makerbase-mks/MKS-Robin-E3-E3D/README.md

# MKS-Robin-E3-E3D
Include MKS Robin E3 and MKS Robin E3D two motherboards. Both motherboards are compatible with Ender3 machines and CR-10/CR10S machines
- MKS Robin E3 integrated 4 TMC2209 dirvers on board.
- MKS Robin E3D has pluggable drive interface, support A4988/TMC2208/TMC2209 and so on.
- Support [MKS MINI12864 V3](https://makerbase.aliexpress.com/store/group/LCD/1047297_516922172.html), MKS TFTxx, MKS LCD12864B, LCD12864, LCD2004
- Support [MKS PWC V3](https://www.aliexpress.com/item/32853300039.html), you can refer to Wiki

## Compare between E3/E3D V1.0 and V1.1
| ITEMS |  E3/E3D V1.0  | E3/E3D V1.1 |
|---|---|---|
| Z STEP signal | PB7 | PC14 |
| Z DIR signal | PB6 | PC15 |
| EEPROM | No support(save eeprom data by flash) | On board 4K |
| Board set | BOARD_MKS_ROBIN_E3, BOARD_MKS_ROBIN_E3D | BOARD_MKS_ROBIN_E3_V1_1, BOARD_MKS_ROBIN_E3D_V1_1 |

## Related tutorials and Notice
- Robin E3 E3D User Manual. You can refer to Wiki.[click here](https://github.com/makerbase-mks/MKS-Robin-E3-E3D/wiki)
- Robin E3D description. [click here](https://www.youtube.com/watch?v=_x1TzdqGZdo&feature=youtu.be&tdsourcetag=s_pctim_aiomsg)
- Thank you very much for ruiraptor's introduction about Robin E3/E3D board. [click here](https://www.youtube.com/watch?v=k9A8JYxBvqE)
- Welcome to follow us on Facebook to learn about the company's latest developments. [click here](https://www.facebook.com/Makerbase.mks/)

## Firmware 
- Support Marlin 2.0 
- Robin E3/E3D has supported klipper firmware. For details, please refer to:https://github.com/makerbase-mks/Klipper-for-MKS-Boards

## How to buy
- MKS Robin E3 on Aliexpress  [MKS Robin E3](https://www.aliexpress.com/item/1005002618890320.html)
- MKS Robin E3D on Aliexpress  [MKS Robin E3D](https://www.aliexpress.com/item/4000781744682.html)

## Note
- Thank you for using MKS products. If you have any questions during use, please contact us in time and we will work with you to solve it.
- For more product dynamic information and tutorial materials, you can always follow MKS's Facebook/Twitter/Discord/Reddit/Youtube and Github. Thank you!
- MKS Github: https://github.com/makerbase-mks  
- MKS Facebook: https://www.facebook.com/Makerbase.mks/  
- MKS Twitter: https://twitter.com/home?lang=en  
- MKS Discord: https://discord.gg/4uar57NEyU
- MKS Reddit: https://www.reddit.com/user/MAKERBASE-TEAM/ 

mks_link
