makerbase-mks/MKS-Robin-E3-E3D/hardware/README.md

# MKS Robin E3 and E3D hardware
- MKS Robin E3 V1.0_002 initial hardware
- MKS Robin E3D V1.0_002 initial hardware

20200414
- MKS Robin E3 V1.0_003 add 5.0-2P terminal for fan connection
- MKS Robin E3D V1.0_003 add 5.0-2P terminal for fan connection

20201120
- MKS Robin E3 V1.1_003 and MKS Robin E3D V1.1_003
  - Z-STEP signal change to PC14
  - Z-DIR signal change to PC15
  - Add support AT24C32D eeprom on the board
  - Optimize USB package design
  - Optimize PCB layout design
  
20210325
- MKS Robin E3 V1.1_004
  - Optimize TMC2209(QFN-28) packages
