makerbase-mks/MKS-Robin-E3-E3D/firmware/V1.1/Firmware bin for ender5/README.md

## Update firmware
- The "***.bin" need rename as Robin_e3.bin
- Copy Robin_e3.bin file to TF card folder
- Insert TF to MKS Robin E3 or MKS Robin E3D board
- Reset board or repower on
- The marlin version is 2.0.x
- Change parameters by LCD and store data
