makerbase-mks/MKS-Robin-E3-E3D/firmware/V1.0/firmware bin/firmware bin for Ender3(TMC2209+Neopixel+MKS PWC)/README.md

# Robin_e3.bin description
This bin file works with MKS motherboard and can be used directly on ender3 machine

## Update firmware
- Copy Robin_e3.bin file to TF card
- Insert TF to MKS Robin E3 or MKS Robin E3D board
- Reset board or repower on
- The marlin version is 2.0.1

## Parameter
- Robin_e3.bin firmware, the parameters are the same as the original ender3 machine

## Open Nexopixel lights
- Send M150 R* U* B* to board, for example: M150 R125 U125 B125

## Use MKS PWC
- PW_OFF connect to MKS Robin E3/E3D LCD_D7(PC5, EXP1 8pin)
- PW_DET connect to MKS Robin E3/E3D ME_DET(PB10)
