makerbase-mks/MKS-Robin-E3-E3D/hardware/Image/Robin E3/MKS_Robin_E3_V11_PWC.png

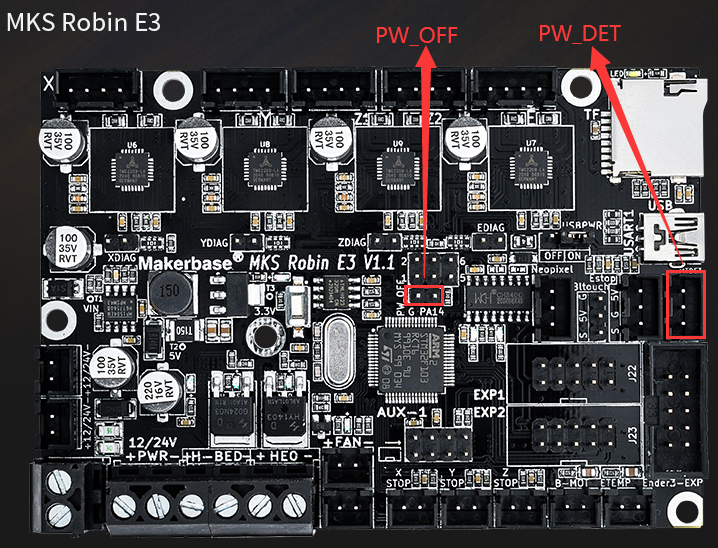
hardware/Image/Robin E3/MKS_Robin_E3_V11_PWC.png
