makerbase-mks/MKS-Robin-E3-E3D/hardware/Image/Robin E3D/MKS_Robin_E3D_FES.png

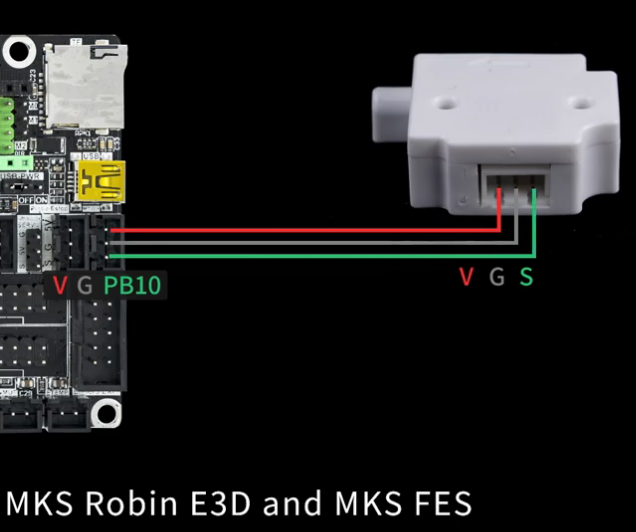
hardware/Image/Robin E3D/MKS_Robin_E3D_FES.png
