makerbase-mks/MKS-Robin-E3-E3D/hardware/Image/Robin E3D/MKS_Robin_E3D_V1_TOP.png

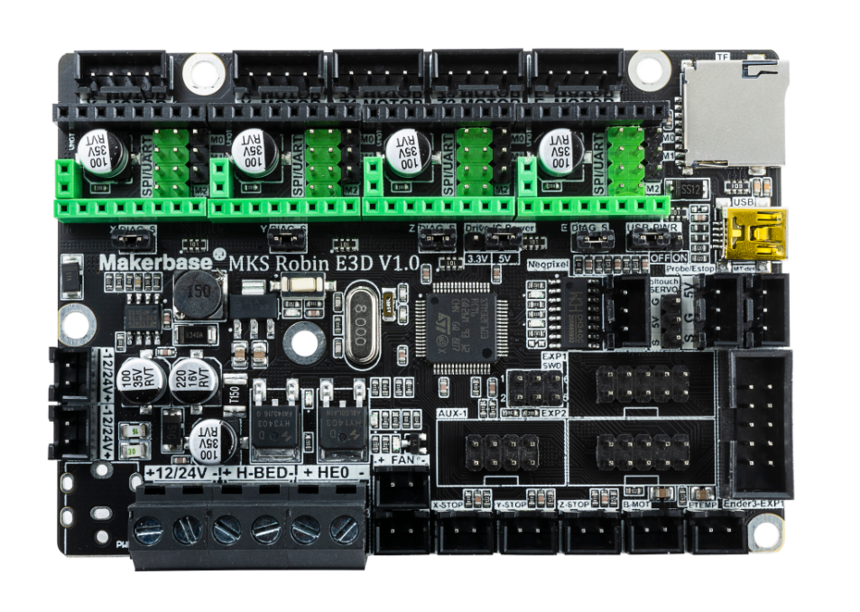
hardware/Image/Robin E3D/MKS_Robin_E3D_V1_TOP.png
