makerbase-mks/MKS-Robin-E3-E3D/hardware/MKS Robin E3 V1.1_004/MKS Robin E3 V1.1_004 BOM.pdf

Designator | Comment | Footprint | Quantity C1 | 100nF/50V±10% | C_0603_1608 | 1 C10 | 100uF/35V±20% | SMD-RVT-6.3X7mm | 1 C11 | 100nF/50V±10% | C_0603_1608 | 1 C12 | 100nF/50V±10% | C_0603_1608 | 1 C13 | 150pF/50V±10% | C_0603_1608 | 1 C14 | 100uF/35V±20% | SMD-RVT-6.3X7mm | 1 C15 | 100nF/50V±10% | C_0603_1608 | 1 C16 | 220uF/16V±20% | SMD-RVT-6.3X7mm | 1 C17 | 10uF/35V±20% | C_0805_2012 | 1 C18 | 10uF/35V±20% | C_0805_2012 | 1 C19 | 10uF/35V±20% | C_0805_2012 | 1 C2 | 100nF/50V±10% | C_0603_1608 | 1 C20 | 10uF/35V±20% | C_0805_2012 | 1 C21 | 100nF/50V±10% | C_0603_1608 | 1 C22 | 100nF/50V±10% | C_0603_1608 | 1 C23 | 100nF/50V±10% | C_0603_1608 | 1 C24 | 100nF/50V±10% | C_0603_1608 | 1 C25 | 100nF/50V±10% | C_0603_1608 | 1 C26 | 100nF/50V±10% | C_0603_1608 | 1 C27 | 100nF/50V±10%/NC | C_0603_1608 | 1 C28 | 100nF/50V±10% | C_0603_1608 | 1 C29 | 1nF/50V±10% | C_0603_1608 | 1 C3 | 22pF/50V±10% | C_0603_1608 | 1 C30 | 1nF/50V±10% | C_0603_1608 | 1 C31 | 100nF/50V±10% | C_0603_1608 | 1 C32 | 22nF/50V±10% | C_0603_1608 | 1 C33 | 100uF/35V±20% | SMD-RVT-6.3X7mm | 1 C34 | 100nF/50V±10% | C_0603_1608 | 1 C35 | 22nF/50V±10% | C_0603_1608 | 1 C36 | 100nF/50V±10% | C_0603_1608 | 1 C37 | 100nF/50V±10% | C_0603_1608 | 1 C38 | 100nF/50V±10% | C_0603_1608 | 1 C39 | 100nF/50V±10% | C_0603_1608 | 1 C4 | 22pF/50V±10% | C_0603_1608 | 1 C40 | 100nF/50V±10% | C_0603_1608 | 1 C41 | 100nF/50V±10% | C_0603_1608 | 1 C42 | 100nF/50V±10% | C_0603_1608 | 1 C43 | 100uF/35V±20% | SMD-RVT-6.3X7mm | 1 C44 | 22nF/50V±10% | C_0603_1608 | 1 C45 | 100nF/50V±10% | C_0603_1608 | 1 C46 | 100nF/50V±10% | C_0603_1608 | 1 C47 | 100nF/50V±10% | C_0603_1608 | 1 C48 | 100nF/50V±10% | C_0603_1608 | 1 C49 | 100uF/35V±20% | SMD-RVT-6.3X7mm | 1 C5 | 100nF/50V±10% | C_0603_1608 | 1 C50 | 22nF/50V±10% | C_0603_1608 | 1 C51 | 100nF/50V±10% | C_0603_1608 | 1 C52 | 100nF/50V±10% | C_0603_1608 | 1 C53 | 100nF/50V±10% | C_0603_1608 | 1 C54 | 100nF/50V±10% | C_0603_1608 | 1

C55 | 100uF/35V±20% | SMD-RVT-6.3X7mm | 1 C6 | 100nF/50V±10% | C_0603_1608 | 1 C7 | 100nF/50V±10% | C_0603_1608 | 1 C8 | 100nF/50V±10% | C_0603_1608 | 1 C9 | 100nF/50V±10% | C_0603_1608 | 1 D1 | LED_Red | LED_0603_1608 | 1 D10 | LED_Red | LED_0603_1608 | 1 D11 | LED_BLUE | LED_0603_1608 | 1 D12 | LED_BLUE | LED_0603_1608 | 1 D2 | B340A-13-F | D-SMA | 1 D3 | S1A | D-SMA | 1 D4 | S1G | D-SMA | 1 D5 | SS14 | SOD-123 | 1 D6 | LED_BLUE | LED_0603_1608 | 1 D7 | LED_W | LED_0603_1608 | 1 D8 | LED_Red | LED_0603_1608 | 1 D9 | LED_Red | LED_0603_1608 | 1 F1 | 30A | F_1206_3216 | 1 F2 | 15A | F_1206_3216 | 1 F3 | F1812/1.5A | F_1812 | 1 F4 | 0.5A | F_0805_2012 | 1 FID1 | Fiducial | FIDUCIAL-1X1mm | 1 FID2 | Fiducial | FIDUCIAL-1X1mm | 1 FID3 | Fiducial | FIDUCIAL-1X1mm | 1 L1 | 15uH/3A | L-7x7x4mm | 1 M2 | LOGO-MAKERBASE-R | Makerbase-R | 1 Q1 | SS8050 | SOT-23 | 1 R1 | 10K/±1% | R_0603_1608 | 1 R10 | 100K/±1% | R_0603_1608 | 1 R11 | 100K/±1% | R_0603_1608 | 1 R12 | 24.9K/±1% | R_0603_1608 | 1 R13 | 100K/±1% | R_0603_1608 | 1 R14 | 100K/±1% | R_0603_1608 | 1 R15 | 40.2K/±1% | R_0603_1608 | 1 R16 | 210K/±1% | R_0603_1608 | 1 R17 | 1K/±1% | R_0603_1608 | 1 R18 | 4.7K/±1% | R_0603_1608 | 1 R19 | 100Ω/±1% | R_0603_1608 | 1 R2 | 10K/±1% | R_0603_1608 | 1 R20 | 4.7K/±1% | R_0603_1608 | 1 R21 | 100Ω/±1% | R_0603_1608 | 1 R22 | 1K/±1% | R_0603_1608 | 1 R23 | 4.7K/±1% | R_0603_1608 | 1 R24 | 1K/±1% | R_0603_1608 | 1 R25 | 4.7K/±1% | R_0603_1608 | 1 R26 | 1K/±1% | R_0603_1608 | 1 R27 | 4.7K/±1% | R_0603_1608 | 1 R28 | 1K/±1% | R_0603_1608 | 1 R29 | 4.7K/±1% | R_0603_1608 | 1 R3 | 4.7K/±1% | R_0603_1608 | 1 R30 | 1K/±1% | R_0603_1608 | 1

R31 | 10K/±1% | R_0603_1608 | 1 R32 | 10K/±1% | R_0603_1608 | 1 R33 | 10K/±1% | R_0603_1608 | 1 R34 | 10K/±1% | R_0603_1608 | 1 R35 | 100Ω/±1% | R_0603_1608 | 1 R36 | 100K/±1% | R_0603_1608 | 1 R37 | 100Ω/±1% | R_0603_1608 | 1 R38 | 100K/±1% | R_0603_1608 | 1 R39 | 100Ω/±1% | R_0603_1608 | 1 R4 | 4.7K/±1% | R_0603_1608 | 1 R40 | 100K/±1% | R_0603_1608 | 1 R41 | 4.7K/±1% | R_0603_1608 | 1 R42 | 4.7K/±1% | R_0603_1608 | 1 R43 | 4.7K/±1% | R_0603_1608 | 1 R44 | 1.8K/±1% | R_0603_1608 | 1 R45 | 1.8K/±1% | R_0603_1608 | 1 R46 | 1K/±1% | R_0603_1608 | 1 R47 | 1K/±1% | R_0603_1608 | 1 R48 | 22Ω/±1% | R_0603_1608 | 1 R49 | 22Ω/±1% | R_0603_1608 | 1 R5 | 10K/±1% | R_0603_1608 | 1 R50 | 100Ω/±1% | R_0603_1608 | 1 R51 | 100Ω/±1% | R_0603_1608 | 1 R52 | 1K/±1% | R_0603_1608 | 1 R53 | 4.7K/±1% | R_0603_1608 | 1 R54 | 100Ω/1% | R_0603_X4 | 1 R55 | 20K/±1% | R_0603_1608 | 1 R56 | 20K/±1% | R_0603_1608 | 1 R57 | 0.11/±1% | R_0805_2012 | 1 R58 | 100Ω/1% | R_0603_X4 | 1 R59 | 0.11/±1% | R_0805_2012 | 1 R60 | 20K/±1% | R_0603_1608 | 1 R61 | 20K/±1% | R_0603_1608 | 1 R62 | 0.11/±1% | R_0805_2012 | 1 R63 | 0.11/±1% | R_0805_2012 | 1 R64 | 20K/±1% | R_0603_1608 | 1 R65 | 20K/±1% | R_0603_1608 | 1 R66 | 4.7K/±1% | R_0603_1608 | 1 R67 | 100Ω/1% | R_0603_X4 | 1 R68 | 20K/±1% | R_0603_1608 | 1 R69 | 0.11/±1% | R_0805_2012 | 1 R70 | 20K/±1% | R_0603_1608 | 1 R71 | 0.11/±1% | R_0805_2012 | 1 R72 | 20K/±1% | R_0603_1608 | 1 R73 | 100Ω/1% | R_0603_X4 | 1 R74 | 20K/±1% | R_0603_1608 | 1 R75 | 0.11/±1% | R_0805_2012 | 1 R76 | 20K/±1% | R_0603_1608 | 1 R77 | 0.11/±1% | R_0805_2012 | 1 R78 | 20K/±1% | R_0603_1608 | 1 R9 | 1M/±1% | R_0603_1608 | 1

S1 | SW-260G-2P | SW-260G-SMD-3X6X5mm1
U1 | AT24C32D-SSHM | SOIC8 | 1
U2 | STM32F103RCTx | LQFP-64_10x10mm_P0.1
U4 | NCP1117ST33T3G | SOT-223 | 1
U5 | CH340C | SOP-16-150mil | 1
Z1 | CG0603MLC-05E | R_0603_1608 | 1
Z2 | CG0603MLC-05E | R_0603_1608 | 1
Z3 | CG0603MLC-05E | R_0603_1608 | 1
M1 | LOGO-MAKERBASE | Makerbase-TOP | 1
Through Hole Items
J1 | Header-2.54-2X3P | HDR-2.54-2X3P | 1
J10 | XH2.54-2P | XH2.54-2P | 1
J11 | XH2.54-2P | XH2.54-2P | 1
J12 | XH2.54-3P | XH2.54-3P | 1
J13 | XH2.54-3P | XH2.54-3P | 1
J14 | Header-2.54-1X2P | HDR-2.54-1X2P | 1
J15 | Header-2.54-1X2P | HDR-2.54-1X2P | 1
J16 | Header-2.54-1X2P | HDR-2.54-1X2P | 1
J17 | Header-2.54-1X2P | HDR-2.54-1X2P | 1
J18 | XH2.54-2P | XH2.54-2P | 1
J19 | XH2.54-2P | XH2.54-2P | 1
J2 | HG129-5.0-2P | HG129-5.0-2P | 1
J20 | Header-2.54-1X3P | HDR-2.54-1X3P | 1
J21 | USB_MINI | USB_MINI_DIP5P | 1
J22 | IDC-2.54-2X5P | IDC-2.54-2X5P | 1
J23 | IDC-2.54-2X5P | IDC-2.54-2X5P | 1
J24 | Header-2.54-1X3P | HDR-2.54-1X3P | 1
J25 | IDC-2.54-2X4PA | HDR-2.54-2X4P | 1
J26 | IDC-2.54-2X5P | IDC-2.54-2X5P | 1
J27 | XH2.54-3P | XH2.54-3P | 1
J28 | XH2.54-4P | XH2.54-4P | 1
J29 | XH2.54-4P | XH2.54-4P | 1
J3 | HG129-5.0-6P | HG129-5.0-6P | 1
J30 | XH2.54-4P | XH2.54-4P | 1
J38 | XH2.54-4P | XH2.54-4P | 1
J4 | XH2.54-4P | XH2.54-4P | 1
J40 | Header-2.54-1X2P | HDR-2.54-1X2P | 1
J5 | XH2.54-2P | XH2.54-2P | 1
J6 | XH2.54-2P | XH2.54-2P | 1
J7 | XH2.54-2P | XH2.54-2P | 1
J8 | XH2.54-2P | XH2.54-2P | 1
J9 | XH2.54-2P | XH2.54-2P | 1
M3 | M-HOLES | M-HOLES | 1
M4 | M-HOLES | M-HOLES | 1
M5 | M-HOLES | M-HOLES | 1
M6 | M-HOLES | M-HOLES | 1
M7 | M-HOLES | M-HOLES | 1
Q2 | HY1403 | TO-252 | 1
Q3 | HY3403D | TO-252 | 1
SD1 | MicroSD | MICROSD | 1
T1 | Test-point | TEST-POINT | 1

T2 | Test-point | TEST-POINT | 1 T3 | Test-point | TEST-POINT | 1 U3 | MP1584EN | SOIC8E | 1 U6 | TMC2209-LA | QFN28 | 1 U7 | TMC2209-LA | QFN28 | 1 U8 | TMC2209-LA | QFN28 | 1 U9 | TMC2209-LA | QFN28 | 1 Y1 | XTAL-2P-8M | XTAL-49S-DIP-2 | 1
