makerbase-mks/MKS-Robin-E3-E3D/hardware/Image/FAQ/CONNECT.png

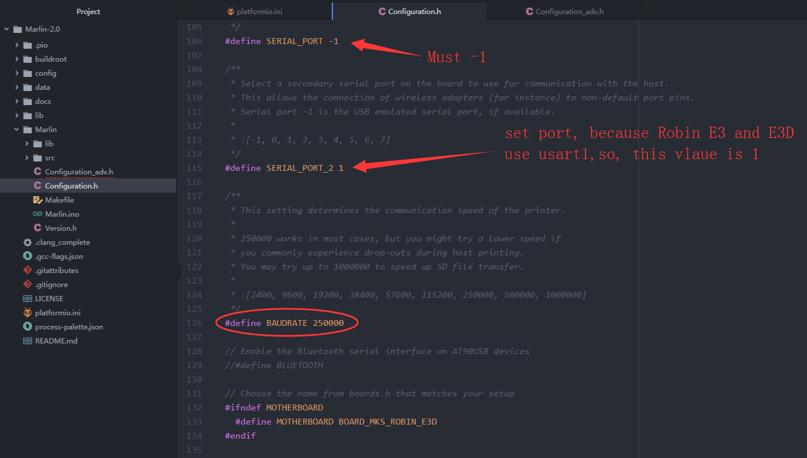
hardware/Image/FAQ/CONNECT.png
