makerbase-mks/MKS-Robin-E3-E3D/hardware/Image/FAQ/CONNECT_OK.png

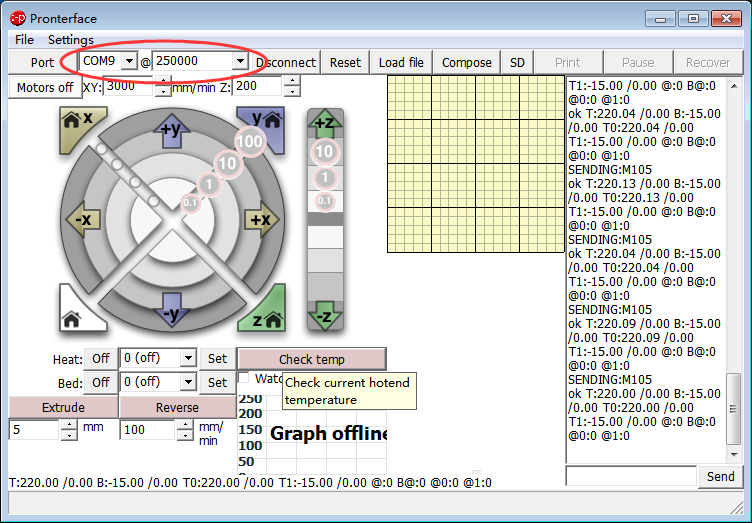
hardware/Image/FAQ/CONNECT_OK.png
