makerbase-mks/MKS-Robin-E3-E3D/hardware/Image/FAQ/MKS_Robin_E3_E3D_NEOPIXEL_ADD.png

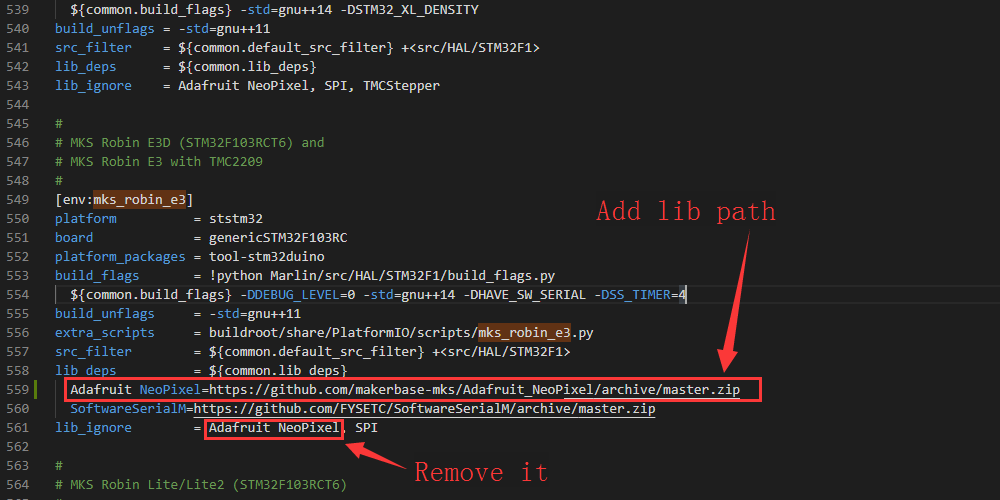
hardware/Image/FAQ/MKS_Robin_E3_E3D_NEOPIXEL_ADD.png
