makerbase-mks/MKS-Robin-E3-E3D/hardware/Image/FAQ/MKS_Robin_E3_E3D_NEOPIXEL_COM_DISABLE.png

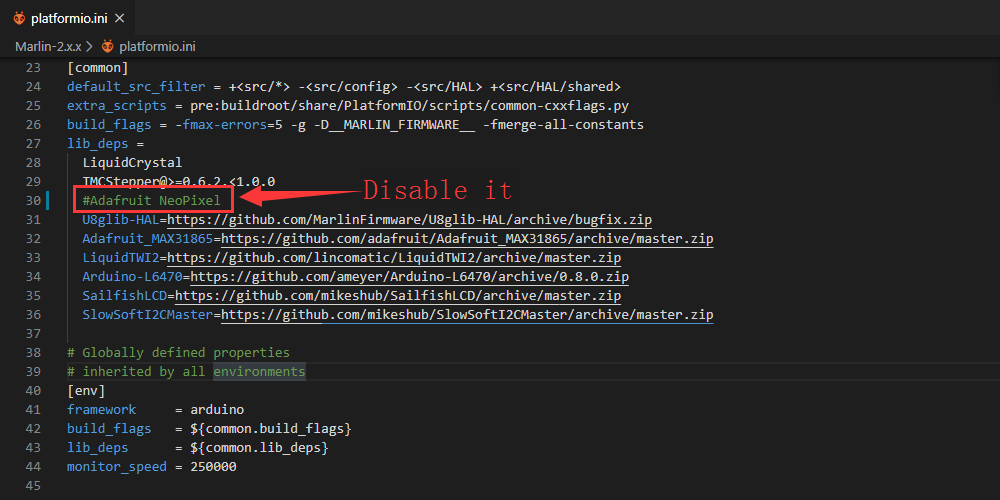
hardware/Image/FAQ/MKS_Robin_E3_E3D_NEOPIXEL_COM_DISABLE.png
