makerbase-mks/MKS-Robin-E3-E3D/hardware/Image/FAQ/SENSORLESS_HOMING.png

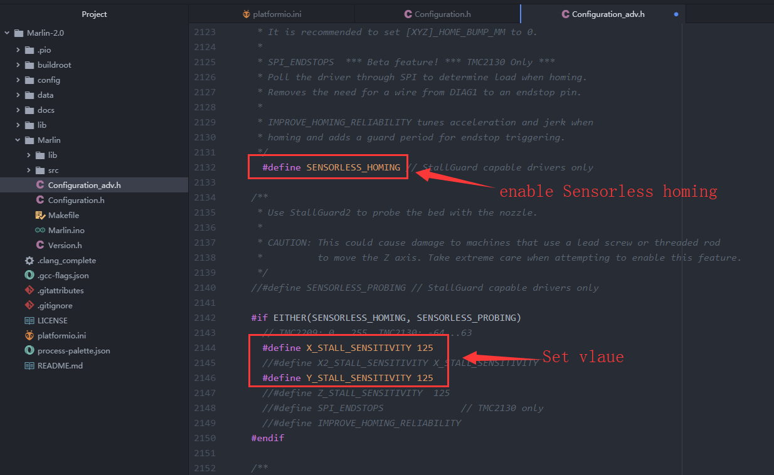
hardware/Image/FAQ/SENSORLESS_HOMING.png
