makerbase-mks/MKS-Robin-E3-E3D/hardware/Image/FAQ/TMC2209_TYPE.png

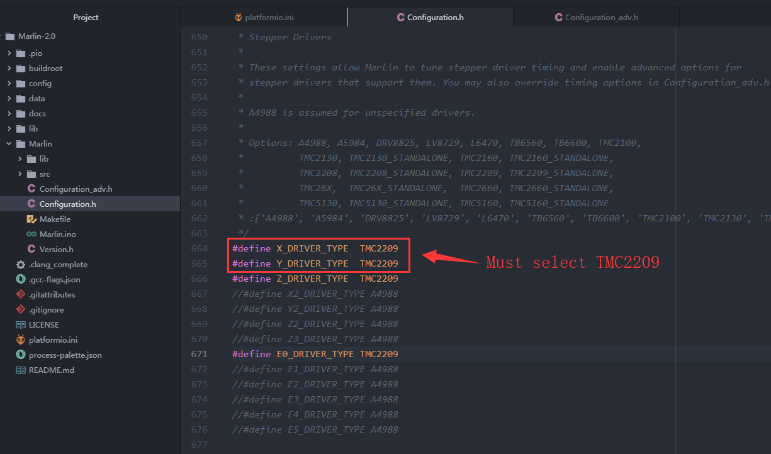
hardware/Image/FAQ/TMC2209_TYPE.png
