makerbase-mks/MKS-Robin-E3-E3D/(threads)

Thread 1 (2020-04-09):

part cooling fan is always open

SFRSKZ, 2020-04-09:
im using pa8 pin for part cooling fan but fan is always working. not responding to adjustments or gcodes.

makerbase-mks, 2020-04-10:
Hi!
I want to confirm the following points:
First, your firmware is what version?
Secondly, when the motherboard is powered on, will the FAN controlled by PA8 flash or keep on?

SFRSKZ, 2020-04-10:
marlin 2.0.1. i used your files, and changed some settings but there was nothing about fan.

SFRSKZ, 2020-04-10:
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

red light is always on, not blinking.

makerbase-mks, 2020-04-10:
Have you received the motherboard, is this the case with power on? If it is always on, it means that the transistor controlling the FAN has been broken down, which will cause the power to be on all the time without blinking.

jvictor23br, 2020-08-19:
Mine has the same issue, the red light is allways on, but the cooler is always off. Just received like that. What can be done?

danbrianwhite, 2020-11-11:
I have one of these too where part cooling fan is always on. The hotend fan is connected to the "fan" input.

Is this a software bug?

Closed 2020-05-13.

Thread 2 (2020-04-20):

I can't update .bin file

JordiKoki, 2020-04-20:
I am trying to update my new MKS Robin E3D board, but when I add the file Robin_e3.bin in my SD, the screen does not execute the update.

makerbase-mks, 2020-04-20:
Hi!
1. What screen are you using?
2. Robin E3 / E3D already have firmware. If you have not modified the firmware, you can use it directly on the Ender3 machine without upgrading
3. Robin E3 / E3D supports LCD12864 to display the firmware update progress

JordiKoki, 2020-04-20:
I use a TFT35 V1.0 (with Firmware 1.0.5) in my CR10s, but doesn't works anything (hotend, bed, moves, fans...)

makerbase-mks, 2020-04-24:
Hi! You can refer to it and link is : https://github.com/makerbase-mks/MKS-Robin-E3-E3D/wiki/Upgrade-with-MKS-TFT-Series

spooky79, 2021-04-21:
I have the same problem, it comes to 100% and nothing is happening, I'm using visual studio code, any solution?

aspaixao, 2021-07-16:
I have the same with my e3d and I using a CoreXY and configuration to ender 6

sergiofagundes, 2021-09-16:
FIXED 100% working:

 the board if using a 4GB sdcard,
I tried with 8GB/16GB/32GB and none of them worked.
So I tried a 4GB sdcard and it worked.

I used the Sdcard on the LCD sdcard slot, but I think it should work also in the mks robin board sdcard slot also with only 4GB sdcard.

Closed 2020-05-13.

Thread 3 (2020-04-23):

question: in where save eeprom settings

sl1pkn07, 2020-04-23:
Hi

in this board, in where is stored the eeprom settings?

greetings

makerbase-mks, 2020-04-24:
Hi! The processing of this part of EEPROM, marlin may write to STM32 flash using an analog method.

sl1pkn07, 2020-04-24:
i see in other SMT32F103(RCT6/RET6) based boards this

~~~~
#define FLASH_EEPROM_EMULATION
#define EEPROM_PAGE_SIZE     (0x800U) // 2KB
#define EEPROM_START_ADDRESS (0x8000000UL + (STM32_FLASH_SIZE) * 1024UL - (EEPROM_PAGE_SIZE) * 2UL)
#undef E2END
#define E2END                (EEPROM_PAGE_SIZE - 1) // 2KB
~~~

but not in the Robin E3/E3D

this is missing for the Robin E3/E3D boards?

(i have the E3D in route)

greetings

sl1pkn07, 2020-05-15:
Hi again. one question, with "analog method" you mean the board have a dedicated eeprom chip?

greetings

DocYester, 2020-05-17:
saving settings to flash with the e3d would be nice - actually i store them on sdcard by emulation
but that will definitly fail at some time - so allways backup the settings

what is needed to set it up to use the flash ?

sl1pkn07, 2020-05-17:
in other STM32F1 boards, the snipplet i posted above

DocYester, 2020-05-17:
after rebooting 2 times and saving defaults - works 👍

sl1pkn07, 2020-05-17:
oh! I forgot to add to add this in the LD script

~~~
rom (rx)  : ORIGIN = 0x08007000, LENGTH = 256K - 28K - 4K
~~~

https://github.com/MarlinFirmware/Marlin/blob/bugfix-2.0.x/buildroot/share/PlatformIO/ldscripts/mks_robin_e3.ld

because the eeprom is stored in the last 4K in the flash

DocYester, 2020-05-19:
LD Script fot the E3D should be :
`rom (rx)  : ORIGIN = 0x08005000, LENGTH = 256K - 20K - 4K`

Works like a charm now

sl1pkn07, 2020-06-08:
implementes in upstream

https://github.com/MarlinFirmware/Marlin/commit/19024306fc834fbead89e749d64d352194befa84

closing

Closed 2020-06-08.

Thread 4 (2020-05-01):

Can not Open build_flags.py

Frederic-SABU, 2020-05-01:
I can not compile a Marlin-2 for a ROBIN E3D.
I am using VS studio and Platformio.
My config is working fine for my other MKS boards : SGEN_L and MKS_BASE.
Error message is :
D:\Python38\python.exe: can't open file 'Marlin/src/HAL/HAL_STM32F1/build_flags.py': [Errno 2] No such file or directory
Thks for any help.

makerbase-mks, 2020-05-04:
What you set in the platformio.ini file is: mks_robin_e3d?

Frederic-SABU, 2020-05-04:
Yes, it is but the problem was coming from one of he marlin file. I
reused a Marlin 2 from my SGEN_L cards and it is not compatible.

Thk a lot for following up.

Rgds,
Frd

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

Frederic-SABU, 2020-05-04:
No sorry it is :

mks_robin_e3

as there is no e3d environment.

Rgds,
Frd

Le 04/05/2020 08:19, MSABU a écrit :
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

Closed 2020-05-27.

Thread 5 (2020-05-02):

Unknown environment names 'mks_robin_e3d'

ljunqian, 2020-05-02:
Which other environment names can i use?

ljunqian, 2020-05-02:
I figured it out. I just had to use your version of marlin instead of the original, How can i update my board firmware? Putting the bin file in my sd card and rebooting does not work. Uploading from vscode using platformio does not work. I am using robin e3d. Am i still supposed to use mks_robin_3d as the default_envs for this board? Please advise.

ljunqian, 2020-05-03:
I figured it out. I loaded firmware.bin and Robin_e3.bin on sd from PIO and rebooted. There is different pins for Z_MIN_PROBE in marlin for 3d touch. Mine was  Pin PB1 while the pin listed in readme was PA2.

Closed 2020-05-03.

Thread 6 (2020-05-04):

Question : Can the board be configured for 12V fans ?

imakiro, 2020-05-04:
Hello,
I would like to reduce the noise of the hotend fan, can the Robin-E3D V1.0 board be configured to use a 12V fan without a buck converter / step down voltage regulator ?
If so, how and which parameters to change in Marlin source code?

makerbase-mks, 2020-05-13:
Hi! The safest way is that you can directly use a 12VDC module.

Closed 2020-05-25.

Thread 7 (2020-05-05):

Question: Is the board supposed to turn off when no filament is detected?

ljunqian, 2020-05-05:
I have the E3D. It turns off when no filament is detected, I would like it to to pause the print.

ljunqian, 2020-05-07:
I shorted the pin.

Closed 2020-05-07.

Thread 8 (2020-05-19):

Question : UART Connection

DocYester, 2020-05-19:
I have serious connection issues when i connect the e3d board via usb to a raspberry 3b+ with octoprint
tried diffrent cables - no change
i havent had theese issues before with the same pi/cable and the ender3 1.1.5 board
so i want to connect the e3d by uart to the pi
which pins do i need to connect ?
can i use the aux1 rx/tx/gnd ?
do i need a converter from 5v to 3.3v ?

makerbase-mks, 2020-05-20:
Hi! You don't need to connect power, but they need to be powered separately.

DocYester, 2020-05-20:
did it ... but cant connect at all
how to setup the firmware to enable the uart port for host communication ?
tried it with
```
#define SERIAL_PORT -1
#define SERIAL_PORT_2 1
```
and
```
#define SERIAL_PORT -1
#define SERIAL_PORT_2 0
```
both failed - tried to set the baudrate from  115200 to 250000 and 500000 - failed as well

makerbase-mks, 2020-05-21:
AUX-1 rx tx use STM32 USART1, so #define SERIAL_PORT_2 0;
USB is same as AUX-1, you can test connect to Host computer.

DocYester, 2020-05-22:
Not really ...

```
In file included from Marlin\src\HAL\STM32F1\../../inc/../HAL/HAL.h:26:0,
                 from Marlin\src\HAL\STM32F1\../../inc/MarlinConfig.h:30,
                 from Marlin\src\HAL\STM32F1\HAL.cpp:30:
Marlin\src\HAL\STM32F1\../../inc/../HAL/./STM32F1/HAL.h:101:6: error: #error "SERIAL_PORT_2 cannot be 0. (Port 0 does not exist.) Please update your configuration."

     #error "SERIAL_PORT_2 cannot be 0. (Port 0 does not exist.) Please update your configuration."
      ^~~~~
In file included from Marlin\src\HAL\STM32F1\../../inc/../HAL/HAL.h:26:0,
                 from Marlin\src\HAL\STM32F1\../../inc/MarlinConfig.h:30,
                 from Marlin\src\HAL\STM32F1\HAL_SPI.cpp:35:
Marlin\src\HAL\STM32F1\../../inc/../HAL/./STM32F1/HAL.h:101:6: error: #error "SERIAL_PORT_2 cannot be 0. (Port 0 does not exist.) Please update your configuration."
     #error "SERIAL_PORT_2 cannot be 0. (Port 0 does not exist.) Please update your configuration."
      ^~~~~
In file included from Marlin\src\HAL\STM32F1\../../inc/../HAL/HAL.h:26:0,
                 from Marlin\src\HAL\STM32F1\../../inc/MarlinConfig.h:30,
                 from Marlin\src\HAL\STM32F1\Servo.cpp:25:
Marlin\src\HAL\STM32F1\../../inc/../HAL/./STM32F1/HAL.h:101:6: error: #error "SERIAL_PORT_2 cannot be 0. (Port 0 does not exist.) Please update your configuration."
     #error "SERIAL_PORT_2 cannot be 0. (Port 0 does not exist.) Please update your configuration."
      ^~~~~
In file included from Marlin\src\HAL\STM32F1\dogm\../../../inc/../HAL/HAL.h:26:0,
                 from Marlin\src\HAL\STM32F1\dogm\../../../inc/MarlinConfig.h:30,
                 from Marlin\src\HAL\STM32F1\dogm\u8g_com_stm32duino_fsmc.cpp:29:
Marlin\src\HAL\STM32F1\dogm\../../../inc/../HAL/./STM32F1/HAL.h:101:6: error: #error "SERIAL_PORT_2 cannot be 0. (Port 0 does not exist.) Please update your configuration."
     #error "SERIAL_PORT_2 cannot be 0. (Port 0 does not exist.) Please update your configuration."
      ^~~~~
*** [.pio\build\mks_robin_e3\src\src\HAL\STM32F1\HAL.cpp.o] Error 1
*** [.pio\build\mks_robin_e3\src\src\HAL\STM32F1\Servo.cpp.o] Error 1
*** [.pio\build\mks_robin_e3\src\src\HAL\STM32F1\HAL_SPI.cpp.o] Error 1
*** [.pio\build\mks_robin_e3\src\src\HAL\STM32F1\dogm\u8g_com_stm32duino_fsmc.cpp.o] Error 1
========================= [FAILED] Took 5.80 seconds =========================
```

Trying to compile with Marlin bugfix branch 2.0.5.3

makerbase-mks, 2020-05-25:
Hi! Sorry, I corrected my mistake. Should #define SERIAL_PORT_2 1

DocYester, 2020-05-26:
After some testing and printing the only solution was to lower the baud rate to 115200 for a stable communication - uart or usb

Closed 2020-05-26.

Thread 9 (2020-05-20):

what problem ?

dct1122, 2020-05-20:
my use ronbin e3 broad
why my extruder motor is noise ( mosquito sound ) ?
i was change other motor , it not fix

makerbase-mks, 2020-05-20:
What driver do you use?

dct1122, 2020-05-20:
tmc 2209

makerbase-mks, 2020-05-21:
You can try to adjust the current to achieve the best condition of the motor.

DocYester, 2020-05-24:
my fans are louder than the stepper motors @40mm/s real print speed (slic3r , not cura !)
stepper motors are the original from the ender3 that it was before

```
Stepper driver current:
M906 X600 Y600 Z700 E800

```
```
Driver stepping mode:
M569 S1 X Y Z E

```
```
Maximum feedrates (units/s):
M203 X300.00 Y300.00 Z5.00 E25.00
Maximum Acceleration (units/s2):
M201 X1800.00 Y1800.00 Z100.00 E5000.00
Acceleration (units/s2): P<print_accel> R<retract_accel> T<travel_accel>
M204 P1800.00 R3000.00 T2400.00

```

mks-viva, 2020-10-14:
Has this problem been solved?

mks-viva, 2020-11-17:
I will close this issues temporarily.

Closed 2020-11-17.

Thread 11 (2020-05-26):

Compile error

vgege86, 2020-05-26:
I am trying to compile the newly downloaded version and it gives me the following error:

Compiling .pio\build\mks_robin_e3\libc6f\USBComposite\Keyboard.cpp.o
.pio\libdeps\mks_robin_e3\Adafruit BusIO_ID6214\Adafruit_I2CDevice.cpp: In member function 'bool Adafruit_I2CDevice::read(uint8_t*, size_t, bool)':
.pio\libdeps\mks_robin_e3\Adafruit BusIO_ID6214\Adafruit_I2CDevice.cpp:160:79: error: no matching function for call to 'TwoWire::requestFrom(uint8_t, uint8_t, uint8_t)'
   size_t recv = _wire->requestFrom((uint8_t)_addr, (uint8_t)len, (uint8_t)stop);
                                                                               ^
In file included from C:\Users\vgege\.platformio\packages\framework-arduinoststm32-maple\STM32F1\libraries\Wire/Wire.h:42:0,
                 from .pio\libdeps\mks_robin_e3\Adafruit BusIO_ID6214/Adafruit_I2CDevice.h:1,
                 from .pio\libdeps\mks_robin_e3\Adafruit BusIO_ID6214\Adafruit_I2CDevice.cpp:1:
C:\Users\vgege\.platformio\packages\framework-arduinoststm32-maple\STM32F1\libraries\Wire/utility/WireBase.h:101:11: note: candidate: uint8 WireBase::requestFrom(uint8, int)
     uint8 requestFrom(uint8, int);
           ^~~~~~~~~~~
C:\Users\vgege\.platformio\packages\framework-arduinoststm32-maple\STM32F1\libraries\Wire/utility/WireBase.h:101:11: note:   candidate expects 2 arguments, 3 provided
C:\Users\vgege\.platformio\packages\framework-arduinoststm32-maple\STM32F1\libraries\Wire/utility/WireBase.h:106:11: note: candidate: uint8 WireBase::requestFrom(int, int)
     uint8 requestFrom(int, int);
           ^~~~~~~~~~~
C:\Users\vgege\.platformio\packages\framework-arduinoststm32-maple\STM32F1\libraries\Wire/utility/WireBase.h:106:11: note:   candidate expects 2 arguments, 3 provided
In file included from .pio\libdeps\mks_robin_e3\Adafruit BusIO_ID6214/Adafruit_BusIO_Register.h:2:0,
                 from .pio\libdeps\mks_robin_e3\Adafruit BusIO_ID6214\Adafruit_BusIO_Register.cpp:1:
.pio\libdeps\mks_robin_e3\Adafruit BusIO_ID6214/Adafruit_SPIDevice.h:37:43: error: 'SPI_BITORDER_MSBFIRST' was not declared in this scope
                      BitOrder dataOrder = SPI_BITORDER_MSBFIRST,
                                           ^~~~~~~~~~~~~~~~~~~~~
.pio\libdeps\mks_robin_e3\Adafruit BusIO_ID6214/Adafruit_SPIDevice.h:37:43: note: suggested alternative: 'SPI_CR1_LSBFIRST'
                      BitOrder dataOrder = SPI_BITORDER_MSBFIRST,
                                           ^~~~~~~~~~~~~~~~~~~~~
                                           SPI_CR1_LSBFIRST
.pio\libdeps\mks_robin_e3\Adafruit BusIO_ID6214/Adafruit_SPIDevice.h:42:43: error: 'SPI_BITORDER_MSBFIRST' was not declared in this scope
                      BitOrder dataOrder = SPI_BITORDER_MSBFIRST,
                                           ^~~~~~~~~~~~~~~~~~~~~
In file included from .pio\libdeps\mks_robin_e3\Adafruit BusIO_ID6214\Adafruit_SPIDevice.cpp:1:0:
.pio\libdeps\mks_robin_e3\Adafruit BusIO_ID6214/Adafruit_SPIDevice.h:37:43: error: 'SPI_BITORDER_MSBFIRST' was not declared in this scope
                      BitOrder dataOrder = SPI_BITORDER_MSBFIRST,
                                           ^~~~~~~~~~~~~~~~~~~~~
.pio\libdeps\mks_robin_e3\Adafruit BusIO_ID6214/Adafruit_SPIDevice.h:42:43: note: suggested alternative: 'SPI_CR1_LSBFIRST'
                      BitOrder dataOrder = SPI_BITORDER_MSBFIRST,
                                           ^~~~~~~~~~~~~~~~~~~~~
                                           SPI_CR1_LSBFIRST
.pio\libdeps\mks_robin_e3\Adafruit BusIO_ID6214/Adafruit_SPIDevice.h:37:43: note: suggested alternative: 'SPI_CR1_LSBFIRST'
                      BitOrder dataOrder = SPI_BITORDER_MSBFIRST,
                                           ^~~~~~~~~~~~~~~~~~~~~
                                           SPI_CR1_LSBFIRST
.pio\libdeps\mks_robin_e3\Adafruit BusIO_ID6214/Adafruit_SPIDevice.h:42:43: error: 'SPI_BITORDER_MSBFIRST' was not declared in this scope
                      BitOrder dataOrder = SPI_BITORDER_MSBFIRST,
                                           ^~~~~~~~~~~~~~~~~~~~~
*** [.pio\build\mks_robin_e3\libb69\Adafruit BusIO_ID6214\Adafruit_I2CDevice.cpp.o] Error 1
.pio\libdeps\mks_robin_e3\Adafruit BusIO_ID6214/Adafruit_SPIDevice.h:42:43: note: suggested alternative: 'SPI_CR1_LSBFIRST'
                      BitOrder dataOrder = SPI_BITORDER_MSBFIRST,
                                           ^~~~~~~~~~~~~~~~~~~~~
                                           SPI_CR1_LSBFIRST
.pio\libdeps\mks_robin_e3\Adafruit BusIO_ID6214\Adafruit_SPIDevice.cpp: In member function 'void Adafruit_SPIDevice::transfer(uint8_t*, size_t)':
.pio\libdeps\mks_robin_e3\Adafruit BusIO_ID6214\Adafruit_SPIDevice.cpp:99:31: error: no matching function for call to 'SPIClass::transfer(uint8_t*&, size_t&)'
     _spi->transfer(buffer, len);
                               ^
In file included from .pio\libdeps\mks_robin_e3\Adafruit BusIO_ID6214/Adafruit_SPIDevice.h:1:0,
                 from .pio\libdeps\mks_robin_e3\Adafruit BusIO_ID6214\Adafruit_SPIDevice.cpp:1:
Marlin\src\HAL\HAL_STM32F1/SPI.h:268:11: note: candidate: uint8_t SPIClass::transfer(uint8_t) const
   uint8_t transfer(uint8_t data) const;
           ^~~~~~~~
Marlin\src\HAL\HAL_STM32F1/SPI.h:268:11: note:   candidate expects 1 argument, 2 provided
.pio\libdeps\mks_robin_e3\Adafruit BusIO_ID6214\Adafruit_SPIDevice.cpp:115:23: error: 'SPI_BITORDER_LSBFIRST' was not declared in this scope
     if (_dataOrder == SPI_BITORDER_LSBFIRST) {
                       ^~~~~~~~~~~~~~~~~~~~~
In file included from .pio\libdeps\mks_robin_e3\Adafruit_MAX31865\Adafruit_MAX31865.h:55:0,
                 from .pio\libdeps\mks_robin_e3\Adafruit_MAX31865\Adafruit_MAX31865.cpp:17:
.pio\libdeps\mks_robin_e3\Adafruit BusIO_ID6214/Adafruit_SPIDevice.h:37:43: error: 'SPI_BITORDER_MSBFIRST' was not declared in this scope
                      BitOrder dataOrder = SPI_BITORDER_MSBFIRST,
                                           ^~~~~~~~~~~~~~~~~~~~~
.pio\libdeps\mks_robin_e3\Adafruit BusIO_ID6214\Adafruit_SPIDevice.cpp:115:23: note: suggested alternative: 'SPI_CR1_LSBFIRST'
     if (_dataOrder == SPI_BITORDER_LSBFIRST) {
                       ^~~~~~~~~~~~~~~~~~~~~
                       SPI_CR1_LSBFIRST
.pio\libdeps\mks_robin_e3\Adafruit BusIO_ID6214\Adafruit_SPIDevice.cpp:149:23: error: 'SPI_BITORDER_LSBFIRST' was not declared in this scope
     if (_dataOrder == SPI_BITORDER_LSBFIRST) {
                       ^~~~~~~~~~~~~~~~~~~~~
*** [.pio\build\mks_robin_e3\libb69\Adafruit BusIO_ID6214\Adafruit_BusIO_Register.cpp.o] Error 1
.pio\libdeps\mks_robin_e3\Adafruit BusIO_ID6214/Adafruit_SPIDevice.h:37:43: note: suggested alternative: 'SPI_CR1_LSBFIRST'
                      BitOrder dataOrder = SPI_BITORDER_MSBFIRST,
                                           ^~~~~~~~~~~~~~~~~~~~~
                                           SPI_CR1_LSBFIRST
.pio\libdeps\mks_robin_e3\Adafruit BusIO_ID6214/Adafruit_SPIDevice.h:42:43: error: 'SPI_BITORDER_MSBFIRST' was not declared in this scope
                      BitOrder dataOrder = SPI_BITORDER_MSBFIRST,
                                           ^~~~~~~~~~~~~~~~~~~~~
.pio\libdeps\mks_robin_e3\Adafruit BusIO_ID6214\Adafruit_SPIDevice.cpp:149:23: note: suggested alternative: 'SPI_CR1_LSBFIRST'
     if (_dataOrder == SPI_BITORDER_LSBFIRST) {
                       ^~~~~~~~~~~~~~~~~~~~~
                       SPI_CR1_LSBFIRST
.pio\libdeps\mks_robin_e3\Adafruit BusIO_ID6214/Adafruit_SPIDevice.h:42:43: note: suggested alternative: 'SPI_CR1_LSBFIRST'
                      BitOrder dataOrder = SPI_BITORDER_MSBFIRST,
                                           ^~~~~~~~~~~~~~~~~~~~~
                                           SPI_CR1_LSBFIRST
In file included from .pio\libdeps\mks_robin_e3\Adafruit_MAX31865\Adafruit_MAX31865.cpp:17:0:
.pio\libdeps\mks_robin_e3\Adafruit_MAX31865\Adafruit_MAX31865.h:84:32: warning: passing NULL to non-pointer argument 1 of 'Adafruit_SPIDevice::Adafruit_SPIDevice(int8_t, uint32_t, BitOrder, uint8_t, SPIClass*)' [-Wconversion-null]
   Adafruit_SPIDevice spi_dev = NULL;
                                ^~~~
*** [.pio\build\mks_robin_e3\libb69\Adafruit BusIO_ID6214\Adafruit_SPIDevice.cpp.o] Error 1
In file included from c:\users\vgege\.platformio\packages\toolchain-gccarmnoneeabi\arm-none-eabi\include\inttypes.h:22:0,
                 from C:\Users\vgege\.platformio\packages\framework-arduinoststm32-maple\STM32F1\cores\maple/avr/pgmspace.h:4,
                 from C:\Users\vgege\.platformio\packages\framework-arduinoststm32-maple\STM32F1\cores\maple/WString.h:29,
                 from C:\Users\vgege\.platformio\packages\framework-arduinoststm32-maple\STM32F1\cores\maple/wirish.h:47,
                 from C:\Users\vgege\.platformio\packages\framework-arduinoststm32-maple\STM32F1\cores\maple/Arduino.h:30,
                 from .pio\libdeps\mks_robin_e3\Adafruit_MAX31865\Adafruit_MAX31865.h:50,
                 from .pio\libdeps\mks_robin_e3\Adafruit_MAX31865\Adafruit_MAX31865.cpp:17:
.pio\libdeps\mks_robin_e3\Adafruit_MAX31865\Adafruit_MAX31865.h:84:32: error: call to 'Adafruit_SPIDevice::Adafruit_SPIDevice(int8_t, uint32_t, BitOrder, uint8_t, SPIClass*)' uses the default argument for parameter 3, which is not yet defined
   Adafruit_SPIDevice spi_dev = NULL;
                                ^
.pio\libdeps\mks_robin_e3\Adafruit_MAX31865\Adafruit_MAX31865.cpp: In constructor 'Adafruit_MAX31865::Adafruit_MAX31865(int8_t, int8_t, int8_t, int8_t)':
.pio\libdeps\mks_robin_e3\Adafruit_MAX31865\Adafruit_MAX31865.cpp:38:76: error: call to 'Adafruit_SPIDevice::Adafruit_SPIDevice(int8_t, int8_t, int8_t, int8_t, uint32_t, BitOrder, uint8_t)' uses the default argument for parameter 6, which is not yet defined
   spi_dev = Adafruit_SPIDevice(spi_cs, spi_clk, spi_miso, spi_mosi, 1000000);
                                                                            ^
.pio\libdeps\mks_robin_e3\Adafruit_MAX31865\Adafruit_MAX31865.cpp: In constructor 'Adafruit_MAX31865::Adafruit_MAX31865(int8_t)':
.pio\libdeps\mks_robin_e3\Adafruit_MAX31865\Adafruit_MAX31865.cpp:49:43: error: 'SPI_BITORDER_MSBFIRST' was not declared in this scope
       Adafruit_SPIDevice(spi_cs, 1000000, SPI_BITORDER_MSBFIRST, SPI_MODE1);
                                           ^~~~~~~~~~~~~~~~~~~~~
.pio\libdeps\mks_robin_e3\Adafruit_MAX31865\Adafruit_MAX31865.cpp:49:43: note: suggested alternative: 'SPI_CR1_LSBFIRST'
       Adafruit_SPIDevice(spi_cs, 1000000, SPI_BITORDER_MSBFIRST, SPI_MODE1);
                                           ^~~~~~~~~~~~~~~~~~~~~
                                           SPI_CR1_LSBFIRST
*** [.pio\build\mks_robin_e3\libc7b\Adafruit_MAX31865\Adafruit_MAX31865.cpp.o] Error 1

erdorath, 2020-05-26:
I can confirm this issue, It seems to be related to this Marlin issue:

https://github.com/MarlinFirmware/Marlin/issues/18081

Changing the library version to
Adafruit_MAX31865=https://github.com/adafruit/Adafruit_MAX31865/archive/1.1.0.zip

Seems to solve the problem! Maybe update this in the configuration files?

makerbase-mks, 2020-05-27:
@vgege86 You can try his @erdorath  method.

m-sja, 2020-05-29:
I can confirm changing Line 34 in platformio.ini solves the compile error.

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

Thanks @erdorath

makerbase-mks, 2020-05-30:
Can you provide your configuration file and .ini file .

DocYester, 2020-05-30:
hmm... looks like not being an issue ...
https://github.com/MarlinFirmware/Marlin/issues/18081#issuecomment-635688767

gromgit, 2020-06-01:
Just tried the fix mentioned in https://github.com/MarlinFirmware/Marlin/pull/18089/files (linked to in the comment mentioned by @DocYester), and it builds OK. Basically, in `platform.ini`, change:
```
Adafruit_MAX31865=https://github.com/adafruit/Adafruit_MAX31865/archive/master.zip
```
to:
```
Adafruit MAX31865 library@>=1.1,<1.2
```
(note the spaces).

erdorath, 2020-06-01:
@makerbase-mks Could you reflect this fix @gromgit posted to the firmware version on your github? A lot of people are having trouble compiling the firmware because of this! It's an easy fix but it would be better if the firmware compiled out of the box!
Thank you :)

gromgit, 2020-06-02:
@makerbase-mks To make things easier, I've backported the fix I mentioned as PR #14. Please merge both that and @DocYester's earlier PR, otherwise everyone else trying to rebuild their firmware will run into the same issues. Thanks much!

makerbase-mks, 2020-06-03:
OK！

Closed 2020-06-03.

Thread 12 (2020-05-28):

Error compiling with ftdi_eve_touch_ui part.

n0th1n6, 2020-05-28:
Hi, I have been pulling my hair due to this issue. I have compiled some 32bit firmware, even for the ESP32 board. This one I cant figure out what is the problem. Please see log below

```
Compiling .pio\build\mks_robin_e3d\src\src\lcd\extensible_ui\lib\ftdi_eve_touch_ui\ftdi_eve_lib\extended\unicode\standard_char_set.cpp.o
In file included from Marlin\src\lcd\extensible_ui\lib\ftdi_eve_touch_ui\ftdi_eve_lib\extended\../../config.h:24:0,
                 from Marlin\src\lcd\extensible_ui\lib\ftdi_eve_touch_ui\ftdi_eve_lib\extended\../compat.h:20,
                 from Marlin\src\lcd\extensible_ui\lib\ftdi_eve_touch_ui\ftdi_eve_lib\extended\ftdi_extended.h:25,
                 from Marlin\src\lcd\extensible_ui\lib\ftdi_eve_touch_ui\ftdi_eve_lib\extended\event_loop.cpp:23:
Marlin\src\lcd\extensible_ui\lib\ftdi_eve_touch_ui\ftdi_eve_lib\extended\../../compat.h:48:47: fatal error: opening dependency file .pio\build\mks_robin_e3d\src\src\lcd\extensible_ui\lib\ftdi_eve_touch_ui\ftdi_eve_lib\extended\event_loop.cpp.d: No such file
or directory
 typedef const __FlashStringHelper *progmem_str;
                                               ^
compilation terminated.
*** [.pio\build\mks_robin_e3d\src\src\lcd\extensible_ui\lib\ftdi_eve_touch_ui\ftdi_eve_lib\extended\event_loop.cpp.o] Error 1
In file included from Marlin\src\lcd\extensible_ui\lib\ftdi_eve_touch_ui\ftdi_eve_lib\extended\../../config.h:24:0,
                 from Marlin\src\lcd\extensible_ui\lib\ftdi_eve_touch_ui\ftdi_eve_lib\extended\../compat.h:20,
                 from Marlin\src\lcd\extensible_ui\lib\ftdi_eve_touch_ui\ftdi_eve_lib\extended\ftdi_extended.h:25,
                 from Marlin\src\lcd\extensible_ui\lib\ftdi_eve_touch_ui\ftdi_eve_lib\extended\screen_types.cpp:22:
Marlin\src\lcd\extensible_ui\lib\ftdi_eve_touch_ui\ftdi_eve_lib\extended\../../compat.h:48:47: fatal error: opening dependency file .pio\build\mks_robin_e3d\src\src\lcd\extensible_ui\lib\ftdi_eve_touch_ui\ftdi_eve_lib\extended\screen_types.cpp.d: No such file or directory
 typedef const __FlashStringHelper *progmem_str;
                                               ^
compilation terminated.
*** [.pio\build\mks_robin_e3d\src\src\lcd\extensible_ui\lib\ftdi_eve_touch_ui\ftdi_eve_lib\extended\screen_types.cpp.o] Error 1
In file included from Marlin\src\lcd\extensible_ui\lib\ftdi_eve_touch_ui\ftdi_eve_lib\extended\../../config.h:24:0,
                 from Marlin\src\lcd\extensible_ui\lib\ftdi_eve_touch_ui\ftdi_eve_lib\extended\../compat.h:20,
                 from Marlin\src\lcd\extensible_ui\lib\ftdi_eve_touch_ui\ftdi_eve_lib\extended\ftdi_extended.h:25,
                 from Marlin\src\lcd\extensible_ui\lib\ftdi_eve_touch_ui\ftdi_eve_lib\extended\sound_player.cpp:22:
Marlin\src\lcd\extensible_ui\lib\ftdi_eve_touch_ui\ftdi_eve_lib\extended\../../compat.h:48:47: fatal error: opening dependency file .pio\build\mks_robin_e3d\src\src\lcd\extensible_ui\lib\ftdi_eve_touch_ui\ftdi_eve_lib\extended\sound_player.cpp.d: No such file or directory
 typedef const __FlashStringHelper *progmem_str;
                                               ^
compilation terminated.
*** [.pio\build\mks_robin_e3d\src\src\lcd\extensible_ui\lib\ftdi_eve_touch_ui\ftdi_eve_lib\extended\sound_player.cpp.o] Error 1
In file included from Marlin\src\lcd\extensible_ui\lib\ftdi_eve_touch_ui\ftdi_eve_lib\extended\../../config.h:24:0,
                 from Marlin\src\lcd\extensible_ui\lib\ftdi_eve_touch_ui\ftdi_eve_lib\extended\../compat.h:20,
                 from Marlin\src\lcd\extensible_ui\lib\ftdi_eve_touch_ui\ftdi_eve_lib\extended\ftdi_extended.h:25,
                 from Marlin\src\lcd\extensible_ui\lib\ftdi_eve_touch_ui\ftdi_eve_lib\extended\tiny_timer.cpp:22:
Marlin\src\lcd\extensible_ui\lib\ftdi_eve_touch_ui\ftdi_eve_lib\extended\../../compat.h:48:47: fatal error: opening dependency file .pio\build\mks_robin_e3d\src\src\lcd\extensible_ui\lib\ftdi_eve_touch_ui\ftdi_eve_lib\extended\tiny_timer.cpp.d: No such file
or directory
 typedef const __FlashStringHelper *progmem_str;
                                               ^
compilation terminated.
*** [.pio\build\mks_robin_e3d\src\src\lcd\extensible_ui\lib\ftdi_eve_touch_ui\ftdi_eve_lib\extended\tiny_timer.cpp.o] Error 1
In file included from Marlin\src\lcd\extensible_ui\lib\ftdi_eve_touch_ui\ftdi_eve_lib\extended\../../config.h:24:0,
                 from Marlin\src\lcd\extensible_ui\lib\ftdi_eve_touch_ui\ftdi_eve_lib\extended\../compat.h:20,
                 from Marlin\src\lcd\extensible_ui\lib\ftdi_eve_touch_ui\ftdi_eve_lib\extended\ftdi_extended.h:25,
                 from Marlin\src\lcd\extensible_ui\lib\ftdi_eve_touch_ui\ftdi_eve_lib\extended\text_box.cpp:22:
Marlin\src\lcd\extensible_ui\lib\ftdi_eve_touch_ui\ftdi_eve_lib\extended\../../compat.h:48:47: fatal error: opening dependency file .pio\build\mks_robin_e3d\src\src\lcd\extensible_ui\lib\ftdi_eve_touch_ui\ftdi_eve_lib\extended\text_box.cpp.d: No such file or directory
 typedef const __FlashStringHelper *progmem_str;
                                               ^
compilation terminated.
*** [.pio\build\mks_robin_e3d\src\src\lcd\extensible_ui\lib\ftdi_eve_touch_ui\ftdi_eve_lib\extended\text_box.cpp.o] Error 1
In file included from c:\mks\marlin2.0 for ender3\marlin\src\lcd\extensible_ui\lib\ftdi_eve_touch_ui\config.h:24:0,
                 from Marlin\src\lcd\extensible_ui\lib\ftdi_eve_touch_ui\ftdi_eve_lib\extended\unicode\../../compat.h:20,
                 from Marlin\src\lcd\extensible_ui\lib\ftdi_eve_touch_ui\ftdi_eve_lib\extended\unicode\../ftdi_extended.h:25,
                 from Marlin\src\lcd\extensible_ui\lib\ftdi_eve_touch_ui\ftdi_eve_lib\extended\unicode\font_bitmaps.cpp:22:
c:\mks\marlin2.0 for ender3\marlin\src\lcd\extensible_ui\lib\ftdi_eve_touch_ui\compat.h:48:47: fatal error: opening dependency file .pio\build\mks_robin_e3d\src\src\lcd\extensible_ui\lib\ftdi_eve_touch_ui\ftdi_eve_lib\extended\unicode\font_bitmaps.cpp.d: No
such file or directory
 typedef const __FlashStringHelper *progmem_str;
                                               ^
compilation terminated.
*** [.pio\build\mks_robin_e3d\src\src\lcd\extensible_ui\lib\ftdi_eve_touch_ui\ftdi_eve_lib\extended\unicode\font_bitmaps.cpp.o] Error 1
In file included from c:\mks\marlin2.0 for ender3\marlin\src\lcd\extensible_ui\lib\ftdi_eve_touch_ui\config.h:24:0,
                 from Marlin\src\lcd\extensible_ui\lib\ftdi_eve_touch_ui\ftdi_eve_lib\extended\unicode\../../compat.h:20,
                 from Marlin\src\lcd\extensible_ui\lib\ftdi_eve_touch_ui\ftdi_eve_lib\extended\unicode\../ftdi_extended.h:25,
                 from Marlin\src\lcd\extensible_ui\lib\ftdi_eve_touch_ui\ftdi_eve_lib\extended\unicode\font_size_t.cpp:22:
c:\mks\marlin2.0 for ender3\marlin\src\lcd\extensible_ui\lib\ftdi_eve_touch_ui\compat.h:48:47: fatal error: opening dependency file .pio\build\mks_robin_e3d\src\src\lcd\extensible_ui\lib\ftdi_eve_touch_ui\ftdi_eve_lib\extended\unicode\font_size_t.cpp.d: No such file or directory
 typedef const __FlashStringHelper *progmem_str;
                                               ^
compilation terminated.
*** [.pio\build\mks_robin_e3d\src\src\lcd\extensible_ui\lib\ftdi_eve_touch_ui\ftdi_eve_lib\extended\unicode\font_size_t.cpp.o] Error 1
In file included from c:\mks\marlin2.0 for ender3\marlin\src\lcd\extensible_ui\lib\ftdi_eve_touch_ui\config.h:24:0,
                 from Marlin\src\lcd\extensible_ui\lib\ftdi_eve_touch_ui\ftdi_eve_lib\extended\unicode\../../compat.h:20,
                 from Marlin\src\lcd\extensible_ui\lib\ftdi_eve_touch_ui\ftdi_eve_lib\extended\unicode\../ftdi_extended.h:25,
                 from Marlin\src\lcd\extensible_ui\lib\ftdi_eve_touch_ui\ftdi_eve_lib\extended\unicode\standard_char_set.cpp:22:
c:\mks\marlin2.0 for ender3\marlin\src\lcd\extensible_ui\lib\ftdi_eve_touch_ui\compat.h:48:47: fatal error: opening dependency file .pio\build\mks_robin_e3d\src\src\lcd\extensible_ui\lib\ftdi_eve_touch_ui\ftdi_eve_lib\extended\unicode\standard_char_set.cpp.d: No such file or directory
 typedef const __FlashStringHelper *progmem_str;
                                               ^
compilation terminated.
*** [.pio\build\mks_robin_e3d\src\src\lcd\extensible_ui\lib\ftdi_eve_touch_ui\ftdi_eve_lib\extended\unicode\standard_char_set.cpp.o] Error 1
FileNotFoundError: [Errno 2] No such file or directory: 'C:\\mks\\marlin2.0 for Ender3\\.pio\\build\\mks_robin_e3d\\.sconsign37.db.tmp':
  File "C:\Users\enolraf\.platformio\packages\tool-scons\script\..\engine\SCons\Script\Main.py", line 1381:
    _exec_main(parser, values)
  File "C:\Users\enolraf\.platformio\packages\tool-scons\script\..\engine\SCons\Script\Main.py", line 1344:
    _main(parser)
  File "C:\Users\enolraf\.platformio\packages\tool-scons\script\..\engine\SCons\Script\Main.py", line 1119:
    nodes = _build_targets(fs, options, targets, target_top)
  File "C:\Users\enolraf\.platformio\packages\tool-scons\script\..\engine\SCons\Script\Main.py", line 1318:
    jobs.run(postfunc = jobs_postfunc)
  File "C:\Users\enolraf\.platformio\packages\tool-scons\script\..\engine\SCons\Job.py", line 113:
    postfunc()
  File "C:\Users\enolraf\.platformio\packages\tool-scons\script\..\engine\SCons\Script\Main.py", line 1315:
    SCons.SConsign.write()
  File "C:\Users\enolraf\.platformio\packages\tool-scons\script\..\engine\SCons\SConsign.py", line 117:
    syncmethod()
  File "C:\Users\enolraf\.platformio\packages\tool-scons\script\..\engine\SCons\dblite.py", line 147:
    f = self._open(self._tmp_name, "wb", self._mode)
Exception ignored in: <function dblite.__del__ at 0x000001FD6D3322F0>
Traceback (most recent call last):
  File "C:\Users\enolraf\.platformio\packages\tool-scons\script\..\engine\SCons\dblite.py", line 143, in __del__
  File "C:\Users\enolraf\.platformio\packages\tool-scons\script\..\engine\SCons\dblite.py", line 140, in close
  File "C:\Users\enolraf\.platformio\packages\tool-scons\script\..\engine\SCons\dblite.py", line 147, in sync
FileNotFoundError: [Errno 2] No such file or directory: 'C:\\mks\\marlin2.0 for Ender3\\.pio\\build\\mks_robin_e3d\\.sconsign37.db.tmp'
================================================= [FAILED] Took 293.88 seconds =================================================

```

makerbase-mks, 2020-05-30:
Hi! Can you provide your configuration file and .ini file .

n0th1n6, 2020-05-30:
I have made some changes already. I have deleted the whole extensible_ui directory and I was able to successfully build. Ill attach my config and ini files.
[Configuration.txt](https://github.com/makerbase-mks/MKS-Robin-E3-E3D/files/4704901/Configuration.txt)

[platformio.txt](https://github.com/makerbase-mks/MKS-Robin-E3-E3D/files/4704902/platformio.txt)

makerbase-mks, 2020-06-03:
You needn't use #define CR10_STOCKDISPLAY
 you can use #define REPRAP_DISCOUNT_FULL_GRAPHIC_SMART_CONTROLLER
Because have not define pin in pins_MKS_ROBIN_E3D.h about CR10_STOCKDISPLAY display pin, so, you need enable #define REPRAP_DISCOUNT_FULL_GRAPHIC_SMART_CONTROLLER

n0th1n6, 2020-06-03:
If I use the REPRAP_DISCOUNT_FULL_GRAPHIC_SMART_CONTROLLER, will it work with ender 3 LCD?

I have successfully built the firmware now after deleting the whole extensible_ui directory

mks-viva, 2020-10-14:
@n0th1n6 The firmware compile is OK.

mks-viva, 2020-11-17:
I will close this issues temporarily.

Closed 2020-11-17.

Thread 13 (2020-05-30):

Error saving config in TFCard

KiZDGGit, 2020-05-30:
Hello, I'm just trying to save config with "stock firmware", but settings are not storing in SDCard not EEPROM.

How can I save config?

Thanks in advance.

DocYester, 2020-05-30:
Build Marlin from latest bugfix branch by yourself and see how to get the saving done to flash by emulation there ->
https://github.com/makerbase-mks/MKS-Robin-E3-E3D/issues/3

KiZDGGit, 2020-05-30:
Thank you for your answer. Desisted to update using
https://github.com/makerbase-mks/MKS-Robin-E3-E3D/tree/master/firmware/marlin2.0%20for%20Ender3

With Arduino IDE, many errors:
ATENCIÓN: la librería U8glib pretende ejecutarse sobre arquitectura(s) avr, sam y puede ser incompatible con tu actual tarjeta la cual corre sobre arquitectura(s) STM32F1.
ATENCIÓN: la librería TMCStepper pretende ejecutarse sobre arquitectura(s) avr y puede ser incompatible con tu actual tarjeta la cual corre sobre arquitectura(s) STM32F1.
In file included from sketch/src/inc/MarlinConfig.h:38:0,
                 from sketch/src/Marlin.h:24,
                 from sketch/src/Marlin.cpp:31:
sketch/src/inc/SanityCheck.h:2084:4: error: #error "TMC2208 Software Serial is supported only on AVR, LPC1768, STM32F1 and STM32F4 platforms."
   #error "TMC2208 Software Serial is supported only on AVR, LPC1768, STM32F1 and STM32F4 platforms."

and with Platformio... some others (...and I don't like/understand how it works).

Is there any way to save settings somewhere with stock fw? I can't setup PID, extrusion...

Thanks!!

DocYester, 2020-05-31:
If you use the real bugfix branch -> https://github.com/MarlinFirmware/Marlin it works

I havent tested the stock firmware at all - so i cant tell you how if or where it could be saved at all

The only way else would be to put all together in a gcode startscript.
Most slicers support that.

KiZDGGit, 2020-05-31:
Updated with real bugfix branch!! motors rotated in the opposite direction, but now it's solved.

Thanks!

DocYester, 2020-05-31:
Look for
```
// Invert the stepper direction. Change (or reverse the motor connector) if an axis goes the wrong way.
#define INVERT_X_DIR true
#define INVERT_Y_DIR false
#define INVERT_Z_DIR true
```
in the Configuration.h

KiZDGGit, 2020-05-31:
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

Yes, that is the way I've solved. Now printing, but too high motor temperature, will check drivers settings again.

Thank you for your support.

DocYester, 2020-05-31:
TMC2209 and Ender3 Stock motors ?
Define the steppers in Configuration.h
```
#define X_DRIVER_TYPE  TMC2209
#define Y_DRIVER_TYPE  TMC2209
#define Z_DRIVER_TYPE  TMC2209
#define E0_DRIVER_TYPE  TMC2209
```
Make them silent in Configuration_adv.h
```
#define STEALTHCHOP_XY
#define STEALTHCHOP_Z
#define STEALTHCHOP_E
```

Standard 2209-current settings in Marlin (800mA) is enough for them and they dont get too hot
Lowering them to 500-600-700 is possible but needs attention and testing if they still work fine

Thread 15 (2020-06-02):

Information about compiling Marlin

monkiki, 2020-06-02:
Hello, I need to compile Marlin to configure a BMG extrusor and already done with default Ender 3 Pro board, but not sure how to proceed with the Robin E3D board. For example, which boarch should I choose in Arduino IDE? Where can I get a default configuration for Marlin? Is the same as Ender 3 profile?

Thanks.

DocYester, 2020-06-02:
https://github.com/makerbase-mks/MKS-Robin-E3-E3D/wiki/Build-and-Update-firmware

... try the default from mks here - but dont just copy all over - its an older version than actual marlin bugfix branch

makerbase-mks, 2020-06-03:
Hi! You can download new version marlin firmware and change it as use to Robin E3D board. Of course! You can download Robin E3-E3D path marlin and chang it.

monkiki, 2020-06-03:
OK, thanks!

Closed 2020-06-03.

Thread 16 (2020-06-03):

KILLED. PRINTER HALTED

monkiki, 2020-06-03:
I was able to compile the provided Marlin from this repository but I got "KILLED. PRINTER HALTED" once the printer has the new firmware.

Printer: Ender 3 Pro
Board: MKS Robin E3D

n0th1n6, 2020-06-04:
What display are you using?

in my case, I use CR10_STOCKDISPLAY so I added this just after the #define CR10_STOCKDISPLAY. You can put it in Configuration_adv.h or even in board file. I guess it is best to put it in the board file as it could be board specific

Also disable psu control if you are not using one because it will assign a PIN and since there is no signal, it will still end up in this error

#if ENABLED(CR10_STOCKDISPLAY)
#define KILL_PIN -1
#endif

monkiki, 2020-06-04:
I use the Ender 3 stock display, should I use the same CR10_STOCKDISPLAY define? I will try to comment the KILL_PIN. I've also seen this workaround to avoid this problem but not sure if is a good practice. I've compiled Marlin for other printers (also the Ender 3 with stock board) and never got this error.

n0th1n6, 2020-06-04:
Ender 3 stock display, if you will notice is the same CR10_STOCKDISPLAY. It is safe because there is no kill button/pin in Ender 3. Unless you want to wire a kill button yourself but I believe you have to install the pullup/pulldown resistor.

monkiki, 2020-06-04:
Thanks for the info. I will try it.

makerbase-mks, 2020-06-04:
Hi! You download marlin firmware is Robin E3-E3D path? If you download it and use it, you need disable PSU_CONTROL

monkiki, 2020-06-04:
I disabled PSU_CONTROL but also needed to add `#define KILL_PIN -1` to **pins_MKS_ROBN_E3D.h** and got a lot of warning because KILL_PIN was redefined but now the error message dissapeared.

It would be really nice to download the source code hosted in this repository and compile it without any tweaks (at least with a stock Ender 3), because is a bit weird to get all these problems. I had to compile Marlin because I have a BMG.

n0th1n6, 2020-06-05:
I think you need it inside #ifdef to avoid those warnig

monkiki, 2020-06-05:
Same result.

Anyway my requirement is to be able to download the proper Marlin source code ready to be compiled for the MKS Robin E3D, or with well documented and working changes.

But the best option should be submit these changes to the original Marlin project, so we can use a more recent version. I don't know why this board is not already included in Marlin like others.

DocYester, 2020-06-05:
It is - look in bugfix 2.0.5.3+ ... you just need the settings documented here in the "build & upload" section

monkiki, 2020-06-05:
In Marlin master I can see several ROBIN: LITE, NANO, MINI, PRO but no E3D :/

n0th1n6, 2020-06-06:
I am able to build the bugfix 2.0.5.3, still need some fixes here and there. The sample configuration that comes with bugfix has bedpidtemp enabled. That could be another surprise if you are not aware of it and has not tuned PID before.

I would like to commit some of my changes but since I am not a good C programmer, I avoided doing it. It can just mess up the source.

DocYester, 2020-06-06:
bugfix brnach ... the latest
https://github.com/MarlinFirmware/Marlin/blob/bugfix-2.0.x/Marlin/src/core/boards.h
Line 306

> In Marlin master I can see several ROBIN: LITE, NANO, MINI, PRO but no E3D :/

bugfix branch ... not master
https://github.com/MarlinFirmware/Marlin/blob/bugfix-2.0.x/Marlin/src/core/boards.h
Line 306

monkiki, 2020-06-06:
Thanks, I will try with this branch.

alcar21, 2020-06-09:
I have the same problem. Branch works?

Printer: Ender 5 Pro
Board: MKS Robin E3D

makerbase-mks, 2020-06-12:
You can download this bin file update and it have not PSU_CONTROL function
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

ToniJCustom, 2020-06-30:
Donwload Malin bugfix 2.0.x

Use configuration ender 3 from https://github.com/MarlinFirmware/Configurations/archive/bugfix-2.0.x.zip

change archives from https://github.com/ToniJCustom/Config.-Marlin-2.0.x-Ender3-MKS-Robin-e3.git

if you have e3d board the onli change it in configuration.h

it is for stock machine configuration

DPSou, 2020-07-14:
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

I didn't get the second step. The only Ender 3 configuration files on the link are for the stock Ender 3 V1. (Configurations-bugfix-2.0.x\config\examples\Creality\Ender-3\CrealityV1).

ToniJCustom, 2020-07-26:
Yes, i change the language, i don't remenber sorry, the importante is the correct configuration of board and platformio

Thread 17 (2020-06-05):

Robin E3 does not work with 3D Touch via PB1 pin

chshkhr, 2020-06-05:
I spent the whole day trying to run 3D Touch with MKS Robin E3 using the tutorial https://www.youtube.com/watch?v=r2A0b7XQEaI without any success. Finally connected it on Z End Stop and it's OK now. Then I tried again to switch back to PB1 pin assured that 3D Touch is fine but nothing helps... 3D Touch work only via Z End Stop in my case

makerbase-mks, 2020-06-06:
You can refer to 3D Touch bltouch tutorial with LCD12864 and MKS Robin E3D SGen_L Gen_L :https://www.youtube.com/watch?v=r2A0b7XQEaI

chshkhr, 2020-06-06:
You recommend the same tutorial as I mention in my comment...

chshkhr, 2020-06-06:
By the way in both User Manuals for [E3D](https://github.com/makerbase-mks/MKS-Robin-E3-E3D/wiki/MKS-Robin-E3D-V1.0-User-Manual) and [E3](https://github.com/makerbase-mks/MKS-Robin-E3-E3D/wiki/MKS-Robin-E3D-V1.0-User-Manual) PIN diagrams reference on PB1 for ESTOP and PA2 for PROBE. But the motherboard contains just one connector for both Probe and Estop named "Probe/ESTOP". I tried `#define Z_MIN_PROBE_PIN PB1` and `#define Z_MIN_PROBE_PIN PA2`, `#define Z_MIN_PROBE_ENDSTOP_INVERTING true` and `#define Z_MIN_PROBE_ENDSTOP_INVERTING false`. But the result is the same: 3D Touch tested OK from the LCD but does not work as ENDSTOP

erezagami, 2020-06-06:
Hi,
Did you enable `#define USE_PROBE_FOR_Z_HOMING`
in the Configuration.h?

erezagami, 2020-06-06:
also did you set
`#define NUM_SERVOS 1 `
?

chshkhr, 2020-06-06:
I did everything from [the Tutorial](https://www.youtube.com/watch?v=r2A0b7XQEaI).
Including `#define NUM_SERVOS 1`  and `#define Z_MIN_PROBE_PIN PB1`
But `#define USE_PROBE_FOR_Z_HOMING` not mentioned in the Tutorial.
I searched throughout all source codes but `USE_PROBE_FOR_Z_HOMING` not used anywhere too...
So I think  `#define USE_PROBE_FOR_Z_HOMING` can't help

erezagami, 2020-06-06:
Are using the bugfix branch cause they add it recently it not at 2.0.5
3 release

chshkhr, 2020-06-06:
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

I'm using [MKS-Robin-E3-E3D](https://github.com/makerbase-mks/MKS-Robin-E3-E3D)...
What should I do to use sources from [Marlin main repository](https://github.com/MarlinFirmware/Marlin) (including bugfix branch) for MKS Robin E3?

erezagami, 2020-06-06:
I am using bugfix from marlin main repo. I have bltouch connected to the prob and it does work. I do not know when they sync last. We can check later

erezagami, 2020-06-06:
I do have an issue with the printer freezing but i do not think it firmware related

chshkhr, 2020-06-06:
Thank you! I will wait responce from makerbase-mks

chshkhr, 2020-06-07:
With sources from Marlin main repo [bugfix-2.0.x branch](https://github.com/MarlinFirmware/Marlin/tree/bugfix-2.0.x) 3D Touch connected to the prob does work... Thanks to [erezagami ](https://github.com/erezagami)!

anilcancakir, 2020-07-24:
> With sources from Marlin main repo [bugfix-2.0.x branch](https://github.com/MarlinFirmware/Marlin/tree/bugfix-2.0.x) 3D Touch connected to the prob does work... Thanks to [erezagami ](https://github.com/erezagami)!

I couldn't run the X & Y endstops with bugfix-2.0.x marlin version. Can you share with me?

erezagami, 2020-07-25:
you can look at my branch https://github.com/erezagami/Marlin/tree/2.0.x-bf-makerbase-256k
Note that there are some customization for my printer (bed size, kpi tuning, bltouch) etc...
so you probably do not want to use it as is.

tassiolucas, 2020-09-12:
I own an MKS Robin E3 and have tested all possible firmware. Both the MKS-Robin-E3-E3D-master (which in turn does not have the buldroot working) and the one marked with release tag and both the PB1 port does not work. - I also tested the newer versions of [MarlinFirmware / Marlin](https://github.com/MarlinFirmware/Marlin) and when flashing it doesn't even start Marlin. It is very sad to see this disorganization of code and documentation in which nothing makes sense. Frustrating!

makerbase-mks, 2020-09-14:
@tassiolucas Use to Ender3?

tassiolucas, 2020-09-16:
Yes, I use Creality Ender 3 PRO. I found Configuration.h and Configuration_adv.h for the printer. But even so, the BLTouch sensor recognizes, the extraction and retraction commands work, but the PB1 port in Bilinear calibration, at the beginning of printing it does not level with the table and I end up needing to use an Offset Z for each type of height on the table, as if I had manually calibrated it. I followed the tutorial posted by you and I did not get the sensor to fully function. Follow the wiki: https://github.com/makerbase-mks/MKS-Robin-E3-E3D/wiki/3D_TOUCH

Another strange thing that my sensor only passed the expansion and retraction test when I inverted the pins S G 5V by 5V G S; and the same thing for PB G from S G I had to change to G S.

Is this wiki really up to date?

makerbase-mks, 2020-09-17:
@tassiolucas
Can you provide config to me?

tassiolucas, 2020-09-17:
Here the config file:

[Configuration.zip](https://github.com/makerbase-mks/MKS-Robin-E3-E3D/files/5240487/Configuration.zip)

makerbase-mks, 2020-09-18:
@tassiolucas
You probe use Z-STOP? If is, you need sett it:
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

tassiolucas, 2020-09-18:
This makes no sense. At the beginning of the tutorial, you are asked to define Z_MIN_PROBE_PIN as PB1, which is where the sensor is connected. And at this point where you are indicating is to whom you are replacing the ENDSTOP of the Z axis. I do not replace and I am using the PB1 port to connect my 3D Touch. what is the point in commenting right after that line?

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

tassiolucas, 2020-09-18:
Other point. The sensor only works the mechanical part, when these pins have been inverted. From S G 5V to 5V G S (or Yellow -> Red -> Green, top to bottom in the photo on the plate)

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

Or else this is not the right scheme for Robin E3.

tassiolucas, 2020-09-18:
I tried to use this setup and it doesn't work. I need a setup that uses port PB1. With this, when trimming the ENDSTOP of the Z axis it stops, without getting the right level of 3D Touch.

makerbase-mks, 2020-09-19:
@tassiolucas
We will configure the firmware that can use 3D TOUCH and upload it to Github.

tassiolucas, 2020-09-19:
This is not necessary. As the @chshkhr rightly said, Marlin does not recognize the PB1 as a 3D Touch sensor. I performed the second configuration indicated with 3D Touch on ENDSTOP of the Z axis and now the probe is working. I think you should update the configuration and because it is the only one that is present on the internet and its MKS Robin E3 cards do not have recognition on the port indicated as the default configuration which is PB1. Here are the configuration files that are the only ones that work, with the sensor connected to the ENDSTOP of the Z axis.

[Configuration.zip](https://github.com/makerbase-mks/MKS-Robin-E3-E3D/files/5249071/Configuration.zip)

mustafadh12, 2020-09-28:
hello, i have exactly same issue and ive started to have some dreams about configs, mks e3d and bl touch or maybe nightmares because of mks team!

mustafadh12, 2020-10-01:
can anyone share their files for ender 3 pro ?

mustafadh12, 2020-10-05:
> This is not necessary. As the chshkhr rightly said, Marlin does not recognize the PB1 as a 3D Touch sensor. I performed the second configuration indicated with 3D Touch on ENDSTOP of the Z axis and now the probe is working. I think you should update the configuration tutorial and because it is the only one that is present on the internet and its MKS Robin E3 cards do not have recognition on the port indicated as the default configuration which is PB1. Here are the configuration files that are the only ones that work, with the sensor connected to the ENDSTOP of the Z axis.
>
> [Configuration.zip](https://github.com/makerbase-mks/MKS-Robin-E3-E3D/files/5249071/Configuration.zip)

which version of marlin? im trying to compile but it says thats an old version and must be updated...

makerbase-mks, 2020-10-09:
We has upload it: https://github.com/makerbase-mks/MKS-Robin-E3-E3D/tree/ender3-3d-touch

hieppo, 2020-11-13:
I'm having an extremely frustrating time trying to use 3d touch with the Robin e3 board and ender 3 pro. I have compiled the source mentioned just above and also tried the latest marlin release using the pb1 pins. Everything seems to be working fine until I try to print. The 25 points mesh is created and loaded and activated according to what the eeprom display. But everything print badly the nozzle does not seems to adjust and get close enough to the bed. Nothing stick well to the bed. I have tried various materials with different temp that worked perfectly when I manually level the bed. Do I really need to use the z limit pins. What's the difference between using pb1 and z pins. Mesh wad created through pb1 so how would switching to z helps with the print.

mks-viva, 2020-12-11:
I has upload 3d touch firmware to here, you can refer to it and you need set borad is BOARD_MKS_ROBIN_E3
https://github.com/makerbase-mks/MKS-Robin-E3-E3D/tree/master/firmware/V1.1

JonathanMortes, 2021-04-01:
I've got the same issue. I'm using a custom sensor that worked great for the original board and works with the new one (MKS E3P) but when trying to do auto leveling it attempts one point, detects it and then goes back home. I'm using the same Bilinear config with 9 points and 3x the probing as I did on the original board. Anyone can help?

MarioGK, 2021-04-19:
@JonathanMortes Having the same problem, tell me if you fixed it

JonathanMortes, 2021-04-19:
@MarioGK I did, I had to do some fancy stuff with the limits but I managed to make it work for my sensor and Ender 3. Let me know if you want the marlin ;)

jesterhead82, 2021-04-28:
I have an e3 running with Bltouch (w/o z Endststop), Sensor connected like in the picture

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

Followed basically the Wiki entry
[
[Configuration.h.txt](https://github.com/makerbase-mks/MKS-Robin-E3-E3D/files/6394090/Configuration.h.txt)
](url)

OpenZSD, 2021-05-02:
I'm having a similar issue. In my case I kept the z end stop. When touching the bed, the end retracts and the led lights but continues until the z end stop is reached. It goes to the first point in the bed leveling grid and then gives up. Any advice?

marcomro, 2021-05-04:
Não consigo fazer funcionar bltoutch de acordo com nenhum tutorial da própria fabricante. mks robin e3p v 2.0  alguem que possa me ajudar?

vinceshere, 2021-06-10:
>
>
> @MarioGK I did, I had to do some fancy stuff with the limits but I managed to make it work for my sensor and Ender 3. Let me know if you want the marlin ;)

Hello man! I know a lot of time passed by, but can you provide this Marlin please? I've already tried everything, but nothing works. I have a Ender 3 with a Robin E3 V1.0

DogsoldierNZ, 2021-08-24:
Did anyone find a fix for this ?

hieppo, 2021-08-24:
Those having a hard time with configuring BL/3D Touch on the Robin E3/E3D. This is what I notice different from what MKS documented.
/**
 * Enable this option for a probe connected to the Z-MIN pin.
 * The probe replaces the Z-MIN endstop and is used for Z homing.
 * (Automatically enables USE_PROBE_FOR_Z_HOMING.)
 */
//#define Z_MIN_PROBE_USES_Z_MIN_ENDSTOP_PIN ******NOTE DISABLE this if you want to use PB1 pin, with this disable, you can even unplug the Z limit switch without any issue******

// Force the use of the probe for Z-axis homing
#define USE_PROBE_FOR_Z_HOMING  ******ENABLE this if you want to use PB1*******

/**
 * Z_MIN_PROBE_PIN
 *
 * Define this pin if the probe is not connected to Z_MIN_PIN.
 * If not defined the default pin for the selected MOTHERBOARD
 * will be used. Most of the time the default is what you want.
 *
 *  - The simplest option is to use a free endstop connector.
 *  - Use 5V for powered (usually inductive) sensors.
 *
 *  - RAMPS 1.3/1.4 boards may use the 5V, GND, and Aux4->D32 pin:
 *    - For simple switches connect...
 *      - normally-closed switches to GND and D32.
 *      - normally-open switches to 5V and D32.
 *
 */
#define Z_MIN_PROBE_PIN PB1 // Pin 32 is the RAMPS default  *************Make sure this is enabled and PB1

/**
 * The BLTouch probe uses a Hall effect sensor and emulates a servo.
 */
 #define BLTOUCH ********Just in case you missed this, ENABLE it***************

DogsoldierNZ, 2021-08-24:
#define Z_MIN_PROBE_PIN PB1 // Pin 32 is the RAMPS default *************Make sure this is enabled and PB1
I did this in the Pins file and removed the Z_MAX_PIN and everything started to work.

Your fix works perfectly thanks

santiagoluz, 2023-07-23:
Thanks @hieppo and @erezagami
I was struggling with this issue. I'm using the probe connected to the slots in the board shown in the photo/diagram in the wiki article (https://github.com/makerbase-mks/MKS-Robin-E3-E3D/wiki/3D_TOUCH). It only worked correctly when I enabled `USE_PROBE_FOR_Z_HOMING`. I'm using Marlin 2.1.2 and BOARD_MKS_ROBIN_E3D.

**Configuration.h** section ended up like this:

```
/**
 * Enable this option for a probe connected to the Z-MIN pin.
 * The probe replaces the Z-MIN endstop and is used for Z homing.
 * (Automatically enables USE_PROBE_FOR_Z_HOMING.)
 */
// #define Z_MIN_PROBE_USES_Z_MIN_ENDSTOP_PIN

// Force the use of the probe for Z-axis homing
#define USE_PROBE_FOR_Z_HOMING

/**
 * Z_MIN_PROBE_PIN
 *
 * Define this pin if the probe is not connected to Z_MIN_PIN.
 * If not defined the default pin for the selected MOTHERBOARD
 * will be used. Most of the time the default is what you want.
 *
 *  - The simplest option is to use a free endstop connector.
 *  - Use 5V for powered (usually inductive) sensors.
 *
 *  - RAMPS 1.3/1.4 boards may use the 5V, GND, and Aux4->D32 pin:
 *    - For simple switches connect...
 *      - normally-closed switches to GND and D32.
 *      - normally-open switches to 5V and D32.
 */
#define Z_MIN_PROBE_PIN PB1
```

@makerbase-mks please update wiki *Firmware setting* section to include this instruction.

Thread 18 (2020-06-06):

Printer halt randomly when printing from usb

erezagami, 2020-06-06:
HI,
I have mks_robin_e3 with ender 3.
I am using the master branch of marlin 2.0.0-bugfix.
When using octprint over usb the printer halt, the screen become unresponsive and the serial connection is dropped and it not possible to reconnect unless restarting the printer.

The printer seems to maintain the temperature of the hotend and the bed.

The printer hang at different point every time, but when printing from sd card seems to complete successfully.

any suggestions ?

DocYester, 2020-06-06:
115200 Baud is actually the only suitable solution for me - got the same issue
Tried with UART-connect - no change

erezagami, 2020-06-06:
Thanks, I will try with 115200 Baud .

erezagami, 2020-06-07:
Setting the Baud rate to 115200 seems to solve  the freezing!!
3 prints so far all successful.
Thanks DocYester!

Do we have any idea why the baud rate matter? I thought it emulates the serial?
Also i seems to have more stringing could that be related?

DocYester, 2020-06-07:
I would guess a bad SoftwareSerial libary
Just to get some numbers right : 115200 Baud = 14.kb/s
That should be more than enough to print even at real 60mm/s
When i slice a 3DBenchy @ 100% size with 0.12 layer and 0.5 line width in prusa slicer it's only 3.85MB gcode file - could be transferred in ~280 seconds (4:40) - but printing time (at 30mm/s) is roughly 3hrs - so i really dont care of 250k or 115k baud speed at all.

I havent seen any stringing getting worse by changing the baud rate yet.

makerbase-mks, 2020-06-08:
If you reduce the baud rate transmission speed can solve the problem, then congratulations. You can also try to set the baud rate to 250000, the cache instruction BUFSIZE is set to a larger in configuation_adv.h file, like 8 and so on

DocYester, 2020-06-08:
#define MAX_CMD_SIZE 384    // was 96
#define BUFSIZE 16           // was 4
#define RX_BUFFER_SIZE 256 // was disabled
Freezes still occour at 250k baud ...

makerbase-mks, 2020-06-11:
Regarding this problem, reducing the baud rate can be solved. So, I will temporarily close this question

Closed 2020-06-12.

Thread 19 (2020-06-11):

Connect via usb with Octoprint and printer hanged.

avfoto, 2020-06-11:
Hi.
I have managed to connect my Robin E3D board mounted on my Ender 3 to my Octoprint system. For this I have to select "auto" in the baudrate.
After 10-15 minutes the printer hangs and stops printing (although it continues to heat)
What could be the problem?
Thank you.

erezagami, 2020-06-11:
try with 115200 baud rate.

avfoto, 2020-06-11:
I've already tried, it doesn't work.

makerbase-mks, 2020-06-12:
Hi!
1. Is the baud rate too fast, try using 115200
2. You can increase BUFFSIZE, such as 8

avfoto, 2020-06-12:
I've tryed that, but Octoprint only connect to the board when I specify "AUTO" on the baudrate

erezagami, 2020-06-12:
Do you compile marlin yourself? Did you set #define BAUDRATE 115200
In marlin config?

avfoto, 2020-06-12:
Yes, I've compiled by myself, but my octoprint only connects with the printer when I select "AUTO" baudrate.

DocYester, 2020-06-20:
Dont even think about any help for this problem ...
https://github.com/makerbase-mks/MKS-Robin-E3-E3D/issues/18

DocYester, 2020-07-02:
Tried diffrent baud rates (56k/115k/250k) - even only usb1 mode (and all other stuff that is mentioned about "usb_serial_generic_read_bulk_callback - urb stopped: -32" errors) and 3 diffrent pi-hw-versions ... anyhere between 3 minutes and 7hrs the board just stucks - no more display updates, not responding to anything - only a hard reboot makes it responsible again
looks like to me that the mks board has the trouble-some chipset

mks-viva, 2020-10-15:
@avfoto Has this problem been solved?

mks-viva, 2020-12-11:
I will close this issues temporarily

Closed 2020-12-11.

Thread 20 (2020-06-13):

Using 512K of flash & EEPROM Emulation

EvgeniyRU, 2020-06-13:
The board contains STM32F103RCT6 some of them has 512K flash (mine has), but current firmware settings using only 256K and not using EEPROM

To fix that it is needed to make some changes
[platformio.ini]
.....
platform      = ststm32
board         = genericSTM32F103RC
**board_upload.maximum_size=524288**
....

[mks_robin_e3.ld]
  **rom (rx)  : ORIGIN = 0x08005000, LENGTH = 512K - 24K**

[pins_MKS_ROBIN_E3.h, pins_MKS_ROBIN_E3D.h] at the end of file
**#undef STM32_FLASH_SIZE
#define STM32_FLASH_SIZE 512
#define FLASH_EEPROM_EMULATION
#define EEPROM_PAGE_SIZE     uint16(0x800) // 2KB
#define EEPROM_START_ADDRESS uint32(0x08000000 + STM32_FLASH_SIZE * 1024 - 2 * EEPROM_PAGE_SIZE)
#undef E2END
#define E2END                (EEPROM_PAGE_SIZE - 1) // 2KB**

[Configuration.h]
uncomment #define EEPROM_SETTINGS

PS: sorry, it partly duplicates #3

EvgeniyRU, 2020-06-13:
For only EEPROM emulation changes like that

[mks_robin_e3.ld]
**rom (rx) : ORIGIN = 0x08005000, LENGTH = 256K - 24K**

[pins_MKS_ROBIN_E3.h, pins_MKS_ROBIN_E3D.h] at the end of file
**#define FLASH_EEPROM_EMULATION
#define EEPROM_PAGE_SIZE uint16(0x800) // 2KB
#define EEPROM_START_ADDRESS uint32(0x08000000 + 256 * 1024 - 2 * EEPROM_PAGE_SIZE)
#undef E2END
#define E2END (EEPROM_PAGE_SIZE - 1) // 2KB**

[Configuration.h]
uncomment #define EEPROM_SETTINGS

makerbase-mks, 2020-08-05:
Hi! I has fix it and eeprom data storage

Closed 2020-08-05.

Thread 21 (2020-07-03):

Cannot update firmware

haley0918, 2020-07-03:
I copied "Robin_e3.bin" from "MKS-Robin-E3-E3D-master\firmware\firmware bin for Ender3(TMC2209)" into sd card. Inserted the card to the board and powered up. But the lcd only shows "boot". After a while, removed sd card and reset. the lcd still shows "boot".

How to solve this?

fadlio, 2020-07-03:
Maybe you forgot to include a LCD driver in configuration.h.
For my Ender 3, I uncommented the line with "#define REPRAP_DISCOUNT_FULL_GRAPHIC_SMART_CONTROLLER"

makerbase-mks, 2020-07-04:
@haley0918 You can try to download Robin E3-E3D path firmware bin file, and update it is normal？

haley0918, 2020-07-04:
@makerbase-mks I am trying with the given [Robin_e3.bin](https://github.com/makerbase-mks/MKS-Robin-E3-E3D/blob/master/firmware/firmware%20bin%20for%20Ender3(TMC2209)/Robin_e3.bin) file, not making from the Marlin source. Copied into sd card and insert into board then reset. LCD shows "boot". Reset it again and still same. Maybe file was not right in sd card, so I formatted my card and try again, no change, still only "boot".

@fadlio no I'm not making new firmware from source yet, just using the given pre-compiled ones. Will take note of that for when I compile from source.

makerbase-mks, 2020-07-04:
@haley0918 If you do not connect peripheral equipment, such as your motor, heating head... Can the motherboard start normally? You can just connect the LCD display and try to update the firmware?

haley0918, 2020-07-04:
@makerbase-mks Yes, I have nothing else connected. Only the motherboard and LCD, connected to usb power supply

haley0918, 2020-07-06:
No reply... does this mean my board is bricked? Nothing can be done to save it? I just got it not long ago, haven't begin using it yet.

@makerbase-mks

makerbase-mks, 2020-07-06:
Can you provide picture about board‘'s problem

haley0918, 2020-07-06:
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

makerbase-mks, 2020-07-06:
OK! I has view it. I need you to do the following:
1. Connect your board to pronterface by USB and check it printing information;
2. Send M122 check information
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

haley0918, 2020-07-06:
@makerbase-mks here is a screenshot of M122.
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

haley0918, 2020-07-06:
@makerbase-mks  I tried a few more commands below.
>>> M503
SENDING:M503
echo:  G21    ; Units in mm (mm)
echo:; Filament settings: Disabled
echo:  M200 S0 D1.75
echo:; Steps per unit:
echo: M92 X80.00 Y80.00 Z4000.00 E500.00
echo:; Maximum feedrates (units/s):
echo:  M203 X300.00 Y300.00 Z5.00 E25.00
echo:; Maximum Acceleration (units/s2):
echo:  M201 X3000.00 Y3000.00 Z100.00 E10000.00
echo:; Acceleration (units/s2): P<print_accel> R<retract_accel> T<travel_accel>
echo:  M204 P3000.00 R3000.00 T3000.00
echo:; Advanced: B<min_segment_time_us> S<min_feedrate> T<min_travel_feedrate> J<junc_dev>
echo:  M205 B20000.00 S0.00 T0.00 J0.01
echo:; Home offset:
echo:  M206 X0.00 Y0.00 Z0.00
echo:; PID settings:
echo:  M301 P22.20 I1.08 D114.00

>>> M115
SENDING:M115
FIRMWARE_NAME:Marlin SOURCE_CODE_URL:https://github.com/MarlinFirmware/Marlin PROTOCOL_VERSION:1.0 MACHINE_TYPE:3D Printer EXTRUDER_COUNT:1 UUID:00000000-0000-0000-0000-000000000000
Cap:SERIAL_XON_XOFF:0
Cap:BINARY_FILE_TRANSFER:0
Cap:EEPROM:0
Cap:VOLUMETRIC:1
Cap:AUTOREPORT_TEMP:1
Cap:PROGRESS:0
Cap:PRINT_JOB:1
Cap:AUTOLEVEL:0
Cap:Z_PROBE:0
Cap:LEVELING_DATA:0
Cap:BUILD_PERCENT:0
Cap:SOFTWARE_POWER:0
Cap:TOGGLE_LIGHTS:0
Cap:CASE_LIGHT_BRIGHTNESS:0
Cap:EMERGENCY_PARSER:0
Cap:PROMPT_SUPPORT:0
Cap:SDCARD:0
Cap:AUTOREPORT_SD_STATUS:0
Cap:LONG_FILENAME:0
Cap:THERMAL_PROTECTION:1
Cap:MOTION_MODES:0
Cap:ARCS:1
Cap:BABYSTEPPING:0
Cap:CHAMBER_TEMPERATURE:0

haley0918, 2020-07-06:
@makerbase-mks I tried a few more commands below.
>>> M503
SENDING:M503
echo:  G21    ; Units in mm (mm)
echo:; Filament settings: Disabled
echo:  M200 S0 D1.75
echo:; Steps per unit:
echo: M92 X80.00 Y80.00 Z4000.00 E500.00
echo:; Maximum feedrates (units/s):
echo:  M203 X300.00 Y300.00 Z5.00 E25.00
echo:; Maximum Acceleration (units/s2):
echo:  M201 X3000.00 Y3000.00 Z100.00 E10000.00
echo:; Acceleration (units/s2): P<print_accel> R<retract_accel> T<travel_accel>
echo:  M204 P3000.00 R3000.00 T3000.00
echo:; Advanced: B<min_segment_time_us> S<min_feedrate> T<min_travel_feedrate> J<junc_dev>
echo:  M205 B20000.00 S0.00 T0.00 J0.01
echo:; Home offset:
echo:  M206 X0.00 Y0.00 Z0.00
echo:; PID settings:
echo:  M301 P22.20 I1.08 D114.00

>>> M115
SENDING:M115
FIRMWARE_NAME:Marlin 2.0.1 (GitHub) SOURCE_CODE_URL:https://github.com/MarlinFirmware/Marlin PROTOCOL_VERSION:1.0 MACHINE_TYPE:3D Printer EXTRUDER_COUNT:1 UUID:cede2a2f-41a2-4748-9b12-c55c62f367ff
Cap:SERIAL_XON_XOFF:0
Cap:BINARY_FILE_TRANSFER:0
Cap:EEPROM:0
Cap:VOLUMETRIC:1
Cap:AUTOREPORT_TEMP:1
Cap:PROGRESS:0
Cap:PRINT_JOB:1
Cap:AUTOLEVEL:0
Cap:Z_PROBE:0
Cap:LEVELING_DATA:0
Cap:BUILD_PERCENT:0
Cap:SOFTWARE_POWER:0
Cap:TOGGLE_LIGHTS:0
Cap:CASE_LIGHT_BRIGHTNESS:0
Cap:EMERGENCY_PARSER:0
Cap:PROMPT_SUPPORT:0
Cap:SDCARD:0
Cap:AUTOREPORT_SD_STATUS:0
Cap:LONG_FILENAME:0
Cap:THERMAL_PROTECTION:1
Cap:MOTION_MODES:0
Cap:ARCS:1
Cap:BABYSTEPPING:0
Cap:CHAMBER_TEMPERATURE:0

haley0918, 2020-07-06:
@makerbase-mks  there is something can reply on pronterface, but lcd still stuck at "boot".

haley0918, 2020-07-06:
I can see Marlin on lcd now. Maybe something went wrong when I first update and bootloader somehow "memorized" the card. Subsequent attempts with the same card would not update, no matter which firmware.

But changing to another sd card maybe cleared something in the bootloader and update could run again. Previous card could now also be used again for update.

I can now start compiling Marlin from official source to try. Making sure to include the right lcd driver in Configuration.h as @fadlio said.

Thanks.

jalius, 2020-09-03:
Hi. I have the same problem. Stuck at boot screen after installing Marlin without LCD driver. I can send commands to the printer with pronterface and get a reply. Can I reset the board to accept new bin file? I tried 2 different TF/SD cards, no luck.

>>> M122
SENDING:M122
echo:Unknown command: "M122"
>>> M503
SENDING:M503
echo:  G21    ; Units in mm (mm)
echo:; Filament settings: Disabled
echo:  M200 S0 D1.75
echo:; Steps per unit:
echo: M92 X80.00 Y80.00 Z4000.00 E500.00
echo:; Maximum feedrates (units/s):
echo:  M203 X300.00 Y300.00 Z5.00 E25.00
echo:; Maximum Acceleration (units/s2):
echo:  M201 X3000.00 Y3000.00 Z100.00 E10000.00
echo:; Acceleration (units/s2): P<print_accel> R<retract_accel> T<travel_accel>
echo:  M204 P3000.00 R3000.00 T3000.00
echo:; Advanced: B<min_segment_time_us> S<min_feedrate> T<min_travel_feedrate> J<junc_dev>
echo:  M205 B20000.00 S0.00 T0.00 J0.01
echo:; Home offset:
echo:  M206 X0.00 Y0.00 Z0.00
echo:; PID settings:
echo:  M301 P22.20 I1.08 D114.00
>>> M115
SENDING:M115
FIRMWARE_NAME:Marlin bugfix-2.0.x (Sep  2 2020 20:39:14) SOURCE_CODE_URL:https://github.com/MarlinFirmware/Marlin PROTOCOL_VERSION:1.0 MACHINE_TYPE:3D Printer EXTRUDER_COUNT:1 UUID:cede2a2f-41a2-4748-9b12-c55c62f367ff
Cap:SERIAL_XON_XOFF:0
Cap:BINARY_FILE_TRANSFER:0
Cap:EEPROM:0
Cap:VOLUMETRIC:1
Cap:AUTOREPORT_TEMP:1
Cap:PROGRESS:0
Cap:PRINT_JOB:1
Cap:AUTOLEVEL:0
Cap:RUNOUT:0
Cap:Z_PROBE:0
Cap:LEVELING_DATA:0
Cap:BUILD_PERCENT:0
Cap:SOFTWARE_POWER:0
Cap:TOGGLE_LIGHTS:0
Cap:CASE_LIGHT_BRIGHTNESS:0
Cap:EMERGENCY_PARSER:0
Cap:PROMPT_SUPPORT:0
Cap:SDCARD:0
Cap:AUTOREPORT_SD_STATUS:0
Cap:LONG_FILENAME:0
Cap:THERMAL_PROTECTION:1
Cap:MOTION_MODES:0
Cap:ARCS:1
Cap:BABYSTEPPING:0
Cap:CHAMBER_TEMPERATURE:0

jalius, 2020-09-08:
Ok I just had to wait for something on the board to change/clear and the issue resolved itself. Now when I go to update the firmware with SD card it works fine. This time I made sure to enable the LCD on my ender 3 by un-commenting `#define REPRAP_DISCOUNT_FULL_GRAPHIC_SMART_CONTROLLER` in `configuration.h` as provided above. Works great, thank you.

Closed 2020-07-06.

Thread 22 (2020-07-03):

trying to add neopixel

jechs83, 2020-07-03:
i use the last  bin updated with neopixel fuctions added buy doesnt work.
i connnecta the stripe correctly but it doesnt work, i try to copile by my self using PA2 Pin but nothing
Does anyone try it succescfully?

makerbase-mks, 2020-07-04:
You can refer to wiki about Neopixel light: https://github.com/makerbase-mks/MKS-Robin-E3-E3D/wiki/Upgrade-with-Neopixel-lights

hieppo, 2021-06-07:
Hi,
Please update your wiki page to reflect the updated source code. I have read the wiki as indicated above but I could not find any reference mentioned in the page in the platformio.ini file. I am using the file in the MKS-Robin-E3-E3D path as suggested. Since the file looks different. I am not sure what is need to compile the neopixel.
Could you please use the updated files as reference to indicate the actual changes?

On another note, would anyone know if it is possible just to use the Neopixel pin as a switch to turn on/off a simple LED strip without any fancy brightness and such features?

Closed 2020-08-05.

Thread 23 (2020-07-05):

Can't change colors with gcode with neopixel firmware

jechs83, 2020-07-05:
I can't control colors with gcode , and it start led strip white color and stay that color

The last upload firmware neopixel
 HD-V1_003 Marlin2.0.1_20200515

makerbase-mks, 2020-07-06:
Can you refer to Robin E3-E3D Wiki? I has a tutorial about how to use neopixel light strip.

makerbase-mks, 2020-07-06:
Can you provide and you buy light strip link? I need check it use drive and power and so on? Because board's interface use 5V power and light strip has WS2812B or other adafruit Neopixel LED driver.

Closed 2020-08-11.

Thread 26 (2020-07-27):

Conexion mks robin e3d y sensor inductivo

tolapoto, 2020-07-27:
Donde se debe de conectar correctamente el sensor inductivo en la plana robin e3d para no perder el final de carrera del eje z?

makerbase-mks, 2020-08-05:
Sorry, can you describe it more clearly?

hanger13, 2020-09-11:
Como conectar Sensor SN04 e como configurar no Marlin.

makerbase-mks, 2020-09-14:
1、SN04, you need use NPN type
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

tolapoto, 2020-09-14:
Gracias, lo he conseguido. Gracias a todos

Emeale2021, 2023-03-31:
Ola, estou tentando instalar o senr indutivo na MKS Robin e3d, gostaria de saber qual pino conectar conectar

Emeale2021, 2023-03-31:
Hello, I am trying to install the inductive senr on the MKS Robin e3d, I would like to know which pin to connect to

Closed 2020-09-14.

Thread 27 (2020-08-04):

Robin_E3D-doesn't_update

TxasMan3D, 2020-08-04:
Robin_E3D+tft35 v1.0
Using VSCode to generate an updated Robin_e3.bin file.
I save it in the MicroSD card and put it in the TF slot of the motherboard.
When I repower the printer, board doesn't update with new file
Looks like the eeprom is disabled but, how can i enable it without comunication with the board?

makerbase-mks, 2020-08-05:
You can try to change TF card or format it. Can you provide your motherboard updating picture?

TxasMan3D, 2020-08-06:
I have used two different TF cards and my pc has no problems to read them. Yes, of course. I will send you by email the whole folder with the updated firmware.

TxasMan3D, 2020-08-06:
Due to the size of the folder i can’t send it so i send you the updated “firmware.bin” file that is located in .pio/build/mks_robin_e3. The name of the file was changed to “Robin_e3.bin”.

Enviado desde Correo<https://go.microsoft.com/fwlink/?LinkId=550986> para Windows 10

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

makerbase-mks, 2020-08-06:
No! You need copy Robin_e3.bin file to tf card, doesn't firmware.bin rename Robin_e3.bin
You can download MKS Robin E3-E3D path Robin_e3.bin file update

TxasMan3D, 2020-08-06:
I had downloaded that one also but i have a bmg extruder fitted and i changed the steps in the firmware to get them saved in the motherboard, otherwise my problem has been fixed. I thought that the file that need to be copied was firmware.bin. I have try with the Robin_e3 one and looks like it has been read. Thank you!

Closed 2020-08-06.

Thread 28 (2020-08-06):

When power on they said on the screen boot and cant flash the firmware

OverRevenge, 2020-08-06:
hello im trying flash the firmware as following the instruction on this link https://github.com/makerbase-mks/MKS-Robin-E3-E3D/tree/master/firmware/firmware%20bin%20for%20Ender3(TMC2209) but when i try to power on this not do nothing only one bip .

OverRevenge, 2020-08-06:
fixed was the bltouch

Closed 2020-08-06.

Thread 30 (2020-08-24):

bigthreetech tft24 não funciona na MKs Robin e3d. help

hanger13, 2020-08-24:
Tenho uma mks Robin e3d comprei um bigthreetech tft24 v1.2 . Porém não consigo por pra funcionar pela porta auxiliar 1 (aux1) apresentando o erro printer nota atached. Já mudei o baud rat para todos os valores e nada. Alguém na mesma situação?

makerbase-mks, 2020-08-25:
Hi! You need to do the following：
1、Connect TFT to Robin E3D, Must be correct
2、#define SERIAL_PORT -1 and #define SERIAL_PORT_2 1 ， #define BAUDRATE 250000
3、TFT baud rate must same as motherboard

hanger13, 2020-08-27:
tentei de tudo, nem via usb conecta.

makerbase-mks, 2020-08-28:
Usually only these three settings are needed to work normally. I think you need to confirm the TFT to AUX-1 wiring.

hanger13, 2020-08-28:
Confirmado. Os pinos do RX tx sao normalmente invertidos na mks Robin. Será que a placa está com problemas? Em curto Os pinos RX tx ?

makerbase-mks, 2020-08-28:
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

hanger13, 2020-08-28:
Essa é boa exata conexão que estou usando.mesmo assim não conecta de jeito nenhum. "Nenhuma impressora encontrar." Não movimenta nenhum eixo não habilita nenhuma saída de fan, hot end , mesa... Enfim não funciona.

makerbase-mks, 2020-08-28:
Can you provide your configuration.h file to me?

hanger13, 2020-09-05:
pinos rx tx em curto.vou adquirir outra placa

makerbase-mks, 2020-09-05:
You TFT？

hanger13, 2020-09-05:
Sim Meu TFT.Em 5 de set de 2020 08:31, makerbase <notifications@github.com> escreveu:

You TFT？

—You are receiving this because you authored the thread.Reply to this email directly, view it on GitHub, or unsubscribe.

makerbase-mks, 2020-09-07:
I will colse this problem.

Closed 2020-09-07.

Thread 31 (2020-08-27):

Requesting for Robin E3 firmware with bootloader.

livemeatz, 2020-08-27:
I have bricked my board due to using a corrupted TFcard.
Please provide a stock firmware for Robin E3 board which includes a **_bootloader_**,
so that i can reprogram the STM32 chipset via ST-Link V2 programmer card thru ST-Link Utility program.
Your help is greatly appreciated.

makerbase-mks, 2020-08-28:
Hi! You can refer to :https://github.com/makerbase-mks/MKS-Robin-E3-E3D/tree/master/firmware/Bootloader
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

livemeatz, 2020-08-29:
I tried to run the given .hex firmware to no avail. Can you advice me on the programmer (may not be ST-Link V2) and re-flashing procedures..

makerbase-mks, 2020-08-31:
Use J-link tools and Jflash software tools

makerbase-mks, 2020-09-09:
Can you download it to your motherboard and go to run?

livemeatz, 2020-09-11:
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

Unable to load file.
Could not execute task.
Could not program and verify target

makerbase-mks, 2020-09-14:
You need Unsecure chip and download it
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

livemeatz, 2020-09-15:
Successfully managed to program the stm32 chipset using STLink method (STlinkV2 doggle + software) and flash+verify the firmware using the provided mks_e3_hex file.

However, the TF card issue still persist as the board does not recognise all the Robin_e3.bin files from the provided github "firmware" folder (the Robin_e3.bin does not change its filename and running M115 & M503 shows the unchanged default settings). I tried other micro SD cards, 2GB, 16GB, 64GB partitioned/formatted with FAT32, to no avail.

Is there any possibility of me to update the board's firmware thru STLink (wired) method ?

makerbase-mks, 2020-09-16:
Of course, you can.

livemeatz, 2020-09-20:
Problem solved with the new bootloader hex that was recently uploaded. Able to read microSD card, SanDisk 16GB (partitioned @ 4096MB ;default ). Have yet to try wired firmware upload thru ST-LinkV2 or JLink. Thank you very much.

Seelenkind, 2021-02-10:
> Successfully managed to program the stm32 chipset using STLink method (STlinkV2 doggle + software) and flash+verify the firmware using the provided mks_e3_hex file.
Hello, I would like to upload the bootloader for the MKS Robin E3 without a beep. But I can't get into programming mode with J-Flash.
Can you upload the bootloader with the ST-Link dongle without having to change anything on the circuit board?
Did you use the dongle to flash the bootloader or to flash the firmware?
How To Connect to Board ?

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

livemeatz, 2021-02-10:
Hello...

Please excuse me.
I used the method from this youtube video

[https://www.youtube.com/watch?v=7O_ZOdnM0SU](url)

and connecting the stlink doggle to the 5 pins of E3 board.

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

livemeatz, 2021-02-10:
Closed.

jesterhead82, 2021-04-20:
For Reference to others:

Purchased 3 (!) e3d boards V1.1, all of them did not boot.
None of them accepted firmware update through SD Card.

Purchased cheap ST-LINK V2 Adapter (be careful, some have wrong pinout printed on them), connected it to the board (like livemeatz) using the 5 Pins.

Flashed bootlader from Normal version, flashed own compiled Marlin via ST-Link (Board did not accept any of the provided firmwares on the github via SD card, and board stopped during booting with precomiled Ender3 Version on the Github).
Like mks-wrote you need to set starting adress  0x08005000, i flashed then the firmware.bin from my marlin comiplation (not the robin_e3.bin)

thaers3d, 2021-12-02:
this board have problem , is not accepting firmware .
and the company stop selling it on aliexpress.
they know it have a problem and just they sold there stock to us.
very bad company.

Closed 2021-02-10.

Thread 32 (2020-08-31):

TMC Connection error

moritzraphael, 2020-08-31:
I have the TMC 2225 Drivers and I get every time a TMC connection error.

makerbase-mks, 2020-09-01:
1. Configuration.h file: Setting driver type is TMC2208, becase TMC2225 is same as TMC2208;
2. You need setting motherboard as use uart mode
3. You need use DC12/24V power input

moritzraphael, 2020-09-01:
How can I get the Configuration.h file on to the board?

makerbase-mks, 2020-09-04:
You can download MKS Robin E3-E3D path Robin_e3.bin file and copy it to tf card update it, and use DC12/24V power input. This firmware can be used normally.

makerbase-mks, 2020-09-05:
@moritzraphael
It‘s solved?

moritzraphael, 2020-09-05:
Yes, thank you for helping.

Closed 2020-09-04.

Thread 33 (2020-09-05):

3D touch failure

bymanue, 2020-09-05:
Good afternoon
I have a problem with 3d touch, it is connected without problems to the printer.
At the time of doing the test it goes down a first time and it does not fail, but it repeats a second time slower and it fails me randomly at that point. It is connected to the Z limit switch. I have tried the default firm that comes in Github MKS for cr 10 and it also gives me errors. Thank you

makerbase-mks, 2020-09-07:
MKS Robin E3-E3D path Robin_e3.bin file have not config 3D TOUCH function, you need download source code and setting and build, about config 3D TOUCH, you can refer to Wiki :https://github.com/makerbase-mks/MKS-Robin-E3-E3D/wiki/3D_TOUCH

KiZDGGit, 2020-09-07:
Same here. G29 sometimes finishes fine, but other fails and doesn't stop at the second down, so it's very erratic and completely unusable.

> MKS Robin E3-E3D path Robin_e3.bin file have not config 3D TOUCH function, you need download source code and setting and build, about config 3D TOUCH, you can refer to Wiki :https://github.com/makerbase-mks/MKS-Robin-E3-E3D/wiki/3D_TOUCH

If fails at second time, I suppose it's not "stock" firmware; mine is not.

Any idea?

makerbase-mks, 2020-09-17:
Can you upload config file?

bymanue, 2020-09-17:
KiZD is my neighbour, he is at work now; we've been using the same settings (and same troubles)

[2. With BLTouch on PB1 and FilamentRunoutSensor.zip](https://github.com/makerbase-mks/MKS-Robin-E3-E3D/files/5241060/2.With.BLTouch.on.PB1.and.FilamentRunoutSensor.zip)

thank you

bymanue, 2020-10-01:
[Configuration.txt](https://github.com/makerbase-mks/MKS-Robin-E3-E3D/files/5314393/Configuration.txt)
[Configuration_adv.txt](https://github.com/makerbase-mks/MKS-Robin-E3-E3D/files/5314395/Configuration_adv.txt)

makerbase-mks, 2020-10-09:
You can refer to branch: https://github.com/makerbase-mks/MKS-Robin-E3-E3D/tree/ender3-3d-touch

Closed 2021-02-22.

Thread 34 (2020-09-11):

End stops mks  com 3 fios como conectar e configurar.

hanger13, 2020-09-11:
Preciso de ajuda como configurar e como conectar os end stops mks de 3 fios.

makerbase-mks, 2020-09-14:
Can you provide picture about your end stops?
1. end stops V connect motherboard’s 5V
2. end stops G connect motherboard's GND
3. end stops S connect motherboard's S

Closed 2020-10-14.

Thread 36 (2020-09-30):

3d touch and neopixels

almir984, 2020-09-30:
I have successfully installed 3d touch but now I am struggling to make neopixels to work.. I'm using marlin 2.0.6.. on mks robin e3

mustafadh12, 2020-10-01:
can you please share your files, im having trouble on bl touch

makerbase-mks, 2020-10-06:
We will upload it

makerbase-mks, 2020-10-09:
3D TOUCH: https://github.com/makerbase-mks/MKS-Robin-E3-E3D/tree/ender3-3d-touch

LearnIIBurn, 2020-10-15:
Trying to compile with Neopixel active on PA2 pin results in:

`#error "NEOPIXEL_LED (Adafruit NeoPixel) is not supported for HAL/STM32F1. Comment out this line to proceed at your own risk!"`

That is with MKS Adafruit Neopixel library added in platformio.ini as a `lib_deps` for MKS Robin E3

I could very well have done that wrong but I'm thinking it should have worked ok.

gurues, 2020-11-07:
I have modified marlin as you indicate in the help: https://github.com/makerbase-mks/MKS-Robin-E3-E3D/wiki/Upgrade-with-Neopixel-lights.
Built only with platformio.ini is OK but built with platformio.ini and configuration.h (neopixel) error.
 Compiling .pio\build\mks_robin_e3\src\src\HAL\STM32F1\SPI.cpp.o
In file included from Marlin\src\HAL\STM32F1\../../inc/MarlinConfig.h:50:0,
                 from Marlin\src\HAL\STM32F1\HAL.cpp:30:
Marlin\src\HAL\STM32F1\../../inc/../HAL/STM32F1/inc/SanityCheck.h:52:4: error: #error "NEOPIXEL_LED (Adafruit NeoPixel) is not supported for HAL/STM32F1. Comment out this line to proceed at your own risk!"
   #error "NEOPIXEL_LED (Adafruit NeoPixel) is not supported for HAL/STM32F1. Comment out this line to proceed at your own risk!"

modified in configuration.h:

// Support for Adafruit NeoPixel LED driver
#define NEOPIXEL_LED  // gurues control led
#if ENABLED(NEOPIXEL_LED)
  #define NEOPIXEL_TYPE   NEO_GRB // NEO_GRBW / NEO_GRB - four/three channel driver type (defined in Adafruit_NeoPixel.h)
  #define NEOPIXEL_PIN     PA2       // LED driving pin
  //#define NEOPIXEL2_TYPE NEOPIXEL_TYPE
  //#define NEOPIXEL2_PIN    5
  #define NEOPIXEL_PIXELS 30       // Number of LEDs in the strip. (Longest strip when NEOPIXEL2_SEPARATE is disabled.)
  #define NEOPIXEL_IS_SEQUENTIAL   // Sequential display for temperature change - LED by LED. Disable to change all LEDs at once.
  #define NEOPIXEL_BRIGHTNESS 127  // Initial brightness (0-255)
  //#define NEOPIXEL_STARTUP_TEST  // Cycle through colors at startup

  // Support for second Adafruit NeoPixel LED driver controlled with M150 S1 ...
  //#define NEOPIXEL2_SEPARATE
  #if ENABLED(NEOPIXEL2_SEPARATE)
    #define NEOPIXEL2_PIXELS      15  // Number of LEDs in the second strip
    #define NEOPIXEL2_BRIGHTNESS 127  // Initial brightness (0-255)
    #define NEOPIXEL2_STARTUP_TEST    // Cycle through colors at startup
  #else
    //#define NEOPIXEL2_INSERIES      // Default behavior is NeoPixel 2 in parallel
  #endif

Help me please

DocYester, 2021-05-03:
Comment out the mentioned line in SanityCheck.h

Check your platformio.ini for :

```
#
# MKS Robin E3D (STM32F103RCT6) and
# MKS Robin E3 with TMC2209
#
[env:mks_robin_e3]
platform      = ${common_stm32f1.platform}
extends       = common_stm32f1
board         = genericSTM32F103RC
platform_packages = tool-stm32duino
extra_scripts = ${common.extra_scripts}
  buildroot/share/PlatformIO/scripts/mks_robin_e3.py
build_flags   = ${common_stm32f1.build_flags}
  -DDEBUG_LEVEL=0 -DSS_TIMER=4

```
and add

```custom_marlin.NEOPIXEL_LED = Adafruit NeoPixel=https://github.com/ellensp/Adafruit_NeoPixel```

Configure the Neopixel as desired in Configuration.h

Closed 2021-08-02.

Thread 37 (2020-10-01):

Activating Bltouch Support rom problem

azzell, 2020-10-01:
Hi
When I try activating bltouch support and babystepping on your version of marlin i get an error of not enough rom memory:
c:/users/user/.platformio/packages/toolchain-gccarmnoneeabi/bin/../lib/gcc/arm-none-eabi/7.2.1/../../../../arm-none-eabi/bin/ld.exe: .pio\build\mks_robin_e3\firmware.elf section `.rodata' will not fit in region `rom'
c:/users/user/.platformio/packages/toolchain-gccarmnoneeabi/bin/../lib/gcc/arm-none-eabi/7.2.1/../../../../arm-none-eabi/bin/ld.exe: region `rom'
overflowed by 1140 bytes256kb
collect2.exe: error: ld returned 1 exit status
*** [.pio\build\mks_robin_e3\firmware.elf] Error 1

Way around it was to disable  M503 but u would like to save this function is this board really has only 256 kb of rom storage?

makerbase-mks, 2020-10-06:
MKS Robin E3, E3D CUP is STM32F103RCT6, so ROM/RAM is 256KB/48KB

Closed 2020-10-16.

Thread 38 (2020-10-05):

BL Touch Connection and Update Error

mustafadh12, 2020-10-05:
First,
https://www.youtube.com/watch?v=_x1TzdqGZdo at 02:20 is the connection scheme for BL TOUCH on MKS E3D.
https://www.youtube.com/watch?v=r2A0b7XQEaI&t=1s 04:09 is the OTHER connection scheme for BL Touch on MKS E3D.

These  videos are not useful and make everything complicating.

Second,
I've tried both, updated marlin tried everything but nothing worked fine. Now update stucks at 100% . I'm uploading my files for anyone open for helping.

Third, dear MKS Team, please upload a file for BL TOUCH for your [boards.](url
[Marlin-2.0.x.zip](https://github.com/makerbase-mks/MKS-Robin-E3-E3D/files/5326741/Marlin-2.0.x.zip)

)

Indigo-Tech, 2020-10-07:
same here, just got the board with 3d touch sensor yesterday

I tried compiling the clean version without changes to config files and it still get stuck on 100%, only the bin file that is provided with the repo is working

Indigo-Tech, 2020-10-08:
@mustafadh12 I got by mkr board with 3d touch 2 days ago, installed and encountered the same problem when flushing the firmware the loader stuck at 100%.
so I been looking at the code and found out that I taken the wrong file the output of the compilation is 3 files firmware.bin, firmware.something and the last and the one we need is "Robin_e3.bin", once you take this one this should work as expected,
I recommend not using this repository as it full of mistakes and what not

Here is a fast guide using the official Marlin repo:

- Clone [Marlin repo](https://github.com/MarlinFirmware/Marlin) and [Marlin Configurations repo](https://github.com/MarlinFirmware/Configurations)

- Under Configurations you will find mks e3 for ender 3 example config files take them and replace the ones under Marlin repo

- Use [this video] (https://www.youtube.com/watch?v=7le9L2LMY-U&ab_channel=Crosslink) to configure bltouch

Thats it you ready to go

makerbase-mks, 2020-10-09:
Hi! you can refer to : https://github.com/makerbase-mks/MKS-Robin-E3-E3D/tree/ender3-3d-touch

mustafadh12, 2020-10-12:
Thank you guys I've finally made it. But here is another problem. When i hit the level bed command, it only probes 1 point and sometimes it goes up instead of going down and probing the point. So that i cant level the bed. Auto home command works but bed leveling still having some bugs. What can i do?

Indigo-Tech, 2020-10-12:
What firmware are you using? Please attach version of the firnware and
configure files

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

mustafadh12, 2020-10-12:
I've attached the config and the other files. Now when I send level bed, it goes for probing the first point, it goes up instead of downwards to the bed! Than it store the settings in this way.
[marlin2.0 for Ender3.zip](https://github.com/makerbase-mks/MKS-Robin-E3-E3D/files/5363678/marlin2.0.for.Ender3.zip)

makerbase-mks, 2020-10-12:
I want to know, the motherboard wiring is correct?

mustafadh12, 2020-10-12:
It is correct otherwise autohome command shouldn't act downwards. It works properly but level bed command doesnt works fine.

Indigo-Tech, 2020-10-12:
@mustafadh12 I will check later today the diffs between my config and yours .

But as I wrote earlier you better be using official marlin config files, the ones under this repo isn't correct, or confusing.

mustafadh12, 2020-10-12:
I've tried that but it stops and holds at %100 update rate.

Indigo-Tech, 2020-10-13:
@mustafadh12 after you compile what exactly you do? I guess you just take the wrong file

mks-viva, 2020-10-14:
@mustafadh12 If yourself build it and update it, it's work?
About your feedback, we will test it.

mustafadh12, 2020-10-14:
> after you compile what exactly you do? I guess you just take the wrong file, in order to help you I need as much information as possible like what version of platformio you use, what files you copy to where, how you compile the project?

I just put robin_e3.bin file to the sd card, turn on the power supply for the printer and update it as everyone do.

mustafadh12, 2020-10-14:
> @mustafadh12 If yourself build it and update it, it's work?
> About your feedback, we will test it.

As i said it works for the auto home command. Unfortunately, level bed command goes for the first probing point and goes upwards instead of probing.

mks-viva, 2020-10-14:
@

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

But i test is OK. Can you format the TF card and then update the firmware?

mustafadh12, 2020-10-14:
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

Done it still the same problem unfortunately.

mks-viva, 2020-10-14:
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

3D TOUCH's Z probe connect to motherboard's E-STOP/PROBE interface, machine's Z-limit connect to Z-STOP like this:
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

mustafadh12, 2020-10-14:
First of all it can be wired like this
 https://www.youtube.com/watch?v=_x1TzdqGZdo at 02:20

Now I've wired like the way you said, defined Z_MIN_PROBE_PIN PB1 also, but still the same problem.

It auto homes, but while leveling bed at the first point it goes upwards and stops.

mustafadh12, 2020-10-20:
any comments? @makerbase-mks @mks-viva

mks-viva, 2020-10-22:
I can't see any difference from the picture. Can you Inital EEPROM: LCD->Configuration->Restore Defaults and after Load Settings

mustafadh12, 2020-10-22:
> I can't see any difference from the picture. Can you Inital EEPROM: LCD->Configuration->Restore Defaults and after Load Settings

I've done it. It probed the first point of other 9 than stopped probbing and said printer is ready.

mks-viva, 2020-10-22:
Does it work properly?

mustafadh12, 2020-10-22:
When I restore settings, it only probes the first point. Than it stores that settings. After that when i command level bed, it starts to go upwards for probing the first point like on the video.

mustafadh12, 2020-11-05:
I'm still waiting for a response please. @makerbase-mks @mks-viva

mks-viva, 2020-11-05:
> I'm still waiting for a response please. @makerbase-mks @mks-viva

We will install 3d touch and test this firmware again, and shoot the leveling video

mks-viva, 2020-12-11:
I has upload 3d touch firmware to here, you can refer to it and you need set borad is BOARD_MKS_ROBIN_E3
https://github.com/makerbase-mks/MKS-Robin-E3-E3D/tree/master/firmware/V1.1

Closed 2021-04-27.

Thread 40 (2020-10-09):

Fan is always on...

piberry, 2020-10-09:
Hi!
I installed the board a few days ago. Unfortunately the fan is not controllable (always on) which is not a firmware problem. What part do i need to replace? If the fan was dead, i would replace Q3...
I can solder pretty well but i´m not an electronic engineer. I would be glad if someone could help me out.

Thanks!

makerbase-mks, 2020-10-10:
About Q3, i suggest you use AO3400

Closed 2020-10-15.

Thread 41 (2020-10-15):

impossible to update firmware

Valoliin, 2020-10-15:
hello I'm trying to update my firmware but this is impossible the file on the sd card is not renamed.

I use the marlin firmware which is in the github

on the sd card at the root I put the file robin_e3.bin

I tested with a 1GB sd card and an 8GB one and another 16GB

I tried to format the sd card to FAT32, FAT16, EXFAT, NTFS

mks-viva, 2020-10-16:
The name should be Robin_e3.bin, you need to pay attention to case.

Valoliin, 2020-10-16:
use 1GB sd card  format fat16

Closed 2020-10-16.

Thread 43 (2020-10-29):

mks robin e3d can not flash and no boot

RutaHunter, 2020-10-29:
Hi. I bought the mks robin e3d board. Downloaded the firmware https://github.com/makerbase-mks/MKS-Robin-E3-E3D/blob/ender3-3d-touch/firmware/marlin2.0.x%20bin/Robin_e3_TMC2209.bin, renamed Robin_e3.bin, copy to micro sd and inserted it into the board, turned on the power and no reaction. The blue diode is on and that's it, and there are 2 stripes on the screen. Without a flash drive, the board behaves the same way and does not boot. The bootloader may have broken? How to fix?

mks-viva, 2020-10-30:
Can you provide picture about no boot ?

RutaHunter, 2020-10-30:
[Looks]
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
like this all the time. No movement

mks-viva, 2020-10-31:
Hi! The 'boot' will be display only when you use LCD12864 or MKS LCD12864B, so, if you use LCD2004 and it's no display, because bootloader have not LCD2004 display.

RutaHunter, 2020-10-31:
I know lcd2004 doesn't fit. My 12864b broke and until a new one came, I connected lcd2004. I think that in lcd2004 there should also be some movements when executing code in the processor. I know that when the code runs, the red led near the fan connector blink. And in case of successful firmware, the file on the flash card changes the extension to *.cur, but this also does not happen. I have flashed the processor via usart1.

mks-viva, 2020-11-02:
@RutaHunter
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

RutaHunter, 2020-11-03:
Flashing the bootloader didn't help either. Maybe I'm stitching it wrong somehow? Can there be any instructions for the firmware if the firmware does not work with the micro sd?

mks-viva, 2020-11-03:
Can you provide your download bootloader procedure？I will check it.

RutaHunter, 2020-11-03:
Pin boot0 (60) to 3.3v, connect UART to USART1, run STM Flash Loader Demonstrator
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
Connect pin boot0 (60) to GND and restart device, but nothing

mks-viva, 2020-11-05:
It seems everything is normal during the burning process

RutaHunter, 2020-11-05:
Any ideas?

mks-viva, 2020-11-05:
I need test it and i will use this flash process and check it work.

mks-viva, 2020-11-05:
I test it and it's work and i use this flash process. So, i think your board 3.3V short to GND, because Boot0 has connect to gnd diretly, you need disconnect it

RutaHunter, 2020-11-05:
Again flash bootloader, disconnect boot 0 from board, insert micro sd with firmware and turned on power, but same

sl1pkn07, 2020-11-05:
> connect UART to USART1

how?

greetings

mks-viva, 2020-11-06:
You need use STM32 PA9-TX1,PA10-RX1(AUX-1 interface)

RutaHunter, 2020-11-06:
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

I did exactly that, but the program in the processor does not start.

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

mks-viva, 2020-11-06:
Needn't use STLink, just use a simple USB to serial port module, like this:
[Robin e3 use STMFlashLoader Demo.zip](https://github.com/makerbase-mks/MKS-Robin-E3-E3D/files/5499499/Robin.e3.use.STMFlashLoader.Demo.zip)
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

RutaHunter, 2020-11-06:
I wrote that the processor reads and writes well. It doesn't run the program.

mks-viva, 2020-11-07:
> I wrote that the processor reads and writes well. It doesn't run the program.

When you use boot0 to connect to 3.3V, be sure to disconnect boot0 and GND. If you don’t do this, I have to suspect that the chip is damaged, because your subsequent steps don’t seem to have any problems.

RutaHunter, 2020-11-14:
Hi. I take my 12864lcd/ If i flash to processor this bootloader https://github.com/makerbase-mks/MKS-Robin-E3-E3D/blob/ender3-3d-touch/firmware/Bootloader/MKS%20Robin%20E3_E3D%20TEST.hex then the screen says "boot" and the speaker beeps.
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

if I flash something else, then only the backlight is on on the screen and nothing happens
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

mks-viva, 2020-11-17:
You can flash MKS Robin E3_E3D TEST.hex and this hex file include bootloader, and after, you can update Robin_e3.bin file.

RutaHunter, 2020-11-19:
>
>
> You can flash MKS Robin E3_E3D TEST.hex and this hex file include bootloader, and after, you can update Robin_e3.bin file.

It did not help

mks-viva, 2020-11-23:
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
If this can be started normally, I think it's working ok.

mks-viva, 2020-12-11:
I will close this question temporarily.

ostapoff, 2021-03-23:
I have the same issue with my MKS Robin e3d and MKS LCD12864B.

This is how it boots up: https://youtu.be/nOsbkkQBBko

This is how it handles the firmware update: https://youtu.be/mu0gxG2ySPE

Sometimes it is possible to make it start working by inserting an xd card but it works very rarely. And if it works the contrast is too low though it is set to 205. When I get into the corresponding menu the contrast of the screen gets magically repaired: https://youtu.be/z7TEHHgfpps

Also when I attach a screen from the Ender-3 it works like a charm via ext1+ext2 as well as via ext3: https://youtu.be/eUXtF-SC6lw

Of course for the Ender's screen I use **#define REPRAP_DISCOUNT_FULL_GRAPHIC_SMART_CONTROLLER**  and for the MKS LCD12864B the **#define MKS_LCD12864**

Closed 2020-12-11.

Thread 44 (2020-10-30):

board doesnt response after flashing

2tata, 2020-10-30:
I have a Robin E3 board and wenn I compile https://github.com/makerbase-mks/MKS-Robin-E3-E3D/tree/ender3-3d-touch/firmware/marlin2.0%20for%20Ender3 and continiure flashig the board does not response on serial.

Using Pronterface for testing purpose.

mks-viva, 2020-10-31:
1. You need check COM on PC
2. You need connect motherboard use pronterface by COM and burdrate default is 250000

2tata, 2020-10-31:
> 1. You need check COM on PC
> 2. You need connect motherboard use pronterface by COM and burdrate default is 250000

sorry I was not clearly enough. I already use the stock firmware which works good. But a new compiled firmware did not response. On the tty interface. I also try flashing via wire with JFlash but this software seems not working prober. I tried flashing over wire because the board can only handle SD card in a limited way. Means max size of 4GB or less and fat16 FS. It was not that easy to get an micro SDcard <=4GB.

mks-viva, 2020-10-31:
If you has connect motherboard to PC, it is will display
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

2tata, 2020-10-31:
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

I just didn't get any response from the board. I think the flashed binary is not working

mks-viva, 2020-10-31:
Can you setting port?
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

2tata, 2020-10-31:
It is already the correct device:
```
tata@floki ~ % lsusb  
Bus 001 Device 002: ID 8087:8001 Intel Corp. Integrated Hub
Bus 001 Device 001: ID 1d6b:0002 Linux Foundation 2.0 root hub
Bus 003 Device 001: ID 1d6b:0003 Linux Foundation 3.0 root hub
Bus 002 Device 003: ID 04ca:703c Lite-On Technology Corp. Integrated Camera
Bus 002 Device 049: ID 17ef:100f Lenovo ThinkPad Ultra Dock Hub
Bus 002 Device 048: ID 1532:0109 Razer USA, Ltd Lycosa Keyboard
Bus 002 Device 050: ID 15d9:0a4d Trust International B.V. Optical Mouse
Bus 002 Device 046: ID 17ef:1010 Lenovo ThinkPad Ultra Dock Hub
Bus 002 Device 062: ID 1a86:7523 QinHeng Electronics CH340 serial converter   <---
Bus 002 Device 001: ID 1d6b:0002 Linux Foundation 2.0 root hub
```

```
[497828.690033] usb 2-1: USB disconnect, device number 62
[497828.690358] ch341-uart ttyUSB0: ch341-uart converter now disconnected from ttyUSB0
[497828.690397] ch341 2-1:1.0: device disconnected
[497831.310571] usb 2-1: new full-speed USB device number 63 using xhci_hcd
[497831.452091] usb 2-1: New USB device found, idVendor=1a86, idProduct=7523, bcdDevice= 2.64
[497831.452100] usb 2-1: New USB device strings: Mfr=0, Product=2, SerialNumber=0
[497831.452103] usb 2-1: Product: USB Serial
[497831.453969] ch341 2-1:1.0: ch341-uart converter detected
[497831.454638] usb 2-1: ch341-uart converter now attached to ttyUSB0
[497831.930000] TCP: request_sock_TCP: Possible SYN flooding on port 34349. Sending cookies.  Check SNMP counters.
```

mks-viva, 2020-10-31:
Bus 002 Device 062: ID 1a86:7523 QinHeng Electronics CH340 serial converter   <---

mks-viva, 2020-10-31:
Have you used a Raspberry Pi?

2tata, 2020-10-31:
> Have you used a Raspberry Pi?

no I haven't. In which way should I use a rpi?

I am working on my desktop system.

mks-viva, 2020-11-02:
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

MKS Robin E3 motherboard's USB driver is CH340, so, you can check it your COM on PC

2tata, 2020-11-02:
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

The serial is not the problem. I already proof this by using the stock firmware. the problem seems to be in the compiled binary.
[firmware.bin.zip](https://github.com/makerbase-mks/MKS-Robin-E3-E3D/files/5474339/firmware.bin.zip)

This binary was compiled out of tho about mentenorid repo.

mks-viva, 2020-11-03:
Oh! You need copy Robin_e3.bin file to TF card and insert motherboard and update it. Is not copy firmware.bin file
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

2tata, 2020-11-03:
> Oh! You need copy Robin_e3.bin file to TF card and insert motherboard and update it. Is not copy firmware.bin file
> 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

Yes, I exactly did how it was described, and I got an CRC file back but still the compiled binary, means the outcoming "firmware.bin" which was renamed to "Robin_e3.bin" seems not working.

mks-viva, 2020-11-03:
You cannot directly use firmware.bin to rename Robin_e3.bin, because these two files are not exactly the same. Robin_e3.bin is transcoded on the basis of firmware.bin

2tata, 2020-11-03:
> You cannot directly use firmware.bin to rename Robin_e3.bin, because these two files are not exactly the same. Robin_e3.bin is transcoded on the basis of firmware.bin

ah, I didnt saw any hint to the transcoding :). How I can do that?

mks-viva, 2020-11-03:
When you compile the firmware, marlin has already done this work, so you only need the cpoy Robin_e3.bin file to update the firmware

2tata, 2020-11-03:
> When you compile the firmware, marlin has already done this work, so you only need the cpoy Robin_e3.bin file to update the firmware

yes, I saw it right before your message. Classical Layer 8 problem ;-P sorry for the noise.

Closed 2020-11-03.

Thread 45 (2020-11-07):

ERROR CONFIGURATION NEOPIXEL

gurues, 2020-11-07:
I have modified marlin as you indicate in the help: https://github.com/makerbase-mks/MKS-Robin-E3-E3D/wiki/Upgrade-with-Neopixel-lights.
Built only with platformio.ini is OK but built with platformio.ini and configuration.h (neopixel) error.
Compiling .pio\build\mks_robin_e3\src\src\HAL\STM32F1\SPI.cpp.o
In file included from Marlin\src\HAL\STM32F1../../inc/MarlinConfig.h:50:0,
from Marlin\src\HAL\STM32F1\HAL.cpp:30:
Marlin\src\HAL\STM32F1../../inc/../HAL/STM32F1/inc/SanityCheck.h:52:4: error: #error "NEOPIXEL_LED (Adafruit NeoPixel) is not supported for HAL/STM32F1. Comment out this line to proceed at your own risk!"
#error "NEOPIXEL_LED (Adafruit NeoPixel) is not supported for HAL/STM32F1. Comment out this line to proceed at your own risk!"

modified in configuration.h:
`// Support for Adafruit NeoPixel LED driver
#define NEOPIXEL_LED  // gurues control led
#if ENABLED(NEOPIXEL_LED)
  #define NEOPIXEL_TYPE   NEO_GRB // NEO_GRBW / NEO_GRB - four/three channel driver type (defined in Adafruit_NeoPixel.h)
  #define NEOPIXEL_PIN     PA2       // LED driving pin
  //#define NEOPIXEL_PIN     4       // LED driving pin
  //#define NEOPIXEL2_TYPE NEOPIXEL_TYPE
  //#define NEOPIXEL2_PIN    5
  #define NEOPIXEL_PIXELS 30       // Number of LEDs in the strip. (Longest strip when NEOPIXEL2_SEPARATE is disabled.)
  #define NEOPIXEL_IS_SEQUENTIAL   // Sequential display for temperature change - LED by LED. Disable to change all LEDs at once.
  #define NEOPIXEL_BRIGHTNESS 127  // Initial brightness (0-255)
  //#define NEOPIXEL_STARTUP_TEST  // Cycle through colors at startup

  // Support for second Adafruit NeoPixel LED driver controlled with M150 S1 ...
  //#define NEOPIXEL2_SEPARATE
  #if ENABLED(NEOPIXEL2_SEPARATE)
    #define NEOPIXEL2_PIXELS      15  // Number of LEDs in the second strip
    #define NEOPIXEL2_BRIGHTNESS 127  // Initial brightness (0-255)
    #define NEOPIXEL2_STARTUP_TEST    // Cycle through colors at startup
  #else
    //#define NEOPIXEL2_INSERIES      // Default behavior is NeoPixel 2 in parallel
  #endif`

Help me please

gurues, 2020-11-08:
I have commented on this line en src/HAL/STM32F1/inc/SanityCheck.h

`#if ENABLED(NEOPIXEL_LED)
  //#error "NEOPIXEL_LED (Adafruit NeoPixel) is not supported for HAL/STM32F1. Comment out this line to proceed at your own risk!"
#endif
`
The build is correct but i am afraid of damaging the board.  Could you tell me if it is correct and I can load the firmware

Library Adafruits Neopixel download of github mks but  i have this advertences:
`
Linking .pio\build\mks_robin_e3\firmware.elf
.pio/build/mks_robin_e3/src/src/feature/leds/leds.cpp.o: In function `LEDLights::setup()':
D:\Oscar\Impresion 3D\Marlin\Marlin 2.0.7.1\Marlin 2.0.7.1 MKS Robin-V6-BMG-BLTouch-Neopixel/Marlin\src\feature\leds/leds.cpp:68: warning: undefined reference to `Marlin_NeoPixel::init()'
.pio/build/mks_robin_e3/src/src/feature/leds/leds.cpp.o: In function `LEDLights::set_color(LEDColor const&, bool)':
D:\Oscar\Impresion 3D\Marlin\Marlin 2.0.7.1\Marlin 2.0.7.1 MKS Robin-V6-BMG-BLTouch-Neopixel/Marlin\src\feature\leds/leds.cpp:102: warning: undefined reference to `Marlin_NeoPixel::set_color(unsigned long)'
Building .pio\build\mks_robin_e3\firmware.bin
.pio/build/mks_robin_e3/src/src/feature/leds/leds.cpp.o: In function `LEDLights::set_color(LEDColor const&, bool)':
Checking size .pio\build\mks_robin_e3\firmware.elf
D:\Oscar\Impresion 3D\Marlin\Marlin 2.0.7.1\Marlin 2.0.7.1 MKS Robin-V6-BMG-BLTouch-Neopixel/Marlin\src\feature\leds/leds.h:95: warning: undefined reference to `Marlin_NeoPixel::adaneo1'
Advanced Memory Usage is available via "PlatformIO Home > Project Inspect"
.pio/build/mks_robin_e3/src/src/feature/leds/printer_event_leds.cpp.o: In function `pel_set_rgb(unsigned char, unsigned char, unsigned char)':
RAM:   [===       ]  27.6% (used 13560 bytes from 49152 bytes)
D:\Oscar\Impresion 3D\Marlin\Marlin 2.0.7.1\Marlin 2.0.7.1 MKS Robin-V6-BMG-BLTouch-Neopixel/Marlin\src\feature\leds/printer_event_leds.cpp:54: warning: undefined reference to `Marlin_NeoPixel::adaneo1'
Flash: [========= ]  88.0% (used 23081.pio/build/mks_robin_e3/src/src/gcode/feature/leds/M150.cpp.o: In function `GcodeSuite::M150()':
2 bytD:\Oscar\Impresion 3D\Marlin\Marlin 2.0.7.1\Marlin 2.0.7.1 MKS Robin-V6-BMG-BLTouch-Neopixel/Marlin\src\gcode\feature\leds/M150.cpp:69: warning: undefined reference to `Marlin_NeoPixel::adaneo1'
es from 262144 bytes)
D:\Oscar\Impresion 3D\Marlin\Marlin 2.0.7.1\Marlin 2.0.7.1 MKS Robin-V6-BMG-BLTouch-Neopixel/Marlin\src\gcode\feature\leds/M150.cpp:69: warning: undefined reference to `Marlin_NeoPixel::neoindex'
encrypt([".pio\build\mks_robin_e3\firmware.bin"], [".pio\build\mks_robin_e3\firmware.elf"])
================================================= [SUCCESS] Took 260.61 seconds =================================================
Environment    Status    Duration
-------------  --------  ------------
mks_robin_e3   SUCCESS   00:04:20.614
`
Conexión - > [https://drive.google.com/file/d/15vXW9niBGBLkNVABRt4TjmetIYwE4iNc/view?usp=sharing](url)

Thanks

DocYester, 2021-05-03:
https://github.com/makerbase-mks/MKS-Robin-E3-E3D/issues/36#issuecomment-831067007

mks-viva, 2021-06-16:
You need add lib link in Robin e3 ini file
custom_marlin.NEOPIXEL_LED = Adafruit NeoPixel=https://github.com/ellensp/Adafruit_NeoPixel
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

mks-viva, 2021-08-03:
The latest version marlin, you can directly define NEOPIXEL_LED and pin

Closed 2021-08-03.

Thread 46 (2020-11-08):

Hello please help me restore factory settings

lcz0210, 2020-11-08:
Firmware flashing, I made a mistake, I want to go back to the motherboard when I bought it

mks_robin_e3. My machine is ender-3 pro

Can you tell me where to download the firmware

mks-viva, 2020-11-09:
You can download it form: https://github.com/makerbase-mks/MKS-Robin-E3-E3D/tree/master/firmware/marlin2.0.6%20bin

lcz0210, 2020-11-09:
老板 你给我发的这个BIN文件 没办法修改里面的参数啊  我需要安装你们家购买的 3Dtouch 和自动关机模块  修改参数才可以使用的
可以给我发一下  可以修改固件的参数的 那个固件吗
-----Original Message-----
From: "mks-viva"<notifications@github.com>
To: "makerbase-mks/MKS-Robin-E3-E3D"<MKS-Robin-E3-E3D@noreply.github.com>;
Cc: "lcz0210"<lcz0210@naver.com>; "Author"<author@noreply.github.com>;
Sent: 2020-11-09 (월) 10:54:04 (GMT+09:00)
Subject: Re: [makerbase-mks/MKS-Robin-E3-E3D] Hello please help me restore factory settings (#46)

You can download it form: https://github.com/makerbase-mks/MKS-Robin-E3-E3D/tree/master/firmware/marlin2.0.6%20bin
—
You are receiving this because you authored the thread.
Reply to this email directly, view it on GitHub, or unsubscribe.

mks-viva, 2020-11-09:
我压缩一个放这里，直接从github下载还是有点慢

lcz0210, 2020-11-09:
非常感谢  困扰我6天的烦恼终于解决了 都想放弃这个板子了

mks-viva, 2020-11-09:
你可以问我们销售人员，也可以直接在这边提问题，下次早点

Ferropluss, 2025-01-17:
Здравствуйте. А есть заводские настройки для QIDI X-MAX3?

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 - моя материнская плата.

Closed 2020-11-09.

Thread 47 (2020-11-10):

Hotend AutoFan

diogoribeiro09, 2020-11-10:
Hi,
Unlike some of the other MKS boards we have no E1 to use as autofan for the hotend fan. Is there any alternative i'm overlooking or is it impossible?

mks-viva, 2020-11-11:
Hi! The motherboard has not reserved, so you can directly use the 12/24V interface to drive the FAN.

Closed 2020-11-17.

Thread 48 (2020-11-11):

Part cooling fan 100% instead of hotend fan

danbrianwhite, 2020-11-11:
On the board compared to ender 3, the part cooling fan is incorrectly always on. The hotend cooling fan is incorrectly tied to the part cooling "fan" plug.

1.) Can this be fixed in firmware?
2.) Will switching the physical plugs and wires result in any issues fr the haedware?

danbrianwhite, 2020-11-12:
🤦‍♂️soldered wrong colors

Closed 2020-11-12.

Thread 49 (2020-11-15):

Firmware for ender 5?

arsene-r2, 2020-11-15:
On the youtube channel, the board is advertised for the Ender 5 as well but theres no firmware for the Ender 5 on here. Can you make a firmware for the Ender 5 please?

mks-viva, 2020-11-17:
Thank you for your feedback, we will deal with it, you can also refer to the link: https://github.com/MarlinFirmware/Configurations/tree/import-2.0.x/config/examples/Creality

Closed 2020-11-20.

Thread 50 (2020-12-05):

Is there support to mount the SDcard on the Robin E3 through USB?

hieppo, 2020-12-05:
I connect the Robin E3 to a Pi and been trying to mount the SDcard on the E3. However, I do not see any device listed. Is the Marlin firmware has support for this feature? Is there a Smoothieware for this board?

mks-viva, 2020-12-05:
Hi! I am very sorry, the current MKS Robin E3 motherboard does not support this function, mainly because the Robin E3 motherboard uses the serial port chip instead of directly using the STM32 virtual serial port function.
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

hieppo, 2020-12-05:
Hmm, disappointed but thanks for the information. I guess I have to pop the sdcard out  each to flash. Is there a flash method using usb?

mks-viva, 2020-12-07:
USB is currently only used to connect to the host computer and cannot perform other functions.

mks-viva, 2020-12-11:
We will improve it in the next version, so stay tuned. I will close this issues

Closed 2020-12-11.

Thread 51 (2020-12-07):

Fillament cooling fan

edvard5, 2020-12-07:
When connected fillament cooling fan BL touch stopped working, when initializing probe, fan LED turns on for half a second and turns of, the probe not extending, auto level not working. Flashed latest software to TFT35 and motherboard itself. Second time this happens, might be due to fan pinout not having and diode to protect from voltage coming back to motherboard as my setup has stepdown voltage module which is working fine. Second board fried I guess... Might be firmware related issue. Maybe someone have the same issue as me. Thanks in advance.

mks-viva, 2020-12-08:
Hi! FAN runs for half a second, this is normal, this is marlin settings
About BLTOUCH or 3D TOUCH, you can refer to firmware: https://github.com/makerbase-mks/MKS-Robin-E3-E3D/tree/master/firmware/V1.1
If you use MKS Robin E3 V1.0 vserion, you need define motherboard is BOARD_MKS_ROBIN_E3 in configuration.h file

mks-viva, 2020-12-11:
If there is no response, then I will temporarily close this issues

Closed 2020-12-11.

Thread 52 (2020-12-10):

Frimeware creality ender 5

Fogs135, 2020-12-10:
Bought e3d board for Ender 5. But no firmware for this printer model.  can you give the firmware for ender 5.

Fogs135, 2020-12-13:
The problem is closed.  Adapted firmware from skr 1.3 for tmc2209 and bltouch.

mks-viva, 2020-12-14:
Can you share the Robin E3D ender5 machine firmware, I will put it on Github, and let more people use it. I will be very grateful.

Fogs135, 2020-12-14:
well within 2-3 working days will send you.

mks-viva, 2020-12-14:
Ok, looking forward to your good news, thank you!

Fogs135, 2020-12-15:
[Marlin-2.0.x.zip](https://github.com/makerbase-mks/MKS-Robin-E3-E3D/files/5697066/Marlin-2.0.x.zip)
I changed my motherboard type. Adapted all axes movements for Ender 5.
The firmware is configured for the TMC 2209 v2.0 driver in the UART.
Bltouch activated with Bilinear.
Russian language.
After installing the firmware, you need to calibrate the position of the Bltouch sensor yourself, as well as the number of steps per mm for the Z axis and Extruder through the printer menu.

mks-viva, 2020-12-16:
Thank you!

azatalp, 2021-02-05:
How can I upgrade my mother board with your files? (ender 5 mks e3)

mks-viva, 2021-02-06:
@azatalp You can download Fogs135's firmware

Closed 2020-12-13.

Thread 53 (2020-12-13):

display tft 2.4 commands does not work via display

diegomsdos, 2020-12-13:
I have an ender 5 printer and I changed the card for robin e3d mks. I have a problem with the fimeware that comes on the card because it is from ender 3. I updated the firmeware for marlin 2.0.7.2 which is the most recent version after that. commands via tft 2.4 no longer works.

note: I used the files config.h and config.adv.h that comes in the marlin examples folder this file was for address 3 I made the inversion of the X and Y axes to be able to make the address 5 is in the correct position

I would like to know which command I have to activate to operate the commands via touch

mks-viva, 2020-12-14:
Can you provide your configuration.h file to me?
1、I think you need set port
#define SERIAL_PORT 1   //Because MKS Robin E3/E3D use STM32 usart1
2、And keep the baud rate the same
#define BAUDRATE 250000

diegomsdos, 2020-12-14:
Thanks, I set BAUDRATE to 250000 and it worked

mks-viva, 2020-12-15:
This is good news. So I will close this issues.

Closed 2020-12-15.

Thread 54 (2020-12-13):

Robin E3 with BL touch stuck on Marlin boot logo

bulcke, 2020-12-13:
Trying to get BL touch working on Ender 3.

So I tried modifying https://github.com/makerbase-mks/MKS-Robin-E3-E3D/blob/master/firmware/V1.1/Marlin-2.0.6.1_for_ender3_TMC2209%2B3dtouch.rar.
Only changed the offsets to: #define NOZZLE_TO_PROBE_OFFSET { -48.3, -7, -2.9}

This compiles ok.

Upgrading with ".pio\build\mks_robin_e3\Robin_e3.bin" works fine. But then display hangs on the Marlin boot logo forever. Reboot does not help.
Tried different micro SD cards.

This firmware https://github.com/makerbase-mks/MKS-Robin-E3-E3D/blob/master/firmware/V1.1/Firmware%20bin%20for%20ender3/Marlin-2.0.6.1_for_ender3_TMC2209.bin boots fine. But has no touch.

edit: ok, now even that one doesn't boot any more. Going back to 1.0 for now...

mks-viva, 2020-12-14:
Hi! Can you provide Video or picture to me?

bulcke, 2020-12-14:
>
>
> Hi! Can you provide Video or picture to me?

I'll try next weekend.

mks-viva, 2020-12-15:
Okay, but I still need to confirm:
Will this problem occur if you use the MKS github Robin_e3.bin file?
If not, then it will be due to software settings

bulcke, 2020-12-21:
Sorry, found no time to look into this yet...

mks-viva, 2020-12-22:
When you have time, you can test it again

RJD2two, 2021-01-03:
I tried Marlin-2.0.6.1_for_ender3_TMC2209+3dtouch.bin and it hangs at the boot screen for me too. Just displays marlin 2.0.6.1

RJD2two, 2021-01-03:
hoiwever, this one does work with the probe!
https://github.com/makerbase-mks/MKS-Robin-E3-E3D/blob/ender3-3d-touch/firmware/marlin2.0.x%20bin/Robin_e3_TMC2209_3DTOUCH_PROBE.bin

bulcke, 2021-01-09:
Trying again, from scratch, with https://github.com/makerbase-mks/MKS-Robin-E3-E3D/blob/master/firmware/V1.1/Marlin-2.0.6.1_for_ender3_TMC2209%2B3dtouch.rar

I'm using visual studio code for editing and compiling.

Doublechecked the firmware settings according to this https://github.com/makerbase-mks/MKS-Robin-E3-E3D/wiki/3D_TOUCH

Just a heads up for any future readers: In that guide it says:
`
9.Set distance between probe and the edge of the hotbed to prevent the probe from exceeding the hotbed

    Configuration.h：#define **MIN_PROBE_EDGE** 10

10.Enable leveling range

    Configuration_adv.h

#if PROBE_SELECTED && !IS_KINEMATIC
  #define MIN_PROBE_EDGE_LEFT **MIN_PROBE_EDGE**
  #define MIN_PROBE_EDGE_RIGHT **MIN_PROBE_EDGE**
  #define MIN_PROBE_EDGE_FRONT **MIN_PROBE_EDGE**
  #define MIN_PROBE_EDGE_BACK **MIN_PROBE_EDGE**
#endif

`
But in the current code **MIN_PROBE_EDGE** is defined as **PROBING_MARGIN**. It is referenced correctly in Configuration_adv.h however, so no change needed.

This time I did not change the line "#define NOZZLE_TO_PROBE_OFFSET { -44, -14.4, -2.4}" in configuration.h .

The only thing I did change in Configuration.h is "#define GRID_MAX_POINTS_X 4"

Compiling was succesful.
Terminal only threw a few warnings, have seen these before, should not be the issue here.

`C:\users\didi\.platformio\packages\framework-arduinoststm32-maple\STM32F1\libraries\STM32ADC\src\utility\util_adc.c:10:30: warning: 'adc_result' initialized and declared 'extern'
 extern volatile unsigned int adc_result = 0;
                              ^~~~~~~~Compiling .pio\build\mks_robin_e3\lib3c4\USBComposite\Joystick.cpp.o
~~

...

C:\users\didi\.platformio\packages\framework-arduinoststm32-maple\STM32F1\libraries\FreeRTOS701\utility\port.c:
In function 'xPortStartScheduler':
C:\users\didi\.platformio\packages\framework-arduinoststm32-maple\STM32F1\libraries\FreeRTOS701\utility\port.c:178:2: warning: implicit declaration of function 'systick_attach_callback' [-Wimplicit-function-declaration]
  systick_attach_callback(&xPortSysTickHandler);
  ^~~~~~~~~~~~~~~~~~~~~~~
At top level:
C:\users\didi\.platformio\packages\framework-arduinoststm32-maple\STM32F1\libraries\FreeRTOS701\utility\port.c:285:6: warning: 'prvSetupTimerInterrupt' defined but not used [-Wunused-function]
 void prvSetupTimerInterrupt( void )
      ^~~~~~~~~~~~~~~~~~~~~~
`

Video of flashing with .pio\build\mks_robin_e3\Robin_e3.bin : https://youtu.be/DcMWxpWhK6U

Not much to see actually, you see the update % going up and the device rebooting.
You'll notice on the boot logo it does show the new version number 2.6.0.1.
I stopped the video but left the printer like that another 10 minutes. No change. Power cycling (without the SD card) does not help.

bulcke, 2021-01-09:
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

That one works for me too. But the issue still remains if I can't flash the one I alter and compile myself.

mks-viva, 2021-01-11:
@bulcke
Hi! According to your test feedback, it is largely caused by the compilation environment. Or you modify the parameters, resulting in too much program space. Especially for grid points, you can compile first according to the default of MKS firmware.

bulcke, 2021-01-11:
I'm not sure what you mean with program space, but I find it hard to believe that a single small change would cause this. Ok so a 4x4 grid needs to hold 7 more probing points than a 3x3... big deal.

But I'll try anyway, without changing anything in the configs. Will get back to you as soon as I find some time.

mks-viva, 2021-01-12:
Ok, waiting for your good news.

Closed 2021-08-03.

Thread 55 (2020-12-16):

TMC Connection Error

ricardonato, 2020-12-16:
I have connected the TMC2209 v1.0 drivers to my new MKS Robin E3D (003) board without modifying anything.

I have updated the "firmware bin for Ender3 (TMC2209)"
https://github.com/makerbase-mks/MKS-Robin-E3-E3D/tree/ender3-3d-touch/firmware/firmware%20bin%20for%20Ender3(TMC2209)

When Marlin finishes booting, the message appears:
"TMC Connection Error"

mks-viva, 2020-12-17:
Hi! You need to do the following so that TMC will not report errors
1. Usrt mode set in E3D motherboard（Use jumpers connect it）
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
2. You need use DC12-24V power

ricardonato, 2020-12-17:
Thank you. Problem solved

Closed 2020-12-17.

Thread 56 (2020-12-24):

error compilation

ptitpuma, 2020-12-24:
hi i have a trouble with compiling marlin with vs code for a cr10
i've follow every step but it won't compile due to this error :
Marlin\src\HAL\STM32F1\../../inc/SanityCheck.h:2378:6: error: #error "SERIAL_PORT is set to -1, but the MOTHERBOARD has no native USB support. Set SERIAL_PORT to a valid value for your board."
     #error "SERIAL_PORT is set to -1, but the MOTHERBOARD has no native USB support. Set SERIAL_PORT to a valid value for your board."
      ^~~~~
In file included from Marlin\src\HAL\STM32F1\../../inc/MarlinConfig.h:49:0,
                 from Marlin\src\HAL\STM32F1\MarlinSerial.cpp:25:

if i change value to1 it works...

mks-viva, 2020-12-25:
Hi! I know what setting causes, you need set
#define SERIAL_PORT 1  //For USB
Disable #define SERIAL_PORT_2 1

ptitpuma, 2020-12-27:
ok thanks

mks-viva, 2020-12-28:
Can it be compiled normally?

ptitpuma, 2020-12-28:
Yes with serial port 1...
don't know why they say to write -1

mks-viva, 2020-12-29:
The first version of marlin is defined as -1, only the latest version will define 1, otherwise it will not compile, Marlin firmware has been adjusted. So, i will close this issues temporarily

ptitpuma, 2021-01-31:
hi just another question about that
hw should i configurate this to add a tft 35 ?

Niptoc, 2021-03-30:
Hello

I also have compilation error for a CR10.
I want to use the TFT 35 and I got the error message :
`In file included from Marlin\src\HAL\STM32F1\../../inc/MarlinConfig.h:49:0,
                 from Marlin\src\HAL\STM32F1\HAL.cpp:30:
Marlin\src\HAL\STM32F1\../../inc/SanityCheck.h:839:6: error: #error "ADVANCED_PAUSE_FEATURE requires a supported LCD controller (or EMERGENCY_PARSER)."
     #error "ADVANCED_PAUSE_FEATURE requires a supported LCD controller (or EMERGENCY_PARSER)."`

I have activated the ADVANCED_PAUSE_FEATURE to be able to use the filament end detector.

Do anyone encounter the same issue?

Closed 2020-12-29.

Thread 58 (2020-12-28):

MKS ROBIN E3D z axis not respond after update the firmware

Xuculate, 2020-12-28:
Hi I'm a little desperate:

Hi. I have recently installed the MKS Robin E3D board +2209.

The board worked fine with the Marlin 2.0.6.1 stock firmware. But I wanted to reverse the rotation of the extruder motor because I have installed a BMG. I have tried to put the firmware from here: https://github.com/makerbase-mks/MKS-Robin-E3-E3D/tree/ender3-3d-touch/firmware and now the z axis does not work, also I still do not know how to compile the Marlin configuration for reverse the extruder motor, etc. I am totally new to this Marlin thing. If you have a configuration for the CR10S to work fine it would be greatly appreciated.

I have changed the controllers between them and they work fine, I have also changed the cables and the output of z does not give signal. So I don't know if it's because of firmware or hardware.

Another things that I´ve tried:
-I've changed the cable outputs from Z cables on other motors, x and y and don´t respond
-I have connected the Z motors on the X and Y outputs of the board and if they move, even using the Z cables, and the Z motors work, so it's not the fault of either the 2209 drivers, the cables, the motors, or it's a firmware issue or the board has been broken inexplicably.

I don't know what to do now I have the printer inoperative, and the Creality board I think has also been broken since before putting the MKS I tried to reverse the extruder cable and never worked the extruder output again. It happens as is happening with the MKS board that the extruder port does not give signal, but in this case the MKS cables I have always connected them in their right position.

I don't know what to do. For the moment I am waiting for a new board (E3) to try again.

Thank you!
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

mks-viva, 2020-12-29:
Are you using MKS Robin E3D V1.1 version motherboard? If yes, then the Z drive signal has been modified and you should download this firmware
Link：https://github.com/makerbase-mks/MKS-Robin-E3-E3D/tree/master/firmware/V1.1
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

MKS Robin E3D/E3 V1.1 and V1.0 compare
https://github.com/MarlinFirmware/Marlin/pull/20216
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

Xuculate, 2020-12-29:
WOW! Yes it is solved! thank you very much!

Now I need invert the direction of the extruder motor. What of this is it?

// For direct drive extruder v9 set to true, for geared extruder set to false.
#define INVERT_E0_DIR false
#define INVERT_E1_DIR false
#define INVERT_E2_DIR false
#define INVERT_E3_DIR false
#define INVERT_E4_DIR false
#define INVERT_E5_DIR false
#define INVERT_E6_DIR false
#define INVERT_E7_DIR false

mks-viva, 2020-12-30:
Haha! So, i will close this issues temporarily.

kjanek, 2021-11-06:
> Haha! So, i will close this issues temporarily.

Please change this too in klipper config file. It took me literally one whole day to find this issue and resolve not moving z axis after changing from marlin to klipper on the mks robin e3d v1.1

Closed 2020-12-30.

Thread 59 (2020-12-28):

Firmware Upgrade not possible E3d V1.0

Seelenkind, 2020-12-28:
Hi there ,
I have not connected an additional module. Just put the TMC2209 driver on it.
After the initial start-up, there was a TMC Connect Error. I wanted to do a firmware update, but it doesn't work.
I cannot upload firmware to the MKS board.
When I save the firmware on an SD card and switch on the printer, it counts up from 0% to 100% and then nothing happens.
When I pull out the SD card and restart the printer, the display only shows boot. But nothing happens.
Do you have a solution? Is the board defective?

mks-viva, 2020-12-29:
Hi!
1. If TMC Connect Error, you need use 12/24V power on
2. Update firmware, you need acooding to your screen and download firmware bin file, you can refer to here
https://github.com/makerbase-mks/MKS-Robin-E3-E3D/tree/master/firmware/V1.0/firmware%20bin

Seelenkind, 2020-12-29:
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

I got the firmware exactly from this site.  after the 100% I see on the SD card that the file name has been changed to.CUR the problem is not that I can not find the firmware but that it does not go on after the 100%.  after a restart the display only shows boot.  but does not go any further.

mks-viva, 2020-12-30:
Can you provide your test firmware bin to me? And i will test it.

Seelenkind, 2021-01-01:
> Can you provide your test firmware bin to me? And i will test it.

Hi there,
I think it's because the firmware file that I downloaded is only 103 KB in size. A normal fiemware has over 200 KB. Can it be that the finished firmware on the Github page is faulty?

Seelenkind, 2021-01-01:
> Can you provide your test firmware bin to me? And i will test it.

OK problem solved. If I use the right mouse button to download the firmware file, the file is only 104 KB in size. If I click on the firmware file and use the download button, it is 205 KB in size and it can be uploaded.
The problem is solved and the question can be marked as solved.

mks-viva, 2021-01-03:
Ok! I will close this issues temporarily.

Closed 2021-01-03.

Thread 60 (2020-12-29):

MKS ROBIN E3D FILAMENT SENSOR FIRMWARE configuration

Xuculate, 2020-12-29:
Hello I am tring to activate the filament sensor in the Marlin firm but I have problems to compile. I was trying to follow this tutorial:

https://www.youtube.com/watch?v=6Hk5Zk_G968&ab_channel=MakerbaseTeam

This was my error:

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

mks-viva, 2020-12-30:
Hi! Can you provide your firmware to me? And i need test it.

Xuculate, 2020-12-30:
> Hi! Can you provide your firmware to me? And i need test it.

Yes sure

Here is the file:
https://gitlab.com/Xuculate/cr10s-mks-robin-e3d-v1.1_bmg_sensor-filament/-/blob/master/Marlin-2.0.6.1_for_ender3_TMC2209.rar

henryho8, 2021-01-17:
I got this problem too. Since I updated my Platform IO with new version, I downloaded E3D marlin firm and failed to compiling,
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

henryho8, 2021-01-17:
> I got this problem too. Since I updated my Platform IO with new version, I downloaded E3D marlin firm and failed to compiling,
> 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

I tried to disable filament runout and failed again with this message.
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

henryho8, 2021-01-17:
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

I don't know what i did...
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
;

Thread 61 (2021-01-01):

Incorrect serial port -1

ellensp, 2021-01-01:
The Example configuration file MKS-Robin-E3-E3D/firmware/marlin2.0 for Ender3/Marlin/Configuration.h
 has #define SERIAL_PORT_2 -1

This is Incorrect

-1 can only be used when the USB D+ and D- lines are directly connected to the Controllers MPU pins.

This board uses a usb/seral converter chip.

mks-viva, 2021-01-03:
Hi! Thank you for your feedback, we will test it and fix it.

ellensp, 2021-02-01:
Ignoring the issue and sticking your head in the sand is not fixing it!

mks-viva, 2021-02-01:
> Ignoring the issue and sticking your head in the sand is not fixing it!

https://github.com/makerbase-mks/MKS-Robin-E3-E3D/issues/61#issuecomment-770527700
I has disable it

mks-viva, 2021-02-01:
At that time, Test firmware can be used normally, and the device corresponding to the value of -1 is not actually considered

ellensp, 2021-02-01:
With more modern marlin it knows the controller doesn't have USB CDC serial and errors to tell you not to set -1. Users where copying these older configs into modern marlin and it would fail (as it should) they then create issue that marlin was broken because you had -1 in your config so it must be correct  (sigh)

All good now, thanks

Closed 2021-02-01.

Thread 62 (2021-01-01):

How to upload bootloader ?

Seelenkind, 2021-01-01:
Hi,
how to upload bootloader ?
i want to slience the beep at start

https://github.com/makerbase-mks/MKS-Robin-E3-E3D/tree/ender3-3d-touch/firmware/Bootloader

i connected PC with MKS Board with FTD232 USB to Serial Modul.
but Flash Loader Demonstrator can not find Board , but connected as Com Port 8

thx

mks-viva, 2021-01-03:
Hi! https://github.com/makerbase-mks/MKS-Robin-E3-E3D/issues/43

Seelenkind, 2021-01-03:
> Hi! #43
Hi,
I already found this question in the archive and am not sure which of these pins should be pin 60?
Pin 60 should either be on 3.3. set or the connection to GND disconnected. But which one is it exactly?
Why isn't a jumper installed on the board to put the board in bootloader upload mode?
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

mks-viva, 2021-01-04:
Hi! About 60pin map
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
This may be something we did not consider, I am sorry. But MKS Robin E3/E3D has TF update firmware function

mks-viva, 2021-01-18:
Hi! If there is no response, then I will temporarily close this question.

Closed 2021-01-18.

Thread 63 (2021-01-03):

How to config Marlin for MKS E3D ?

Seelenkind, 2021-01-03:
Hi ,
I have the board MKS-Robin-E3-E3D.
When I set up Marlin for the board and want to create a firmware.bin file, I download Marlin 2.0 for Ender 3.
[https://github.com/makerbase-mks/MKS-Robin-E3-E3D/tree/ender3-3d-touch/firmware/marlin2.0%20for%20Ender3](url)
#define MOTHERBOARD BOARD_MKS_ROBIN_E3 I changed to E3D because i have the board with the DIP's.
#define X_DRIVER_TYPE TMC2209 also fit for me because I have installed these drivers.
If I now create the firmware.bin file in PlatformIo (no error message when creating it) and change it to Robin_e3.bin and then start the printer with the card, the display shows upadating 0% >>> 100% and then nothing happens.
If I use a finished firmware then the firmware update is carried out without any problems. So the board is not defective and a firmware update can be carried out without any problems.
What else do I miss while creating?
Is there a special guide on how to adapt Marlin for MKS E3D without overlooking anything?

Seelenkind, 2021-01-04:
In vain I downloaded the firmware.bin file and renamed it Robin_e3.bin. That was the wrong file. I simply skipped this requirement:

After compile firmware, copy "Robin_e3.bin" file to root directory of TF card [from: Marlin -> .pio - > build -> mks_robin_e3]

Closed 2021-01-04.

Thread 64 (2021-01-12):

Issue with Ender3 TMC2209+3DTouch

Benji198599, 2021-01-12:
After I have installed the firmware "For Ender3 TMC2209 + 3Dtouch" via an SD card and want to approach the reference via "AutoHome", the printer moves to the stop of the X axis. The stop for reference X no longer works.

3D Touch was connected as described here: https://www.youtube.com/watch?v=r2A0b7XQEaI&t=177s

The firmware was not changed and only from: https://github.com/makerbase-mks/MKS-Robin-E3-E3D
downloaded.
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

Hardware: Ender 3 pro, with MKS Robin E3 V1.0 Motherboard.
Standard LCD Display

https://user-images.githubusercontent.com/76880195/104358275-38878d00-5534-11eb-853c-4e7b15d65a2d.mov

mks-viva, 2021-01-14:
Can you view the error message on the display screen or other?

Benji198599, 2021-01-20:
There is no error on display... I upload again the firmware https://github.com/makerbase-mks/MKS-Robin-E3-E3D/tree/ender3-3d-touch/firmware/marlin2.0.x%20bin
Robin_e3_TMC2209_3DTOUCH_PROBE.bin

now Z-axis is working but 3DTouch is off and don´t work anymore
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

Benji198599, 2021-01-20:
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

Benji198599, 2021-01-20:
3DTouch have no light on - no action if I use 3DTouch option in Configuration

mks-viva, 2021-01-25:
Your 3D TOUCH's Z-out connect to Probe/E-STOP(PB1) interface
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

krzysziekz, 2021-02-26:
Double check your connections, not wires but sockets, I think they are wrong. You connected probe to neopixel socket
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

zeck7, 2021-09-17:
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

Hi have you solve this issue. I think i got the same problems that X Axis always moving in one direction which is to the endstop. Usually if i choose home...all 3 axis should be move to the endstop until triggered the microswitch and move a bit to OPPOSITE direction to avoid collision with endstop and move slowly back to the endstop until all axis triggered the switch.

But my X Axis acting weird because if im homing all Axis the X Axis only moving to the endstop, and after its triggered the limit switch....it move more to the endstop and grinding with the limit switch. Should it move to the opposite to avoid grinding the axis like in the video?

Thread 65 (2021-01-13):

Issue with Z-axis after Auto homing

Benji198599, 2021-01-13:
Hello,

There is one issue with Z-axis after upload the firmware:
- Firmware bin for Ender3 (TMC2209)
or
- marlin2.0 for Ender 3
or
any another firmware which includes BLtouch

The Z- axis doesn't move manually (LCD - Motion - Move) after auto homing!
But it moves in the printer programm.... and again after the print programm....

could you please help?

mks-viva, 2021-01-18:
Hi! Can you provide your motherboard's wiring ? You can try to bltouch‘s output signel connect to E3/E3D board's probe/e-stop interface.

Benji198599, 2021-01-20:
problem solved!

Closed 2021-02-08.

Thread 66 (2021-01-17):

Home and move issues

edvard5, 2021-01-17:
After Homing axis, move doesn't work, 3D touch is not leveling. End stops working fine, tested.
https://youtu.be/HgGHZkHkZOE

mks-viva, 2021-01-18:
Hi! This looks like the program has stopped running after returning to home. You can try to use USB to connect to the motherboard, and the host computer can check the printed information after returning to home, and you can locate what caused the axis to be unable to move.

edvard5, 2021-01-18:
I'll give it a try and report back

mks-viva, 2021-01-18:
Ok!

edvard5, 2021-01-18:
[ERROR] Error:!! STOP called because of BLTouch error - restart with M999
Error:Printer stopped due to errors. Fix the error and use M999 to restart. (Temperature is reset. Set it after restarting)
two errors

mks-viva, 2021-01-18:
Ok! Please tell me which firmware are you using?

edvard5, 2021-01-18:
https://github.com/makerbase-mks/MKS-Robin-E3-E3D/blob/master/firmware/V1.1/Firmware%20bin%20for%20ender3/Marlin-2.0.6.1_for_ender3_TMC2209%2B3dtouch%2BZ_SAFE_HOMING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
this one with TFT35 1.0.7v

mks-viva, 2021-01-18:
3D Touch's output signel need connect to probe/E-stop interface
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

edvard5, 2021-01-18:
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
Already connected, followed step by step tutorial

edvard5, 2021-01-18:
Probelm still persists. need help 🌵

mks-viva, 2021-01-18:
I am sorry! I seem to be doing the wrong guide.
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

mks-viva, 2021-01-18:
You need remove ender3 original Zstop

edvard5, 2021-01-18:
offset set corectlly but it keeps pushing nozzle to bed with force until starts to skip

edvard5, 2021-01-18:
after homing still same problem, can't manually move axis... like in the video

edvard5, 2021-01-20:
managed to fix this with these steps
M502
M500
M999
then setting xyz offsets all over again.

mks-viva, 2021-01-20:
I didn't think about it,

Closed 2021-01-20.

Thread 67 (2021-01-23):

Bed size values incorrect

ricardonato, 2021-01-23:
I've been going crazy for two weeks. I didn't know why my Ender3 with MKS Robin E3D was not printing the parts to the right and the back of the bed well.

I have seen in the source code of your firmware that in Marlin's "Configuration.h" the values are incorrect:
# define X_BED_SIZE 220
# define Y_BED_SIZE 220

The correct values are:
# define **X_BED_SIZE 235**
# define **Y_BED_SIZE 235**

I have not been able to change them because when I compile with VSCode it returns a lot of errors and I am still working on it.

Can you update those values so that I can download a firmware binary file?

Thank you

mks-viva, 2021-01-25:
Hi! You need to tell me which firmware are you using now?

ricardonato, 2021-01-25:
> ¡Hola! ¿Necesitas decirme qué firmware estás usando ahora?

https://github.com/makerbase-mks/MKS-Robin-E3-E3D/blob/ender3-3d-touch/firmware/firmware%20bin%20for%20Ender3(TMC2209)/Robin_e3.bin

mks-viva, 2021-01-26:
[Robin_e3.zip](https://github.com/makerbase-mks/MKS-Robin-E3-E3D/files/5872825/Robin_e3.zip)
I has change it and build it.
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

ricardonato, 2021-01-26:
Thank you very much for the support.

Closed 2021-01-26.

Thread 68 (2021-01-29):

Urgent help required! ender 3 V2 LCD screen not supported

Salkio, 2021-01-29:
I need help. I compiled firmware and when I tried to flash nothing happened. I realized the screen was also off and beeping.
I thought maybe I had to enable the DWIN_CREALITY_LCD (Ender 3 V2 stock screen) however that did not compile and gave me this error code below. Please tell me I can fix this!

ERROR CODE:

In file included from Marlin\src\lcd\dwin\dwin.h:29:0,
                 from Marlin\src\lcd\dwin\dwin.cpp:31:
Marlin\src\lcd\dwin\rotary_encoder.h:44:0: warning: "ENCODER_PULSES_PER_STEP" redefined
 #define ENCODER_PULSES_PER_STEP  4

In file included from Marlin\src\lcd\dwin\../../inc/MarlinConfigPre.h:47:0,
                 from Marlin\src\lcd\dwin\dwin.cpp:27:
Marlin\src\lcd\dwin\../../inc/Conditionals_LCD.h:377:0: note: this is the location of the previous definition
   #define ENCODER_PULSES_PER_STEP STD_ENCODER_PULSES_PER_STEP

Compiling .pio\build\mks_robin_e3\src\src\libs\W25Qxx.cpp.o
In file included from Marlin\src\lcd\dwin\rotary_encoder.cpp:37:0:
Marlin\src\lcd\dwin\rotary_encoder.h:44:0: warning: "ENCODER_PULSES_PER_STEP" redefined
 #define ENCODER_PULSES_PER_STEP  4

In file included from Marlin\src\lcd\dwin\../../inc/MarlinConfigPre.h:47:0,
                 from Marlin\src\lcd\dwin\rotary_encoder.cpp:33:
Marlin\src\lcd\dwin\../../inc/Conditionals_LCD.h:377:0: note: this is the location of the previous definition
   #define ENCODER_PULSES_PER_STEP STD_ENCODER_PULSES_PER_STEP

Compiling .pio\build\mks_robin_e3\src\src\libs\buzzer.cpp.o
Compiling .pio\build\mks_robin_e3\src\src\libs\crc16.cpp.o
In file included from Marlin\src\lcd\dwin\../../inc/../HAL/./STM32F1/HAL.h:36:0,
                 from Marlin\src\lcd\dwin\../../inc/../HAL/HAL.h:26,
                 from Marlin\src\lcd\dwin\../../inc/MarlinConfig.h:30,
                 from Marlin\src\lcd\dwin\rotary_encoder.h:34,
                 from Marlin\src\lcd\dwin\rotary_encoder.cpp:37:
Marlin\src\lcd\dwin\rotary_encoder.cpp: In function 'void Encoder_tick()':
Marlin\src\lcd\dwin\rotary_encoder.cpp:52:9: error: 'BEEPER_PIN' was not declared in this scope
   WRITE(BEEPER_PIN, 1);
         ^
Marlin\src\lcd\dwin\../../inc/../HAL/./STM32F1/fastio.h:33:42: note: in definition of macro 'WRITE'
 #define WRITE(IO,V)             (PIN_MAP[IO].gpio_device->regs->BSRR = (1U << PIN_MAP[IO].gpio_bit) << ((V) ? 0 : 16))
                                          ^~
Marlin\src\lcd\dwin\rotary_encoder.cpp:52:9: note: suggested alternative: 'TEMP_7_PIN'
   WRITE(BEEPER_PIN, 1);
         ^
Marlin\src\lcd\dwin\../../inc/../HAL/./STM32F1/fastio.h:33:42: note: in definition of macro 'WRITE'
 #define WRITE(IO,V)             (PIN_MAP[IO].gpio_device->regs->BSRR = (1U << PIN_MAP[IO].gpio_bit) << ((V) ? 0 : 16))
                                          ^~
Marlin\src\lcd\dwin\rotary_encoder.cpp: In function 'ENCODER_DiffState Encoder_ReceiveAnalyze()':
Marlin\src\lcd\dwin\rotary_encoder.h:46:34: error: 'BTN_EN1' was not declared in this scope
 #define BUTTON_PRESSED(BN) !READ(BTN_## BN)
                                  ^
Marlin\src\lcd\dwin\../../inc/../HAL/./STM32F1/fastio.h:32:42: note: in definition of macro 'READ'
 #define READ(IO)                (PIN_MAP[IO].gpio_device->regs->IDR & (1U << PIN_MAP[IO].gpio_bit) ? HIGH : LOW)
                                          ^~
Marlin\src\lcd\dwin\rotary_encoder.cpp:82:7: note: in expansion of macro 'BUTTON_PRESSED'
   if (BUTTON_PRESSED(EN1)) newbutton |= 0x01;
       ^~~~~~~~~~~~~~
Marlin\src\lcd\dwin\rotary_encoder.h:46:34: error: 'BTN_EN2' was not declared in this scope
 #define BUTTON_PRESSED(BN) !READ(BTN_## BN)
                                  ^
Marlin\src\lcd\dwin\../../inc/../HAL/./STM32F1/fastio.h:32:42: note: in definition of macro 'READ'
 #define READ(IO)                (PIN_MAP[IO].gpio_device->regs->IDR & (1U << PIN_MAP[IO].gpio_bit) ? HIGH : LOW)
                                          ^~
Marlin\src\lcd\dwin\rotary_encoder.cpp:83:7: note: in expansion of macro 'BUTTON_PRESSED'
   if (BUTTON_PRESSED(EN2)) newbutton |= 0x02;
       ^~~~~~~~~~~~~~
Marlin\src\lcd\dwin\rotary_encoder.h:46:34: error: 'BTN_ENC' was not declared in this scope
 #define BUTTON_PRESSED(BN) !READ(BTN_## BN)
                                  ^
Marlin\src\lcd\dwin\../../inc/../HAL/./STM32F1/fastio.h:32:42: note: in definition of macro 'READ'
 #define READ(IO)                (PIN_MAP[IO].gpio_device->regs->IDR & (1U << PIN_MAP[IO].gpio_bit) ? HIGH : LOW)
                                          ^~
Marlin\src\lcd\dwin\rotary_encoder.cpp:84:7: note: in expansion of macro 'BUTTON_PRESSED'
   if (BUTTON_PRESSED(ENC)) {
       ^~~~~~~~~~~~~~
Marlin\src\lcd\dwin\rotary_encoder.cpp:138:39: error: 'ENCODER_5X_STEPS_PER_SEC' was not declared in this scope
           else if (encoderStepRate >= ENCODER_5X_STEPS_PER_SEC) encoderMultiplier = 5;
                                       ^~~~~~~~~~~~~~~~~~~~~~~~
Marlin\src\lcd\dwin\rotary_encoder.cpp:138:39: note: suggested alternative: 'ENCODER_10X_STEPS_PER_SEC'
           else if (encoderStepRate >= ENCODER_5X_STEPS_PER_SEC) encoderMultiplier = 5;
                                       ^~~~~~~~~~~~~~~~~~~~~~~~
                                       ENCODER_10X_STEPS_PER_SEC
Marlin\src\lcd\dwin\dwin.cpp:174:51: error: 'DEFAULT_XJERK' was not declared in this scope
 constexpr float default_max_jerk[]            = { DEFAULT_XJERK, DEFAULT_YJERK, DEFAULT_ZJERK, DEFAULT_EJERK };
                                                   ^~~~~~~~~~~~~
Marlin\src\lcd\dwin\dwin.cpp:174:51: note: suggested alternative: 'DEFAULT_EJERK'
 constexpr float default_max_jerk[]            = { DEFAULT_XJERK, DEFAULT_YJERK, DEFAULT_ZJERK, DEFAULT_EJERK };
                                                   ^~~~~~~~~~~~~
                                                   DEFAULT_EJERK
Marlin\src\lcd\dwin\dwin.cpp:174:66: error: 'DEFAULT_YJERK' was not declared in this scope
 constexpr float default_max_jerk[]            = { DEFAULT_XJERK, DEFAULT_YJERK, DEFAULT_ZJERK, DEFAULT_EJERK };
                                                                  ^~~~~~~~~~~~~
Marlin\src\lcd\dwin\dwin.cpp:174:66: note: suggested alternative: 'DEFAULT_EJERK'
 constexpr float default_max_jerk[]            = { DEFAULT_XJERK, DEFAULT_YJERK, DEFAULT_ZJERK, DEFAULT_EJERK };
                                                                  ^~~~~~~~~~~~~
                                                                  DEFAULT_EJERK
Marlin\src\lcd\dwin\dwin.cpp:174:81: error: 'DEFAULT_ZJERK' was not declared in this scope
 constexpr float default_max_jerk[]            = { DEFAULT_XJERK, DEFAULT_YJERK, DEFAULT_ZJERK, DEFAULT_EJERK };
                                                                                 ^~~~~~~~~~~~~
Marlin\src\lcd\dwin\dwin.cpp:174:81: note: suggested alternative: 'DEFAULT_EJERK'
 constexpr float default_max_jerk[]            = { DEFAULT_XJERK, DEFAULT_YJERK, DEFAULT_ZJERK, DEFAULT_EJERK };
                                                                                 ^~~~~~~~~~~~~
                                                                                 DEFAULT_EJERK
*** [.pio\build\mks_robin_e3\src\src\lcd\dwin\rotary_encoder.cpp.o] Error 1
Marlin\src\lcd\dwin\dwin.cpp: In function 'void make_name_without_ext(char*, char*, int)':
Marlin\src\lcd\dwin\dwin.cpp:1541:11: warning: comparison between signed and unsigned integer expressions [-Wsign-compare]
   if (len > maxlen) { // Keep the name short
       ~~~~^~~~~~~~
Marlin\src\lcd\dwin\dwin.cpp: In function 'void HMI_AudioFeedback(bool)':
Marlin\src\lcd\dwin\dwin.cpp:2140:5: error: 'buzzer' was not declared in this scope
     buzzer.tone(100, 659);
     ^~~~~~
Marlin\src\lcd\dwin\dwin.cpp:2140:5: note: suggested alternative: 'bzero'
     buzzer.tone(100, 659);
     ^~~~~~
     bzero
Marlin\src\lcd\dwin\dwin.cpp:2145:5: error: 'buzzer' was not declared in this scope
     buzzer.tone(40, 440);
     ^~~~~~
     buzzer.tone(40, 440);
     ^~~~~~
     bzero
compilation terminated due to -fmax-errors=5.
*** [.pio\build\mks_robin_e3\src\src\lcd\dwin\dwin.cpp.o] Error 1

mks-viva, 2021-02-01:
Hi! MKS Robin E3/E3D can't support Dwen screen yet.

Closed 2021-02-08.

Thread 69 (2021-01-30):

E3D "power supply" and "12-24V output" connectors

fantomsbg, 2021-01-30:
My original Ender 3 board is v4.2.2

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

Its power connector is located to the E3D "12-24V output" place. So I have to connect the power leads to it and the fan leads to "power supply" connector.
Is it safe and will the fuses fork correctly if the board is power supplied from the "12-24V output" connector?

mks-viva, 2021-02-01:
Hi! 12/24 output interface depends on the power supply voltage you provide.

fantomsbg, 2021-02-01:
My question was if I can connect the power supply leads to 12-24V output connector?

mks-viva, 2021-02-02:
Yes, you can.

fantomsbg, 2021-02-02:
Is there a fuse to protect this "12-24V output" when it become an input power supply connector?
If there are no fuses this can cause a serious problems?
According to me the fuse is only for the "power supply" connector.

Closed 2021-02-01.

Thread 70 (2021-01-30):

Trouble configuring ONBOARD function to use the SD Card directly without a LCD

HarpoDog, 2021-01-30:
I am trying to configure Marlin 2.0 Bugfix downloaded 1.30.21 to use the autostart feature directly from the SD card reader.
I completed the configuration for a MKS Robin E3 with the Creality Ender 3 configuration files and it complied fine.

Next, I went to the configuration_adv.h file and uncommented  #define SDCARD_CONNECTION ONBOARD on line 1403 and tried to build Marlin and got the following error message three places:
Marlin\src\HAL\STM32F1\onboard_sd.cpp:42:25: error: 'ONBOARD_SD_CS_PIN' was not declared in this scope

Could you please tell provide me the proper files that I could copy into Marlin to remove this error or tell me which files I would need to modify, where within the files they would need to be modified, and the exact code I would need to use.

I am ok if the LCD gets disable as I will not have it attached.

Attached below are my configuration.h and configuratin_adv.h files.

Here is the complete error message:
In file included from Marlin\src\HAL\STM32F1\../../inc/../HAL/./STM32F1/HAL.h:36:0,
                 from Marlin\src\HAL\STM32F1\../../inc/../HAL/HAL.h:30,
                 from Marlin\src\HAL\STM32F1\../../inc/MarlinConfig.h:31,
                 from Marlin\src\HAL\STM32F1\onboard_sd.cpp:16:
Marlin\src\HAL\STM32F1\onboard_sd.cpp: In function 'void deselect()':
Marlin\src\HAL\STM32F1\onboard_sd.cpp:42:25: error: 'ONBOARD_SD_CS_PIN' was not declared in this scope
 #define CS_HIGH() WRITE(ONBOARD_SD_CS_PIN, HIGH) /* Set OnboardSPI cs high */
                         ^
Marlin\src\HAL\STM32F1\../../inc/../HAL/./STM32F1/fastio.h:33:42: note: in definition of macro 'WRITE'
 #define WRITE(IO,V)             (PIN_MAP[IO].gpio_device->regs->BSRR = _BV32(PIN_MAP[IO].gpio_bit) << ((V) ? 0 : 16))
                                          ^~
Marlin\src\HAL\STM32F1\onboard_sd.cpp:134:3: note: in expansion of macro 'CS_HIGH'
   CS_HIGH();    /* CS = H */
   ^~~~~~~
Marlin\src\HAL\STM32F1\onboard_sd.cpp:42:25: note: suggested alternative: 'ONBOARD_SD_SPI'
 #define CS_HIGH() WRITE(ONBOARD_SD_CS_PIN, HIGH) /* Set OnboardSPI cs high */
                         ^
Marlin\src\HAL\STM32F1\../../inc/../HAL/./STM32F1/fastio.h:33:42: note: in definition of macro 'WRITE'
 #define WRITE(IO,V)             (PIN_MAP[IO].gpio_device->regs->BSRR = _BV32(PIN_MAP[IO].gpio_bit) << ((V) ? 0 : 16))
                                          ^~
Marlin\src\HAL\STM32F1\onboard_sd.cpp:134:3: note: in expansion of macro 'CS_HIGH'
   CS_HIGH();    /* CS = H */
   ^~~~~~~
Marlin\src\HAL\STM32F1\onboard_sd.cpp: In function 'int select()':
Marlin\src\HAL\STM32F1\onboard_sd.cpp:41:25: error: 'ONBOARD_SD_CS_PIN' was not declared in this scope
 #define CS_LOW()  WRITE(ONBOARD_SD_CS_PIN, LOW)  /* Set OnboardSPI cs low */
                         ^
Marlin\src\HAL\STM32F1\../../inc/../HAL/./STM32F1/fastio.h:33:42: note: in definition of macro 'WRITE'
 #define WRITE(IO,V)             (PIN_MAP[IO].gpio_device->regs->BSRR = _BV32(PIN_MAP[IO].gpio_bit) << ((V) ? 0 : 16))
                                          ^~
Marlin\src\HAL\STM32F1\onboard_sd.cpp:143:3: note: in expansion of macro 'CS_LOW'
   CS_LOW();   /* CS = L */
   ^~~~~~
Marlin\src\HAL\STM32F1\onboard_sd.cpp:41:25: note: suggested alternative: 'ONBOARD_SD_SPI'
 #define CS_LOW()  WRITE(ONBOARD_SD_CS_PIN, LOW)  /* Set OnboardSPI cs low */
                         ^
Marlin\src\HAL\STM32F1\../../inc/../HAL/./STM32F1/fastio.h:33:42: note: in definition of macro 'WRITE'
 #define WRITE(IO,V)             (PIN_MAP[IO].gpio_device->regs->BSRR = _BV32(PIN_MAP[IO].gpio_bit) << ((V) ? 0 : 16))
                                          ^~
Marlin\src\HAL\STM32F1\onboard_sd.cpp:143:3: note: in expansion of macro 'CS_LOW'
   CS_LOW();   /* CS = L */
   ^~~~~~
Marlin\src\HAL\STM32F1\onboard_sd.cpp: In function 'void power_on()':
Marlin\src\HAL\STM32F1\onboard_sd.cpp:161:13: error: 'ONBOARD_SD_CS_PIN' was not declared in this scope
   OUT_WRITE(ONBOARD_SD_CS_PIN, HIGH); /* Set CS# high */
             ^
Marlin\src\HAL\STM32F1\../../inc/../HAL/./STM32F1/fastio.h:37:55: note: in definition of macro '_SET_MODE'
 #define _SET_MODE(IO,M)         gpio_set_mode(PIN_MAP[IO].gpio_device, PIN_MAP[IO].gpio_bit, M)
                                                       ^~
Marlin\src\HAL\STM32F1\../../inc/../HAL/./STM32F1/fastio.h:41:37: note: in expansion of macro '_SET_OUTPUT'
 #define OUT_WRITE(IO,V)         do{ _SET_OUTPUT(IO); WRITE(IO,V); }while(0)
                                     ^~~~~~~~~~~
Marlin\src\HAL\STM32F1\onboard_sd.cpp:161:3: note: in expansion of macro 'OUT_WRITE'
   OUT_WRITE(ONBOARD_SD_CS_PIN, HIGH); /* Set CS# high */
   ^~~~~~~~~
Marlin\src\HAL\STM32F1\onboard_sd.cpp:161:13: note: suggested alternative: 'ONBOARD_SD_SPI'
   OUT_WRITE(ONBOARD_SD_CS_PIN, HIGH); /* Set CS# high */
             ^
Marlin\src\HAL\STM32F1\../../inc/../HAL/./STM32F1/fastio.h:37:55: note: in definition of macro '_SET_MODE'
 #define _SET_MODE(IO,M)         gpio_set_mode(PIN_MAP[IO].gpio_device, PIN_MAP[IO].gpio_bit, M)
                                                       ^~
Marlin\src\HAL\STM32F1\../../inc/../HAL/./STM32F1/fastio.h:41:37: note: in expansion of macro '_SET_OUTPUT'
 #define OUT_WRITE(IO,V)         do{ _SET_OUTPUT(IO); WRITE(IO,V); }while(0)
                                     ^~~~~~~~~~~
Marlin\src\HAL\STM32F1\onboard_sd.cpp:161:3: note: in expansion of macro 'OUT_WRITE'
   OUT_WRITE(ONBOARD_SD_CS_PIN, HIGH); /* Set CS# high */
   ^~~~~~~~~
[Config.h.zip](https://github.com/makerbase-mks/MKS-Robin-E3-E3D/files/5898683/Config.h.zip)
[Config_Adv.h.zip](https://github.com/makerbase-mks/MKS-Robin-E3-E3D/files/5898684/Config_Adv.h.zip)

Thank you for your support!

mks-viva, 2021-02-01:
Hi! Do you want to print directly without selecting via LCD?

HarpoDog, 2021-02-01:
I want to print directly from the SD Card on the motherboard. I will not have an LCD installed.Sent from Samsung Galaxy smartphone.
-------- Original message --------From: mks-viva <notifications@github.com> Date: 1/31/21  5:59 PM  (GMT-08:00) To: makerbase-mks/MKS-Robin-E3-E3D <MKS-Robin-E3-E3D@noreply.github.com> Cc: HarpoDog <SWEIDNER@PROGRAMNAVIGATORS.COM>, Author <author@noreply.github.com> Subject: Re: [makerbase-mks/MKS-Robin-E3-E3D] Trouble configuring ONBOARD
  function to use the SD Card directly without a LCD (#70)
Hi! Do you want to print directly without selecting via LCD?

—You are receiving this because you authored the thread.Reply to this email directly, view it on GitHub, or unsubscribe.

mks-viva, 2021-02-01:
Have use MKS TFT and MKS TFT WIIF？

HarpoDog, 2021-02-01:
I do not have or plan to use  a MKS TFT or MKS TFT wifi. I need to and want to print directly from the Micro SD in the Micro SD Card slot onboard the MKS Robin  E3's motherboard by executing the g-code file to print using the Marlin Autostart feature.Are you familiar with the Marlin Autostart feature? It works very well.Sent from Samsung Galaxy smartphone.
-------- Original message --------From: mks-viva <notifications@github.com> Date: 1/31/21  7:54 PM  (GMT-08:00) To: makerbase-mks/MKS-Robin-E3-E3D <MKS-Robin-E3-E3D@noreply.github.com> Cc: HarpoDog <SWEIDNER@PROGRAMNAVIGATORS.COM>, Author <author@noreply.github.com> Subject: Re: [makerbase-mks/MKS-Robin-E3-E3D] Trouble configuring ONBOARD
  function to use the SD Card directly without a LCD (#70)

Have use MKS TFT and MKS TFT WIIF？

—You are receiving this because you authored the thread.Reply to this email directly, view it on GitHub, or unsubscribe.

mks-viva, 2021-02-01:
You can rename gcode file name to auto.g, and it is will auto printing when you power on.

HarpoDog, 2021-02-01:
Yes. I have always used auto0.g. IT is a really nice feature when you don't have or don't want to use a LCD.Thank you for your help so far. I look forward to your solution that will modify the Marlin firmware, allow it to complie, and enable the Autostart feature.Sent from Samsung Galaxy smartphone.
-------- Original message --------From: mks-viva <notifications@github.com> Date: 1/31/21  9:06 PM  (GMT-08:00) To: makerbase-mks/MKS-Robin-E3-E3D <MKS-Robin-E3-E3D@noreply.github.com> Cc: HarpoDog <SWEIDNER@PROGRAMNAVIGATORS.COM>, Author <author@noreply.github.com> Subject: Re: [makerbase-mks/MKS-Robin-E3-E3D] Trouble configuring ONBOARD
  function to use the SD Card directly without a LCD (#70)
You can rename gcode file name to auto.g, and it is will auto printing when you power on.

—You are receiving this because you authored the thread.Reply to this email directly, view it on GitHub, or unsubscribe.

mks-viva, 2021-02-04:
At present, auto0.g is the best choice

HarpoDog, 2021-02-04:
Ok, so how do I resolve my issue above  as noted in the error message above so The MKS robin E3 with Marlin 2.0 will recognize the the Micro SD card onboard the MSK motherboard and I can print directly from the Micro SD card without an LCD or TFT? .
How do I declare the ONBOARD_SD_CS_PIN within the scope noted and resolve the error above.
Thank you your support.

HarpoDog, 2021-02-04:
As a reminder, the errors occur when I am trying to compile the latest version of Marlin 2.0.

mks-viva, 2021-02-04:
MKS Robin E3/E3D's TF card is onboard default.

HarpoDog, 2021-02-04:
Is what you are saying is that he TF Card on the LCD or TFT is the default?
in the Marlin configuration_adv.h file - the following are the three options

 * Set this option to one of the following (or the board's defaults apply):
   *
   *           LCD - Use the SD drive in the external LCD controller.
   *       ONBOARD - Use the SD drive on the control board.
   *  CUSTOM_CABLE - Use a custom cable to access the SD (as defined in a pins file).
   *
   * :[ 'LCD', 'ONBOARD', 'CUSTOM_CABLE' ]
   */
  //#define SDCARD_CONNECTION ONBOARD

  // Enable if SD detect is rendered useless (e.g., by using an SD extender)
  //#define NO_SD_DETECT

#endif // SDSUPPORT

When you uncomment the  //#define SDCARD_CONNECTION ONBOARD so it reads  #define SDCARD_CONNECTION ONBOARD, then compile, you get the error message above.

This is the problem I am trying to resolve and would appreciate your help to resolve the issue.

mks-viva, 2021-02-04:
ONBOARD_SD_SS_PIN = SD_SS_PIN

HarpoDog, 2021-02-04:
Is ONBOARD_SD_SS_PIN = SD_SS_PIN what I add to Marline and if so, where do I
add this within Marlin - to which files, where within the files?

I am not sure what you are telling me below. I am not an experienced coder
so will need a little more explanation please.

Thanks

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

mks-viva, 2021-02-05:
You need add "#define ONBOARD_SD_SS_PIN  SD_SS_PIN" in pins_MKS_ROBIN_E3.h file

mks-viva, 2021-02-08:
If have not response, I will close this issues temporaril.

HarpoDog, 2021-02-08:
Sorry for the slow response. I work on a ship and can be days without being connected.

I believe what I need to know is how to is how to define “ONBOARD_SD_CS_PIN” in three different scopes within the exact locations of the “Marlin\src\HAL\STM32F1\onboard_sd.cpp" file.

Your suggestion of "You need add "#define ONBOARD_SD_SS_PIN SD_SS_PIN" in pins_MKS_ROBIN_E3.h file" did not change the three error messages when compiling.

Attached is the Marlin folder I am testing. It would be appreciated if you could test this folder,make the corrections as need to get it to compile, and send me the corrected files.

[Marlin-bugfix-2.0.x onboard test.zip](https://github.com/makerbase-mks/MKS-Robin-E3-E3D/files/5945094/Marlin-bugfix-2.0.x.onboard.test.zip)

Thank you for your support!

sn9s, 2021-02-15:
Hi, I just bought a mks robin e3d v1.1 , I have the same error when compiling.
I use the version of marlin provided by mks : https://github.com/makerbase-mks/MKS-Robin-E3-E3D/tree/master/firmware/V1.1/Marlin-2.0.6.1_for_ender3_TMC2209

I just changed in Configuration.h :
_//#define REPRAP_DISCOUNT_FULL_GRAPHIC_SMART_CONTROLLER
#define CR10_STOCKDISPLAY_

and in Configuration_adv.h :
_#define SDCARD_CONNECTION ONBOARD_

I get the "ONBOARD_SD_CS_PIN not declared" error when changing sd connection from lcd to onboard.

When I add _#define ONBOARD_SD_SS_PIN SD_SS_PIN_ in _pins_MKS_ROBIN_E3.h_ file I get the same error.
I tried _#define ONBOARD_SD_CS_PIN SD_SS_PIN_ , it compile but when updating it get stuck at 100%.

Closed 2021-02-08.

Thread 72 (2021-01-31):

MKS Robin E3 - Octoprint Serial

Salkio, 2021-01-31:
I have been trying to connect this board to octoprint and for the life of me I cannot get it working.
Can’t connect with /dev/ttyUSB0 or something. I have tried everything. Tried adding a * does not work.

mks-viva, 2021-02-01:
Hi! You want to Klipper firmware?

mks-viva, 2021-02-14:
You can send command ls /dev/serial/by-id/*  get serial

Closed 2021-02-21.

Thread 73 (2021-02-04):

Robin E3 boot Ender 3 Pro

TheKillerOfMarsh, 2021-02-04:
Good evening, let's see if you can help me, I have compiled 2.0.6.1 for my Mks Robin E3 v.  1.0 correctly without errors, I just needed to change the extruder steps for my Ender 3 Pro and it updates correctly but it hangs on the Marlin logo, I have seen a .hex here is for that type of hang and where is the hex put?  Greetings.

mks-viva, 2021-02-05:
Hi! I has check marlin config about ender 3 pro, Link:
https://github.com/MarlinFirmware/Configurations/blob/import-2.0.x/config/examples/Creality/Ender-3%20Pro/CrealityV1/Configuration.h
#define DEFAULT_AXIS_STEPS_PER_UNIT   { 80, 80, 400, 93 }
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

TheKillerOfMarsh, 2021-02-05:
Hi! My problem is not the configuration of the extruder steps, the problem is that after compiling the Marlin downloaded from here, it does the update well and it hangs on the Marlin logo, and I only modify the steps and do not touch anything else, in  change the .bin also downloaded from here is perfect.  I don't know what can change?

mks-viva, 2021-02-06:
You mean hex file?

TheKillerOfMarsh, 2021-02-06:
Yes, I mean that when updating well and restarting it remains frozen in the Marlin logo, if with that hex file it could be solved?  incidentally, how is the hex file used?  greetings and thanks!

mks-viva, 2021-02-08:
This is not helpful, because the same marlin firmware settings, bin and hex are the same

mks-viva, 2021-02-08:
So, I will close this issues

Closed 2021-02-08.

Thread 74 (2021-02-06):

I need firmware ".bin" file for ENDER 5

azatalp, 2021-02-06:
I'try to do any kind of think for setup on card. But whatever I try cant setup on mks e3 card. Every time gave me error. How 2.0.6.1 is freeze on screen after %100. Please just give working 2.0.6 fw .bin file.

azatalp, 2021-02-08:
Why anyone doesn't give me any kind of help??

mks-viva, 2021-02-08:
Hi！I am sorry！We have not add bin file for ender5，we  will add it after february 24

azatalp, 2021-02-08:
Ok I will wait for it

arsene-r2, 2021-02-28:
Hello, any updates on this?

azatalp, 2021-03-03:
I'm still waiting for this..

azatalp, 2021-03-03:
> Hi！I am sorry！We have not add bin file for ender5，we will add it after february 24

24 feb is passed? Please help us.

mks-viva, 2021-03-06:
I has upload it, you can test it, if have bug and i will fix it

mks-viva, 2021-03-06:
https://github.com/makerbase-mks/MKS-Robin-E3-E3D/tree/master/firmware/V1.1

mks-viva, 2021-04-01:
I will close this issues temporily

Closed 2021-04-01.

Thread 75 (2021-02-11):

Firmware for CR10S5+BL touch

countcobolt, 2021-02-11:
Hi all

I am wondering if there is a configuration file for the CR10S5? I will receive the board soonish, but want to make sure I don't brick it.
I did already compile a version already with platformio, but to enable TMC_Debug I had to disable SD Card support. Will this give issues if I make a mistake and want to install a new version (using an SD Card).
Is there a tutorial to install firmware using the STLink app?

mks-viva, 2021-02-12:
No, you only change some parameters and build it

mks-viva, 2021-04-24:
I will close this issues temporarily

Closed 2021-04-24.

Thread 77 (2021-02-15):

SD not working and firmware update

vinacc, 2021-02-15:
I just got the Robin E3 card with firmware 2.0.6. Mounted on my Ender 3 I cannot update the firmware. Inserting the bin file inside the SD gives me the SD ERR message. How can I solve?

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

mks-viva, 2021-02-21:
Hi! You can try to format the TF card, and the format is FAT32

vinacc, 2021-02-21:
Hi, yes I tried to reformat it in FAT32 format but it doesn't work. I have installed OctoPi and connected a Raspberry to my Ender 3. When I start OctoPi the SD inside the Robin E3 is seen and I can also read and write but when I disconnect the raspberry the SD is no longer seen.

mks-viva, 2021-02-22:
Can you try to re-insert the card or replace the TF card to test. If this error occurs, the card status is not detected

vinacc, 2021-02-22:
already tried, the board is enabled only after connecting the raspberry. And unfortunately I am unable to perform a software update

mks-viva, 2021-02-25:
I suggest you use a new TF card

vinacc, 2021-02-28:
Through a software such as Repetier Host, by connecting the card to my Mac and sending the M21 command to the printer, the SD is mounted and viewed correctly. The problem is that turning off the printer loses the setting. It is as if the SD on the firmware were disabled by default. Is it possible to update the firmware without using the SD?

mks-viva, 2021-03-06:
Can you provide your firmware to me and i will test it?

vinacc, 2021-03-13:
> Can you provide your firmware to me and i will test it?

[Robin_e3.bin.zip](https://github.com/makerbase-mks/MKS-Robin-E3-E3D/files/6134898/Robin_e3.bin.zip)

mks-viva, 2021-08-19:
I'm sorry, I forgot to reply you, your firmware I updated without any problems, maybe you need to format the TF card, or replace the TF card.

Closed 2021-08-23.

Thread 80 (2021-02-17):

V1.0 and V1.1

ll777, 2021-02-17:
What is the difference between the V1.0 and V1.1 Firmware? Their description is the same:
V1.0 - Upload E3/E3D V1.1 firmware
V1.1 - Upload E3/E3D V1.1 firmware

mks-viva, 2021-02-20:
Hi, yon? can refer to hardware path information

ll777, 2021-02-20:
The Full path for them is:
https://github.com/makerbase-mks/MKS-Robin-E3-E3D/tree/master/firmware
where I can find both folders
https://github.com/makerbase-mks/MKS-Robin-E3-E3D/tree/master/firmware/V1.0
and
https://github.com/makerbase-mks/MKS-Robin-E3-E3D/tree/master/firmware/V1.1

mks-viva, 2021-02-21:
Like this:
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

Amppa, 2021-03-27:
@mks-viva
So if the PCB print with "MKS Robin E3 V1.0", means it is V1.0 hardware right?
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

I noticed that V1.0 used Marlin ver2.0.6. The V1.1 is built from Marlin ver2.0.6.1
I wonder if I can build V1.0 on the newest Marlin

mks-viva, 2021-03-27:
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

Yes，you can. You only define motherboard is MKS_ROBIN_E3_V1_0

Closed 2021-02-21.

Thread 81 (2021-02-22):

Can't connect via usb, Pronterface/Cura

SenorGuacamole, 2021-02-22:
I've been trying to connect my printer via usb to send g-code commands and can't get either pronterface or Cura to recognize it. I get a notification that Windows is installing drivers when I connect, so I know the usb port and cable are working. Windows fails to find a driver though. Is there a driver file available for these boards? I have the E3D v1.1

SenorGuacamole, 2021-02-22:
I finally found a solution. installing the CH340 driver allowed pronterface to see the printer.
https://support.th3dstudio.com/hc/downloads/drivers/ch340-drivers-th3d-uno-creality-v1-1-x-v4-2-x-board/

Closed 2021-02-22.

Thread 82 (2021-02-23):

2 FAN in J5 up and down doesn't work on E3 v1.0. How to tune it?

zyystudio, 2021-02-23:

mks-viva, 2021-02-25:
You only open it by LCD or send "M106"，close send "M107"

zyystudio, 2021-02-25:
Thanks. Can you please me know the setting entry in LCD menu?

Closed 2021-02-25.

Thread 83 (2021-02-26):

Runout sensor

mtmello2003, 2021-02-26:
With this marlin version: 2.0.6 the runout sensor is broken.

Please update or even downgrade the marlin version to another one that this routine is working.

Thanks

mks-viva, 2021-03-05:
Can not work normally?

mtmello2003, 2021-03-05:
> Can not work normally?

Unfortunately not. Marlin at this version (2.0.6) has a bug in this routine (runout sensor) and it isn´t working at all. Latest version is okay and previous also okay.

mtmello2003, 2021-03-05:
All detail in marlin github issue:
https://github.com/MarlinFirmware/Marlin/issues/14337

Thread 86 (2021-03-08):

mks robin E3D does not update firmware.

NachoFrutos, 2021-03-08:
The board does not update the firmware through the microSD slot (TF CARD). Three different FAT32-formatted cards have been tested. Neither. The marlin version is 2.0.7. The printer is a custom one. I attach the compiled .bin file and the files configuration.h / configuration_adv.h

[marlin 2.0.7.zip](https://github.com/makerbase-mks/MKS-Robin-E3-E3D/files/6104809/marlin.2.0.7.zip)

mks-viva, 2021-03-13:
Hi! I has test your firmware on my board and it cann't update firmware. Can you provide your firmware source code to me?

NachoFrutos, 2021-03-13:
Hello, I am attaching the entire project so that you can compile it. The problem is that it updates the firmware whenever it wants. I also inform you that the BLTOUCH does not work for me as end stop z. This all well wired according to the information on the wiki. The M280 commands do not work. Tell you that if I put a mks gen L board, everything works perfectly. So I don't know if it's the marlin configuration with the BLTOUCH. But this is all according to the wiki.

SOUERCE CODE:

https://drive.google.com/file/d/1vmPtLTwbKKEtbaFXXKdVWzMjOhyO3itn/view?usp=sharing

mks-viva, 2021-03-16:
Maybe you need to format your TF card, or replace it with another TF card to test it

runobreis, 2021-04-06:
Similar issue here..The firmware updates but stops at the marlin intro logo, I've already tried all versions on this link: https://github.com/makerbase-mks/MKS-Robin-E3-E3D/tree/master/firmware/V1.1/Firmware%20bin%20for%20ender3

sergiofagundes, 2021-09-17:
FIXED 100% working:

the board if using a 4GB sdcard,
I tried with 8GB/16GB/32GB and none of them worked.
So I tried a 4GB sdcard and it worked.

I used the Sdcard on the LCD sdcard slot, but I think it should work also in the mks robin board sdcard slot also with only 4GB sdcard.

The sdcard I used that worked: 4GB SanDisk Class 4 HC
The sdcars I used that didn't work: 8GB/16GB/32GB generic Class 10 HC

dtee, 2021-11-09:
I am having the same issue w/ klipper. Tried manual copy of firmware file, tried using flash-sdcard.sh - nothing seem to work, it just won't update the firmware. I am not even sure how it got 'v0.9.1-580-g478f26ca' in the first place from the same sd card (I am not sure if that's the version downloaded from mks site or something i compiled.). Here are the logs

```
# pi @ craftbot in ~/klipper on git:2a964a46 x [5:39:13]
$ ./scripts/update_mks_robin.py out/klipper.bin out/Robin_e3.bin

# pi @ craftbot in ~/klipper on git:2a964a46 x [5:39:20]
$ ./scripts/flash-sdcard.sh /dev/serial/by-id/usb-1a86_USB_Serial-if00-port0 mks-robin-e3
Flashing /home/pi/klipper/out/klipper.bin to /dev/serial/by-id/usb-1a86_USB_Serial-if00-port0
Converting Klipper binary to MKS Robin format...Done
Checking FatFS CFFI Build...
Connecting to MCU....Connected
Checking Current MCU Configuration...Done
MCU needs restart: is_config=1, is_shutdown=0
Attempting MCU Reset...Done
Waiting for device to reconnect...Done
Connecting to MCU.........................Connected
Initializing SD Card and Mounting file system...

SD Card Information:
Version: 2.0
SDHC/SDXC: True
Write Protected: False
Sectors: 7829504
manufacturer_id: 40
oem_id: BE
product_name: ND4GB
product_revision: 2.34
serial_number: 56F23A7F
manufacturing_date: 8/2017
capacity: 3.7 GiB
fs_type: FAT32
volume_label: card
volume_serial: 2900737796
Uploading Klipper Firmware to SD Card...Done
Validating Upload...Done
Firmware Upload Complete: Robin_e3.bin, Size: 21376, Checksum (SHA1): E592217D24482127D48FFBD69EDDDC0EC4E66B33
Attempting MCU Reset...Done
Waiting for device to reconnect...Done
Connecting to MCU.........................Connected
Verifying Flash...
SD Card Flash Error: Version Mismatch: Got 'v0.9.1-580-g478f26ca...', expected 'v0.10.0-0-g2a964a46...'
Traceback (most recent call last):
  File "/home/pi/klipper/scripts/spi_flash/spi_flash.py", line 1159, in main
    spiflash.run()
  File "/home/pi/klipper/scripts/spi_flash/spi_flash.py", line 1113, in run
    self.run_reactor_task(self.run_verify)
  File "/home/pi/klipper/scripts/spi_flash/spi_flash.py", line 1095, in run_reactor_task
    k_reactor.run()
  File "/home/pi/klipper/klippy/reactor.py", line 269, in run
    g_next.switch()
  File "/home/pi/klipper/klippy/reactor.py", line 310, in _dispatch_loop
    timeout = self._check_timers(eventtime, busy)
  File "/home/pi/klipper/klippy/reactor.py", line 156, in _check_timers
    t.waketime = waketime = t.callback(eventtime)
  File "/home/pi/klipper/klippy/reactor.py", line 48, in invoke
    res = self.callback(eventtime)
  File "/home/pi/klipper/scripts/spi_flash/spi_flash.py", line 1084, in run_verify
    self.new_dictionary)
  File "/home/pi/klipper/scripts/spi_flash/spi_flash.py", line 966, in verify_flash
    json.loads(req_dictionary)['version']))
SPIFlashError: Version Mismatch: Got 'v0.9.1-580-g478f26ca...', expected 'v0.10.0-0-g2a964a46...'

```

Thread 87 (2021-03-10):

Firmware compiles but doesn't update the board

wiviolima, 2021-03-10:
On a E3 v1.0. able to flash the firmware, but the board always errors out when flashing - blue led blinks once or twice, then red led lights up and turns off. Firmware on sd card disappears, and I only find a .cur file. I`ve tried flashing other bins I've found and one of them flashes, but it isn't configured for my printer.

I've tried reinstalling everything on my PC, tried another computer, and still nothing.

I've tried the solutions on this  [link](https://github.com/MarlinFirmware/Marlin/issues/19363#issuecomment-691622797) and the one named Robin_e3.tassiolucas.zip' works, but the other one doesn't. While Robin_e3.tassiolucas.zip works, I need to tweak the code.

I have an ender 2 (150x150 build plate), with a RepRapDiscount FULL GRAPHIC Smart Controller (although I tried compiling without it and still no go).

mks-viva, 2021-03-16:
Hi! You need copy Robin_e3.bin file to TF card and update.

Closed 2021-04-24.

Thread 88 (2021-03-14):

PWC issue

ptitpuma, 2021-03-14:
hi , i,m trying to use a pwc board on my robin E3D with tft 35but i;ve got some troubles....
when i enter the code
  #if ENABLED(PSU_CONTROL)
    #ifndef PS_ON_PIN
       #define PS_ON_PIN         PC5    //PW_OFF, you can change it to other pin
    #endif
it show me that:
Verbose mode can be enabled via `-v, --verbose` option
In file included from buildroot/share/PlatformIO/scripts/../../../../Marlin/src/inc/../pins/stm32f1/pins_MKS_ROBIN_E3.h:36:0,
                 from buildroot/share/PlatformIO/scripts/../../../../Marlin/src/inc/../pins/pins.h:492,
                 from buildroot/share/PlatformIO/scripts/../../../../Marlin/src/inc/MarlinConfig.h:34,
                 from buildroot/share/PlatformIO/scripts/common-dependencies.h:31:
buildroot/share/PlatformIO/scripts/../../../../Marlin/src/inc/../pins/stm32f1/pins_MKS_ROBIN_E3_common.h:198:0: error: unterminated #if
 #if ENABLED(PSU_CONTROL)

CalledProcessError: Command '"C:\Users\lalon\.platformio\packages\toolchain-gccarmnoneeabi\bin\arm-none-eabi-g++.exe" -DTARGET_STM32F1 -D__MARLIN_FIRMWARE__ -DARDUINO_ARCH_STM32 -DDEBUG_LEVEL=0 -DSS_TIMER=4 -D__MARLIN_DEPS__ -w -dM -E -x c++ buildroot/share/PlatformIO/scripts/common-dependencies.h' returned non-zero exit status 1.:
  File "C:\Users\lalon\.platformio\penv\lib\site-packages\platformio\builder\main.py", line 175:
    env.SConscript(item, exports="env")
  File "C:\Users\lalon\.platformio\packages\tool-scons\scons-local-4.1.0\SCons\Script\SConscript.py", line 591:
    return _SConscript(self.fs, *files, **subst_kw)
  File "C:\Users\lalon\.platformio\packages\tool-scons\scons-local-4.1.0\SCons\Script\SConscript.py", line 280:
    exec(compile(scriptdata, scriptname, 'exec'), call_stack[-1].globals)
  File "C:\Users\lalon\Downloads\Marlin-bugfix-2.0.x (1)\Marlin-bugfix-2.0.x\buildroot\share\PlatformIO\scripts\common-dependencies.py", line 327:
    apply_features_config()
  File "C:\Users\lalon\Downloads\Marlin-bugfix-2.0.x (1)\Marlin-bugfix-2.0.x\buildroot\share\PlatformIO\scripts\common-dependencies.py", line 141:
    if not env.MarlinFeatureIsEnabled(feature):
  File "C:\Users\lalon\.platformio\packages\tool-scons\scons-local-4.1.0\SCons\Util.py", line 658:
    return self.method(*nargs, **kwargs)
  File "C:\Users\lalon\Downloads\Marlin-bugfix-2.0.x (1)\Marlin-bugfix-2.0.x\buildroot\share\PlatformIO\scripts\common-dependencies.py", line 292:
    load_marlin_features()
  File "C:\Users\lalon\Downloads\Marlin-bugfix-2.0.x (1)\Marlin-bugfix-2.0.x\buildroot\share\PlatformIO\scripts\common-dependencies.py", line 280:
    define_list = subprocess.check_output(cmd, shell=True).splitlines()
  File "C:\Users\lalon\.platformio\python3\lib\subprocess.py", line 411:
    **kwargs).stdout
  File "C:\Users\lalon\.platformio\python3\lib\subprocess.py", line 512:
    output=stdout, stderr=stderr)

i've try with the lcd code and it compile but when i flash i've got Printer Halted
i've try to uncomment the line which are not in the first code and the printer boot but when it's time to shutdown the printer say closing machine but never do it

what is the solution please

mks-viva, 2021-03-16:
Can you provide your firmware source code to me?

ptitpuma, 2021-03-16:
I'm using marlin bugfix 2.0.x
I can share my config.h and config adv.h tonight

ptitpuma, 2021-03-18:
[config.zip](https://github.com/makerbase-mks/MKS-Robin-E3-E3D/files/6161692/config.zip)

mks-viva, 2021-03-21:
Ok ! I will test it and use the latest marlin

ptitpuma, 2021-04-09:
Hi have test ?

mks-viva, 2021-04-22:
I has test the latest version marlin bigfix firmware and upload it for you. Marlin has change same partments and i has update our Wiki about hou to use MKS PWC module.
[Robin_e3-TEST PWC.zip](https://github.com/makerbase-mks/MKS-Robin-E3-E3D/files/6354900/Robin_e3-TEST.PWC.zip)

[Marlin-bugfix-2.0.x-TEST PWC.zip](https://github.com/makerbase-mks/MKS-Robin-E3-E3D/files/6354896/Marlin-bugfix-2.0.x-TEST.PWC.zip)

ptitpuma, 2021-04-24:
Hi is .bin configure with my marlin setting ? Because the bugfix need to be set

mks-viva, 2021-04-24:
No, you need reconfig it according to your config file. I just tested the PWC function and it works normally.

ptitpuma, 2021-04-24:
Ok I'll try 😉

ptitpuma, 2021-04-24:
I've build with your marlin bugfix but it still doesn't work when I push on button the tft still say closing machine with no effect and the LCD show me killed printer halted please reset

ptitpuma, 2021-04-26:
I've found something the code you tell was wrong I must write this
#if ENABLED(PSU_CONTROL)
  #ifndef PS_ON_PIN
    #define PS_ON_PIN         PC5    //PW_OFF, you can change it to other pin
  #endif
#endif

But when I push stop button the tft still say closing machine and the LCD show me power off but still stuck on this with no effect and I've found a bug the tft35 isn't working well when I send a print it start heating the bed but on the tft no temp is moving and when the bed is at the right temp the hotend never start heating it's like no order is send and no info are received from the board to the tft

mks-viva, 2021-04-27:
I don’t know you used MKS TFT screen, then you should refer to it WIKI (With the MKS TFT)：https://github.com/makerbase-mks/MKS-Robin-E3-E3D/wiki/MKS_PWC
You need remove it in pins_MKS_ROBIN_E3_common.h file
```
  #ifndef KILL_PIN
    #define KILL_PIN          PB10    //PW_DET, you can change it to other pin
  #endif
  #define KILL_PIN_INVERTING  true     //true : HIGH level trigger
  #define KILL_PIN_STATE      KILL_PIN_INVERTING
```
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

mks-viva, 2021-04-27:
PW_OFF signal connect to E3's PC5
PW_DET signal connect to TFT's PB4

ptitpuma, 2021-04-27:
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

I've done this

ptitpuma, 2021-04-27:
> PW_OFF signal connect to E3's PC5
> PW_DET signal connect to TFT's PB4

So I think here is the issue about TFT not working as I have the LCD connect on E3 exp 1 the PC5 is already use how can I do of I want my TFT and my LCD ?

mks-viva, 2021-04-30:
Can you provide your board wiring to me? May be i need check it.

ptitpuma, 2021-04-30:
Ok I have found a part off my trouble it was a faulty wire... I have on my board plug TFT on aux 1
Plug PW det on TFT pb4 and plug PW Off to PC5 on the board (this wire was faulty) now I still have trouble ( but the pcw work ) when I launch a print on TFT it never start, when it's by the E3 board SD card no trouble I have reflash the tft no change...  And I need to know if it's normal that now my printer stop alone

ptitpuma, 2021-05-18:
@mks-viva

mks-viva, 2021-05-19:
Was it possible to print normally before? Can the temperature still be detected?

ptitpuma, 2021-05-19:
Yes it was possible before... Now when I launch a print no temperature are detected

mks-viva, 2021-05-19:
You need check you temperature wiring

ptitpuma, 2021-05-19:
If I launch a print on my LCD every temperature are good and working if I do preheat on the TFT everything works well it's only when I launch a print that trouble arrive like in this post
https://github.com/makerbase-mks/MKS-TFT/issues/225

ptitpuma, 2021-05-30:
@mks-viva

bevanweiss, 2021-09-18:
So you have BOTH a TFT LCD, and another LCD connected?
What are your connections for this?

Your config file doesn't mention that you have the TFT35
//
// 480x320, 3.5", FSMC Display From MKS
// Normally used in MKS Robin Nano V1.2
//
//#define MKS_ROBIN_TFT35

And if you have an LCD which is using LCD_D7 (PC5), then using PC5 for your PWC would not work.  You would need to select a different IO pin which is NOT already in use by another of your interfaces (i.e. not LCD, not TFT, not LIMITS / PROBE / NEOPIXEL / STEPPERS etc)

ptitpuma, 2021-10-01:
Hi @bevanweiss
I have my original cr10 LCD and my TFT connected my LCD is connected on  ender3/exp1 and my TFT on aux-1...
Should I mention TFT on marlin as it was working well before I try to make pwc working ?
Which IO pin should I select ? I haven't got NEOPIXEL on my printer can I use one of this ? Thanks for your help btw

bevanweiss, 2021-10-02:
Yeah, the NeoPixel data pin (PA2) should work.

ptitpuma, 2022-06-13:
@bevanweiss
I need your help today I have tried to update my printer but when I try to comment my TFT on marlin I always get errors could you help me please

Thread 89 (2021-03-23):

Octoprint and MKS E3D V1.1 - Printer Hanged

pacocatech, 2021-03-23:
Hello folks,

I saw issues #18 and #19 that relate same problem but the problem continues.
I changed the baudrate to 115200 and increase buffersize after 10 mins printer hanged again.
MKS E3D v1.1 is compatible with Octoprint?
How to solve this HUGE problem?

Sebe47, 2021-03-25:
cant even connect via Octoprint to the Printer :-(

mks-viva, 2021-03-26:
Hi! I think, you can use pronterface via USB and printing gcode test, and i think it and it's work ok?
After, if you use Octoprint and it's not work, so, you need check Octoprint settings.

mks-viva, 2021-04-24:
I will close this issues temprarily

Closed 2021-04-24.

Thread 91 (2021-03-25):

how to use chinese simplified in ender3 default display and E3 motherboard

zyystudio, 2021-03-25:
I have gone through the site and successfully compiled the 2.0.6.1 marlin with E3 and 3d touch with my parameters to flash the ender3.
However I do see there is simplified chinese version for E3D.
Is there documentation how to do that?
Thanks
Stanley

zyystudio, 2021-03-26:
BTW the display model on ender3 by default is LCD12864

zyystudio, 2021-03-26:
#define LCD_LANGUAGE zh_CN

zyystudio, 2021-03-26:
?
It seems overflow the 256K of STM32F103RCT6 right?

mks-viva, 2021-03-26:
Yes, if you use Chinese, it is easy to cause the Flash to be larger than 256kb. Therefore, you need to block the boot logo, etc. Maybe, you refer to **Marlin-2.0.6.1_E3D_V1.0_Chinese_TMC2209** source code and it's will make sense.

zyystudio, 2021-03-26:
aha! it's you again! Thanks. That's a good idea! Lovely!

zyystudio, 2021-03-26:
Wonderful! Solved! shrink several ones! Love you!

mks-viva, 2021-03-27:
Haha! So, i will close this issues temporily.

Closed 2021-03-27.

Thread 92 (2021-03-25):

Cant connect to Printer via USB

Sebe47, 2021-03-25:
Hello im using the "Marlin-2.0.6.1_for_ender3_TMC2209+3dtouch+Z_SAFE_HOMING" Firmware

I cant get managed to connect to the Printer via USB

Tryed it with my Computer and with Octoprint.

mks-viva, 2021-03-26:
Hi! If you use pronterface connect to board and it's work ok?

aabeuge, 2021-04-29:
FWIW, I believe the CH340 usb to serial chips (which Robin E3 uses) can be damaged if the raspberry pi is connected to the board without its own external power.  This is because the pi 5v rail is connected to its usb connector so the pi will try to power itself through the usb connection to the Robin E3 board.  When this happens too much current moves through the ch340 chip and kills it.  I discovered this while using ramps boards with a mega2560 clone that had the ch340 chip on it and killed three boards within a couple days.  I bought some replacement ch340 chips off eBay for cheap and replaced mine and all three boards usb worked again after.

You can try to use the AUX1 serial connection (refer to the hardware section of the git for pin out) with separate usb FTDI or connect raspberry pi through it's serial pins.  If it works then your ch340 chip might need replaced or just continue  to use the AUX1 serial connection permanently.

countcobolt, 2021-07-01:
Make sure you have enabled the second serial port if you are using UART. The first one is already in use.

Closed 2021-08-03.

Thread 93 (2021-03-26):

MKS robin E3D use MKS OLED no working

a4870010, 2021-03-26:
Use MKS robin e3d motherboard, connect MKS OLED0.96 display, but no working and i has add pin define to pins_MKS_ROBIN_E3_common file
```
  #if ENABLED(MKS_12864OLED_SSD1306)
        #define LCD_PINS_DC          PA7  // Set as output on init
        #define LCD_PINS_RS          PC4  // Pull low for 1s to init
        #define DOGLCD_A0            LCD_PINS_DC
        #define DOGLCD_CS            PA5
        #define DOGLCD_MOSI          PA4
        #define DOGLCD_SCK           PA6
  #endif
```
[Config.and.pin.zip](https://github.com/makerbase-mks/MKS-Robin-E3-E3D/files/6211656/Config.and.pin.zip)

Use RAMPS1.4 motherboard and MKS OLED0.96 will working
I am run offical marlin bug-fix 2.0.x version

mks-viva, 2021-04-07:
May be i need test it

mks-viva, 2021-08-10:
Marlin have not support SPI oled on STM32, so, i suggest you to consider using MKS MINI12864 V3. I will close this issues.

Closed 2021-08-10.

Thread 94 (2021-03-28):

3dtouchv2.0

zyystudio, 2021-03-28:
I tried the code with e3+2209+3dtouch and compiled successfully. The issue is that it forget the x and y spaces when starting to print.
I also tried the compiled bin file from this repository with e3 2209 3dtouch. It happens the same one - once staring to print, it will stuck in the (0,0,0) and fastly move to the y value of the model.
Any idea? Can you try from your side?

zyystudio, 2021-03-28:
https://user-images.githubusercontent.com/7643104/112749792-4909b880-8ff7-11eb-8ea4-8f098584ef58.MP4

see the video with both kind of firmware

a4870010, 2021-03-29:
回零方向不对，因为2209驱动和原来是相反的，固件里修改一下方向就可以了

zyystudio, 2021-03-29:
> 回零方向不对，因为2209驱动和原来是相反的，固件里修改一下方向就可以了

感觉你说的不对。一是这个刚刚开始打印，已经归零后的视频。二是偶尔后面有两次撞大运一样是可以正常打印出来的，但基本都是这个状态直接跑到（0，y，0）的位置开始打印。感觉是忘记了或者说是计算错误打印空间。 等官网回复吧

a4870010, 2021-03-30:
如果切片没问题的话，电机正反也没问题的话，排除一下固件的问题，用marlin官方最新的bugfix固件刷写测试，一样一样排除。

zyystudio, 2021-03-31:
Any update or test result from official side?
Thanks

zyystudio, 2021-03-31:
sorry! I think I found the root cause. Thanks and please continue to make great product for Made In China!!!

Closed 2021-03-31.

Thread 95 (2021-03-30):

error: #error "No E stepper plug left for Z2!

Niptoc, 2021-03-30:
Hello,

I want to compile MKS Robin E3 V1.0 for a CR-10 with a dual Z motor with marlin  2.0.7.2 and I get an error when compiliing:

``buildroot/share/PlatformIO/scripts/../../../../Marlin/src/inc/../pins/pins.h:1410:8: error: #error "No E stepper plug left for Z2!``

I have set in `Configuration_adv.h`
`#define NUM_Z_STEPPER_DRIVERS 2   // (1-4) Z options change based on how many`

In the pins definition I don't see PINs for Z2. ( `pins_MKS_ROBIN_E3_common.h`)
```
//
// Steppers
//
#define X_STEP_PIN                          PC0
#define X_DIR_PIN                           PB2
#define X_ENABLE_PIN                        PC13

#define Y_STEP_PIN                          PC2
#define Y_DIR_PIN                           PB9
#define Y_ENABLE_PIN                        PB12

#define Z_STEP_PIN                          PB7
#define Z_DIR_PIN                           PB6
#define Z_ENABLE_PIN                        PB8

#define E0_STEP_PIN                         PB4
#define E0_DIR_PIN                          PB3
#define E0_ENABLE_PIN                       PB5
```

mks-viva, 2021-04-01:
Hi! MKS Robin E3 have not E1 axis, you can use Z2 interface

Niptoc, 2021-04-01:
Hi, Sorry but I'm not sure to understand.
What do you mean by using Z2 interface ?

mks-viva, 2021-04-01:
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
Z1 and Z2 interface

Niptoc, 2021-04-01:
This is what I plan to use. But are the Z1 and Z2 independant (Can we use them independantly) so that I can use the implemented feature to autocalibrate the Z axis.
When I check the drawing for PINs and the PIN configuration file there are no distinction for Z1 and Z2.

mks-viva, 2021-04-02:
They are connected in parallel. Since MKS Robin E3 has only 4 axes, you cannot define independent Z2

Niptoc, 2021-04-02:
Ok, thank you for the answer, it is clear now :)

Closed 2021-04-02.

Thread 96 (2021-03-30):

Compilation error

Niptoc, 2021-03-30:
Hello

I also have compilation error for a CR10.
I want to use the TFT 35 and I got the error message :
In file included from Marlin\src\HAL\STM32F1\../../inc/MarlinConfig.h:49:0, from Marlin\src\HAL\STM32F1\HAL.cpp:30: Marlin\src\HAL\STM32F1\../../inc/SanityCheck.h:839:6: error: #error "ADVANCED_PAUSE_FEATURE requires a supported LCD controller (or EMERGENCY_PARSER)." #error "ADVANCED_PAUSE_FEATURE requires a supported LCD controller (or EMERGENCY_PARSER)."

I have activated the ADVANCED_PAUSE_FEATURE to be able to use the filament detector.

Do anyone encounter the same issue?

mks-viva, 2021-04-01:
Hi! If you want to use filament detector function, you can MKS TFT35's filament detector function and does't setting marlin.

Niptoc, 2021-04-01:
Ok, I removed from Marlin the filament runout detector and deactivated the ADVANCED_PAUSE_FEATURE.

I am using latest Marlin version 2.0.7.2 and I got new error messages.
I am compiling using the `env: mks_robin_e3` . I hope this is the right one.

```
In file included from Marlin\src\HAL\STM32F1\tft\tft_fsmc.cpp:28:0:
C:\Users\user\.platformio\packages\framework-arduinoststm32-maple\STM32F1\system\libmaple\include/libmaple/fsmc.h:47:2: error: #error "FSMC is unavailable on your MCU"
 #error "FSMC is unavailable on your MCU"
  ^~~~~
Marlin\src\HAL\STM32F1\tft\tft_fsmc.cpp: In static member function 'static void TFT_FSMC::Init()':
Marlin\src\HAL\STM32F1\tft\tft_fsmc.cpp:89:16: error: 'FSMC_CS_PIN' was not declared in this scope
   uint8_t cs = FSMC_CS_PIN, rs = FSMC_RS_PIN;
                ^~~~~~~~~~~
Marlin\src\HAL\STM32F1\tft\tft_fsmc.cpp:89:16: note: suggested alternative: 'FSMC_CS_NE1'
   uint8_t cs = FSMC_CS_PIN, rs = FSMC_RS_PIN;
                ^~~~~~~~~~~
                FSMC_CS_NE1
Marlin\src\HAL\STM32F1\tft\tft_fsmc.cpp:115:11: error: 'rs' was not declared in this scope
   switch (rs) {
           ^~
Marlin\src\HAL\STM32F1\tft\tft_fsmc.cpp:115:11: note: suggested alternative: 'cs'
   switch (rs) {
           ^~
           cs
Marlin\src\HAL\STM32F1\tft\tft_fsmc.cpp:155:17: error: 'GPIOE' was not declared in this scope
   gpio_set_mode(GPIOE,  7, GPIO_AF_OUTPUT_PP);  // FSMC_D04
                 ^~~~~
Marlin\src\HAL\STM32F1\tft\tft_fsmc.cpp:155:17: note: suggested alternative: 'GPIOD'
   gpio_set_mode(GPIOE,  7, GPIO_AF_OUTPUT_PP);  // FSMC_D04
                 ^~~~~
                 GPIOD
Marlin\src\HAL\STM32F1\tft\tft_fsmc.cpp:172:25: error: 'rs' was not declared in this scope
   gpio_set_mode(PIN_MAP[rs].gpio_device, PIN_MAP[rs].gpio_bit, GPIO_AF_OUTPUT_PP);  //FSMC_RS_Ax
                         ^~
Marlin\src\HAL\STM32F1\tft\tft_fsmc.cpp:172:25: note: suggested alternative: 'cs'
   gpio_set_mode(PIN_MAP[rs].gpio_device, PIN_MAP[rs].gpio_bit, GPIO_AF_OUTPUT_PP);  //FSMC_RS_Ax
                         ^~
                         cs
*** [.pio\build\mks_robin_e3\src\src\HAL\STM32F1\tft\tft_fsmc.cpp.o] Error 1
```

Do you know how I can solve this?

mks-viva, 2021-04-01:
Can you provide your config to me?

Niptoc, 2021-04-01:
Here are the config (renamed in .txt)
[pins_MKS_ROBIN_E3.txt](https://github.com/makerbase-mks/MKS-Robin-E3-E3D/files/6243251/pins_MKS_ROBIN_E3.txt)
[pins_MKS_ROBIN_E3_common.txt](https://github.com/makerbase-mks/MKS-Robin-E3-E3D/files/6243252/pins_MKS_ROBIN_E3_common.txt)
[Configuration.txt](https://github.com/makerbase-mks/MKS-Robin-E3-E3D/files/6243242/Configuration.txt)
[Configuration_adv.txt](https://github.com/makerbase-mks/MKS-Robin-E3-E3D/files/6243243/Configuration_adv.txt)

In case this is not enough here is whole Marlin file.
Linked to this issue I have also the double Z axis. But to try to reach a first compilable file I have set to 1 Z axis, BLTouch enable, No runout filament detector (but I have one so I would like to make it work also)
[Marlin-2.0.7.2.zip](https://github.com/makerbase-mks/MKS-Robin-E3-E3D/files/6243261/Marlin-2.0.7.2.zip)

mks-viva, 2021-04-02:
You need set it in configuration.h file
1. Set : #define SERIAL_PORT 1 // For MKS TFT35
2. Disable "#define MKS_ROBIN_TFT35", this is not MKS TFT35
You can refer to Wiki about 'How to use MKS TFT': https://github.com/makerbase-mks/MKS-Robin-E3-E3D/wiki/Display_MKS_TFT24_35_70

Niptoc, 2021-04-02:
Thank you for your support !
I didn't see this link  for the screen

Closed 2021-04-02.

Thread 97 (2021-04-03):

Sensorless homing with z_axis never work

pinball83, 2021-04-03:
- Setup jumpers zdiag
- Turn of x/y/z endstop
- Enable Sensorless homing for all axis x/y/z
- Configuration_adv.h:

```
  #define SENSORLESS_HOMING // StallGuard capable drivers only

  #if EITHER(SENSORLESS_HOMING, SENSORLESS_PROBING)
    // TMC2209: 0...255. TMC2130: -64...63
    #define X_STALL_SENSITIVITY  200
    #define X2_STALL_SENSITIVITY X_STALL_SENSITIVITY
    #define Y_STALL_SENSITIVITY  200
    #define Y2_STALL_SENSITIVITY Y_STALL_SENSITIVITY
    #define Z_STALL_SENSITIVITY  200
    #define Z2_STALL_SENSITIVITY Z_STALL_SENSITIVITY
```

- Configuration.h

```
#define INVERT_X_DIR false
#define INVERT_Y_DIR false
#define INVERT_Z_DIR true
```

```
// Mechanical endstop with COM to ground and NC to Signal uses "false" here (most common setup).
#define X_MIN_ENDSTOP_INVERTING false // Set to true to invert the logic of the endstop.
#define Y_MIN_ENDSTOP_INVERTING false // Set to true to invert the logic of the endstop.
#define Z_MIN_ENDSTOP_INVERTING false // Set to true to invert the logic of the endstop.
#define X_MAX_ENDSTOP_INVERTING false // Set to true to invert the logic of the endstop.
#define Y_MAX_ENDSTOP_INVERTING false // Set to true to invert the logic of the endstop.
#define Z_MAX_ENDSTOP_INVERTING false // Set to true to invert the logic of the endstop.
#define Z_MIN_PROBE_ENDSTOP_INVERTING false // Set to true to invert the logic of the probe.
```

X and Y sensorsless homing working correct
Z did not

mks-viva, 2021-04-07:
I suggest you don’t use this function for Z axis

mks-viva, 2021-04-24:
I will close this issues temporarily

Closed 2021-04-24.

Thread 98 (2021-04-06):

Unable to flash self-compiled binary

Stalkk, 2021-04-06:
Hello,

i have a issue with E3 V1.1 and Ender 3. I am able to compile the binary with VisualStudio Code and platformio but flashing from SD  (yes i renamed the binary  to Robin_e3.bin) **is stopped on 100%**. After reboot it hangs in **"boot"** screen.

The precompiled Marlin-2.0.6.1_for_ender3_TMC2209.bin can be flashed and works but i need to change the config for my printer and compile the own version.

I have tried to build the firmware with older version of Platfprmio, with platformio core on linux, with platformio in Atom IDE and in VS Code - same behavior.

P.S. i just take the sources from your git and compile it without any changes.

Thank you for your help.

mks-viva, 2021-04-07:
Hi! You need copy Robin_e3.bin file to TF card.
Doesn't use firmware.bin rename as Robin_e3.bin

Stalkk, 2021-04-07:
Hi,

thank you for your answer.  As i already wrote (yes i renamed the binary to Robin_e3.bin)  i know how to flash the firmware and it works with your precompiled binary. But here are the steps i did:

1. Compile the Marlin  from https://github.com/makerbase-mks/MKS-Robin-E3-E3D
2. rename firmware.bin to Robin_e3.bin
3. copy Robin_e3.bin to sd card
4. install the sd card into the board an turn it on
5. flashing process started and stops by 100%
6. after reboot is stops on "boot" screen, Robin_e3.bin is renamed into Robin_e3.cur

Pleae read again my description

mks-viva, 2021-04-07:
You need copy Robin_e3.bin and cann't use firmware.bin rename as Robin_e3.bin

Stalkk, 2021-04-07:
Hello mks-viva,
You're right.
I just missed the file. Ashes all over my head.
It works fine now with the right file.
Thank you!

Closed 2021-04-07.

Thread 100 (2021-04-09):

Ender 3 V2 endstops do not work

grothkopp, 2021-04-09:
I can't get the endstops to work. The switches do nothing. Then I placed jumpers on the diag x/y/z pins. Sensorless homing also doesn't work. The boards version is 1.1

grothkopp, 2021-04-10:
I was confused about how endstops work (in marlin at least), tested with movement commands, but they seem to only work when homing

Closed 2021-04-10.

Thread 99 (2021-04-09):

Accidentally touched part cooling fan wires. Black smoke and now part cooling always on..

danbrianwhite, 2021-04-09:
Hello MKS team. I recently had an accident where I touched/shorted the part cooling fan wires together. There was black smoke from the board. Now the part cooling fan is always on (partially). Can I fix this and how? Or is there a workaround you can help me with?

MKS Robin E3 board

mks-viva, 2021-04-12:
Hi! May be you need chenge it(AOS3400/CJ3400)
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

danbrianwhite, 2021-05-01:
Thank you for the spec details. Will try this out.

danbrianwhite, 2021-07-26:
Yes this fixed the issue. I happened to burn this component out on a 2nd board and the fix worked there too.

Closed 2021-04-14.

Thread 101 (2021-04-17):

Firmware update stopped on "update 100%"

piontec, 2021-04-17:
I configured the latest marlin-bugfix2.0.x according to your instructions. My board is v1.1. The firmware compiled and started to flash successfully, but then it's stuck on "update 100%". After removing the card, the printer won't boot and is stuck with message "boot" on the screen. THe firmware file is deleted from the sdcard.

mks-viva, 2021-04-19:
Hi! You need copy Robin_e3.bin file to TF card and insert board update it

piontec, 2021-04-19:
Hey! Thank you, I missed that. What is the difference between `firmware.bin` and `Robin_e3.bin`? I'm trying to make your board work with https://github.com/KevinOConnor/klipper and I have the same problem there - I guess the solution is the same. Can you help me convert klipper's binary as well?

mks-viva, 2021-04-20:
Robin_e3.bin file is obtained by transcoding using firmware.bin file, so, we need use Robin_e3.bin file update firmware and cann't use firmware.bin rename as Robin_e3.bin, this is unusable.

piontec, 2021-04-20:
Yes, but how to transcode the file?

mks-viva, 2021-04-20:
You can refer to marlin about transcode and i has upload this file.
[mks_robin_e3.zip](https://github.com/makerbase-mks/MKS-Robin-E3-E3D/files/6341338/mks_robin_e3.zip)
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

mks-viva, 2021-04-20:
You can refer to Klipper here about how to transcode: https://github.com/KevinOConnor/klipper/blob/master/scripts/update_mks_robin.py

piontec, 2021-04-20:
Thanks for the info, but exactly this script doesn't work for me - when I flash `Robin_e3.bin` from it, the printer hangs like with non-encoded firmware :( Just to confirm: which bootloader size and serial ports should I use for klipper?

spooky79, 2021-04-21:
I have the same problem, it comes to 100% and nothing is happening, I'm using visual studio code, any solution?

mks-viva, 2021-04-22:
@piontec About MKS Robin E3 use kilpper firmware settigs: https://github.com/KevinOConnor/klipper/pull/3008
@spooky79 What firmware you using?

piontec, 2021-04-26:
It doesn't work for me, see my marlin report here: https://github.com/KevinOConnor/klipper/issues/4219

piontec, 2021-04-29:
It turned out to be klipper issue, it was silently crashing without any info in logs. Closing as invalid.

thiagoedson, 2021-09-22:
= aqui

fex42, 2021-11-03:
I also have the same problem with Klipper. My workaround was to get back to the tagged v0.10.0 version and flash this. After flashing the board, you can go back to git HEAD for the stuff running on the Raspberry Pi

bulcke, 2022-09-10:
> I also have the same problem with Klipper. My workaround was to get back to the tagged v0.10.0 version and flash this. After flashing the board, you can go back to git HEAD for the Klipper stuff running on the Raspberry Pi

@fex42 where can I find said tagged version?

Closed 2021-04-29.

Thread 102 (2021-04-17):

Error compiling Marlin bugfix-2.0.x when serial port is set to-1

daBigR--, 2021-04-17:
Hi, I downloaded Marlin bugfix-2.0.x from official site.  I used example Configuration.h and Configuration_adv.h and set up parameters for my Ender-3, BLTouch, etc.  I configured #define SERIAL_PORT -1 as indicated on this site's Wiki.  I also set #define MOTHERBOARD BOARD_MKS_ROBIN_E3D_V1_1.  When I compiled I got error  "SERIAL_PORT is set to -1, but the MOTHERBOARD has no native USB support" .  As it turned out this error is generated by this directive on the board definition in standard Marlin #define BOARD_NO_NATIVE_USB.  So in new Marlin you cannot set serial port to -1 for Robin E3 boards.  What should I do to compile Marlin and to have the USB communications working correctly?

mks-viva, 2021-04-19:
You need set SERIAL_PORT 1 when you use the latest version marlin firmware.

daBigR--, 2021-04-19:
OK.  And SERIAL_PORT_2 ?  Should it be commented?

mks-viva, 2021-04-19:
You need disable SERIAL_PORT_2. I will update our Wiki.

mks-viva, 2021-04-24:
I will close this issues temporarily

kacharros, 2021-06-10:
Mismo problema con marlín 2.0.8.2.
Err0r con serial port -1.
Cambio a serial port 1 y baudrate 250000 y compila pero la tft35 no se comunica con la impresora.

Closed 2021-04-24.

Thread 103 (2021-04-18):

Updated firmware, Extruder motor not working. Robin E3D

NiceManiac, 2021-04-18:
Hello, i recently updated my firmware for supporting 3d touch and linear advance.

The 3D touch sensor works flawlessly but my extruder wont turn at all(not vie octoprint, not via lcd display).

Attached my config files.
[Marlin.zip](https://github.com/makerbase-mks/MKS-Robin-E3-E3D/files/6330687/Marlin.zip)

mks-viva, 2021-04-19:
Hi! I want to know, what do you use to control the E axis.

NiceManiac, 2021-04-19:
i actually found the issue to this problem, PREVENT_COLD_EXTRUSION is broke in this release, and even when setting the min temperature to 100 degrees and heating the hotend to 200 it blocks the extruder from moving.

Closed 2021-04-19.

Thread 104 (2021-04-19):

Endstopes not work

rogeriollorente, 2021-04-19:
Good afternoon, I bought an MKS Robin e3d card, when installing the card I identified that the endstopes do not work.

Initially I thought it was a problem with the wiring or the micro switches, but I tested them all and they work well.

When I send the command Gcode M119 I get the answer that the micro switches are open, even when I activate them manually.

I don't know how to solve this, can someone help me?

mks-viva, 2021-04-20:
Hi! Can you provide a video when your printer go to home?

rogeriollorente, 2021-04-21:
Hello, unfortunately I was unable to produce a video, but I took some pictures that can help you understand.

I am using a simple micro switch that I tested before and after connected to MKS E3D.

The MKS E3D is no longer connected to my printer, so I can't show you the printer going Home .... because when I tried, she didn't turn off the engines when she reached the endstop ... it was tense !!!

I'm using a TFT to send the Gcode M119 to check the status of the endstop micro switches.
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

I always have the same answer that they are open.

mks-viva, 2021-04-23:
You need remove X Y Z E DIAG signal connect jumpers
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

rogeriollorente, 2021-04-24:
For now the problem of endstopes has been solved, later I implement the sensorless homing function.

But now I have another question, which of the pins can I use as PS_ON_PIN, because I have a printer shutdown system and I would like to use it.
Thanks.

rogeriollorente, 2021-04-24:
For now the problem of endstopes has been solved, later I implement the sensorless homing function.
But now I have another question, which of the pins can I use as PS_ON_PIN, because I have a printer shutdown system and I would like to use it.
Thanks.

mks-viva, 2021-04-26:
You can refer to Wiki: https://github.com/makerbase-mks/MKS-Robin-E3-E3D/wiki/MKS_PWC

rogeriollorente, 2021-05-06:
Hello, successfully implemented the power off, added to the file pins_MKS_ROBIN_E3_common.h the line

//
// PS-ON-PIN
//
#define PS_ON_PIN PB10

But there is a new problem, I'm having a lot of vibration in stepper motors.

I am using the TMC2209, with the default settings of the official Marlin for tmc, considering that they are more or less similar to the ones I obtained through calculations of Vref = 730ma and thus Vref = 800ma.

My stepper motors are Chinese, Hanpose, 1.7a, 1.6 Ohm, model 17hs4401.

Thread 105 (2021-04-20):

How many LEDs can I connect to the neopixel port?

piontec, 2021-04-20:
Hey!
I have Robin E3D 1.1 and some neopixel LEDs, but I can't find any spec that says how many LEDs can I connect to the board directly? What is the max power output of the neopixel connector?

mks-viva, 2021-04-30:
Hi! MKS has reserve a 5V interface, DC-DC use MP584(Support 3A output), but has fues(limit 1.5A), so, you need limit it in 1.5A

DocYester, 2021-05-03:
Calculate 50mA per LED as max current - so 30 LED's should be the maximum to be safe

piontec, 2021-05-03:
Thank you for your responses. Just to make sure: 1.5A is when I'm connecting directly to the mainboard, without any external modules, voltage regulators and so on, right?

DocYester, 2021-05-03:
> Thank you for your responses. Just to make sure: 1.5A is when I'm connecting directly to the mainboard, without any external modules, voltage regulators and so on, right?

Yes.
But you can connect the "driving Pin" to the LED-Stripe and the power source from an external as well - to get more than 30 LED's up - dont forget to connect gnd's as well.

piontec, 2021-05-03:
Thank you, all clear now! It would be super helpful to add this to docs :)

Closed 2021-08-09.

Thread 106 (2021-04-27):

BL TOUCH DOES NOT STOW WHILE TOUCHING THE BED

mustafadh12, 2021-04-27:
Hello,

I was using ender 3 pro with bl touch installed perfectly until i've shortcutted the thermistor circuit than renewed the motherboard as the same.

Triple checked the wiring, seems everyhing stays right position. Here is the problem, bl touch is working fine manually. I can control it on the menu, seems working good at the startup also. When i press level bed, it reaches the bed and wont stow/retract. Nozzle reaches the bed and i stop the printer by hand.

I've tried to change bed height manually, restored defaults on the menu and etc.

Funny thing is, when i put a plastic part on the bed (thickness 2 mm), than command level bed, probe detects it and retracts! So I'm started to think if it's because of the hardness of the glass maybe? But older motherboard with the same bl touch was working perfectly.

Please help me ASAP.

mustafadh12, 2021-04-27:
Here is the config files. BTW I am using both z switch and bl touch.

[Marlin.zip](https://github.com/makerbase-mks/MKS-Robin-E3-E3D/files/6382705/Marlin.zip)

mustafadh12, 2021-04-27:
Is there a possibility to damaged while thermistor circuit shortcut happened?

aabeuge, 2021-04-29:
I had a similar problem and I had to reverse the polarity of the bltouch end stop wires when connecting to z_endstop.  The white wire I believe needs to be on the right side (toward front).

This also gave another strange behavior when the wires were reversed.  When giving m119 command to see endstop trigger status the bltouch pin would drop the moment I enter the command.  And would always say triggered in the status.

countcobolt, 2021-07-01:
Does the power on self test work?

Thread 107 (2021-04-28):

Boot loader update

aabeuge, 2021-04-28:

mks-viva, 2021-04-30:
Hi! You can use ST-Link.

aabeuge, 2021-04-30:
> Hi! You can use ST-Link.

I tried connecting to the J1 header and the ST link utility could not find the target.  Does Boot0 have to be pulled high even for SWD programming?  If so I saw that I will need to cut the trace line from permanent ground.

mks-viva, 2021-04-30:
Like this: https://github.com/makerbase-mks/MKS-Robin-E3-E3D/issues/43
But i recommend you to use J-LINK and use it have not change hardware.

aabeuge, 2021-04-30:
Success!
I took another look at stm32cubeprogrammer and the default memory address needed to change from 0x80000000 to 0x00000000.  Once I made the change it connected using the ST-Link V2 dongle and I was able to save the original bootloader and upload the new bootloader without the beep and boot message.

Thread 108 (2021-04-29):

How to connect 12V filament cooling fan via DC-DC converter?

piontec, 2021-04-29:
I wanted to connect 12V fan for cooling the filament. I used a 12V Dc-DC converted in the same way as recommended for creality 4.2.2 board: I left the ground pin of filament cooling fan untouched, then inserted the DC-DC converted into +24V line and attached converter's ground directly to power supply gnd. Unfortunately, this resulted in my 12V fan still getting volatages much higher than 12V. How should I connect that?

mks-viva, 2021-04-30:
Hi! Can you provide your dc-dc module pictures or datasheet?

piontec, 2021-05-03:
Please check photos of the converter I'm using
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

aabeuge, 2021-05-04:
I would start by suggesting that it is best to always verify your output voltage is correct on a dc-dc converter before powering anything from it.

I think the enable pad can be left alone but I'm not 100%.  I searched the internet and found a QS-1205CME-3A module that looks like those photos and the description of the enable pin suggests it is logic controlled with 0V for off and 2-5V for on.  If not connected it likely has a pull-up resistor on the board to keep it enabled.  I'm not sure why more voltage would have gone to the fan unless your connections were wrong.

Based off of the photos I would suggest:

GND should connect to -V of your printer power supply and black/ground/negative lead of fan.

IN+ should connect to +V of printer power supply.

VO+ should be connected to red positive lead of fan but verify the voltage first and adjust for 12V.

Hope this helps

piontec, 2021-05-05:
I have the DCDC connected correctly, exactly as you described. And I measured the voltage to be 12V. Yet somehow when board switching kicks in, the output voltage is higher - I'm not really sure how's that possible...

mks-viva, 2021-05-19:
@piontec The manufacturer may have relevant tutorials, you can consult.

Closed 2021-08-03.

Thread 109 (2021-05-01):

MKS TS35 with mesh bed leveling

Hoffmorr, 2021-05-01:
I want to enable mesh bed leveling through the LCD.  Is that supported?  I get the error that the screen is not programmable when I try to compile the FW which makes me think I cannot do the mesh bed leveling through the MKSTS35?  Is there a version of FW i can install on the MKS TS35 that will allow changes to the menus or something?

mks-viva, 2021-05-28:
MKS Robin E3/E3D have not support MKS TS35 display screen.

Closed 2021-05-28.

Thread 110 (2021-05-02):

Can't boot after updating firmware for MKS-ROBIN-E3 & CR10

OpenZSD, 2021-05-02:
I updated the firmware to my cr 10 with bl touch and custom print bed with E3 board and if fails to update the screen past boot. After updating the screen remains at 100% and on reboot the lcd shows boot and stays there. Below is a link to the google drive of my modified src of Marlin. Let me know what configuration I missed.

https://drive.google.com/file/d/1TtGqxHsXgY2xe4W-lnqHafeOCtJzq-lb/view?usp=sharing

OpenZSD, 2021-05-02:
Found the missing config:
#define CR10_STOCKDISPLAY

Closed 2021-05-02.

Thread 111 (2021-05-12):

Using Both 3Dtouch and H43 screen on ROBIN E3 V1.1

Aranelevo, 2021-05-12:
Hello,
I have a problem for using pins on motherboard.
Servo pis defined as PA3, which is also needed to be used by H43.
Is there any one have that issue. I am a newbee about those problems so please anyone can help me?

Closed 2021-08-06.

Thread 112 (2021-05-17):

MKS-Robin-E3P Bltouch will not deploy

nfruge56, 2021-05-17:
I'm running an Ender 3 V2 and I'm replacing the motherboard. I've followed all of the videos and how-to's but I can not get the Bltouch to deploy when homing the Z-axis. Attached is the config file I'm using.

The Bltouch will start-up and deploy with it's self-test but not when homing the z-axis.

I've tried both using the Servo method and the z-axis end stop method. Neither are working.

Please advise.

[Configuration.txt](https://github.com/makerbase-mks/MKS-Robin-E3-E3D/files/6496889/Configuration.txt)

nfruge56, 2021-05-17:
Moved to MKS-Robin-E3P

bevanweiss, 2021-09-18:
This may have been because you didn't have the following setting configured in the file

// Force the use of the probe for Z-axis homing
#define USE_PROBE_FOR_Z_HOMING

If you don't have this in my experience it still uses the Z-LIMIT switch (if you have the Z PROBE on a separate pin to the Z LIMIT, as I do).

Closed 2021-05-17.

Thread 113 (2021-05-19):

CR-10 Marlin firmware - Robin E3 V1.1

jimbob111, 2021-05-19:
Is there a Marlin for the CR-10? I can only see Ender 3 & Ender 5 in the firmware folder?

countcobolt, 2021-07-01:
You need to compile it yourself. I did it using Platformio. Works fine but requires you to edit config files.

jimbob111, 2021-07-04:
Thanks, have done that and am now getting a "TMC connection error" on the x-axis

countcobolt, 2021-07-05:
Check how you address your stepper motors and make sure the jumper are in the correct spot. E.g. is you set them to use UART make sure that the jumpers are on UART. I assume you selected 1 mode and place them on another mode in the firmware. I uploaded my configuration. **Attention** This originally is when this board was installed in a CR10S5 so the bed size is bigger. Modify this size to 310*310*400. It also had a BL Touch on there. I do not recall if this firmware has PID for bed enabled or not as this comes from a back up. (I don't have access to my main machine now)

[configuration.zip](https://github.com/makerbase-mks/MKS-Robin-E3-E3D/files/6762393/configuration.zip)

jimbob111, 2021-07-05:
Thanks for the config files, I haven't tried them yet, will do later. I  have the E3 board, so don't have an option to set jumpers.

Closed 2021-07-29.

Thread 114 (2021-06-04):

BTT mini 12864 v1 in E3D V1.1

kacharros, 2021-06-04:
Does anyone know instructions to install a mini BTT 12864 v1 on Robin E3D v1.1?
I uncomment FYSECT_MINI_12864_2_1 y NEOPIXEL_LED , it as the BTT instructions put it and it gives an error.

mks-viva, 2021-06-16:
Hi! You need add it in ini file
custom_marlin.NEOPIXEL_LED = Adafruit NeoPixel=https://github.com/ellensp/Adafruit_NeoPixel
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

mks-viva, 2021-07-15:
You can refer to https://github.com/MarlinFirmware/Marlin/pull/22368

zhongxb, 2021-07-24:
> Hi! You need add it in ini file
> custom_marlin.NEOPIXEL_LED = Adafruit NeoPixel=https://github.com/ellensp/Adafruit_NeoPixel
> 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

this address is 404,  https://github.com/ellensp/Adafruit_NeoPixel.

Closed 2021-07-15.

Thread 115 (2021-06-04):

MKSTOOL onyl mksrobin e3d 1.0version,Update to 1.1?

Verkol, 2021-06-04:
I tried to install CR20 pro on the MKS E3D version 1.1 motherboard, but the Z axis and BL touch did not work properly.
https://baizhongyun.cn/home/mkstoolview

There is probably version 1.0 above on the MKSTOOL website.Is it possible to update with 1.1version files?

If I want to install published files, the screen will fall apart, freeze or disappear. Z axis, BL touch looks good.MINI12864 display.

pepegragera, 2021-06-16:
Some problem...

Verkol, 2021-06-18:
After several days of tinkering I managed to put together a working 3d printer. On the one hand, the problem was that I didn't really look into the fact that the 1.1V motherboard had several positive changes, which needed careful attention when setting up the software (e.g. onboard eeprom). BL touch also works fine at the moment,because I had some problems with it,because M999 error kept throwing up.
A few more days of testing would not hurt,because I have not dared to leave the machine unattended,but I do not dare to do so at the moment.

Translated with www.DeepL.com/Translator (free version)

mks-viva, 2021-07-15:
You need define mother board is MKS_ROBIN_E3D_V1_1

Closed 2021-07-15.

Thread 116 (2021-06-05):

Ender 2

dexter2111, 2021-06-05:
Hello,

This board support mini 12864 lcd , that is used in Ender 2?
Can some body help me to configure the firmware for Ender 2 ?
THX.

Verkol, 2021-06-15:
Yes, it works with it. It works with the type I have.
You have to download VS studio to edit the configuration.h file.It's basically like commenting out one display and the other one the other way round.Simple text editing.

VS install:
https://www.youtube.com/watch?v=eq_ygvHF29I&t=303s
This is the part you need to comment on:
// MKS MINI12864 with graphic controller and SD support
// https://reprap.org/wiki/MKS_MINI_12864
#define MKS_MINI_12864
#define LCD_CONTRAST_MIN  140
#define LCD_CONTRAST_INIT 155
#define LCD_CONTRAST_MAX  165

Also, you need to change the 3D printer's hardware configuration information.
https://baizhongyun.cn/home/mkstoolview

This interface would help, but unfortunately it doesn't work for me anymore.
Here you can select the type that you might have.

dexter2111, 2021-06-19:
Thank you, for your replay.
It seems that the MKS tool, is not working any  more.
I have made the configure file, put it in VS , bulid the firmware, but the display is not show any thing( only the backlight is on).
The firmware has flash in to the board because the extension of the file has changed form .bin to .cur.
My display has 1 ribbon cable with 10 pin, and i connected to exp1.
Thank you.

Verkol, 2021-07-02:
I do not have the same display,mine is connected to exp1,exp2 with two cables.
You would have to look in the Marlin firmware to see which display is commented out. You can find out exactly which display it is in the Marlin example configuration file.

dexter2111, 2021-07-15:
Thank you, for your support.
I have managed to make it working.
I have rewiring  the display signals with dupont wire.
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
All is working fine with:
#define MKS_MINI_12864
#define LCD_CONTRAST_MIN 140
#define LCD_CONTRAST_INIT 155
#define LCD_CONTRAST_MAX 165
Without  define the LCd Contrast , by default the contrast is 195.

mks-viva, 2021-08-09:
If you use MKS Robin E3 board, you can connect to MKS MINI12864 by EXP1 and EXP2

Thread 117 (2021-06-07):

MKS Robin E3D v1.1 Cant connect via USB or Aux1

NZOberoN, 2021-06-07:
Hi, very much a newbie here.

I recently bought a Robin E3D with TMC2209 drivers, connected to the board via USB and Pronterface, but needed to make a few changes, invert stops etc.

I compiled the latest Marlin and bugfix with changes and flashed firmware via SD card. Couldn't connect using Pronterface. No error, just persistant "connecting..." message.

Tried to download "factory" firmware via this page https://github.com/makerbase-mks/MKS-Robin-E3-E3D/wiki/Marlin_firmware but found the link doesn't work (404 error), so followed my nose to here https://github.com/makerbase-mks/MKS-Robin-E3-E3D/blob/master/firmware/V1.1/Firmware%20bin%20for%20ender3/Marlin-2.0.6.1_for_ender3_TMC2209.bin. Flashed that, still can't connect.

I also tried the full Marlin download (https://github.com/makerbase-mks/MKS-Robin-E3-E3D/tree/master/firmware/V1.1/Marlin-2.0.6.1_for_ender3_TMC2209), compiled and flashed that... same problem.

I read that the CH340 chip can sometimes be the problem so I tried to connect via Aux1 with a FTDI... same Problem.

I don't have a usable screen to attach to the board, so I have no feedback whatsoever.

Thank you in advance!

aabeuge, 2021-06-09:
Silly question but did you change the firmware file name to Robin_e3.bin before flashing?  If not that would definitely be the reason.

NZOberoN, 2021-06-10:
Yes I did, but, as it turns out I needed to reflash the bootloader, it had become corrupt somehow.

aabeuge, 2021-06-14:
Ahh, glad you were able to sort it out.

Closed 2021-06-10.

Thread 120 (2021-06-20):

Z Axis not moving Robin E3 V1.0

zoppp, 2021-06-20:
I have a robin e3 with replaceable stepper driver and am having issues getting the z axis to move.  To test the steppers and drivers, I switched one of the z motors from being connected to the Z1 port to the X axis port and commanded the x axis to move which worked as expected: One z motor moved. I moved the z stepper driver to the x axis connected to the z motor and it worked as well so that leads me to believe that the stepper drivers and the motors are fine. The endstop status when running M119 is all open so the endstops are not preventing motion.

I have placed the jumpers on the board to run the drivers in UART mode with the 2209 drivers. Please help, is there a marlin configuration I am missing?

I am running the board on 12v for a wanhao duplicator i3. Not connected to the screen. Everything on the printer is working with the robin e3 board except for the z1/z2 ports.

mks-viva, 2021-07-08:
Hi! If you use MKS Robin E3/E3D V1.1 board, you need set #define MOTHERBOARD BOARD_MKS_ROBIN_E3_V1_1

Closed 2021-08-03.

Thread 121 (2021-07-01):

Robin E3D with EXP-MOT3

countcobolt, 2021-07-01:
Hi all, is it possible to use the EXP-MOT3 on a Robin E3D? I use EXP3 for my standard Ender type screen, so exp 1 & 2 are open. What files need to be modified in marlin? Using 2.0.6.1 from this branch. I would like to use this to
1. Add an additional extruder
2. Separate my Z-steppers so I can use G34 for levelling.

kind regards

mks-viva, 2021-07-08:
1. If you use MKS EXP-MOT3 on E3D, you need's use EXP3 interface
2. You need set it. For example：
You need use X2 axis：
A. Configuration_adv.h file: enable  #define X_DUAL_STEPPER_DRIVERS
B. pins_MKS_ROBIN_E3_common.h add pin define（On M1）
```
#define X2_ENABLE_PIN  PC1//BEEPER
#define X2_STEP_PIN  PA4//LCD_EN
#define X2_DIR_PIN  PA5//LCD_RS
```
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

countcobolt, 2021-07-08:
Stupid Question, but where do I then set up the LCD display?

kind regards

mks-viva, 2021-07-08:
> Stupid Question, but where do I then set up the LCD display?
>
> kind regards

If you must connect your lcd on e3 board, you can use MKS EXP-MOT3's M3 interface

countcobolt, 2021-07-08:
sorry to keep on asking stupid questions, but I only see EXP1 & EXP2 on the MOT3

countcobolt, 2021-07-15:
Hi all, do you mean : if you need to use exp3 you CAN NOT use the lcd or can? Sorry not clear to me

mks-viva, 2021-07-15:
If you use exp3, so, you only M3 interface is can be use

tanjunior, 2024-09-07:
@mks-viva Please help me too.

E3D UART mode
MOT-EXP UART mode
E3D EXP1 <-> EXP-MOT EXP1
E3D EXP2 <-> EXP-MOT EXP2

Following the [BTT EXP-MOT user guide](https://github.com/bigtreetech/BTT-Expansion-module/blob/master/BTT%20EXP-MOT/BTT%20EXP-MOT%20V1.0User%20Guide.pdf)

BTT-MOT EXP2 M1STP = E3D EXP2 PB15
BTT-MOT EXP2 M1DIR = E3D EXP2 PB0
BTT-MOT EXP2 M1EN = E3D EXP2 PC10
BTT-MOT EXP1 M1RX = E3D EXP1 PA7

```
[stepper_z1]
step_pin: EXP2_6
dir_pin: !EXP2_5
enable_pin: !EXP2_7
microsteps: 16
rotation_distance: 8
endstop_pin: ^PC6
endstop_pin: probe:z_virtual_endstop

[tmc2209 stepper_z1]
uart_pin: EXP1_6
run_current: 0.8
stealthchop_threshold: 999999

[board_pins]
aliases:
    # EXP1 header
    EXP1_1=PC1, EXP1_3=PA4, EXP1_5=PA6, EXP1_7=PC4, EXP1_9=<GND>,
    EXP1_2=PC3, EXP1_4=PA5, EXP1_6=PA7, EXP1_8=PC5, EXP1_10=<5V>,
    # EXP2 header
    EXP2_1=PB14, EXP2_3=PB11, EXP2_5=PB0,  EXP2_7=PC10,  EXP2_9=<GND>,
    EXP2_2=PB13, EXP2_4=PA15, EXP2_6=PB15, EXP2_8=<RST>, EXP2_10=<NC>,
    # CR_EXP3 header - additional header dedicated to Creality Ender 3/5 stock screens
    CR_EXP3_10=<5V>, CR_EXP3_8=PA4, CR_EXP3_6=PA6, CR_EXP3_4=<RST>, CR_EXP3_2=PC3,
    CR_EXP3_9=<GND>, CR_EXP3_7=PA5, CR_EXP3_5=PB0, CR_EXP3_3=PB11,  CR_EXP3_1=PC1
```

`FORCE_MOVE STEPPER=stepper_z1 DISTANCE=10 VELOCITY=5`
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

Closed 2021-07-31.

Thread 122 (2021-07-11):

In Marlin 2.0.9.1, 250000 baud rate printer stops randomly. In Marlin 2.0.7 and before, the baud rate of 250000 was running smoothly

TimeJammer, 2021-07-11:
Hello to everyone. I have mks E3D card and mks tft 35. In Marlin 2.0.9.1, 250000 baud rate printer stops randomly. In Marlin 2.0.7 and before, the baud rate of 250000 was running smoothly for 1.5 years.
In version 2.0.9.1 it is stable only at 115200. What is the reason of this ?

I did not cancel the original screen of the printer (Ender 3) and I use it together with tft 35. //#define SERIAL_PORT_2 The -1 setting does not work in the new marlin and I disabled it because it was said to be disabled in the new suggestions. Could this be the reason? While other versions do not have this problem, what could be the reason why 250000 baud rate does not work stable only in 2.0.9.1. Could it be caused by something or a change that I did wrong in this version? Thanks for your responses.

Motherboard: Mks E3D(tmc2209)
Screen: Mks TFT35 with wireless.
Ank mks 3d touch sensor.

Thanks in advance for your returns.

mks-viva, 2021-07-15:
If the new version of marlin does not have any feature updates, it is recommended that you use the original version directly.

TimeJammer, 2021-07-15:
All right, thanks. It's okay to stay on Marlin 2.0.7, right?

TimeJammer, 2021-07-15:
> If the new version of marlin does not have any feature updates, it is recommended that you use the original version directly.

All right, thanks. It's okay to stay on Marlin 2.0.7, right?

mks-viva, 2021-07-15:
Yes

TimeJammer, 2021-07-15:
Thanks for the answer. Have a nice day.

Closed 2021-07-15.

Thread 125 (2021-07-23):

robin e3d  with EXP-MOT3,  how to support three Extruders？

woaikuancheng0, 2021-07-23:
I want to support 3 extruders.
does those code right

//add e1
#define E1_STEP_PIN                         PA4
#define E1_DIR_PIN                          PA5
#define E1_ENABLE_PIN                       PC1
//add e2
#define E2_STEP_PIN                         PA6
#define E2_DIR_PIN                          PA7
#define E2_ENABLE_PIN                       PC1
//add e3
#define E3_STEP_PIN                         PC4
#define E3_DIR_PIN                          PC5
#define E3_ENABLE_PIN                       PC1

mks-viva, 2021-07-26:
Yes

madurani, 2021-08-21:
What if I want to use uart mode(HW Robin Nano v2)? How will it be with CS and EN port, since they are on the same pin on scheme.
For example when I need to add second Z2-driver on M1, then I add in pin file:
```
#define Z2_ENABLE_PIN                        PE13
#define Z2_STEP_PIN                          PD13
#define Z2_DIR_PIN                           PC6
#ifndef Z2_CS_PIN
  #define Z2_CS_PIN                          PE13
#endif
```
How will it be with display? Options **#define TFT_LVGL_UI** and **#define TOUCH_SCREEN?** Should be commented in config file?
Or is there any other possibility to use display  MKS TS35?

tanjunior, 2024-08-20:
@woaikuancheng0 i am also planning to expand my board for a z2 axis to do tramming. how do you plug in the expansion board?

Closed 2021-07-31.

Thread 126 (2021-07-24):

FYSETC-Mini-12864 v2.1 or BTT Mini 12864 v1.0

kjanek, 2021-07-24:
Is it possible to make this screen work on the MKS Robin E3D? I already fixed some problems like:
* marlin not building correctly with the screen enabled in config
* neopixel not working for the screen
But except that the Backlight works and that I can change the background colour it doesn't show any letters. It even doesn't show the marlin logo on bootup.
Any way to fix this?

mks-viva, 2021-07-26:
Hi! You can refer to here #127

kjanek, 2021-07-26:
> Hi! You can refer to here #127
I really appreciate your help. This solution worked for me. I enabled 2 things in the marlin config and the screen (BTT Mini 12864 v1.0) is working perfectly fine now.
The enabled stuff:
#define MKS_MINI_12864_V3
and
#define NEOPIXEL_LED

mks-viva, 2021-07-27:
It's will work?

kjanek, 2021-07-27:
> It's will work?

Yes it works.

mks-viva, 2021-07-27:
> > It's will work?
>
> Yes it works.

Download the latest marlin？Can you provide your firmware to me?

kjanek, 2021-07-27:
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

Yes of course I can provide my firmware to you.
I dont use the latest marlin. I use the marlin bugfix 2.0.x from 20210723.
For making the screen work i just enabled
#define MKS_MINI_12864_V3
and
#define NEOPIXEL_LED
in the marlin and reverted the connector for exp1 and exp2 in the board.
Send you the firmware in atachment and a photo of working screen.
[Marlin.zip](https://github.com/makerbase-mks/MKS-Robin-E3-E3D/files/6883476/Marlin.zip)
[mks_robin_e3.zip](https://github.com/makerbase-mks/MKS-Robin-E3-E3D/files/6883454/mks_robin_e3.zip)
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

mks-viva, 2021-07-27:
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

Looks good😁

kjanek, 2021-07-27:
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

I know 😃 . So thanks again for your help.
I have one question to you.
Could you add a subsection in here https://github.com/makerbase-mks/MKS-Robin-E3-E3D/wiki
about the FYSETC Mini 12864 v2.1, BTT Mini 12864 v1.0 so that other don't have to search everywhere for the the solution how to get this panel to working.
You could write something like this:
"For enabling the FYSETC Mini 12864 v2.1 or the BTT Mini 12864 v1.0 you have to do following steps:
1. Enable the MKS MINI 12864 V3 screen in Marlin Configuration.h (delete // before this line):
_#define MKS_MINI_12864_V3_
2. Enable the Neopixel led in Marlin Configuration.h (delete // before this line):
_#define NEOPIXEL_LED_
3. Compile and flash the firmware
4. Connect the EXP1 and EXP2 cable to the screen and to the motherboard if it still doesn't work this means you have to rotate the plug 180 degrees."
This would be a nice instruction to follow. Can you add it there?

mks-viva, 2021-07-27:
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

I am happy to do this.

kjanek, 2021-07-27:
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

Thanks.
I have one more question to you. I am using my MKS Robin E3D with TMC2209. I set them to UART mode. But the Z stepper motor does strange noise when it's in UART mode. It's much quiter when its in dir mode. Now is there any way to make it quite in the UART mode. Or is the any way that it doesnt show TMC connection error when i change the mode for the Z to DIR mode?

mks-viva, 2021-07-27:
You only disable ** #define Z_DRIVER_TYPE  TMC2209** and use jumpers connect to M0,M1 (16 microstep)

Closed 2021-07-26.

Thread 127 (2021-07-24):

BTT mini12864 compile fail，

zhongxb, 2021-07-24:
Hi! You need add it in ini file
custom_marlin.NEOPIXEL_LED = Adafruit NeoPixel=https://github.com/ellensp/Adafruit_NeoPixel
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

_Originally posted by @mks-viva in https://github.com/makerbase-mks/MKS-Robin-E3-E3D/issues/114#issuecomment-862281285_

can't find response with https://github.com/ellensp/Adafruit_NeoPixel

404 not found

mks-viva, 2021-07-26:
You can refer to here https://github.com/MarlinFirmware/Marlin/pull/22368, the latest version marlinhas supported it

mks-viva, 2021-07-27:
https://github.com/makerbase-mks/MKS-Robin-E3-E3D/wiki/FYSETC_BTT_MINI12864

Closed 2021-07-31.

Thread 128 (2021-08-06):

Note for v1.1 users!!!If your Z motor CAN'T ROTATE, but only hold in place (enable).

ChangboBro, 2021-08-06:
If your board is version v1.1, You have to define your board as : #define MOTHERBOARD BOARD_MKS_ROBIN_E3D_V1_1 ,
NOT #define MOTHERBOARD BOARD_MKS_ROBIN_E3D . Or you will get problem at Z motor, cause v1.1's dir pin and step pin at z motor is different from v1.0.
It akes me one day to find problem... /(ㄒoㄒ)/~~

mks-viva, 2021-08-06:
OK! I will update it on wiki.

ChangboBro, 2021-08-06:
> OK! I will update it on wiki.

Thx!

mks-viva, 2021-08-07:
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

Closed 2021-08-06.

Thread 129 (2021-08-06):

3 fans on robin e3

NilsHarald, 2021-08-06:
Can someone point me to any document on how to setup 3 fans?
Hotendfan, partfan and boardfan. If there is a way to control them.

pauloeduardogodoy, 2021-08-06:
I am really interested in this type of setup too!

mks-viva, 2021-08-07:
@NilsHarald @pauloeduardogodoy
Only add fan1,fan2 pin define in pins_MKS_ROBIN_E3_common.h file and connect external MOS module
Add pin define
```
#define FAN1_PIN   PC4  //Open: M106 P1 S255, Close: M107
#define FAN2_PIN   PC5  //Open: M106 P2 S255, Close: M107
```

MOS module: https://www.aliexpress.com/item/32824688674.html

pauloeduardogodoy, 2021-08-07:
Why MOS modules are necessary to connect simple fans? This approach looks a little bit overkill...

mks-viva, 2021-08-07:
Because FAN signal is control N channel MOS, so, need MOS modules

bevanweiss, 2021-09-18:
@pauloeduardogodoy it's because the Robin E3/E3d only have a single output connector configured with MOSFET for PWM control of fan  So if you want more than 1 fan controlled by PWM, then you need to take one of the digital low current IO pins, configure it for output, and then feed that to a MOSFET so that you don't burn up the output pin.  The output pins are not capable of supplying more than a few mA, this is enough to drive a FET, but definitely not enough to drive a fan.  Hence you need something like the MOS module.  You could just use your own custom PCB with a small SOT-23 FET on it...

If you were using a 5V fan, then you could use the 5V rail from the three pin plugs, like the neopixel, then switch the FET with the digital output.  The adapter board could be quite 'neat' then.
If you're using a 12V / 24V supply for the fan, you'd need to reference the GND/0V of it back to the Robin E3/E3d GND also.

Closed 2021-08-09.

Thread 130 (2021-08-07):

Como carregar o Marlin para a placa Mks Robin e3d

Emeale2021, 2021-08-07:
Olá, sou novo aqui e se estiver fazendo algo errado me avisem.
Estou trocando a placa da minha impressora 3d caseira por uma MKS Robin e3d e gostaria de uma orientação se possível, atualmente uso a placa Arduino mega que configurava pela IDE do arduino, mas ainda não sei instalar o Marlin na MKS, alguém poderia me dar uma dica?

pauloeduardogodoy, 2021-08-07:
Boa tarde @Emeale2021 seja bem vindo. Não tenho muita experiência ainda com essa placa, tanto é que estourei duas ligando step down XL4015 nelas... Queimei o transistor Q3 que controla a saída dos FANs 1 e 2...
De qualquer maneira, compilar o Marlin 2.0.x pra ela é bem simples. Só precisa instalar o Visual Basic Code e duas extensões nele. Sica essas instruções:
 - [PlatformIO](https://marlinfw.org/docs/basics/install_platformio_vscode.html)
 - [Auto Build Marlin](https://marlinfw.org/docs/basics/auto_build_marlin.html)

Depois faça as configurações necessárias nos arquivos "Configuration.h" e "Configuration_adv.h"

mks-viva, 2021-08-09:
You need use Vscode comlipe marlin for e3d board.

mks-viva, 2021-08-09:
https://github.com/makerbase-mks/MKS-Robin-E3-E3D/wiki/Marlin_firmware

Closed 2021-08-09.

Thread 131 (2021-08-12):

Firmware differences - v1.0 vs v1.1

pauloeduardogodoy, 2021-08-12:
Hello.

I would like to better understand the differences, if any, between the 1.0 hardware firmware and the 1.1 hardware firmware.

Thanks.

mks-viva, 2021-08-13:
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

pauloeduardogodoy, 2021-08-13:
So those changes are related to v1.0_003 to 1.1_003? Is that correct?

Here should I change those parameters in vanilla Marlin 2.0.9.1?

mks-viva, 2021-08-16:
You only set board type: BOARD_MKS_ROBIN_E3_V1_1 or BOARD_MKS_ROBIN_E3D_V1_1

Closed 2021-08-16.

Thread 132 (2021-08-16):

Cannot compile Marlin 2.0.9.1

pauloeduardogodoy, 2021-08-16:
I am trying to compile the latest Marlin without success. Even using the Makerbase configuration website. Is there a step-by-step procedure to be followed? Thanks.

pauloeduardogodoy, 2021-08-17:
### It is freezes here:

PS C:\Marlin> platformio run -e mks_robin_e3
Processing mks_robin_e3 (platform: ststm32@~12.1; board: genericSTM32F103RC; framework: arduino)
--------------------------------------------------------------------------------------------------------------------------------------------------------------------------------------------------------------------------------------------------------------------------------------------Verbose mode can be enabled via `-v, --verbose` option
CONFIGURATION: https://docs.platformio.org/page/boards/ststm32/genericSTM32F103RC.html
PLATFORM: ST STM32 (12.1.1) > STM32F103RC (48k RAM. 256k Flash)
HARDWARE: STM32F103RCT6 72MHz, 48KB RAM, 256KB Flash
DEBUG: Current (stlink) External (blackmagic, cmsis-dap, jlink, stlink)
PACKAGES:
 - framework-arduinoststm32 4.10900.200819 (1.9.0)
 - framework-cmsis 2.50501.200527 (5.5.1)
 - toolchain-gccarmnoneeabi 1.90201.191206 (9.2.1)
Converting Marlin.ino
LDF: Library Dependency Finder -> http://bit.ly/configure-pio-ldf
LDF Modes: Finder ~ chain, Compatibility ~ soft
Found 12 compatible libraries
Scanning dependencies...
Dependency Graph
|-- <TMCStepper> 0.7.1
|   |-- <SoftwareSerial> 1.0
|   |-- <SPI> 1.0
|-- <U8glib-HAL> 0.5.0
|   |-- <Wire> 1.0
|   |-- <SPI> 1.0
|-- <SPI> 1.0
|-- <Servo> 1.1.2
|-- <EEPROM> 2.0.1
|-- <SoftwareSerial> 1.0
|-- <IWatchdog> 1.0.0
|-- <Wire> 1.0
Building in release mode
Compiling .pio\build\mks_robin_e3\FrameworkArduinoVariant\PeripheralPins.c.o
Compiling .pio\build\mks_robin_e3\FrameworkArduinoVariant\variant.cpp.o
Compiling .pio\build\mks_robin_e3\FrameworkArduino\HardwareSerial.cpp.o
Compiling .pio\build\mks_robin_e3\FrameworkArduino\HardwareTimer.cpp.o
Compiling .pio\build\mks_robin_e3\FrameworkArduino\IPAddress.cpp.o
Compiling .pio\build\mks_robin_e3\FrameworkArduino\Print.cpp.o
Compiling .pio\build\mks_robin_e3\FrameworkArduino\RingBuffer.cpp.o
Compiling .pio\build\mks_robin_e3\FrameworkArduino\Stream.cpp.o
Compiling .pio\build\mks_robin_e3\FrameworkArduino\Tone.cpp.o
Compiling .pio\build\mks_robin_e3\FrameworkArduino\USBSerial.cpp.o
Compiling .pio\build\mks_robin_e3\FrameworkArduino\VirtIOSerial.cpp.o
Compiling .pio\build\mks_robin_e3\FrameworkArduino\WInterrupts.cpp.o
Compiling .pio\build\mks_robin_e3\FrameworkArduino\WMath.cpp.o
Compiling .pio\build\mks_robin_e3\FrameworkArduino\WSerial.cpp.o
Compiling .pio\build\mks_robin_e3\FrameworkArduino\WString.cpp.o
Compiling .pio\build\mks_robin_e3\FrameworkArduino\abi.cpp.o
Compiling .pio\build\mks_robin_e3\FrameworkArduino\avr\dtostrf.c.o
Compiling .pio\build\mks_robin_e3\FrameworkArduino\board.c.o
Compiling .pio\build\mks_robin_e3\FrameworkArduino\hooks.c.o
Compiling .pio\build\mks_robin_e3\FrameworkArduino\itoa.c.o
Compiling .pio\build\mks_robin_e3\FrameworkArduino\main.cpp.o
Compiling .pio\build\mks_robin_e3\FrameworkArduino\new.cpp.o
Compiling .pio\build\mks_robin_e3\FrameworkArduino\pins_arduino.c.o
Compiling .pio\build\mks_robin_e3\FrameworkArduino\stm32\OpenAMP\libmetal\device.c.o
Compiling .pio\build\mks_robin_e3\FrameworkArduino\stm32\OpenAMP\libmetal\generic\condition.c.o
Compiling .pio\build\mks_robin_e3\FrameworkArduino\stm32\OpenAMP\libmetal\generic\cortexm\sys.c.o
Compiling .pio\build\mks_robin_e3\FrameworkArduino\stm32\OpenAMP\libmetal\generic\generic_device.c.o
Compiling .pio\build\mks_robin_e3\FrameworkArduino\stm32\OpenAMP\libmetal\generic\generic_init.c.o
Compiling .pio\build\mks_robin_e3\FrameworkArduino\stm32\OpenAMP\libmetal\generic\generic_io.c.o
Compiling .pio\build\mks_robin_e3\FrameworkArduino\stm32\OpenAMP\libmetal\generic\generic_shmem.c.o
Compiling .pio\build\mks_robin_e3\FrameworkArduino\stm32\OpenAMP\libmetal\generic\time.c.o
Compiling .pio\build\mks_robin_e3\FrameworkArduino\stm32\OpenAMP\libmetal\init.c.o
Compiling .pio\build\mks_robin_e3\FrameworkArduino\stm32\OpenAMP\libmetal\io.c.o
Compiling .pio\build\mks_robin_e3\FrameworkArduino\stm32\OpenAMP\libmetal\log.c.o
Compiling .pio\build\mks_robin_e3\FrameworkArduino\stm32\OpenAMP\libmetal\shmem.c.o
Compiling .pio\build\mks_robin_e3\FrameworkArduino\stm32\OpenAMP\mbox_ipcc.c.o
Compiling .pio\build\mks_robin_e3\FrameworkArduino\stm32\OpenAMP\open-amp\remoteproc\remoteproc_virtio.c.o
Compiling .pio\build\mks_robin_e3\FrameworkArduino\stm32\OpenAMP\open-amp\rpmsg\rpmsg.c.o
Compiling .pio\build\mks_robin_e3\FrameworkArduino\stm32\OpenAMP\open-amp\rpmsg\rpmsg_virtio.c.o
Compiling .pio\build\mks_robin_e3\FrameworkArduino\stm32\OpenAMP\openamp.c.o
Compiling .pio\build\mks_robin_e3\FrameworkArduino\stm32\OpenAMP\rsc_table.c.o
Compiling .pio\build\mks_robin_e3\FrameworkArduino\stm32\OpenAMP\virt_uart.c.o
Compiling .pio\build\mks_robin_e3\FrameworkArduino\stm32\OpenAMP\virtio\virtio.c.o
Compiling .pio\build\mks_robin_e3\FrameworkArduino\stm32\OpenAMP\virtio\virtqueue.c.o
Compiling .pio\build\mks_robin_e3\FrameworkArduino\stm32\OpenAMP\virtio_buffer.c.o
Compiling .pio\build\mks_robin_e3\FrameworkArduino\stm32\OpenAMP\virtio_log.c.o
Compiling .pio\build\mks_robin_e3\FrameworkArduino\stm32\startup_stm32yyxx.S.o
Compiling .pio\build\mks_robin_e3\FrameworkArduino\stm32\usb\cdc\cdc_queue.c.o
Compiling .pio\build\mks_robin_e3\FrameworkArduino\stm32\usb\cdc\usbd_cdc.c.o
Compiling .pio\build\mks_robin_e3\FrameworkArduino\stm32\usb\cdc\usbd_cdc_if.c.o
Compiling .pio\build\mks_robin_e3\FrameworkArduino\stm32\usb\hid\usbd_hid_composite.c.o
Compiling .pio\build\mks_robin_e3\FrameworkArduino\stm32\usb\hid\usbd_hid_composite_if.c.o
Compiling .pio\build\mks_robin_e3\FrameworkArduino\stm32\usb\usb_device_core.c.o
Compiling .pio\build\mks_robin_e3\FrameworkArduino\stm32\usb\usb_device_ctlreq.c.o
Compiling .pio\build\mks_robin_e3\FrameworkArduino\stm32\usb\usb_device_ioreq.c.o
Compiling .pio\build\mks_robin_e3\FrameworkArduino\stm32\usb\usbd_conf.c.o
Compiling .pio\build\mks_robin_e3\FrameworkArduino\stm32\usb\usbd_desc.c.o
Compiling .pio\build\mks_robin_e3\FrameworkArduino\stm32\usb\usbd_ep_conf.c.o
Compiling .pio\build\mks_robin_e3\FrameworkArduino\stm32\usb\usbd_if.c.o
Compiling .pio\build\mks_robin_e3\FrameworkArduino\wiring_analog.c.o
Compiling .pio\build\mks_robin_e3\FrameworkArduino\wiring_digital.c.o
Compiling .pio\build\mks_robin_e3\FrameworkArduino\wiring_pulse.cpp.o
Compiling .pio\build\mks_robin_e3\FrameworkArduino\wiring_shift.c.o
Compiling .pio\build\mks_robin_e3\FrameworkArduino\wiring_time.c.o
Compiling .pio\build\mks_robin_e3\SrcWrapper\src\HAL\stm32yyxx_hal.c.o
Compiling .pio\build\mks_robin_e3\SrcWrapper\src\HAL\stm32yyxx_hal_adc.c.o
Compiling .pio\build\mks_robin_e3\SrcWrapper\src\HAL\stm32yyxx_hal_adc_ex.c.o
Compiling .pio\build\mks_robin_e3\SrcWrapper\src\HAL\stm32yyxx_hal_can.c.o
Compiling .pio\build\mks_robin_e3\SrcWrapper\src\HAL\stm32yyxx_hal_cec.c.o
Compiling .pio\build\mks_robin_e3\SrcWrapper\src\HAL\stm32yyxx_hal_comp.c.o
Compiling .pio\build\mks_robin_e3\SrcWrapper\src\HAL\stm32yyxx_hal_comp_ex.c.o
Compiling .pio\build\mks_robin_e3\SrcWrapper\src\HAL\stm32yyxx_hal_cordic.c.o
Compiling .pio\build\mks_robin_e3\SrcWrapper\src\HAL\stm32yyxx_hal_cortex.c.o
Compiling .pio\build\mks_robin_e3\SrcWrapper\src\HAL\stm32yyxx_hal_crc.c.o
Compiling .pio\build\mks_robin_e3\SrcWrapper\src\HAL\stm32yyxx_hal_crc_ex.c.o
Compiling .pio\build\mks_robin_e3\SrcWrapper\src\HAL\stm32yyxx_hal_cryp.c.o
Compiling .pio\build\mks_robin_e3\SrcWrapper\src\HAL\stm32yyxx_hal_cryp_ex.c.o
Compiling .pio\build\mks_robin_e3\SrcWrapper\src\HAL\stm32yyxx_hal_dac.c.o
Compiling .pio\build\mks_robin_e3\SrcWrapper\src\HAL\stm32yyxx_hal_dac_ex.c.o
Compiling .pio\build\mks_robin_e3\SrcWrapper\src\HAL\stm32yyxx_hal_dcmi.c.o
Compiling .pio\build\mks_robin_e3\SrcWrapper\src\HAL\stm32yyxx_hal_dcmi_ex.c.o
Compiling .pio\build\mks_robin_e3\SrcWrapper\src\HAL\stm32yyxx_hal_dfsdm.c.o
Compiling .pio\build\mks_robin_e3\SrcWrapper\src\HAL\stm32yyxx_hal_dfsdm_ex.c.o
Compiling .pio\build\mks_robin_e3\SrcWrapper\src\HAL\stm32yyxx_hal_dma.c.o
Compiling .pio\build\mks_robin_e3\SrcWrapper\src\HAL\stm32yyxx_hal_dma2d.c.o
Compiling .pio\build\mks_robin_e3\SrcWrapper\src\HAL\stm32yyxx_hal_dma_ex.c.o
Compiling .pio\build\mks_robin_e3\SrcWrapper\src\HAL\stm32yyxx_hal_dsi.c.o
Compiling .pio\build\mks_robin_e3\SrcWrapper\src\HAL\stm32yyxx_hal_dts.c.o
Compiling .pio\build\mks_robin_e3\SrcWrapper\src\HAL\stm32yyxx_hal_eth.c.o
Compiling .pio\build\mks_robin_e3\SrcWrapper\src\HAL\stm32yyxx_hal_eth_ex.c.o
Compiling .pio\build\mks_robin_e3\SrcWrapper\src\HAL\stm32yyxx_hal_exti.c.o
Compiling .pio\build\mks_robin_e3\SrcWrapper\src\HAL\stm32yyxx_hal_fdcan.c.o
Compiling .pio\build\mks_robin_e3\SrcWrapper\src\HAL\stm32yyxx_hal_firewall.c.o
Compiling .pio\build\mks_robin_e3\SrcWrapper\src\HAL\stm32yyxx_hal_flash.c.o
Compiling .pio\build\mks_robin_e3\SrcWrapper\src\HAL\stm32yyxx_hal_flash_ex.c.o
Compiling .pio\build\mks_robin_e3\SrcWrapper\src\HAL\stm32yyxx_hal_flash_ramfunc.c.o
Compiling .pio\build\mks_robin_e3\SrcWrapper\src\HAL\stm32yyxx_hal_fmac.c.o
Compiling .pio\build\mks_robin_e3\SrcWrapper\src\HAL\stm32yyxx_hal_fmpi2c.c.o
Compiling .pio\build\mks_robin_e3\SrcWrapper\src\HAL\stm32yyxx_hal_fmpi2c_ex.c.o
Compiling .pio\build\mks_robin_e3\SrcWrapper\src\HAL\stm32yyxx_hal_gfxmmu.c.o
Compiling .pio\build\mks_robin_e3\SrcWrapper\src\HAL\stm32yyxx_hal_gpio.c.o
Compiling .pio\build\mks_robin_e3\SrcWrapper\src\HAL\stm32yyxx_hal_gpio_ex.c.o
Compiling .pio\build\mks_robin_e3\SrcWrapper\src\HAL\stm32yyxx_hal_hash.c.o
Compiling .pio\build\mks_robin_e3\SrcWrapper\src\HAL\stm32yyxx_hal_hash_ex.c.o
Compiling .pio\build\mks_robin_e3\SrcWrapper\src\HAL\stm32yyxx_hal_hcd.c.o
Compiling .pio\build\mks_robin_e3\SrcWrapper\src\HAL\stm32yyxx_hal_hrtim.c.o
Compiling .pio\build\mks_robin_e3\SrcWrapper\src\HAL\stm32yyxx_hal_hsem.c.o
Compiling .pio\build\mks_robin_e3\SrcWrapper\src\HAL\stm32yyxx_hal_i2c.c.o
Compiling .pio\build\mks_robin_e3\SrcWrapper\src\HAL\stm32yyxx_hal_i2c_ex.c.o
Compiling .pio\build\mks_robin_e3\SrcWrapper\src\HAL\stm32yyxx_hal_i2s.c.o
Compiling .pio\build\mks_robin_e3\SrcWrapper\src\HAL\stm32yyxx_hal_i2s_ex.c.o
Compiling .pio\build\mks_robin_e3\SrcWrapper\src\HAL\stm32yyxx_hal_ipcc.c.o
Compiling .pio\build\mks_robin_e3\SrcWrapper\src\HAL\stm32yyxx_hal_irda.c.o
Compiling .pio\build\mks_robin_e3\SrcWrapper\src\HAL\stm32yyxx_hal_iwdg.c.o
Compiling .pio\build\mks_robin_e3\SrcWrapper\src\HAL\stm32yyxx_hal_jpeg.c.o
Compiling .pio\build\mks_robin_e3\SrcWrapper\src\HAL\stm32yyxx_hal_lcd.c.o
Compiling .pio\build\mks_robin_e3\SrcWrapper\src\HAL\stm32yyxx_hal_lptim.c.o
Compiling .pio\build\mks_robin_e3\SrcWrapper\src\HAL\stm32yyxx_hal_ltdc.c.o
Compiling .pio\build\mks_robin_e3\SrcWrapper\src\HAL\stm32yyxx_hal_ltdc_ex.c.o
Compiling .pio\build\mks_robin_e3\SrcWrapper\src\HAL\stm32yyxx_hal_mdios.c.o
Compiling .pio\build\mks_robin_e3\SrcWrapper\src\HAL\stm32yyxx_hal_mdma.c.o
Compiling .pio\build\mks_robin_e3\SrcWrapper\src\HAL\stm32yyxx_hal_mmc.c.o
Compiling .pio\build\mks_robin_e3\SrcWrapper\src\HAL\stm32yyxx_hal_mmc_ex.c.o
Compiling .pio\build\mks_robin_e3\SrcWrapper\src\HAL\stm32yyxx_hal_nand.c.o
Compiling .pio\build\mks_robin_e3\SrcWrapper\src\HAL\stm32yyxx_hal_nor.c.o
Compiling .pio\build\mks_robin_e3\SrcWrapper\src\HAL\stm32yyxx_hal_opamp.c.o
Compiling .pio\build\mks_robin_e3\SrcWrapper\src\HAL\stm32yyxx_hal_opamp_ex.c.o
Compiling .pio\build\mks_robin_e3\SrcWrapper\src\HAL\stm32yyxx_hal_ospi.c.o
Compiling .pio\build\mks_robin_e3\SrcWrapper\src\HAL\stm32yyxx_hal_otfdec.c.o
Compiling .pio\build\mks_robin_e3\SrcWrapper\src\HAL\stm32yyxx_hal_pccard.c.o
Compiling .pio\build\mks_robin_e3\SrcWrapper\src\HAL\stm32yyxx_hal_pcd.c.o
Compiling .pio\build\mks_robin_e3\SrcWrapper\src\HAL\stm32yyxx_hal_pcd_ex.c.o
Compiling .pio\build\mks_robin_e3\SrcWrapper\src\HAL\stm32yyxx_hal_pka.c.o
Compiling .pio\build\mks_robin_e3\SrcWrapper\src\HAL\stm32yyxx_hal_pssi.c.o
Compiling .pio\build\mks_robin_e3\SrcWrapper\src\HAL\stm32yyxx_hal_pwr.c.o
Compiling .pio\build\mks_robin_e3\SrcWrapper\src\HAL\stm32yyxx_hal_pwr_ex.c.o
Compiling .pio\build\mks_robin_e3\SrcWrapper\src\HAL\stm32yyxx_hal_qspi.c.o
Compiling .pio\build\mks_robin_e3\SrcWrapper\src\HAL\stm32yyxx_hal_ramecc.c.o
Compiling .pio\build\mks_robin_e3\SrcWrapper\src\HAL\stm32yyxx_hal_rcc.c.o
Compiling .pio\build\mks_robin_e3\SrcWrapper\src\HAL\stm32yyxx_hal_rcc_ex.c.o
Compiling .pio\build\mks_robin_e3\SrcWrapper\src\HAL\stm32yyxx_hal_rng.c.o
Compiling .pio\build\mks_robin_e3\SrcWrapper\src\HAL\stm32yyxx_hal_rng_ex.c.o
Compiling .pio\build\mks_robin_e3\SrcWrapper\src\HAL\stm32yyxx_hal_rtc.c.o
Compiling .pio\build\mks_robin_e3\SrcWrapper\src\HAL\stm32yyxx_hal_rtc_ex.c.o
Compiling .pio\build\mks_robin_e3\SrcWrapper\src\HAL\stm32yyxx_hal_sai.c.o
Compiling .pio\build\mks_robin_e3\SrcWrapper\src\HAL\stm32yyxx_hal_sai_ex.c.o
Compiling .pio\build\mks_robin_e3\SrcWrapper\src\HAL\stm32yyxx_hal_sd.c.o
Compiling .pio\build\mks_robin_e3\SrcWrapper\src\HAL\stm32yyxx_hal_sd_ex.c.o
Compiling .pio\build\mks_robin_e3\SrcWrapper\src\HAL\stm32yyxx_hal_sdadc.c.o
Compiling .pio\build\mks_robin_e3\SrcWrapper\src\HAL\stm32yyxx_hal_sdram.c.o
Compiling .pio\build\mks_robin_e3\SrcWrapper\src\HAL\stm32yyxx_hal_smartcard.c.o
Compiling .pio\build\mks_robin_e3\SrcWrapper\src\HAL\stm32yyxx_hal_smartcard_ex.c.o
Compiling .pio\build\mks_robin_e3\SrcWrapper\src\HAL\stm32yyxx_hal_smbus.c.o
Compiling .pio\build\mks_robin_e3\SrcWrapper\src\HAL\stm32yyxx_hal_spdifrx.c.o
Compiling .pio\build\mks_robin_e3\SrcWrapper\src\HAL\stm32yyxx_hal_spi.c.o
Compiling .pio\build\mks_robin_e3\SrcWrapper\src\HAL\stm32yyxx_hal_spi_ex.c.o
Compiling .pio\build\mks_robin_e3\SrcWrapper\src\HAL\stm32yyxx_hal_sram.c.o
Compiling .pio\build\mks_robin_e3\SrcWrapper\src\HAL\stm32yyxx_hal_swpmi.c.o
Compiling .pio\build\mks_robin_e3\SrcWrapper\src\HAL\stm32yyxx_hal_tim.c.o
Compiling .pio\build\mks_robin_e3\SrcWrapper\src\HAL\stm32yyxx_hal_tim_ex.c.o
Compiling .pio\build\mks_robin_e3\SrcWrapper\src\HAL\stm32yyxx_hal_tsc.c.o
Compiling .pio\build\mks_robin_e3\SrcWrapper\src\HAL\stm32yyxx_hal_uart.c.o
Compiling .pio\build\mks_robin_e3\SrcWrapper\src\HAL\stm32yyxx_hal_uart_ex.c.o
Compiling .pio\build\mks_robin_e3\SrcWrapper\src\HAL\stm32yyxx_hal_usart.c.o
Compiling .pio\build\mks_robin_e3\SrcWrapper\src\HAL\stm32yyxx_hal_usart_ex.c.o
Compiling .pio\build\mks_robin_e3\SrcWrapper\src\HAL\stm32yyxx_hal_wwdg.c.o
Compiling .pio\build\mks_robin_e3\SrcWrapper\src\LL\stm32yyxx_ll_adc.c.o
Compiling .pio\build\mks_robin_e3\SrcWrapper\src\LL\stm32yyxx_ll_bdma.c.o
Compiling .pio\build\mks_robin_e3\SrcWrapper\src\LL\stm32yyxx_ll_comp.c.o
Compiling .pio\build\mks_robin_e3\SrcWrapper\src\LL\stm32yyxx_ll_cordic.c.o
Compiling .pio\build\mks_robin_e3\SrcWrapper\src\LL\stm32yyxx_ll_crc.c.o
Compiling .pio\build\mks_robin_e3\SrcWrapper\src\LL\stm32yyxx_ll_crs.c.o
Compiling .pio\build\mks_robin_e3\SrcWrapper\src\LL\stm32yyxx_ll_dac.c.o
Compiling .pio\build\mks_robin_e3\SrcWrapper\src\LL\stm32yyxx_ll_delayblock.c.o
Compiling .pio\build\mks_robin_e3\SrcWrapper\src\LL\stm32yyxx_ll_dma.c.o
Compiling .pio\build\mks_robin_e3\SrcWrapper\src\LL\stm32yyxx_ll_dma2d.c.o
Compiling .pio\build\mks_robin_e3\SrcWrapper\src\LL\stm32yyxx_ll_exti.c.o
Compiling .pio\build\mks_robin_e3\SrcWrapper\src\LL\stm32yyxx_ll_fmac.c.o
Compiling .pio\build\mks_robin_e3\SrcWrapper\src\LL\stm32yyxx_ll_fmc.c.o
Compiling .pio\build\mks_robin_e3\SrcWrapper\src\LL\stm32yyxx_ll_fsmc.c.o
Compiling .pio\build\mks_robin_e3\SrcWrapper\src\LL\stm32yyxx_ll_gpio.c.o
Compiling .pio\build\mks_robin_e3\SrcWrapper\src\LL\stm32yyxx_ll_hrtim.c.o
Compiling .pio\build\mks_robin_e3\SrcWrapper\src\LL\stm32yyxx_ll_i2c.c.o
Compiling .pio\build\mks_robin_e3\SrcWrapper\src\LL\stm32yyxx_ll_lptim.c.o
Compiling .pio\build\mks_robin_e3\SrcWrapper\src\LL\stm32yyxx_ll_lpuart.c.o
Compiling .pio\build\mks_robin_e3\SrcWrapper\src\LL\stm32yyxx_ll_mdma.c.o
Compiling .pio\build\mks_robin_e3\SrcWrapper\src\LL\stm32yyxx_ll_opamp.c.o
Compiling .pio\build\mks_robin_e3\SrcWrapper\src\LL\stm32yyxx_ll_pka.c.o
Compiling .pio\build\mks_robin_e3\SrcWrapper\src\LL\stm32yyxx_ll_pwr.c.o
Compiling .pio\build\mks_robin_e3\SrcWrapper\src\LL\stm32yyxx_ll_rcc.c.o
Compiling .pio\build\mks_robin_e3\SrcWrapper\src\LL\stm32yyxx_ll_rng.c.o
Compiling .pio\build\mks_robin_e3\SrcWrapper\src\LL\stm32yyxx_ll_rtc.c.o
Compiling .pio\build\mks_robin_e3\SrcWrapper\src\LL\stm32yyxx_ll_sdmmc.c.o
Compiling .pio\build\mks_robin_e3\SrcWrapper\src\LL\stm32yyxx_ll_spi.c.o
Compiling .pio\build\mks_robin_e3\SrcWrapper\src\LL\stm32yyxx_ll_swpmi.c.o
Compiling .pio\build\mks_robin_e3\SrcWrapper\src\LL\stm32yyxx_ll_tim.c.o
Compiling .pio\build\mks_robin_e3\SrcWrapper\src\LL\stm32yyxx_ll_ucpd.c.o
Compiling .pio\build\mks_robin_e3\SrcWrapper\src\LL\stm32yyxx_ll_usart.c.o
Compiling .pio\build\mks_robin_e3\SrcWrapper\src\LL\stm32yyxx_ll_usb.c.o
Compiling .pio\build\mks_robin_e3\SrcWrapper\src\LL\stm32yyxx_ll_utils.c.o
Compiling .pio\build\mks_robin_e3\SrcWrapper\src\stm32\PortNames.c.o
Compiling .pio\build\mks_robin_e3\SrcWrapper\src\stm32\analog.cpp.o
Compiling .pio\build\mks_robin_e3\SrcWrapper\src\stm32\bootloader.c.o
Compiling .pio\build\mks_robin_e3\SrcWrapper\src\stm32\clock.c.o
Compiling .pio\build\mks_robin_e3\SrcWrapper\src\stm32\core_callback.c.o
Compiling .pio\build\mks_robin_e3\SrcWrapper\src\stm32\dwt.c.o
Compiling .pio\build\mks_robin_e3\SrcWrapper\src\stm32\hw_config.c.o
Compiling .pio\build\mks_robin_e3\SrcWrapper\src\stm32\interrupt.cpp.o
Compiling .pio\build\mks_robin_e3\SrcWrapper\src\stm32\lock_resource.c.o
Compiling .pio\build\mks_robin_e3\SrcWrapper\src\stm32\low_power.c.o
Compiling .pio\build\mks_robin_e3\SrcWrapper\src\stm32\pinmap.c.o
Compiling .pio\build\mks_robin_e3\SrcWrapper\src\stm32\rtc.c.o
Compiling .pio\build\mks_robin_e3\SrcWrapper\src\stm32\stm32_def.c.o
Compiling .pio\build\mks_robin_e3\SrcWrapper\src\stm32\stm32_eeprom.c.o
Compiling .pio\build\mks_robin_e3\SrcWrapper\src\stm32\system_stm32yyxx.c.o
Compiling .pio\build\mks_robin_e3\SrcWrapper\src\stm32\timer.c.o
Compiling .pio\build\mks_robin_e3\SrcWrapper\src\stm32\uart.c.o
Compiling .pio\build\mks_robin_e3\SrcWrapper\src\syscalls.c.o
Compiling .pio\build\mks_robin_e3\src\src\HAL\STM32\HAL.cpp.o
Compiling .pio\build\mks_robin_e3\src\src\HAL\STM32\HAL_MinSerial.cpp.o
Compiling .pio\build\mks_robin_e3\src\src\HAL\STM32\HAL_SPI.cpp.o
Compiling .pio\build\mks_robin_e3\src\src\HAL\STM32\MarlinSPI.cpp.o
Compiling .pio\build\mks_robin_e3\src\src\HAL\STM32\MarlinSerial.cpp.o
Compiling .pio\build\mks_robin_e3\src\src\HAL\STM32\Sd2Card_sdio_stm32duino.cpp.o
Compiling .pio\build\mks_robin_e3\src\src\HAL\STM32\Servo.cpp.o
Compiling .pio\build\mks_robin_e3\src\src\HAL\STM32\eeprom_bl24cxx.cpp.o
Compiling .pio\build\mks_robin_e3\src\src\HAL\STM32\eeprom_flash.cpp.o
Compiling .pio\build\mks_robin_e3\src\src\HAL\STM32\eeprom_if_iic.cpp.o
Compiling .pio\build\mks_robin_e3\src\src\HAL\STM32\eeprom_sdcard.cpp.o
Compiling .pio\build\mks_robin_e3\src\src\HAL\STM32\eeprom_sram.cpp.o
Compiling .pio\build\mks_robin_e3\src\src\HAL\STM32\eeprom_wired.cpp.o
Compiling .pio\build\mks_robin_e3\src\src\HAL\STM32\fast_pwm.cpp.o
Compiling .pio\build\mks_robin_e3\src\src\HAL\STM32\fastio.cpp.o
Compiling .pio\build\mks_robin_e3\src\src\HAL\STM32\msc_sd.cpp.o
Compiling .pio\build\mks_robin_e3\src\src\HAL\STM32\tft\gt911.cpp.o
Compiling .pio\build\mks_robin_e3\src\src\HAL\STM32\tft\tft_fsmc.cpp.o
Compiling .pio\build\mks_robin_e3\src\src\HAL\STM32\tft\tft_ltdc.cpp.o
Compiling .pio\build\mks_robin_e3\src\src\HAL\STM32\tft\tft_spi.cpp.o
Compiling .pio\build\mks_robin_e3\src\src\HAL\STM32\tft\xpt2046.cpp.o
Compiling .pio\build\mks_robin_e3\src\src\HAL\STM32\timers.cpp.o
Compiling .pio\build\mks_robin_e3\src\src\HAL\STM32\usb_host.cpp.o
Compiling .pio\build\mks_robin_e3\src\src\HAL\STM32\usb_serial.cpp.o
Compiling .pio\build\mks_robin_e3\src\src\HAL\STM32\watchdog.cpp.o
Compiling .pio\build\mks_robin_e3\src\src\HAL\shared\Delay.cpp.o
Compiling .pio\build\mks_robin_e3\src\src\HAL\shared\HAL_MinSerial.cpp.o
Compiling .pio\build\mks_robin_e3\src\src\HAL\shared\backtrace\backtrace.cpp.o
Compiling .pio\build\mks_robin_e3\src\src\HAL\shared\backtrace\unwarm.cpp.o
Compiling .pio\build\mks_robin_e3\src\src\HAL\shared\backtrace\unwarm_arm.cpp.o
Compiling .pio\build\mks_robin_e3\src\src\HAL\shared\backtrace\unwarm_thumb.cpp.o
Compiling .pio\build\mks_robin_e3\src\src\HAL\shared\backtrace\unwarmbytab.cpp.o
Compiling .pio\build\mks_robin_e3\src\src\HAL\shared\backtrace\unwarmmem.cpp.o
Compiling .pio\build\mks_robin_e3\src\src\HAL\shared\backtrace\unwinder.cpp.o
Compiling .pio\build\mks_robin_e3\src\src\HAL\shared\backtrace\unwmemaccess.cpp.o
Compiling .pio\build\mks_robin_e3\src\src\HAL\shared\eeprom_api.cpp.o
Compiling .pio\build\mks_robin_e3\src\src\HAL\shared\esp_wifi.cpp.o
Compiling .pio\build\mks_robin_e3\src\src\HAL\shared\servo.cpp.o
Compiling .pio\build\mks_robin_e3\src\src\MarlinCore.cpp.o
Compiling .pio\build\mks_robin_e3\src\src\core\serial.cpp.o
Compiling .pio\build\mks_robin_e3\src\src\core\utility.cpp.o
Compiling .pio\build\mks_robin_e3\src\src\feature\ammeter.cpp.o
Compiling .pio\build\mks_robin_e3\src\src\feature\tmc_util.cpp.o
Compiling .pio\build\mks_robin_e3\src\src\gcode\calibrate\G28.cpp.o
Compiling .pio\build\mks_robin_e3\src\src\gcode\config\M200-M205.cpp.o
Compiling .pio\build\mks_robin_e3\src\src\gcode\config\M220.cpp.o
Compiling .pio\build\mks_robin_e3\src\src\gcode\config\M221.cpp.o
Compiling .pio\build\mks_robin_e3\src\src\gcode\config\M301.cpp.o
Compiling .pio\build\mks_robin_e3\src\src\gcode\config\M302.cpp.o
Compiling .pio\build\mks_robin_e3\src\src\gcode\config\M304.cpp.o
Compiling .pio\build\mks_robin_e3\src\src\gcode\config\M309.cpp.o
Compiling .pio\build\mks_robin_e3\src\src\gcode\config\M92.cpp.o
Compiling .pio\build\mks_robin_e3\src\src\gcode\control\M108_M112_M410.cpp.o
Compiling .pio\build\mks_robin_e3\src\src\gcode\control\M111.cpp.o
Compiling .pio\build\mks_robin_e3\src\src\gcode\control\M120_M121.cpp.o
Compiling .pio\build\mks_robin_e3\src\src\gcode\control\M17_M18_M84.cpp.o
Compiling .pio\build\mks_robin_e3\src\src\gcode\control\M211.cpp.o
Compiling .pio\build\mks_robin_e3\src\src\gcode\control\M400.cpp.o
Compiling .pio\build\mks_robin_e3\src\src\gcode\control\M80_M81.cpp.o
Compiling .pio\build\mks_robin_e3\src\src\gcode\control\M85.cpp.o
Compiling .pio\build\mks_robin_e3\src\src\gcode\control\M993_M994.cpp.o
Compiling .pio\build\mks_robin_e3\src\src\gcode\control\M997.cpp.o
Compiling .pio\build\mks_robin_e3\src\src\gcode\control\M999.cpp.o
Compiling .pio\build\mks_robin_e3\src\src\gcode\control\T.cpp.o
Compiling .pio\build\mks_robin_e3\src\src\gcode\eeprom\M500-M504.cpp.o
Compiling .pio\build\mks_robin_e3\src\src\gcode\feature\digipot\M907-M910.cpp.o
Compiling .pio\build\mks_robin_e3\src\src\gcode\feature\trinamic\M122.cpp.o
Compiling .pio\build\mks_robin_e3\src\src\gcode\feature\trinamic\M569.cpp.o
Compiling .pio\build\mks_robin_e3\src\src\gcode\feature\trinamic\M906.cpp.o
Compiling .pio\build\mks_robin_e3\src\src\gcode\feature\trinamic\M911-M914.cpp.o
Compiling .pio\build\mks_robin_e3\src\src\gcode\gcode.cpp.o
Compiling .pio\build\mks_robin_e3\src\src\gcode\gcode_d.cpp.o
Compiling .pio\build\mks_robin_e3\src\src\gcode\geometry\G92.cpp.o
Compiling .pio\build\mks_robin_e3\src\src\gcode\geometry\M206_M428.cpp.o
Compiling .pio\build\mks_robin_e3\src\src\gcode\host\M110.cpp.o
Compiling .pio\build\mks_robin_e3\src\src\gcode\host\M113.cpp.o
Compiling .pio\build\mks_robin_e3\src\src\gcode\host\M114.cpp.o
Compiling .pio\build\mks_robin_e3\src\src\gcode\host\M115.cpp.o
Compiling .pio\build\mks_robin_e3\src\src\gcode\host\M118.cpp.o
Compiling .pio\build\mks_robin_e3\src\src\gcode\host\M119.cpp.o
Compiling .pio\build\mks_robin_e3\src\src\gcode\lcd\M0_M1.cpp.o
Compiling .pio\build\mks_robin_e3\src\src\gcode\lcd\M117.cpp.o
Compiling .pio\build\mks_robin_e3\src\src\gcode\lcd\M145.cpp.o
Compiling .pio\build\mks_robin_e3\src\src\gcode\lcd\M300.cpp.o
Compiling .pio\build\mks_robin_e3\src\src\gcode\motion\G0_G1.cpp.o
Compiling .pio\build\mks_robin_e3\src\src\gcode\motion\G2_G3.cpp.o
Compiling .pio\build\mks_robin_e3\src\src\gcode\motion\G4.cpp.o
Compiling .pio\build\mks_robin_e3\src\src\gcode\parser.cpp.o
Compiling .pio\build\mks_robin_e3\src\src\gcode\queue.cpp.o
Compiling .pio\build\mks_robin_e3\src\src\gcode\sd\M1001.cpp.o
Compiling .pio\build\mks_robin_e3\src\src\gcode\sd\M20.cpp.o
Compiling .pio\build\mks_robin_e3\src\src\gcode\sd\M21_M22.cpp.o
Compiling .pio\build\mks_robin_e3\src\src\gcode\sd\M23.cpp.o
Compiling .pio\build\mks_robin_e3\src\src\gcode\sd\M24_M25.cpp.o
Compiling .pio\build\mks_robin_e3\src\src\gcode\sd\M26.cpp.o
Compiling .pio\build\mks_robin_e3\src\src\gcode\sd\M27.cpp.o
Compiling .pio\build\mks_robin_e3\src\src\gcode\sd\M28_M29.cpp.o
Compiling .pio\build\mks_robin_e3\src\src\gcode\sd\M30.cpp.o
Compiling .pio\build\mks_robin_e3\src\src\gcode\sd\M32.cpp.o
Compiling .pio\build\mks_robin_e3\src\src\gcode\sd\M33.cpp.o
Compiling .pio\build\mks_robin_e3\src\src\gcode\sd\M34.cpp.o
Compiling .pio\build\mks_robin_e3\src\src\gcode\sd\M524.cpp.o
Compiling .pio\build\mks_robin_e3\src\src\gcode\sd\M928.cpp.o
Compiling .pio\build\mks_robin_e3\src\src\gcode\stats\M31.cpp.o
Compiling .pio\build\mks_robin_e3\src\src\gcode\stats\M75-M78.cpp.o
Compiling .pio\build\mks_robin_e3\src\src\gcode\temp\M104_M109.cpp.o
Compiling .pio\build\mks_robin_e3\src\src\gcode\temp\M105.cpp.o
Compiling .pio\build\mks_robin_e3\src\src\gcode\temp\M106_M107.cpp.o
Compiling .pio\build\mks_robin_e3\src\src\gcode\temp\M140_M190.cpp.o
Compiling .pio\build\mks_robin_e3\src\src\gcode\temp\M141_M191.cpp.o
Compiling .pio\build\mks_robin_e3\src\src\gcode\temp\M155.cpp.o
Compiling .pio\build\mks_robin_e3\src\src\gcode\temp\M303.cpp.o
Compiling .pio\build\mks_robin_e3\src\src\gcode\units\M82_M83.cpp.o
Compiling .pio\build\mks_robin_e3\src\src\lcd\dogm\lcdprint_u8g.cpp.o
Compiling .pio\build\mks_robin_e3\src\src\lcd\dogm\marlinui_DOGM.cpp.o
Compiling .pio\build\mks_robin_e3\src\src\lcd\dogm\status_screen_DOGM.cpp.o
Compiling .pio\build\mks_robin_e3\src\src\lcd\dogm\status_screen_lite_ST7920.cpp.o
Compiling .pio\build\mks_robin_e3\src\src\lcd\dogm\u8g_dev_ssd1306_sh1106_128x64_I2C.cpp.o
Compiling .pio\build\mks_robin_e3\src\src\lcd\dogm\u8g_dev_ssd1309_12864.cpp.o
Compiling .pio\build\mks_robin_e3\src\src\lcd\dogm\u8g_dev_st7565_64128n_HAL.cpp.o
Compiling .pio\build\mks_robin_e3\src\src\lcd\dogm\u8g_dev_st7920_128x64_HAL.cpp.o
Compiling .pio\build\mks_robin_e3\src\src\lcd\dogm\u8g_dev_tft_upscale_from_128x64.cpp.o
Compiling .pio\build\mks_robin_e3\src\src\lcd\dogm\u8g_dev_uc1701_mini12864_HAL.cpp.o
Compiling .pio\build\mks_robin_e3\src\src\lcd\dogm\u8g_fontutf8.cpp.o
Compiling .pio\build\mks_robin_e3\src\src\lcd\dogm\ultralcd_st7920_u8glib_rrd_AVR.cpp.o
Compiling .pio\build\mks_robin_e3\src\src\lcd\extui\ui_api.cpp.o
Compiling .pio\build\mks_robin_e3\src\src\lcd\fontutils.cpp.o
Compiling .pio\build\mks_robin_e3\src\src\lcd\lcdprint.cpp.o
Compiling .pio\build\mks_robin_e3\src\src\lcd\marlinui.cpp.o
Compiling .pio\build\mks_robin_e3\src\src\lcd\menu\menu.cpp.o
Compiling .pio\build\mks_robin_e3\src\src\lcd\menu\menu_advanced.cpp.o
Compiling .pio\build\mks_robin_e3\src\src\lcd\menu\menu_configuration.cpp.o
Compiling .pio\build\mks_robin_e3\src\src\lcd\menu\menu_game.cpp.o
Compiling .pio\build\mks_robin_e3\src\src\lcd\menu\menu_main.cpp.o
Compiling .pio\build\mks_robin_e3\src\src\lcd\menu\menu_media.cpp.o
Compiling .pio\build\mks_robin_e3\src\src\lcd\menu\menu_mixer.cpp.o
Compiling .pio\build\mks_robin_e3\src\src\lcd\menu\menu_motion.cpp.o
Compiling .pio\build\mks_robin_e3\src\src\lcd\menu\menu_probe_offset.cpp.o
Compiling .pio\build\mks_robin_e3\src\src\lcd\menu\menu_temperature.cpp.o
Compiling .pio\build\mks_robin_e3\src\src\lcd\menu\menu_tmc.cpp.o
Compiling .pio\build\mks_robin_e3\src\src\lcd\menu\menu_tune.cpp.o
Compiling .pio\build\mks_robin_e3\src\src\libs\buzzer.cpp.o
Compiling .pio\build\mks_robin_e3\src\src\libs\crc16.cpp.o
Compiling .pio\build\mks_robin_e3\src\src\libs\numtostr.cpp.o
Compiling .pio\build\mks_robin_e3\src\src\libs\stopwatch.cpp.o
Compiling .pio\build\mks_robin_e3\src\src\libs\vector_3.cpp.o
Compiling .pio\build\mks_robin_e3\src\src\module\endstops.cpp.o
Compiling .pio\build\mks_robin_e3\src\src\module\motion.cpp.o
Compiling .pio\build\mks_robin_e3\src\src\module\planner.cpp.o
Compiling .pio\build\mks_robin_e3\src\src\module\settings.cpp.o
Compiling .pio\build\mks_robin_e3\src\src\module\stepper.cpp.o
Compiling .pio\build\mks_robin_e3\src\src\module\stepper\indirection.cpp.o
Compiling .pio\build\mks_robin_e3\src\src\module\stepper\trinamic.cpp.o
Compiling .pio\build\mks_robin_e3\src\src\module\temperature.cpp.o
Compiling .pio\build\mks_robin_e3\src\src\module\tool_change.cpp.o
Compiling .pio\build\mks_robin_e3\src\src\sd\Sd2Card.cpp.o
Compiling .pio\build\mks_robin_e3\src\src\sd\SdBaseFile.cpp.o
Compiling .pio\build\mks_robin_e3\src\src\sd\SdFatUtil.cpp.o
Compiling .pio\build\mks_robin_e3\src\src\sd\SdFile.cpp.o
Compiling .pio\build\mks_robin_e3\src\src\sd\SdVolume.cpp.o
Compiling .pio\build\mks_robin_e3\src\src\sd\cardreader.cpp.o
Compiling .pio\build\mks_robin_e3\lib7c0\SoftwareSerial\SoftwareSerial.cpp.o
Compiling .pio\build\mks_robin_e3\lib8f2\SPI\SPI.cpp.o
Compiling .pio\build\mks_robin_e3\lib8f2\SPI\utility\spi_com.c.o
Compiling .pio\build\mks_robin_e3\lib06f\TMCStepper\source\CHOPCONF.cpp.o
Compiling .pio\build\mks_robin_e3\lib06f\TMCStepper\source\COOLCONF.cpp.o
Archiving
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

Thread 133 (2021-08-18):

Z axis not homing on delta firmware

happy-zelebob, 2021-08-18:
There is a problem with the MKS Robin E3D v1.1 board, presumably. I put the usual Ender 3 firmware on it, everything worked fine. Next, I installed modified firmware of the delta printer (Anycubic Kossel), after which when I send the head to the home point (Autohome), the Z axis is not sent to the endstop switch. If in detail, then first the X-axis is sent, everything is fine with it, the Y-axis, everything is fine with it, and then the Z-axis is lowered by some distance. In this case, if I press "Move Z", then all motors are working and the head is evenly move down vertically. I checked the operation of the motor and limit switch, everything is fine with them, I checked whether I indicated the correct board in the firmware, this is also okay (v 1.1). What could be the problem?

My configuration file
[configuration.zip](https://github.com/makerbase-mks/MKS-Robin-E3-E3D/files/7009383/configuration.zip)

mks-viva, 2021-08-19:
The board use to Ender3 and it's will work, so, no problem with the hardware. I think you need check you endstop settings

happy-zelebob, 2021-08-20:
It was realy problem with endstops. I needed to use z min plug, not z max.

Closed 2021-08-20.

Thread 134 (2021-08-18):

Wanhao i3 plus

131710cc, 2021-08-18:
Can i use this board to upgrade my wanhao i3 plus?

if so, there is any tutorial that can help me do it. i can only find ender 3 tutorials

Is the drv8825 compatible to this board?

mks-viva, 2021-08-19:
This is a 4axis board, if you select E3D board, you can select MKS TMC2209 or other drivers, if you select E3 board and it's integrated 2209 driver uart mode.

131710cc, 2021-08-19:
> This is a 4axis board, if you select E3D board, you can select MKS TMC2209 or other drivers, if you select E3 board and it's integrated 2209 driver uart mode.

but there is a "how to" to upgrade my wanhao?

mks-viva, 2021-08-20:
Melzi picture provide to me.

mks-viva, 2021-08-21:
You only use 2 cable connect to E3D board

Thread 135 (2021-08-31):

REPRAP_DISCOUNT_SMART_CONTROLLER

131710cc, 2021-08-31:
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
This is how is my lcd after connect to my e3d, with a sd or not, it do not show any character

mks-viva, 2021-09-01:
Please provide your source code to me.

mks-viva, 2021-09-07:
I has test it and it's will work. May be you need check your wiring and your lcd.
[Robin_e3.zip](https://github.com/makerbase-mks/MKS-Robin-E3-E3D/files/7119646/Robin_e3.zip)
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

131710cc, 2021-09-07:
Could you send me the correct way to wiring this lcd? cause it looks right in the picture.

mks-viva, 2021-09-13:
Connect the EXP1 and EXP2 cable to the screen and to the motherboard if it still doesn't work this means you have to rotate the plug 180 degrees.
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

Closed 2021-09-23.

Thread 136 (2021-09-10):

MKS robin e3d v1.1+TMC2130 SPI Fail

Warober, 2021-09-10:
Hi I have a problem with MKS robin e3d v1.1.
The problem is that if I load Marlin (2.0.9.1) with the TMC2130, the MKS MINI12864 V3 LCD screen freezes at startup, the Marlin logo appears and crashes. I have tried compiling with TMC2130_STANDALONE and it boots perfectly. I have also tried another screen and the error is the same.
The bug is caused by activating the SPI function of the drivers.
Thanks greetings

mks-viva, 2021-09-13:
https://github.com/MarlinFirmware/Marlin/issues/22755

mks-viva, 2021-09-16:
You need use the latest version marlin test

mks-viva, 2021-09-16:
My test is ok, you can download test it
[Marlin-bugfix-2.0.x-E3D-TMCSPI.zip](https://github.com/makerbase-mks/MKS-Robin-E3-E3D/files/7174366/Marlin-bugfix-2.0.x-E3D-TMCSPI.zip)
[Robin_e3.zip](https://github.com/makerbase-mks/MKS-Robin-E3-E3D/files/7174367/Robin_e3.zip)

Closed 2021-09-23.

Thread 137 (2021-09-12):

stepper motor move only in one direction

zeck7, 2021-09-12:
Hi, this my first time upgrade to a new board. i had a problem with my X motor only move in left direction After some troubles shoot I've swap with other the stepper driver, swap connector with Y motor, change connector pin(move to opposite direction but only that one direction) and change inverted in fimware and It seems that pin on board of X motor always move to one direction. im using mks robin e3d and tmc2209.

mks-viva, 2021-09-13:
According to your description, it should be caused by the 2209 module

zeck7, 2021-09-13:
i've also have swap with different stepper driver

zeck7, 2021-09-13:
is there a way I could remap the dir pin (pb2) in the board?

mks-viva, 2021-09-14:
Maybe it is caused by the firmware, you try to return to zero first, and then move the X axis.

zeck7, 2021-09-14:
ive done that too. still moving one direction. Is there a way i could jumper X dir signal from boaaard to stepper driver?

mks-viva, 2021-09-14:
Can you provide pictures?

zeck7, 2021-09-16:
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
I found the silkscreen marking but I don't know how solder? No contact pad available.

zeck7, 2021-09-16:
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
And I just noticed on schematic "X_dir" not wiring directly like "Z_DIR", "E0_DIR", and "Y_DIR" pin? Is this the main cause that my stepper X motor move only one direction?

bevanweiss, 2021-09-18:
X_DIR has a pulldown resistor to ensure it has a valid state at boot up.  This is very unlikely to be your problem.
So you have tried with a different stepper driver in this position?
Which version of Marlin are you running?  How did you source this version, and if you compiled it yourself, what configs do you have setup? (attach your Configuration.h and Configuration_adv.h)

Are you using the UART mode for the TMC2209, or stand-alone?  What jumpers do you have configured under the TMC2209 for the X-axis stepper?

zeck7, 2021-09-18:
Im using
marlin2.0
tmc_2099, uart mode.
jumper at board as uart mode with one jumper.

At first I'm using "Marlin-2.0.6.1_for_ender3_TMC2209.bin" file from makerbase precompile .bin files at here https://github.com/makerbase-mks/MKS-Robin-E3-E3D/tree/master/firmware/V1.1/Firmware%20bin%20for%20ender3 . Yup I've change file name to "Robin_e3.bin" first and copy to root directory of sd card and  it boot like normal.  Every tool on my ender3 work like it should be they're are normal except my X axis motor which only move in one direction.
Then...
I thought maybe I need to change "INVERT_X_DIR" from "false'' to ''true"  in firmware so I tried compile marlin 2.0 and Mks e3d v1.1 config file from "Marlin example config files". And after I change what recommended, I copy the bin file to sd card and screen boot like normal then I check each axis, tools, endstop, they function as intended except at X axis always move only in one direction.

One more things:
On ender 3 screen  if I move X axis +10mm, my X axis move to the left.
and then if I move back X axis -10mm, my X axis still move to the left

bevanweiss, 2021-09-18:
You should double check the following file:
Marlin\src\pins\stm32f1\pins_MKS_ROBIN_E3_common.h
To confirm that X_DIR_PIN is defined as PB2

You could get a multimeter and check if the X_DIR pin (at R58, or on the step stick) is actually changing.
You might have an issue with the resistor array (R58)

zeck7, 2021-09-18:
I have multimeter but I don't know how use / measure. Can you guide me how? as how to setting the multimeter reading at V, or Ohm or continuity and where -ve probe to touch and +ve probe to touch. Thank you so much 🙏🏻🙏🏻

bevanweiss, 2021-09-18:
Have your stepper free from any mechanical constraints, definitely don't have it driving a physical axis.

Have the firmware without the direction inversion, and then make it do a really long move in the positive direction.  then measure the points shown (you can measure on the top of the step stick).
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
Then do a really long move in the reverse direction, and again measure the points shown.

Then change the firmware to have direction inversion, and do the same two tests.

If you don't get any voltage at all (you'd be expecting to see about 3.3V for a '1' and ~0V for a '0'), then that suggests that you've got a board problem.  Possibly firmware, possibly uC, possibly traces from uC pin to resistor array, possibly resistor array, possibly traces from resistor array to step stick socket pin.
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

If you do get changes in voltage, then it's your stepper driver that's not working.

To repair the uC or traces would be quite advanced.  So at that stage you'd be in a better situation to just replace the board.  Unless you have a friend that is good with fine pitch electronics.  You could get them to re-solder the PB2 pin... it's possibly a dry solder joint and is not making contact.  But that's incredibly unlikely..  and it would be easy to make things worse with solder bridges.

zeck7, 2021-09-18:
thanks for guiding me.
after measure the voltage across  "dir" and "gnd"
I got 2.9v  when I increased/move the value  of X axis "the plus  direction" (motor spinning CW)
and
I got 0.2v when I decreased/move the value of X axis "the minus direction" (yet motor still spin CW)

and one more thing I observe the voltage stay constant at 2.9v when I move motor to plus(+) direction even the motor finish it rotation.
And same goes to if I move the motor to minus(-) direction the voltage reading stay constant at 0.2v even after the motor has done it rotation.

zeck7, 2021-09-18:
additional info.
I tried your experiment to read the voltage across  Y and Z axis just for sake of comparing and I notice there is massive different in voltage reading.
at Y and Z axis if I move the axis to plus direction I got 3.6v
and I got much near to zero volt or at 0.02v if I reverse the direction
compare to my problem X axis high at 2.6V and low at 0.2V

zeck7, 2021-09-18:
God please give this man a shit load reward.
bevanweiss you are the best!! I found out that if I move the "driver IC power" jumer pin to 3.3v my  X axis problem gone!.
 I dont know why eventho im not plan on using sensorless homing.

zeck7, 2021-09-18:
I LOVE YOU SO MUCH!
bevanweiss you just restore the faith in humanity. Most people said "Buy new board" but you keep digging with me and teching me new thing on how to use multimeter and finding the possible problem. God bless you 👼🏻👼🏻

bevanweiss, 2021-09-18:
It might be worth you removing the step stick and either measuring from the bottom of the main board, or by putting some pin headers into the step stick sockets to measure again.
The Drive IC voltage select of 3.3V / 5V is separate from the uC, so should not have changed the DIR pin voltage.
That it did have an impact on the DIR pin voltage makes me think that it's your step-stick... and perhaps it's not 5V tolerant.

You do have it working now though, so not much to be gained from further investigation.
You should probably close this issue, I'd be pointing the finger at your step sticks (and the use of 5V supply voltage for them).

zeck7, 2021-09-21:
apologize Im so exited with this new board. So far my printer all working like charm I've install BL_touch and BMG extruder recently and print all calibration test i could possible find on internet and all setting dial in marvelously.
Do you means "step-stick" is "STEP pin"? so i should measure "STEP" pin and "GRD" pin like before you told me to measure "DIR" and "GRD". Means with multimeter "black probe" at "GND pin" and "red probe" at "STEP pin" right?

bevanweiss, 2021-09-21:
No, the stepstick is the driver board.  So my suggestion was to measure the DIR pin without having the driver board installed.  To see if the lower voltage was caused by the mainboard just presenting a low voltage, or by something on the driver pulling the voltage low.

But since it's all working, no need to dig deeper.

Closed 2021-09-21.

Thread 138 (2021-09-19):

mks robin e3d v1.1 How to upload bootloader?

ShWoong, 2021-09-19:
Almost Stm32F103 boards are having bootmode pin(or bootmode switch) but I can't found that pin in my board.
Plz help me... In my case I connected PC with MKS Board with enclosed blue usb cable to Serial Modul.
but STM Cube programmer could not find Board. but I confirmed connected COM5.

I want upload bootloader for Arduino in my board. Plz help me.
Thank you

bevanweiss, 2021-09-21:
BOOT0 and BOOT1 are on the chip
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

They are tied to 0V (for BOOT0) and pulled down to 0V (for BOOT1).  Hence boot occurs using pre-programmed FLASH.
This will likely be a custom MKS bootloader.
If you want to overwrite this bootloader, then you will need to use SWD via J1.

STM Cube wouldn't see the ST bootloader because it only uses that if the FLASH is empty, or BOOTx pins are configured to force ROM programmed bootloader use.
You could desolder the BOOT0 pin, lift the leg, tack on a wire and drive it, and apply a signal to BOOT1 too.. but if you just want Arduino, then you'd better find a different board.
You could probably shoe-horn Arduino into a binary image and then use the MKS bootloader to get it into the board.. but that seems like more trouble than it's worth.  I'd go the SWD way instead.

mks-viva, 2021-09-22:
You can use ST-link upload it and need not change hardware.

ShWoong, 2021-09-23:
Thank you your support. That means Do not change STM32 chip and pin setting right?

mks-viva, 2021-09-23:
Yes, you need not change hardware.

pauloeduardogodoy, 2021-09-24:
I have this board installed into my Ender-5 Pro + 4 TCM2209 drivers and configured with a custom Marlin bug-fix.

I would like just to flash the bootloader to remove the beep sound and the "boot" wording in the start.
Ia the an easy and straightforward guide/instructions explaining how to proceed?

Thanks!

bevanweiss, 2021-09-24:
Use ST-link or other similar SWD debugger tool
https://www.st.com/en/development-tools/st-link-v2.html

and then burn the firmware from here
https://github.com/makerbase-mks/MKS-Robin-E3-E3D/tree/master/firmware/Bootloader

J1 is the connector for the SWD interface.

mks-viva, 2021-09-24:
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

Closed 2021-09-24.

Thread 139 (2021-10-04):

STM32F103 / STM32F407 boards should use on-chip USB

ag88, 2021-10-04:
hi MKS,
Your boards are quite good, but STM32F103 / STM32F407 boards should use on-chip USB support instead of using a separate USB-UART

There is a problem, as seen in this PR for Marlin
https://github.com/MarlinFirmware/Marlin/pull/22529
Because STM32F103 and STM32F407 UART only has a single byte buffer. When the microcontroller is busy it can skip bytes from the host. So it becomes necessary to increase interrupt priority for the UART, this comes at a cost to interrupts to other peripherals such as HardwareTimer.

Both STM32F103 and STM32F407 has on-chip USB support, please revise your designs to use the on-chip USB rather than using a separate USB-UART bridge.

e.g. your MKS-Nano-V3 is correctly designed
https://github.com/makerbase-mks/MKS-Robin-Nano-V3.X
https://github.com/makerbase-mks/MKS-Robin-Nano-V3.X/blob/main/hardware/MKS%20Robin%20Nano%20V3.0_004/MKS%20Robin%20Nano%20V3.0_004%20SCH.pdf
pins PA11 USB D- and PA12 USB D+ goes direct to USB.
But please update your designs so that the Nano-V1 and Robin E3 etc
https://github.com/makerbase-mks/MKS-Robin-E3-E3D
https://github.com/makerbase-mks/MKS-Robin-E3-E3D/blob/master/hardware/MKS%20Robin%20E3%20V1.1_004/MKS%20Robin%20E3%20V1.1_004%20SCH.pdf
use pins PA11 USB D- and PA12 USB D+ goes direct to USB.

ag88, 2021-10-07:
Lets update the 'old' product to 'new' versions, because those boards are popular, maybe call it Nano V1.1U usb E3 vx.yU / E3D x.yU etc. using USB direct helps to solve some 3d printing problems on STM32 boards, especially with Marlin.

mks-viva, 2021-10-07:
Yes, good proposal

Thread 140 (2021-10-04):

STM32F103 / STM32F407 boards BOOT0 pin should have *jumper* (or button) to VDD 3v3

ag88, 2021-10-04:
STM32F103 / STM32F407 boards BOOT0 pin should have *jumper* (or button) to VDD 3v3, and the pin should be resistor to GND. 1k, 4.7k etc. or can jumper both sides 3V3, BOOT0, GND, so normal use jumper BOOT0, GND, program jumper 3V3, BOOT0

Your boards are quite good, but for many of your boards
e.g. Robin Nano V3
https://github.com/makerbase-mks/MKS-Robin-Nano-V3.X/blob/main/hardware/MKS%20Robin%20Nano%20V3.0_004/MKS%20Robin%20Nano%20V3.0_004%20SCH.pdf
Robin Nano V1.x
https://github.com/makerbase-mks/MKS-Robin-Nano-V1.X
Robin E3D
https://github.com/makerbase-mks/MKS-Robin-E3-E3D/blob/master/hardware/MKS%20Robin%20E3%20V1.1_004/MKS%20Robin%20E3%20V1.1_004%20SCH.pdf
https://github.com/makerbase-mks/MKS-Robin-Nano-V1.X/blob/master/hardware/MKS%20Robin%20Nano%20V1.3_002/MKS%20Robin%20Nano%20V1.3_002%20SCH.pdf

BOOT0 is tie to GND, this is not good. BOOT0 allows the use of UART to upload firmware on PA9 TX, PA10 RX for STM32F103. And for STM32F407 BOOT0 allows direct USB DFU firmware upload (no need extra boot loader or st-link). The procedure is set BOOT0, press reset, upload firmware.

So for STM32F103 (for STM32F407 as well) uart1 pins PA9, PA10 should be made available on headers. I think this is already ok.

mks-viva, 2021-10-07:
MKS Robin Nano V3.X has same the issues, so, i will close this issues.
https://github.com/makerbase-mks/MKS-Robin-Nano-V3.X/issues/63

Closed 2021-10-07.

Thread 141 (2021-10-04):

STM32F103 / STM32F407 boards, enhancement request 32khz RTC crystal and VBAT

ag88, 2021-10-04:
STM32F103 / STM32F407 boards, enhancement request 32khz RTC crystal and VBAT

STM32F103 and STM32F407 has built-in RTC (Real time clock), what is needed is a 32Khz watch crystal.
Some design needed there. Check ST documents.

In addition, VBAT pin need to power from 3v coin cell (e.g. cr2032) to keep the RTC running.
I think VBAT can leave open, not connected and goto a header pin if you don't want to put battery on board.
Those who want to use VBAT pin can connect their own cr2032 battery, or you can sell as separate add on module.

Why is this important? Because with VBAT, it is possible to use backup registers or backup SRAM. These are there inside the STM32F103 and STM32F407 chip. e.g. they can be used to store some important printer settings and still keep memory after switch off.

The RTC is also important, it keeps time. So for example, can do time based automation, e.g. set alarm clock and goto sleep. wake up in the morning and start heated bed and start printing. But those things need the RTC.
RTC also useful for monitoring print time and a lot of other things.

mks-viva, 2021-10-07:
MKS Robin Nano V3.X has same the issues, so, i will close this issues.
https://github.com/makerbase-mks/MKS-Robin-Nano-V3.X/issues/64

Closed 2021-10-07.

Thread 143 (2021-10-14):

Robin E3D v1.1 and RepRap Full Graphic Display

andresrobinson, 2021-10-14:
Hello I just bought an MKS Robin E3D V1.1 and I'm currently unable to use my RepRapDiscount FULL GRAPHIC Smart Controller.
I have it enabled on Marlin, and EXP1 and EXP2 connected to the board. Have tried rotating the connector and inverting positions without any luck.
Any suggestion?

mks-viva, 2021-10-15:
Provide your config to me.

Thread 145 (2021-11-08):

Powering up with a microSD extension cable

bulbersator, 2021-11-08:
Hi, when I power up the mainboard with the microSD extension cable connected it is stuck on blue screen. Even when the microSD card is not inserted, only the extension. Need to disconnect the extension cable to power on the 3d printer which is not comfortable. I think it is trying to load the firmware but there is no microSD card.
Is it possible to

mks-viva, 2021-11-13:
Is it possible to record a video about this issue?

Thread 146 (2021-11-16):

TFT 2.4 Babystepping issues with Marlin 2.x

selvakumaran2016, 2021-11-16:
Hello,

We are using MKS Robin E3d boards with TFT 2.4. Whenever printing, when we use babystepping, the print is freezing.

This issue was told long back, but there is no update for TFT 2.4 firmware.

We have now ordered 10sets of E3d boards + TFT 2.4.  Please support us

mks-viva, 2021-11-23:
You can update tft24 firmware.

selvakumaran2016, 2021-11-23:
I am already using the latest firmware only. It was updated 2 years back itself.
Can you please consider this as important and update the firmware accordingly?
Thanks & Regards Selvakumaran+91 82 97 11 88 77 

    On Tuesday, 23 November, 2021, 06:52:31 am IST, mks-viva ***@***.***> wrote:

You can update tft24 firmware.

—
You are receiving this because you authored the thread.
Reply to this email directly, view it on GitHub, or unsubscribe.
Triage notifications on the go with GitHub Mobile for iOS or Android.

Thread 147 (2021-11-18):

MKS E3D v1 with TMC2209 & pancake stepper

Ne0nx3r0, 2021-11-18:
I'm having an issue where there's not nearly enough torque using the ender 3 with the speedrive mod and a pancake stepper.

My setup is:

* MKS E3D v1
* TMC2209 (in UART)
* 42BYGH 23MM 1.5A Pancake stepper

I've tried adjusting the current in the firmware to 500, 700 and 850, also tried disabling stealthchop, but the motor simply doesn't seem to have enough torque.

The extruder skips, even when extruding into air. I've tried changing the motor with one that was functioning on a different printer, no difference.

I have the same setup on a MKS E3D v1.1 board that is working fine, so I'm confused why this one is not.

Someone mentioned that using a TMC2208 driver might resolve this issue as the v1 board can be buggy with 2209 drivers, is that a possibility?

Ne0nx3r0, 2021-11-20:
For what it's worth, here's the firmware I'm using:
https://github.com/Ne0nx3r0/robin_e3d_TMC2209_bltouch_safe_v1.1_speeddrive/blob/main/Marlin/Configuration_adv.h

https://github.com/Ne0nx3r0/robin_e3d_TMC2209_bltouch_safe_v1.1_speeddrive/blob/main/Marlin/Configuration.h

mks-viva, 2021-11-23:
MKS Robin E3D V1.0 and V1.1 compare：
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

Closed 2021-11-30.

Thread 148 (2021-11-23):

MKS-Robin-E3D_V1.1 FAN PA8 issues

TheHorris, 2021-11-23:
Hello,

Setup:
- MKS E3D v1
- TMC2209 V 2.0 (in UART)
- DC 12V Part cooling fan

i have some issues to run my Part cooling fan with the board on the "PA 8 Pin"
The fan works fine with the 12V output but when I try to control it with the PA 8 pin with 100% nothing happens. Im working with the Marlin 2.0 bugfix firmware.
I see no issues with the board.

thanks for help.

Horris

Firmware:
https://github.com/TheHorris/MKS-Robin-E3D-V1.1_Marlin-firmware/blob/main/Configuration.h

https://github.com/TheHorris/MKS-Robin-E3D-V1.1_Marlin-firmware/blob/main/Configuration_adv.h

pauloeduardogodoy, 2021-11-23:
Are you using a 12v PSU powering all system or just using a step-down module to reduce from 24v to 12v?

TheHorris, 2021-11-23:
I use a 12V PSU

- S-250-12 12V 20A DC power supply

mks-viva, 2021-11-30:
FAN can be control by M106 S255?

TheHorris, 2021-11-30:
sure, the display says 100% but the fan on the PIN PA8 dont run.

mks-viva, 2021-12-03:
In other words, there is no voltage output on the FAN interface?

TheHorris, 2021-12-05:
correct. There is no measurable voltage on this output.

mks-viva, 2021-12-13:
If you control FAN by command, the FAN Mos led will on?
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

TheHorris, 2021-12-13:
There is an LED?! :D No, by command the FAN Mos led is off.

mks-viva, 2021-12-23:
If you send M106 and D11 led will on, if you send M107 and it's will off. So, it means that this interface is fine

Thread 149 (2021-12-01):

marline firmware

thaers3d, 2021-12-01:
the links for firmware is not working

mks-viva, 2021-12-03:
The path firmware has been a period of time that the latest version of marlin has not been updated synchronously. It is recommended that you download and configure it directly from the marlin official website

thaers3d, 2021-12-05:
the bord is not accepting any firmware ,is like did,or maybe need bootloader.
how i can flash a bootloader on it?

mks-viva, 2021-12-13:
If you want to update bootloader, you need use JLINK tool connect to SWD (J1)

Thread 150 (2021-12-03):

PINOUT BOARD_MKS_ROBIN_E3D_V1_1

pacocatech, 2021-12-03:
Hey guys,

My FAN ports burned and I want to switch to free ports on my E3D V1.1, can you tell me which pins are associated with the connectors: J6 and J5 ?

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

mks-viva, 2021-12-13:
J5, J6 is power out and the power form you vin.

Closed 2021-12-13.

Thread 151 (2021-12-10):

Can't connect to computer by USB

skom27, 2021-12-10:
I have an Ender 3, MKS Robin E3, MKS TFT35, MKS 3D Touch, MKS FES. Marlin 2.0.9.2: I managed to configure and compile it all - it works :). Unfortunately, I can't connect the computer to the Robin E3 board via the USB cable, there is a new COM port in the computer, unfortunately the connection via the Pronterface is unsuccessful.
I get errors when trying to set ports in Configuration.h and directions from: https://github.com/makerbase-mks/MKS-Robin-E3-E3D/wiki/Can't-connect-to-computer-by-USB. The first is:
`In file included from Marlin\src\HAL\STM32\../../inc/MarlinConfig.h:49,
                 from Marlin\src\HAL\STM32\HAL_SPI.cpp:27:
Marlin\src\HAL\STM32\../../inc/SanityCheck.h:2744:6: error: #error "SERIAL_PORT is set to -1, but the MOTHERBOARD has no native USB support. Set SERIAL_PORT to a valid value for your board."
 2744 |     #error "SERIAL_PORT is set to -1, but the MOTHERBOARD has no native USB support. Set SERIAL_PORT to a valid value for your board."
      |      ^~~~~
In file included from Marlin\src\HAL\STM32\../../inc/MarlinConfig.h:49,
                 from Marlin\src\HAL\STM32\MarlinSerial.cpp:27:
Marlin\src\HAL\STM32\../../inc/SanityCheck.h:2744:6: error: #error "SERIAL_PORT is set to -1, but the MOTHERBOARD has no native USB support. Set SERIAL_PORT to a valid value for your board."
 2744 |     #error "SERIAL_PORT is set to -1, but the MOTHERBOARD has no native USB support. Set SERIAL_PORT to a valid value for your board."
      |      ^~~~~
In file included from Marlin\src\HAL\STM32\../../inc/MarlinConfig.h:49,
                 from Marlin\src\HAL\STM32\HAL.cpp:30:
Marlin\src\HAL\STM32\../../inc/SanityCheck.h:2744:6: error: #error "SERIAL_PORT is set to -1, but the MOTHERBOARD has no native USB support. Set SERIAL_PORT to a valid value for your board."
 2744 |     #error "SERIAL_PORT is set to -1, but the MOTHERBOARD has no native USB support. Set SERIAL_PORT to a valid value for your board."
      |      ^~~~~
In file included from Marlin\src\HAL\STM32\../../inc/MarlinConfig.h:49,
                 from Marlin\src\HAL\STM32\Servo.cpp:27:`
How can this be fixed?

mks-viva, 2021-12-13:
You need config serial
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

Thread 152 (2021-12-16):

USBPWR Pin

tanjunior, 2021-12-16:
I noticed there is this USBPWR pin
https://github.com/makerbase-mks/MKS-Robin-E3-E3D/blob/master/hardware/MKS%20Robin%20E3%20V1.1_004/MKS%20Robin%20E3%20V1.1_004%20PIN.pdf

What does it do? Can I use it to power a Pi Zero?

mks-viva, 2021-12-23:
This is USB's power on or off, you can not use it for your PI

tanjunior, 2024-08-30:
> This is USB's power on or off, you can not use it for your PI

What is it for then?

Thread 153 (2021-12-19):

Robin E·D V1.1 bloqueada y no actualiza.

kacharros, 2021-12-19:
Después de actualizar activando 3dtouch uso la impresora normalmente.
La apago y unas horas después al encenderla no responde, solo se ilumina led ROJO y ventilador de hotend.
Pruebo a actualizar con Robin_e3.bin, varias compilaciones distintas que ya funcionaban, y no los acepta (mantiene Robin_e3.bin y no crea el .cur). Ya probé con varias microsd, (2gb,4gb,16gb y 32gb).

Ayuda.

mks-viva, 2021-12-23:
Can you provide video when you power on.

Thread 154 (2022-01-05):

Second temp sensor

countcobolt, 2022-01-05:
Hi, is it possible to connect a second temp sensor to the board using maybe the Aux1? I would like to use the same thermistor type as used on the heaterblock (I am trying to measure my temp on the radiator)

Kind regards

Steve

MKS-hosiey, 2022-01-06:
Hello, this is not possible. To enable the second temperature measurement, you need to enable the second extrusion. This motherboard has only one extrusion interface

Thread 155 (2022-01-05):

corezx

Jarov8, 2022-01-05:
Hi.  What changes do I need to make in Marlin for Corezx to work.  (voron switchwire but on Marlin without Rpi and Klipper).  So far, I was able to run the manual control of the xyz axes.

MKS-hosiey, 2022-01-06:
Corezx on your machine? You need to enable it on the configuration file

Thread 156 (2022-01-07):

Using AUX1 RX/TX to communicate with RPI

countcobolt, 2022-01-07:
Hi, I would like to connect my RPI to the PSU of the printer, but was wondering, if it is possible to communicate with the mainboard over the RX/TX of Aux1. I currently have octopi installed on my RPI3 and connect via USB but would potentially move to a RPi Zero W and embed everything.
Could I use the 5V/GND also of the AUX to power my RPI3 or Zero W in the future?

Kind regards

Steve

reefwarrior, 2022-01-23:
hi Steve,

You can communicate with it using the RX/TX of aux1. What I have done was to connect the GND/RX/TX between the board and the rpi - and it works without a problem. You need to change the firmware tho - the first serial port declaration needs to change from '-1' to '0' in your configuration.h file.

Can't say about the power source tho.

Tinus

Thread 157 (2022-01-08):

Cooloing fans not working.

Kiwitahi, 2022-01-08:
I have just fitted MKS - Robin-E3D V1. 1
and everything seems ok except for the part cooling fan and the main board fan are not working. I followed Teaching Tech videos to compile marlin so i my coding skills very limited.
Can anyone help.

pauloeduardogodoy, 2022-01-08:
Are you using any bulk converter?

Em sáb., 8 de jan. de 2022 17:07, Kiwitahi ***@***.***>
escreveu:

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

Kiwitahi, 2022-01-08:
No Buck converter.

MKS-hosiey, 2022-01-10:
The firmware turns on the fan by default, but it cannot turn on the fan when it is operated on the lcd? Or does it not automatically turn on the fan after heating to a certain temperature?

Thread 158 (2022-01-11):

SWITCHING_EXTRUDER pin

countcobolt, 2022-01-11:
Hi all

which connection pins should I use for using a switching extruder?

Kind regards

Steve

MKS-hosiey, 2022-01-17:
Toggle extrusion? This motherboard only supports single extrusion

countcobolt, 2022-01-17:
A toggling extrusion does not need a second connector, but uses a small servo to toggle which filament is being fed.
You only need 1 extruder (which we have connections for) and through some printed parts, it selects which material is feeding as the servo will push either one or the other part.
This is part of the stock marlin firmware.
The question is, is there a connector I can use to connect a small servo to?

Kind regards

Thread 159 (2022-01-23):

Unable to compile newest marlin

reefwarrior, 2022-01-23:
Hi

I have now run out of ideas. I have changed the platformio.ini file; but no matter what I do; I can not get Marlin 2.0.9 to compile.... I keep on getting errors.... 2.0.6 builds, but I have not been able to get the FYSETC mini12864 V2.1 display to work on 2.0.6! :(

All help appreciated!
Tinus

Thread 161 (2022-02-15):

Firmware update stopped on "update 100%"

happy-zelebob, 2022-02-15:
I know about this problem https://github.com/makerbase-mks/MKS-Robin-E3-E3D/issues/101, I installed the right file, Robin_e3.bin from .pio/build/mks_robin_e3, but I still have this problem with both symptoms.

My source code:
[Marlin-2.0.6.1.zip](https://github.com/makerbase-mks/MKS-Robin-E3-E3D/files/8072734/Marlin-2.0.6.1.zip)

Seelenkind, 2022-02-19:
Is this your board ?
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
No ? so change it

happy-zelebob, 2022-02-21:
This is my board, mks robin e3d v1.1

happy-zelebob, 2022-03-04:
I tried to compile the firmware on another computer, I tried to change SD card, no result. Any help for me, Makerbase?!

Thread 164 (2022-03-05):

PID autotune doesn't stop heating the bed.

pFallenAngelq, 2022-03-05:
I've installed a mains heater for the bed, have changed the values for the new thermistor (11 as it's an Keenovo thermal pad) in  configuration.h as well as thermal_protection_bed_period and watch_bed_temp_period in configuration_adv.h but the bed just keeps on raising the temp.
Started PID autotune set to 70°, reaches 70°, keeps 70° at first cycle, starts second cycle and pushed reset at 92° (went to make a coffee).

MKS-hosiey, 2022-03-11:
Will the heating bed automatically heat up when it is turned on again?

pFallenAngelq, 2022-03-18:
> Will the heating bed automatically heat up when it is turned on again?

It heats up when I set it to heat and stays at the requested temp, but can't do PID autotune because it keeps on heating up at second cycle.

Thread 165 (2022-03-08):

Extruder not working when MKS 12864 Mini V3 enabled

bschenke2, 2022-03-08:
I recently upgraded my board to a MKS Robin E3D V1.1 and had everything working fine with the factory Anet LCD Screen running Marlin bugfix_2.0.x. I decided to upgrade the LCD to a Makerbase MKS Mini 12864 V3. When I enable the features in the code to work the new screen, everything works fine except the extruder will no longer work. When I flash it back to the previous working firmware it works perfectly again. Below are the things I enabled for the new screen:

Enable: #define MKS_MINI_12864_V3
Enable: #define NEOPIXEL_LED

I also disabled the old screen when I added the new one.

Any ideas on where the problem may lie?

MKS-hosiey, 2022-03-16:
Does your new firmware board define V1.1?

guitosi, 2022-06-01:
Boa tarde conseguiu resolver o problema, estou com o mesmo e nao consigo atualizar a firmware com esse MKS_MINI_12864_V3

bschenke2, 2022-06-09:
I have still not been able to resolve this. I'm currently still using my original LCD controller from my printer.

Vit220, 2022-06-21:
I have this problem too
if disable SDSUPORT extruder work
but i need work SDSUPORT too
marlin 2.1 bugfix

guitosi, 2022-06-21:
Atualmente estou usando octoprint para enviar arquivos já que o SDsuport precisa estar desabilitado, mas eu gostaria de poder usar o SD também.

bschenke2, 2022-06-21:
Does the SD card still work from the main board if this is disabled, or does it disable both the SD slot in the LCD board as well as the main board?

almuneeb, 2022-06-21:
I have same issue with my board

bschenke2, 2022-06-22:
I just tested mine with the SDSUPPORT disabled, and I'm still able to use the card slot on the main board. It kind of defeats the purpose of having the SD slot on the controller, but at least I'm able to print and use the new controller. I use OctoPrint for 95% of my prints anyways, so it's not a huge deal to me I guess.

guitosi, 2022-06-22:
Acabei de fazer o teste, e na minha com sdsuporte desabilitado não consigo usar, pois nem aparece a opção no display, ou eu não estou sabendo configurar.

Thread 166 (2022-03-16):

Heatbed FET overheats! - PCB design error - Output FETs GATE voltage only getting 3V3.

JazzinSA, 2022-03-16:
According to the SCH the CPU is powered with 3.3V This means that the FET that drives the heat bed can get a maximum of 3V3. Accorder to the datasheet of the FET - HY1403D - the GATE needs about 4.5V in order for the Drain-Source resistance to be less than 20milli Ohm. Thus if the GATE only gets 3.3V the D-S resistance is I estimate at about 30milli Ohm. Therefore the FET is dissipating almost 6W which is at its absolute limit. This is with a standard 250Watt heat bed.

Have anyone experienced that the FET cannot handle a heat bed at 24V? What is the heat bed current capability of the board since its not specified anyware?

JazzinSA, 2022-05-18:
OK, So a little feedback on this issue.
I have changed the Marlin code to PWM maximum to 230 and not 255. Therefore the average current on startup to get the bed on temperature is about 15% less. The average current to keep the bed hot while printing is in any case ~20%..50% of the heat-up current so it should not interfere while printing. I have used my Thermal camera to monitor the heat and it stays well within the limit. (below 60DegC which I feel is a good setpoint). While printing it runs at about 40..45DegC (on a 80DegC bed) I reacon that provides good safety margin. The only issue was to get a good PID setting but the auto PID tuning in Marlin did the trick.
Let me just add that I did add a motherboard cooling fan.

Thread 168 (2022-06-27):

J5 has a fuse?

pFallenAngelq, 2022-06-27:
Hi! As the dumb I am I've shorted J5 with a dead fan (was in my parts bin instead of the recycling bin) and my board is no longer working. Is there a SMD fuse I can change to bring it to lief again or I'm f'ed up?

Thread 169 (2022-07-05):

Cooling Fan 100% all the time

kjanek, 2022-07-05:
The cooling fan shorted out on my E3D v1.1 most probably the cooling fan MOSFET most probably dead caus it's working all the time at 100%. Can I change it or somehow fix the fan? Thanks

pauloeduardogodoy, 2022-07-06:
If you tried to install a crapy step down to use a 12V fan like I did, yes you killed the SMD transistor.

It is possible to replace, but you need to find the correct part to buy and need an SMD soldering station... Almost impossible to do it with a common soldering iron.

kjanek, 2022-07-06:
> If you tried to install a crapy step down to use a 12V fan like I did, yes you killed the SMD transistor.
>
> It is possible to replace, but you need to find the correct part to buy and need an SMD soldering station... Almost impossible to do it with a basic soldering iron.

I have not added a crappy step down. I had a 24V fan that had a little crappy connector and short cable. And throw one print the connector cables were pulled from connector and they shorted out. But still i think it made the same result as your issues. So basically the board needs a exchange :(

CrazyMark493, 2023-03-11:
i got the same problem
it was the sot-23 package mosfet died
buy some AO3400 mosfet with“A08K”on it and replace it

CrazyMark493, 2023-03-11:
>

i did it with only a crappy soldering iron

Sylwester79, 2024-02-20:
Isn't it connected to the wrong output?

Thread 170 (2022-07-24):

MKS E3-E3D Device Name

Medina-ui, 2022-07-24:
Hi all,

Can anyone change the device name that apears on Device Manager? I want to use these boards for selling printers and would like to apear the name of the printer and not the standard name.
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

Thread 172 (2022-09-30):

I broke my USB port can I connect via gpio

kjanek, 2022-09-30:
I use Klipper firmware with the Robin e3d board. Sadly i broke my USB port on the board. Can I connect it to my raspberry pi via some pins on the e3d? If yes how can I configure it?

Thread 173 (2022-12-19):

MKS-Robin-E3-E3D V1.1 after marlin update boot freeze without TFT eeprom

Tronvalaad66, 2022-12-19:
My E3D V1.1 motherboard freezes after installing the latest marlin firmware without TFT card at boot menu and keeps powering the extruder. This board has a separate EEPROM.
Why doesn't the eeprom work?

Thread 174 (2022-12-21):

This board support Core XY Printer

JungHoonLim, 2022-12-21:
Hello,

This board support Core XY Printer
Can some body help me to configure the firmware for My 3D printer ?

i will use ender 3 Display

This is my printer
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

pauloeduardogodoy, 2022-12-21:
This is a Marlin function... Uncomment #define COREXY line.
For more details read [this](https://all3dp.com/2/marlin-firmware-how-to-edit-marlin-firmware/) tutorial.

JungHoonLim, 2022-12-21:
> This is a Marlin function... Uncomment _#define COREXY_ line. For more details read [this](https://all3dp.com/2/marlin-firmware-how-to-edit-marlin-firmware/) tutorial.

thank U..^^

Thread 175 (2023-01-18):

3-wire optical endstops

nuqz, 2023-01-18:
Can't figure out how to connect [these optical endstops](https://www.trianglelab.net/products/tl-limit?VariantsId=10738). It outputs H / 1 / power voltage, when triggered.
First of all I'm interested where could I pick up 3v3 to power up an endstop?
Will it work if I just connect `S`(ignal) wire to `J11`'s pin 1 and disable pull-up for `PC6`?

Thread 177 (2023-03-13):

e3 and e3d boards part cooling fan running at full speed during startup

lotfinoluffy, 2023-03-13:
hi

since the support weren't answering nor on Facebook, their site or anywhere else I've tried (except occasionally Aliexpress for some reason) let's try once more again

Got an e3 and e3d motherboards but the pwm fans are running full speed at startup but if I change the settings to 100% in the menu ... The fans just goes off, and at 0% they’re running full speed ???
voltage is also weird
SENDING:M106 S255 V= 2.5
SENDING:M106 S0 V=3.5

not sure if the board or the mosfet are broken, thought it was some setting in marlin but even with a fresh config file its the same issue so. . . .
just wanna know if its fixable before throwing these misfits of boards and never order for mks again, what's the purpose of a product if you're not behind it and supporting clients who needs it ????

Thread 178 (2023-03-20):

mks robin e3 stuck on boot screen

AlissonResende, 2023-03-20:
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

My printer stuck on this screen and i dont know what to do.

Thread 180 (2023-06-05):

Orbiter Filament Sensor + Klipper

pauloeduardogodoy, 2023-06-05:
I just bought an Orbiter Filament Sensor (v2.2) and want to connect it to my MKS ROBIN E3D.
What pins can I use?

These are the instructions extracted from the Orbiter website. My board has the filament sensor pins, but I have no clue where could I connect the filament unload signal…

```
Connect the FS (Filament sensor signal) pin and the FU (Filament unload signal) to spare digital inputs of your main board. Best is to use pins from spare pin headers or unused expander board connections. Supply the sensor board with +3.3V and GND.

It is not recommended the use inputs with pull up resistor to 5V like end stop inputs. If these are the only spare inputs you have you may use them but in this case supply the sensor board also with 5V!
```

pauloeduardogodoy, 2023-06-22:
Looks like MKS hardware is abandoned... No response from the support in months... This is my second post without any comments from the manufacturer/support guys...

Thread 181 (2023-09-26):

Broken USB plug, can I use AUX1 ?

eaman, 2023-09-26:
I've broken the USB plug of my MKS-Robin-E3-E3D  v1.0 , in my current Marlin firmware I have:

#define SERIAL_PORT 1
#define BAUDRATE 115200

Can I use the AUX1 pins to connect via USB or at least serial (to an FTDI adapter, or I can find a RaspberryPi)?

I tried cutting  a USB cable and connecting ground - TX - RX  those into AUX1 (board powered by the printer PSU) to my computer but it does not work,
I tried the same to an FTDI adapter and it does not work.

Thread 182 (2023-09-30):

uploading custom code in Mks robin e3 v1.1

akshar2324, 2023-09-30:
hello i have this code but i want to use it for  other use i want to run single stepper motor continues i want to upload my custom code but i have never work on this type of board can anyone help me

TrulyMarcus, 2024-04-17:
Oh god this post is old, but for anyone else interested. You need an Stlink, cheap one from amazon will do. Connect the DIO, CLK, RST, GRND, and 3.3v. between the stink and the board. If you flip the board over you will see the labels on a set of six pins near the stm32 chip. Once those are connected open up the StmCubeprogrammer and plug in your Stlink to the computer. Generally it detects there is an Stlink and autofills with the connection info. You may have to try updating the Stlink firmware via a button underneath all the connection info. Also I've sometimes needed to press the reset button on the board to get the programmer to recognize the board. Once connected go to the "Erasing and Programming" tab, its the one under the pencil on the far left. You'll see file path and browse near the top of the window now. Click browse and select the .bin file you had Arduino create. I've found it works with a .bin compiled for Stm32f103RCT (Blue Button) board in the Arduino options. For the start address you put 0x08005000 . I select "verify" even though it's probably not necessary, and I leave "run after programming" unchecked. Click "start programming" and when it's done press the restart button and you should be good to go. I did this with a simple Serial output program just to keep the compilation short and the output easy, when I was done I disconnected the Stlink in the cube programmer software, opened Arduino and clicked Serial monitor.

Thread 183 (2023-12-19):

V1.0 board spread jumper

memyfofum, 2023-12-19:
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
I want to enable spread cycle on my v1.0 board, do I need to move the jumper on the spread pins marked as 7 on the diagram or do I just enable it in the firmware?

Thread 184 (2023-12-22):

3 Pin Optical Endstop

Vinsinity, 2023-12-22:
Hello, I have a 3pin optical endstop. VCC, GND, S. How can I connect it to my MKS robin E3D board? When I supply it with external 5V power and attach the GND-S pins to X-Min, the switch stays on all the time.

Thread 185 (2024-04-24):

Probe End Stop

fcriz, 2024-04-24:
Hello Guys! I am configuring a Delta Printer using 4 end stops. I have XYZ Max and at the extruder, have another endstop only to Bed Leveling and Z-Min. Well, at the board I have identified only conectors to XYZ. Were can I conect this two wires Probe End Stop?
