makerbase-mks/MKS-Robin-E3-E3D/hardware/MKS Robin E3 V1.1_004/MKS Robin E3 V1.1_004 BOTTOM.pdf

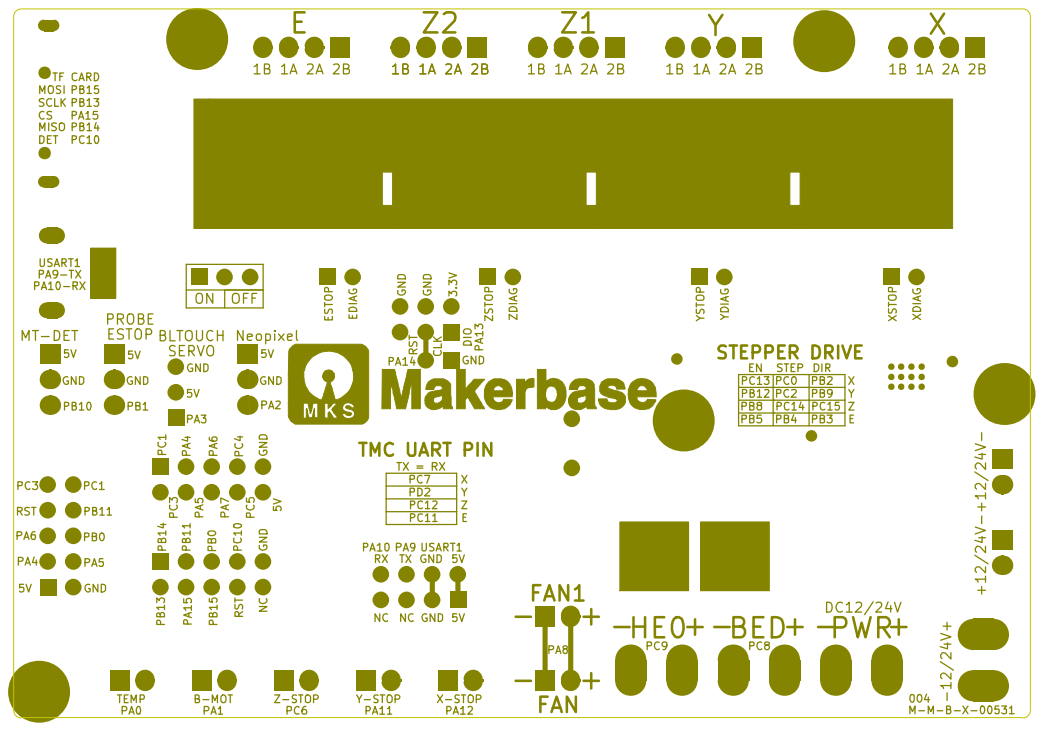
[picture p31: page 1]
