makerbase-mks/MKS-Robin-E3-E3D/hardware/MKS Robin E3 V1.1_004/MKS Robin E3 V1.1_004 TOP.pdf

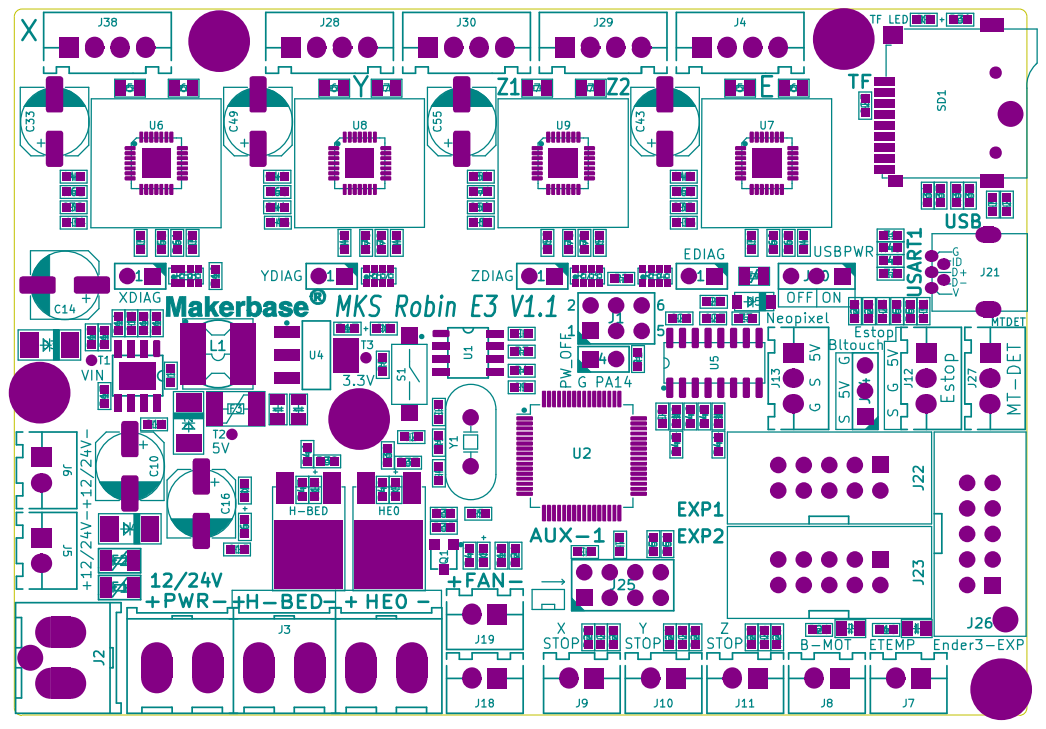
[picture p34: page 1]
