makerbase-mks/MKS-Robin-E3-E3D/hardware/MKS Robin E3D V1.1_003/MKS Robin E3D V1.1_003 BOTTOM.pdf

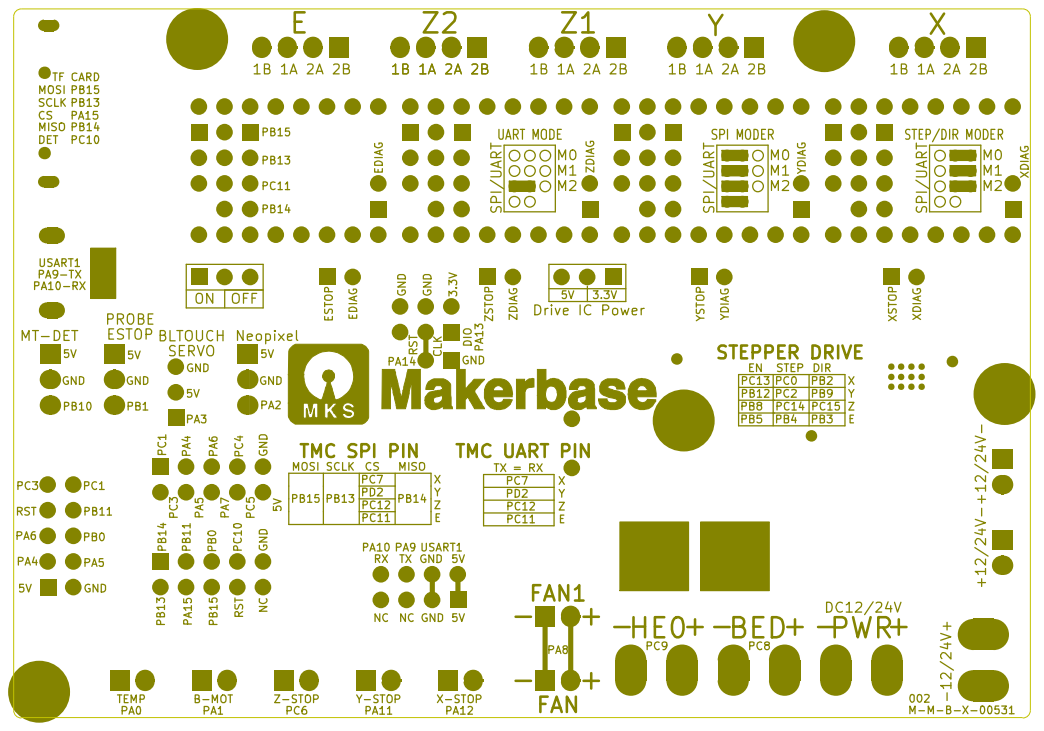
[picture p36: page 1]
