makerbase-mks/MKS-Robin-E3-E3D/hardware/MKS Robin E3D V1.1_003/MKS Robin E3D V1.1_003 SCH.pdf

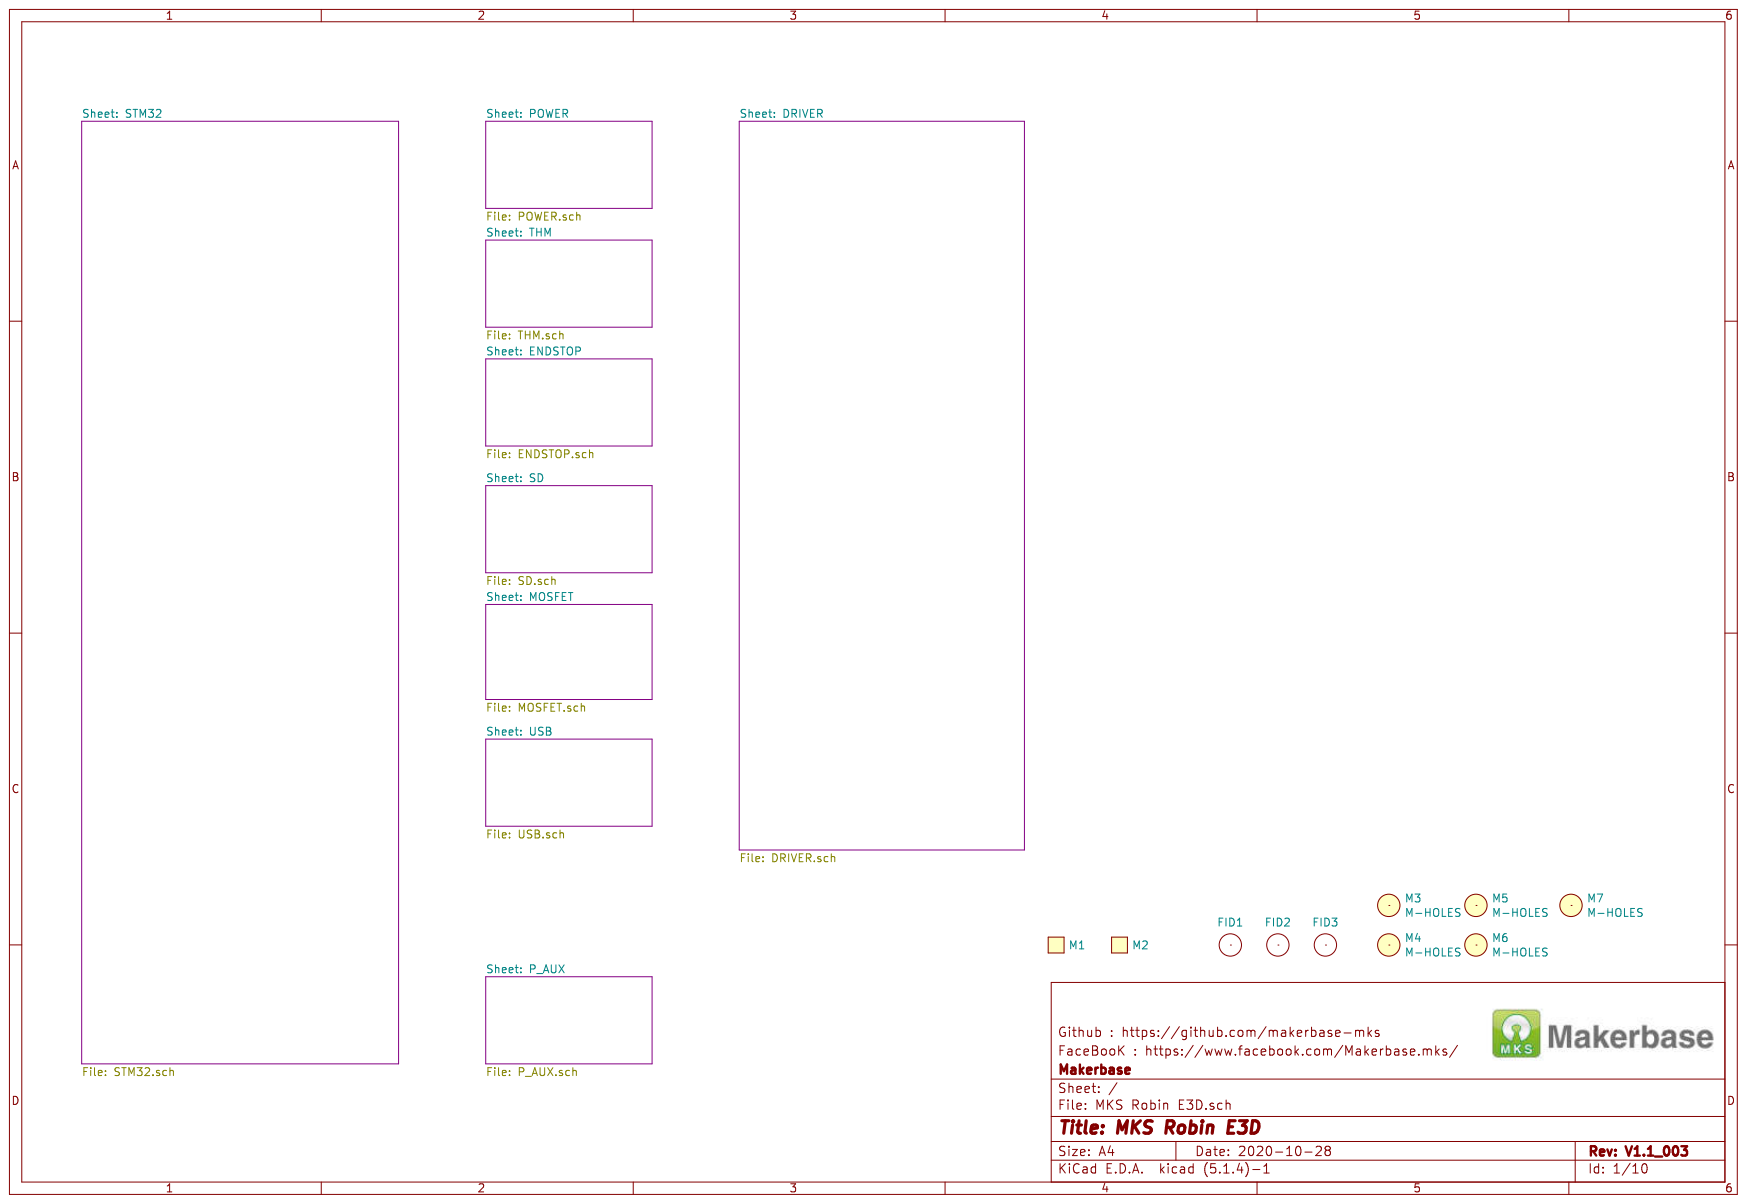
[picture p37: page 1]

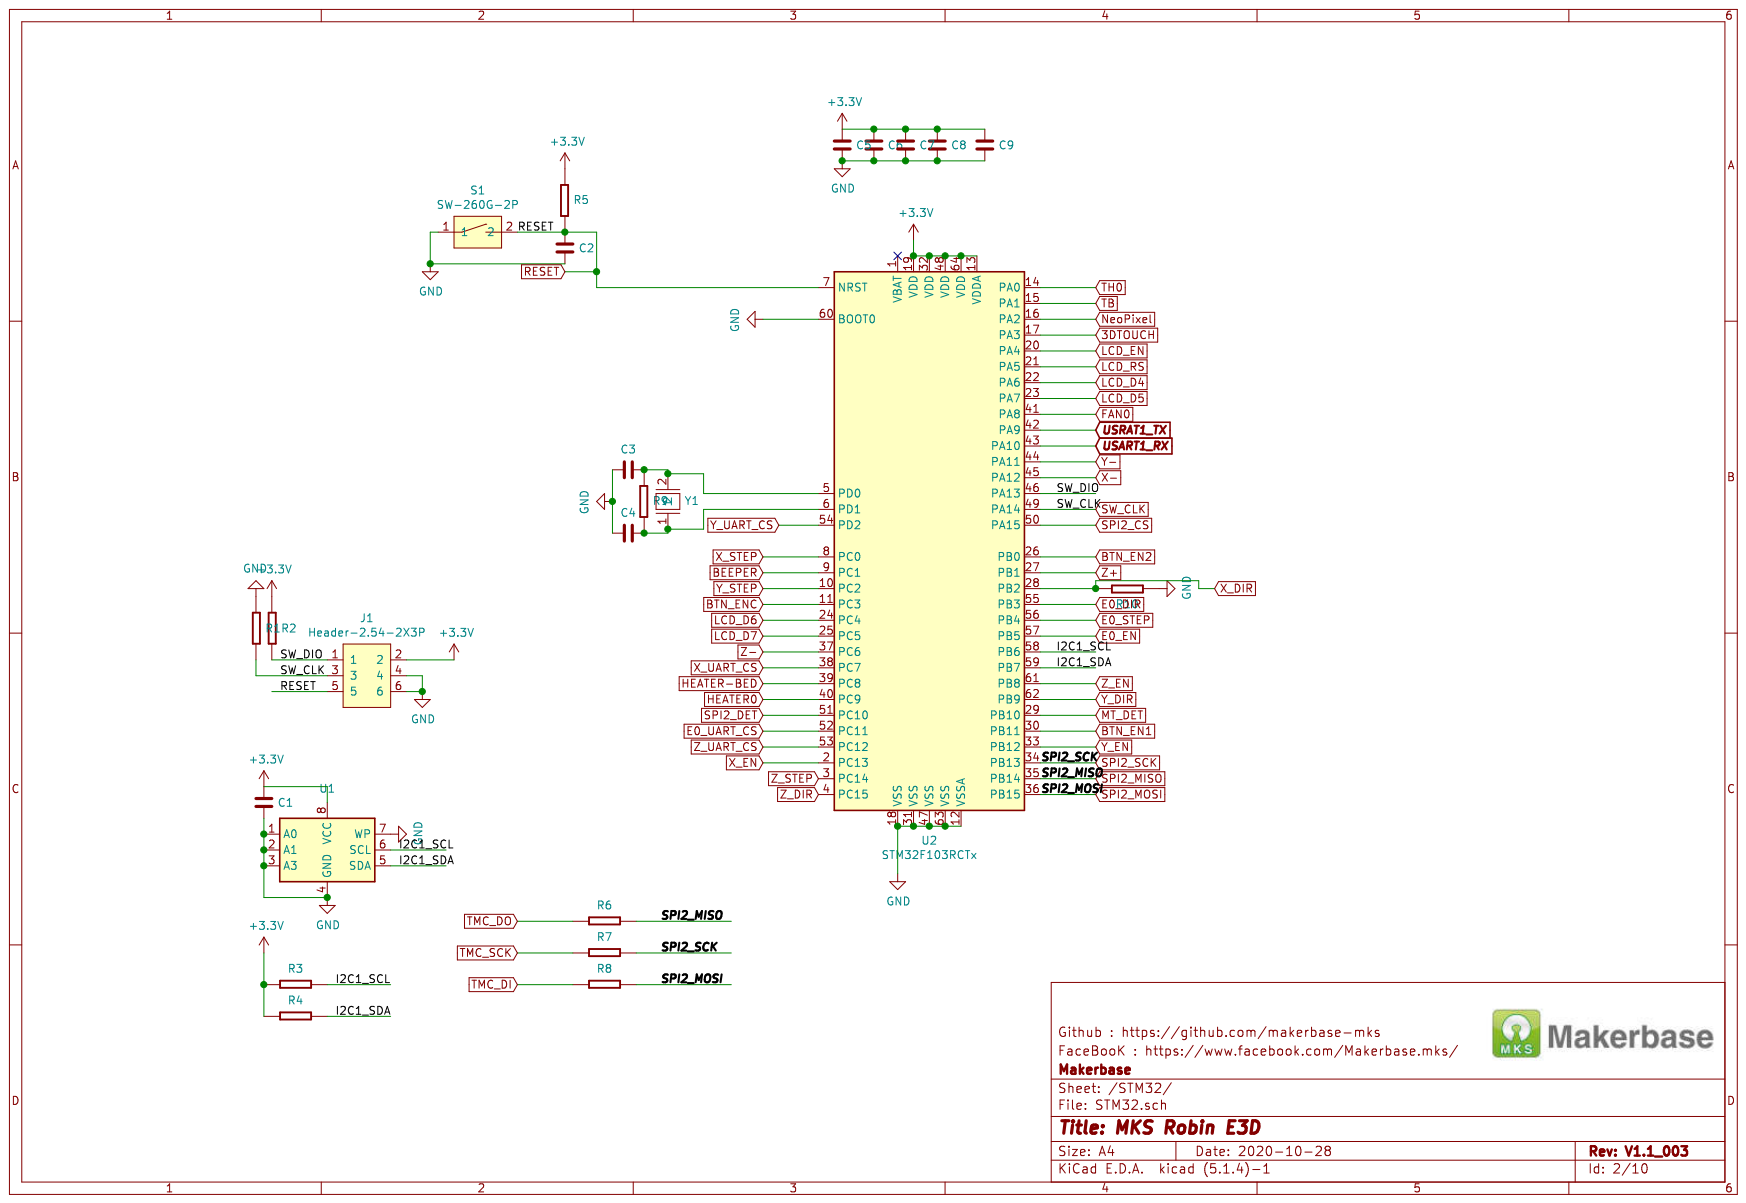
[picture p38: page 2]

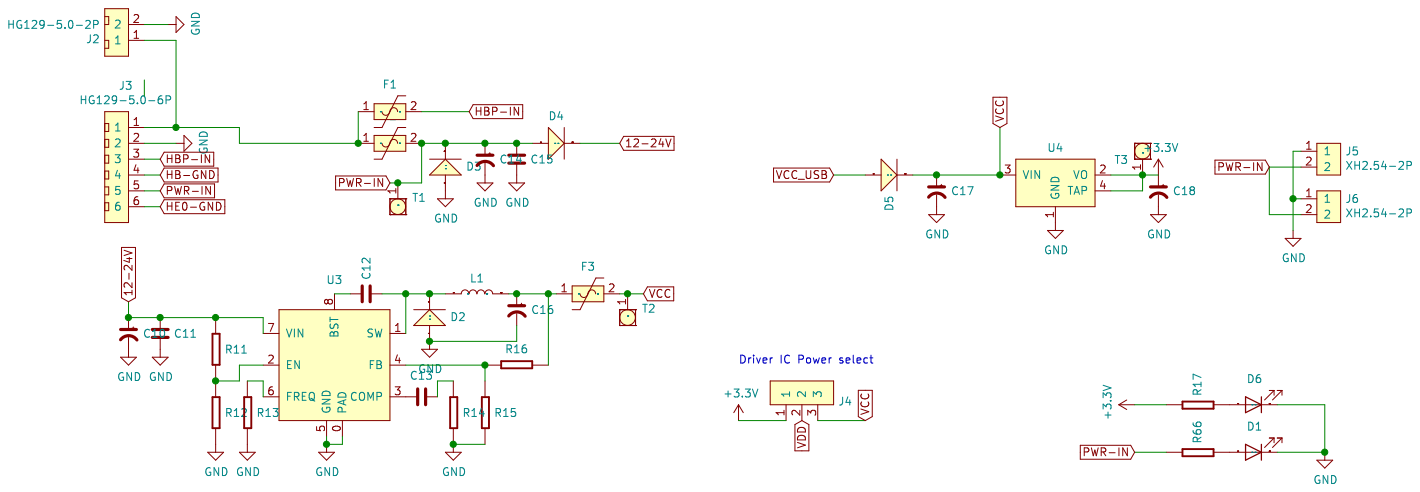
[picture p39: page 3]

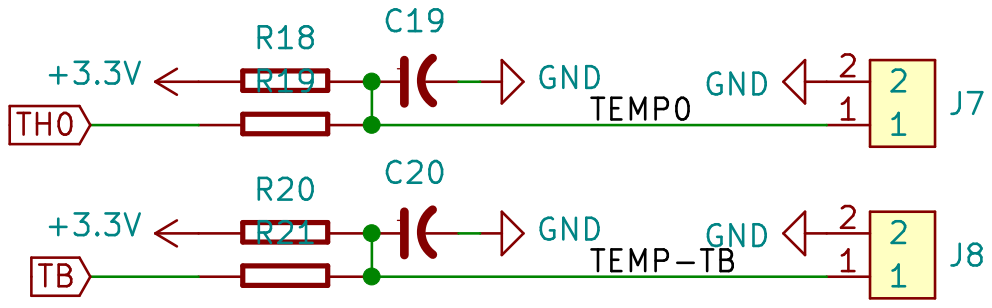
[picture p40: page 4]

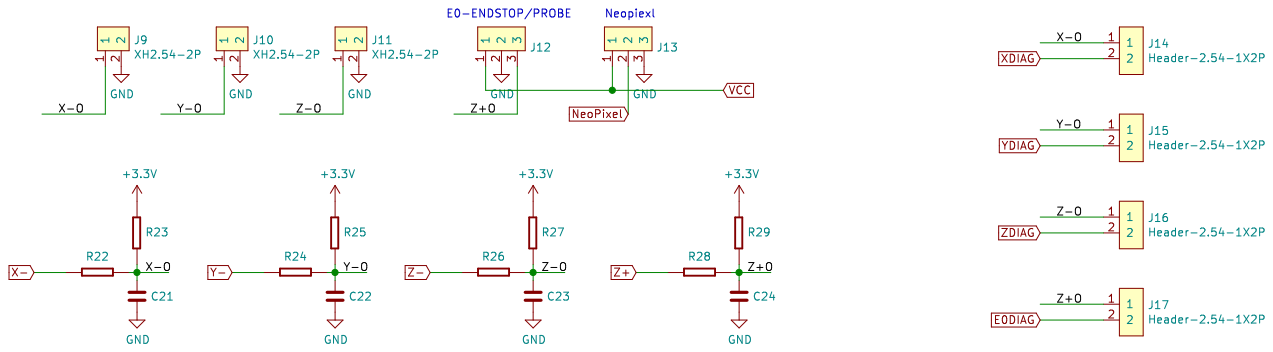
[picture p41: page 5]

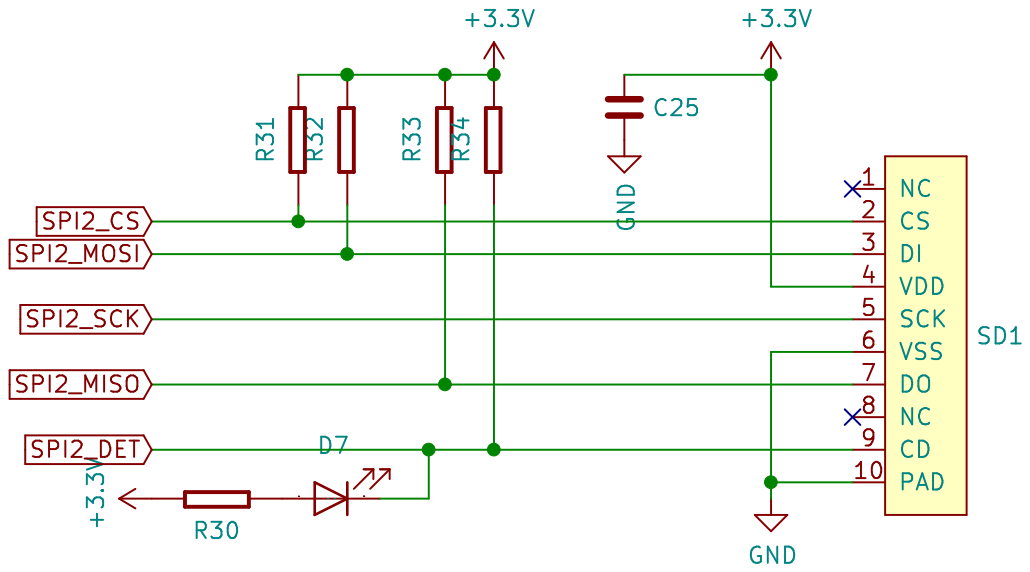
[picture p42: page 6]

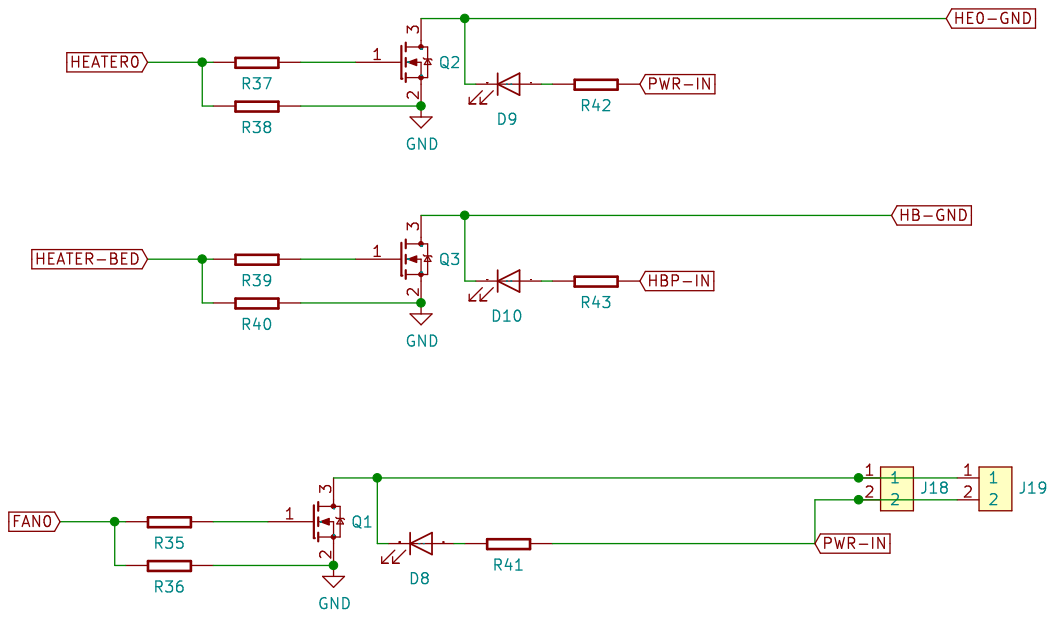
[picture p43: page 7]

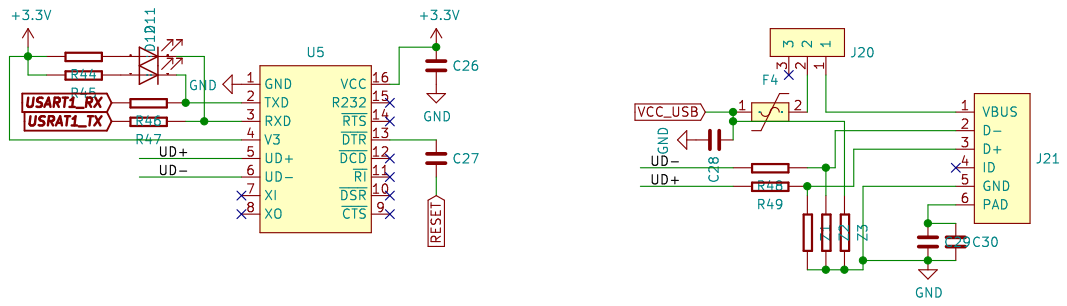
[picture p44: page 8]

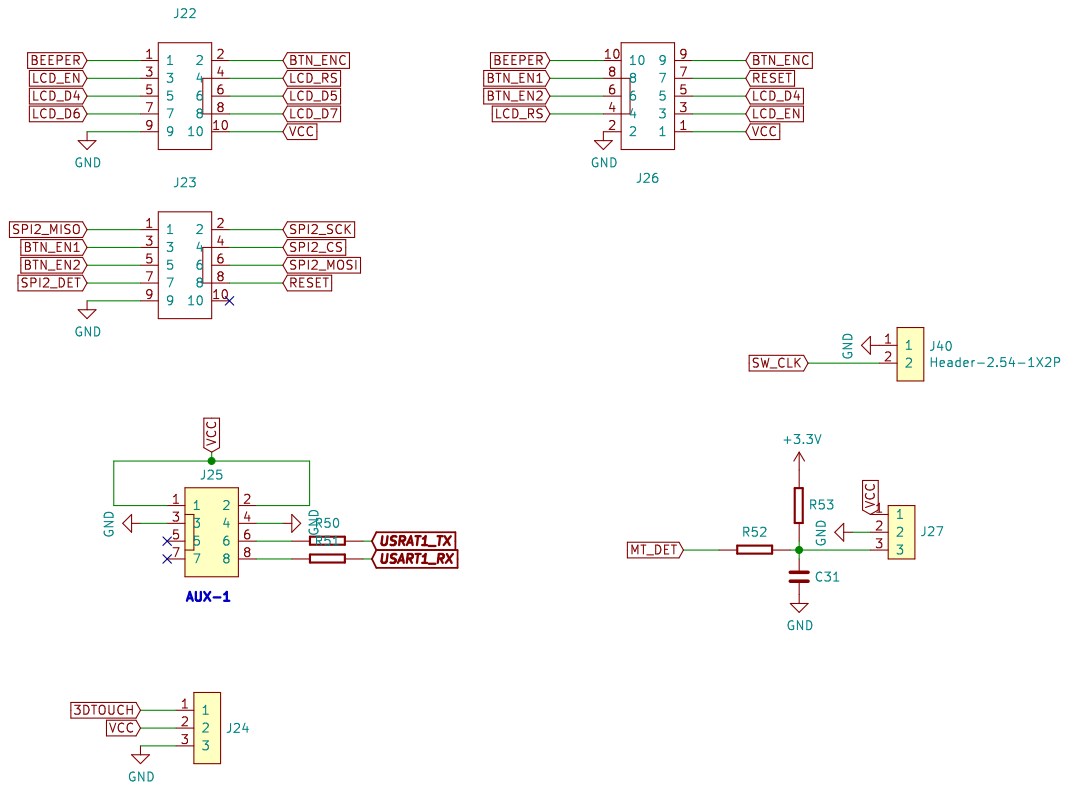
[picture p45: page 9]

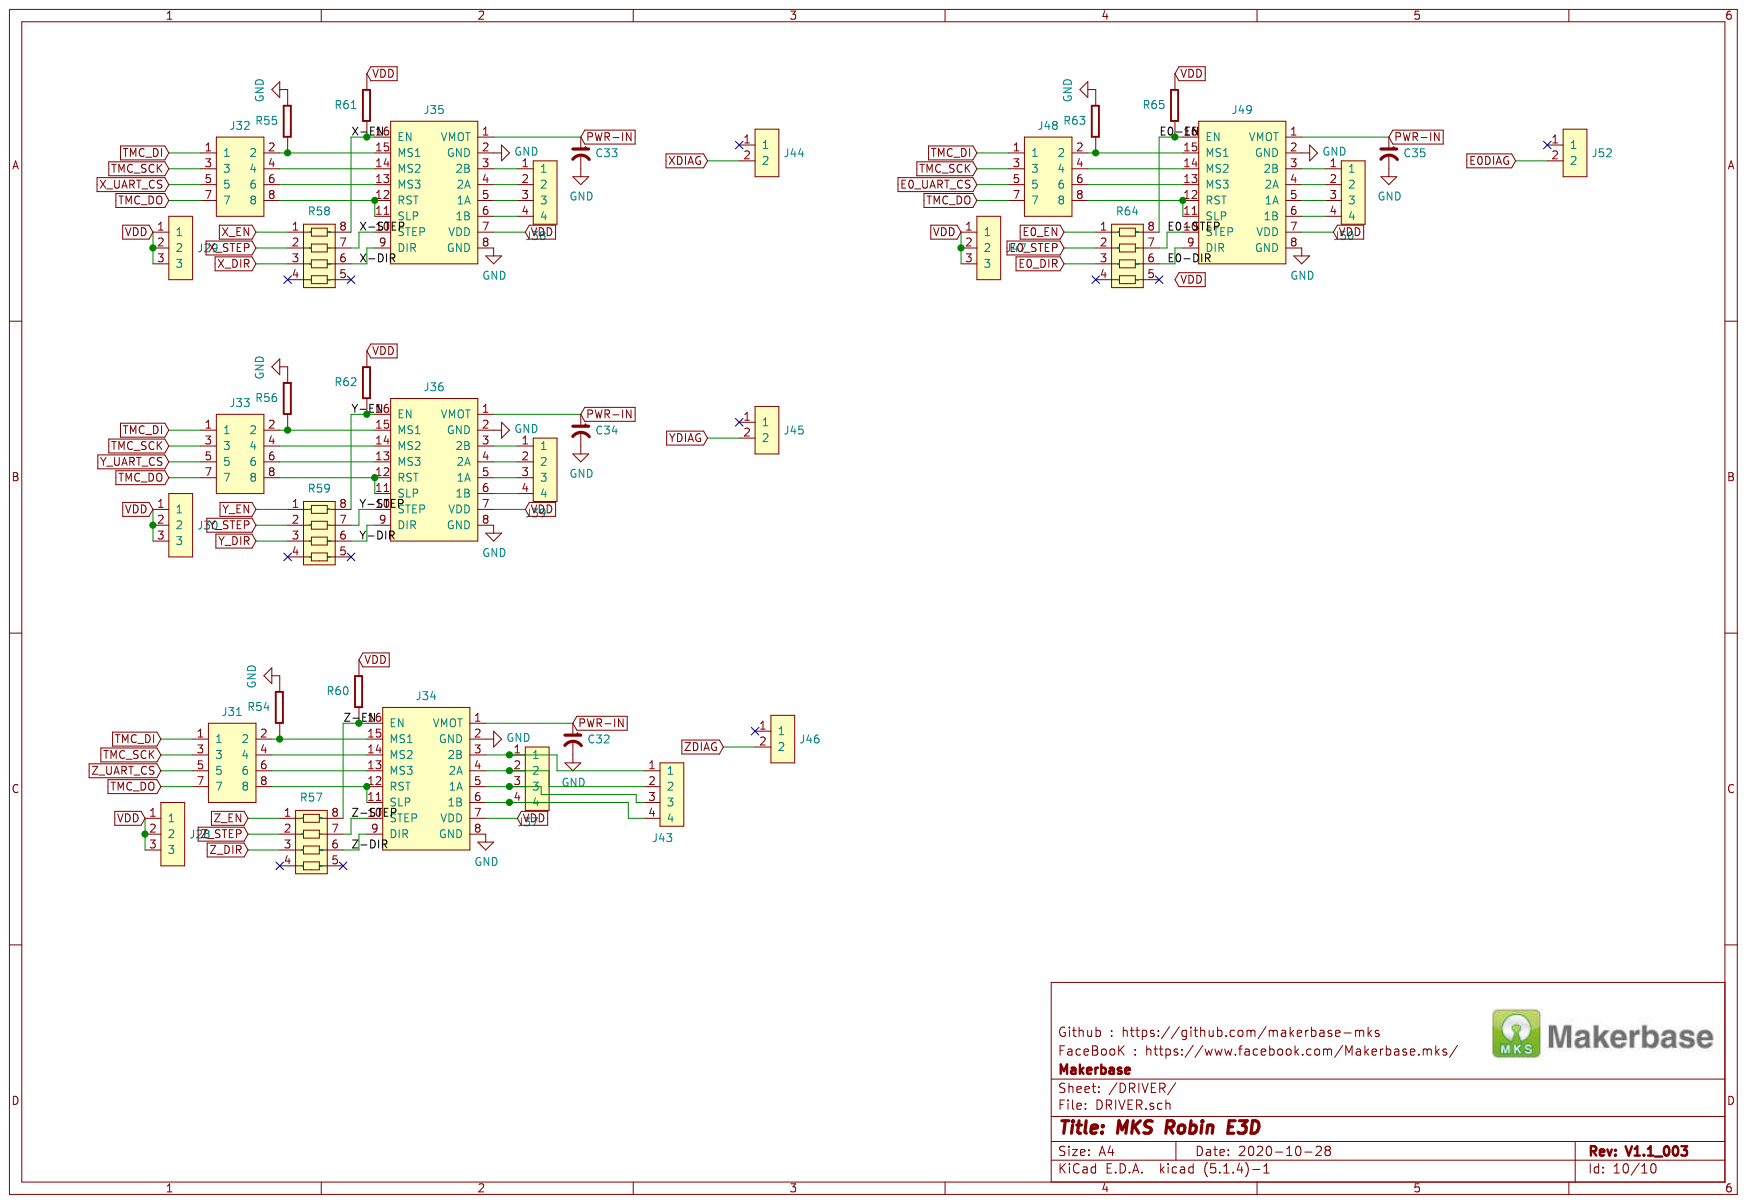
[picture p46: page 10]
