makerbase-mks/MKS-Robin-E3-E3D/hardware/MKS Robin E3D V1.1_003/MKS Robin E3D V1.1_003 SIZE.pdf

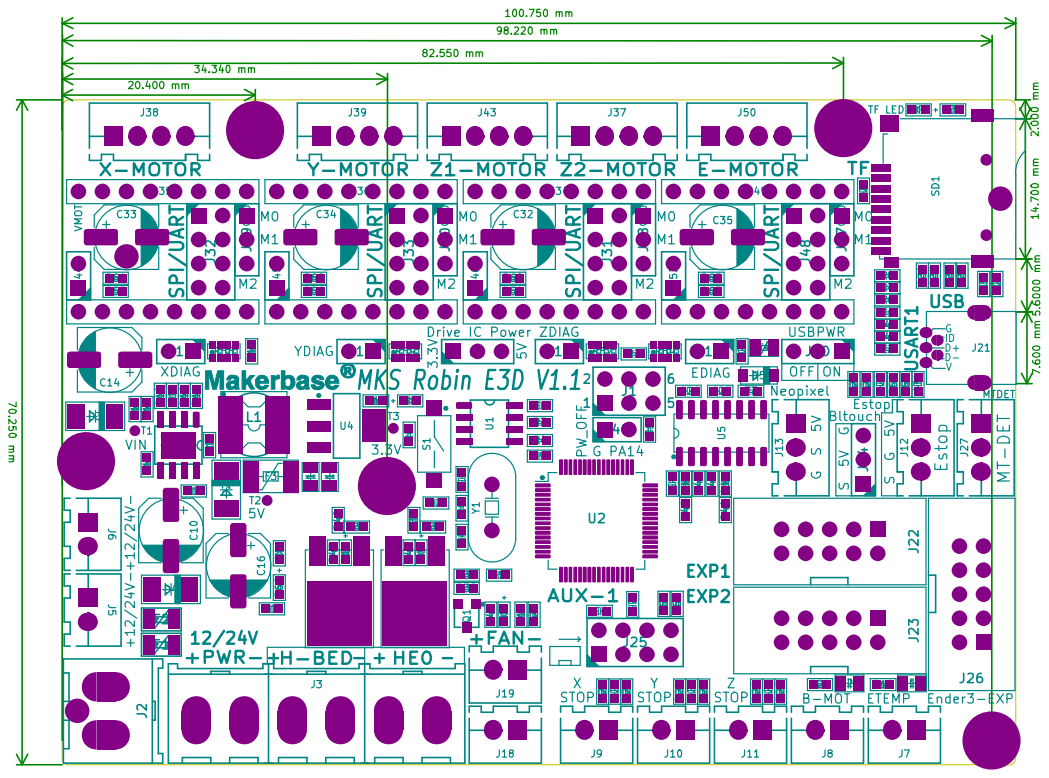
[picture p47: page 1]
