makerbase-mks/MKS-Robin-E3-E3D/hardware/MKS Robin E3D V1.0_003/MKS Robin E3D V1.0_003 SCH.pdf

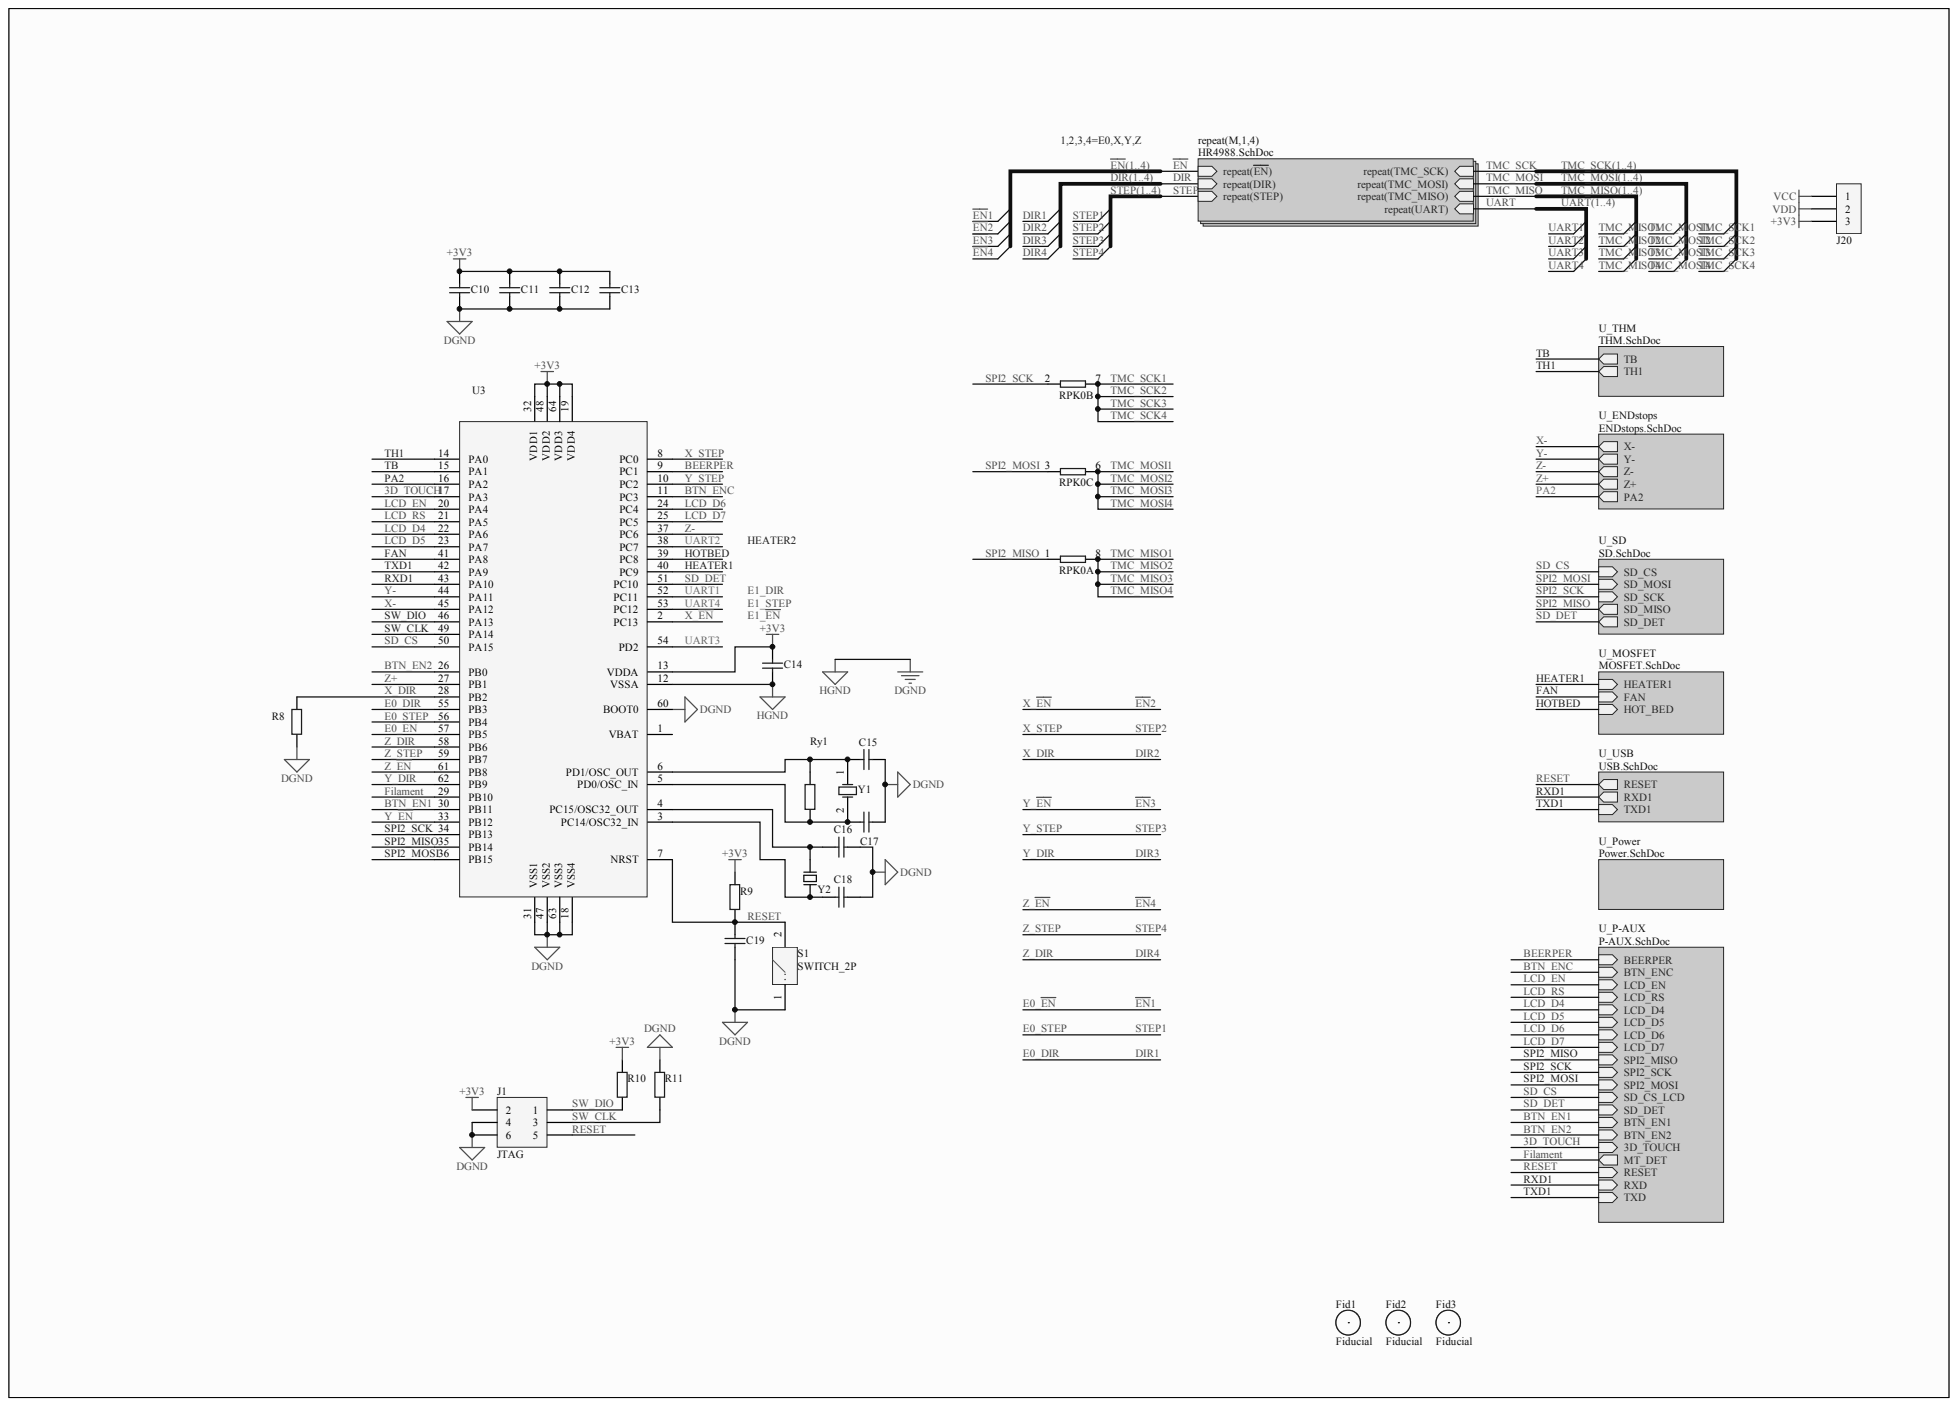
[picture p51: page 1]

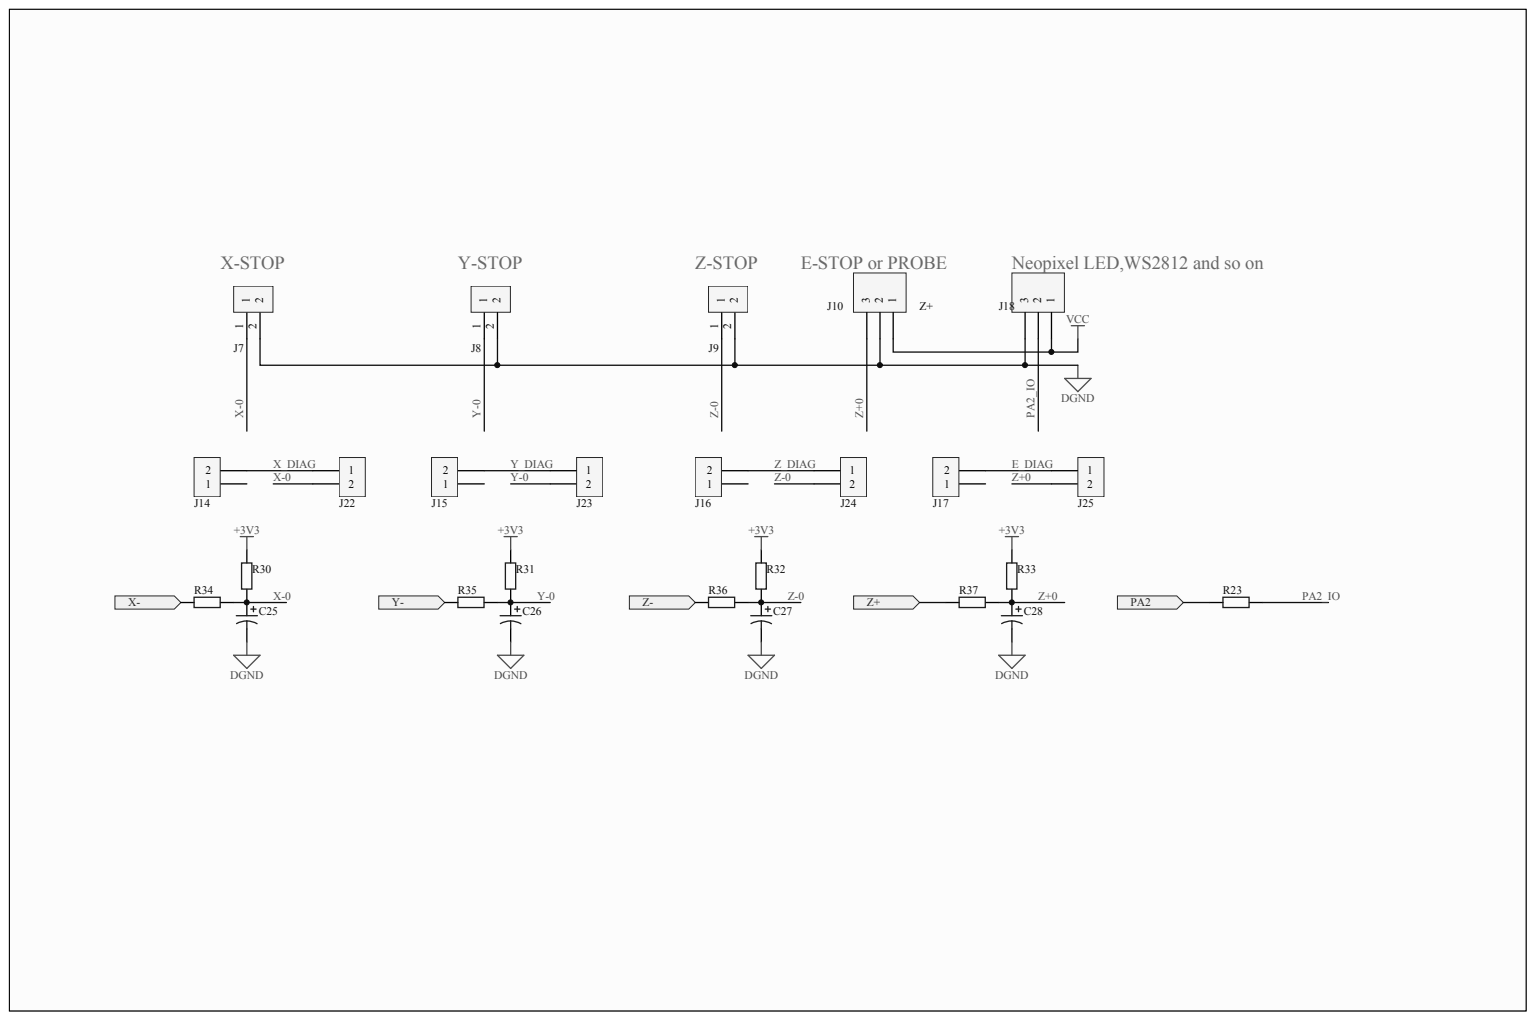
[picture p52: page 2]

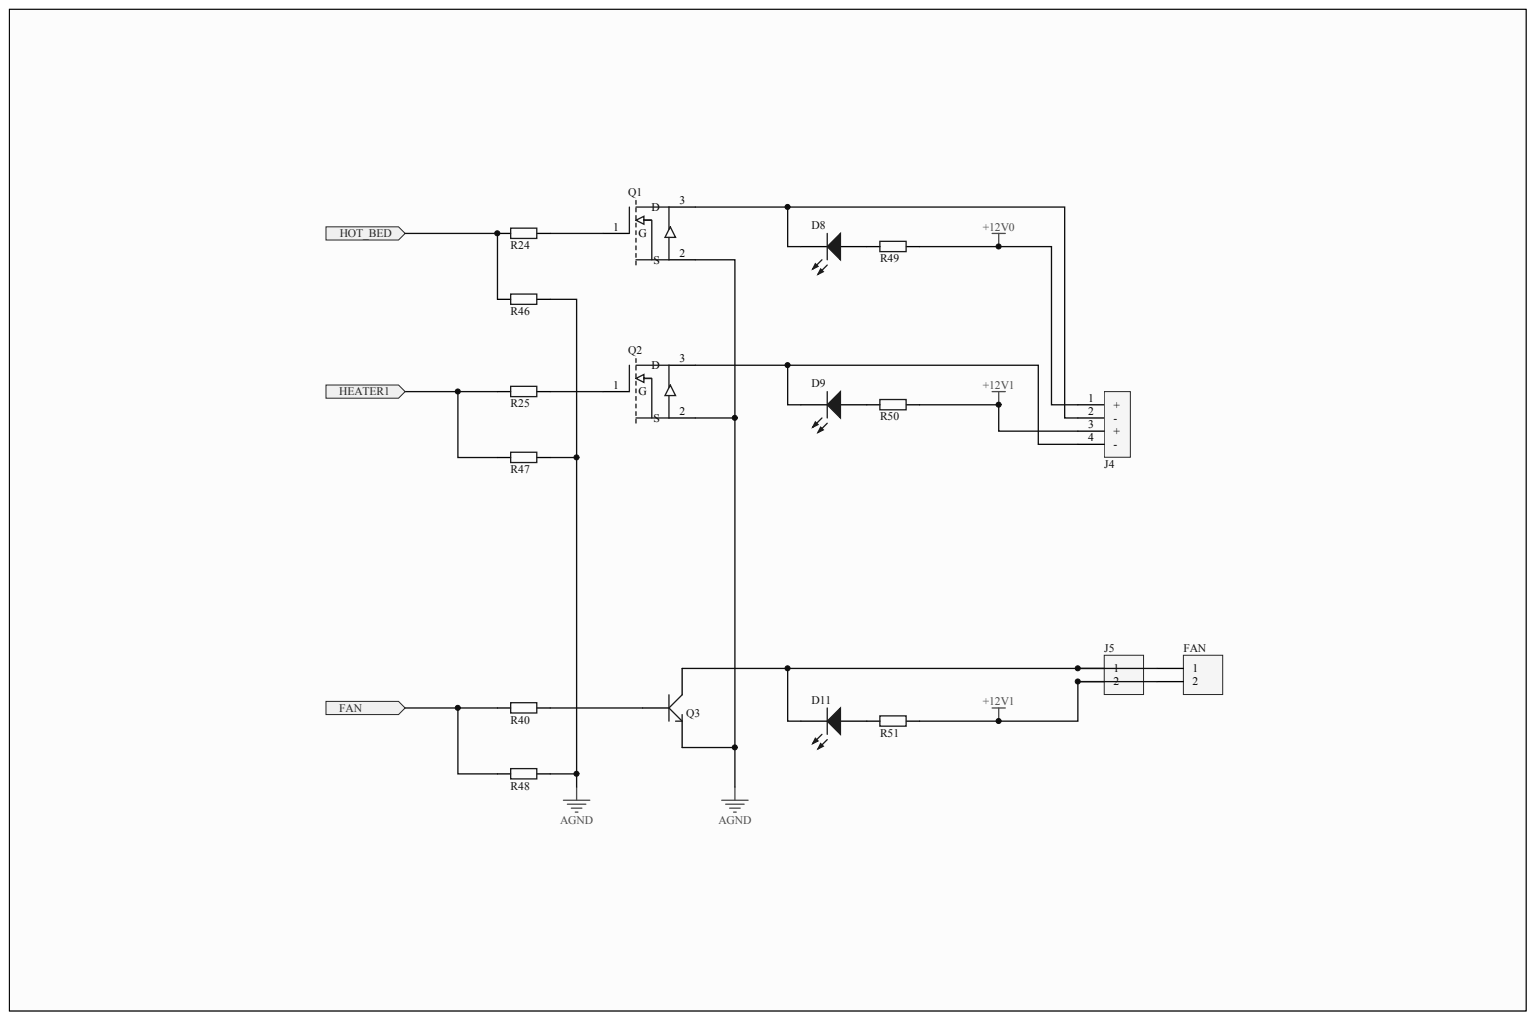
[picture p53: page 3]

- 2
+ 3

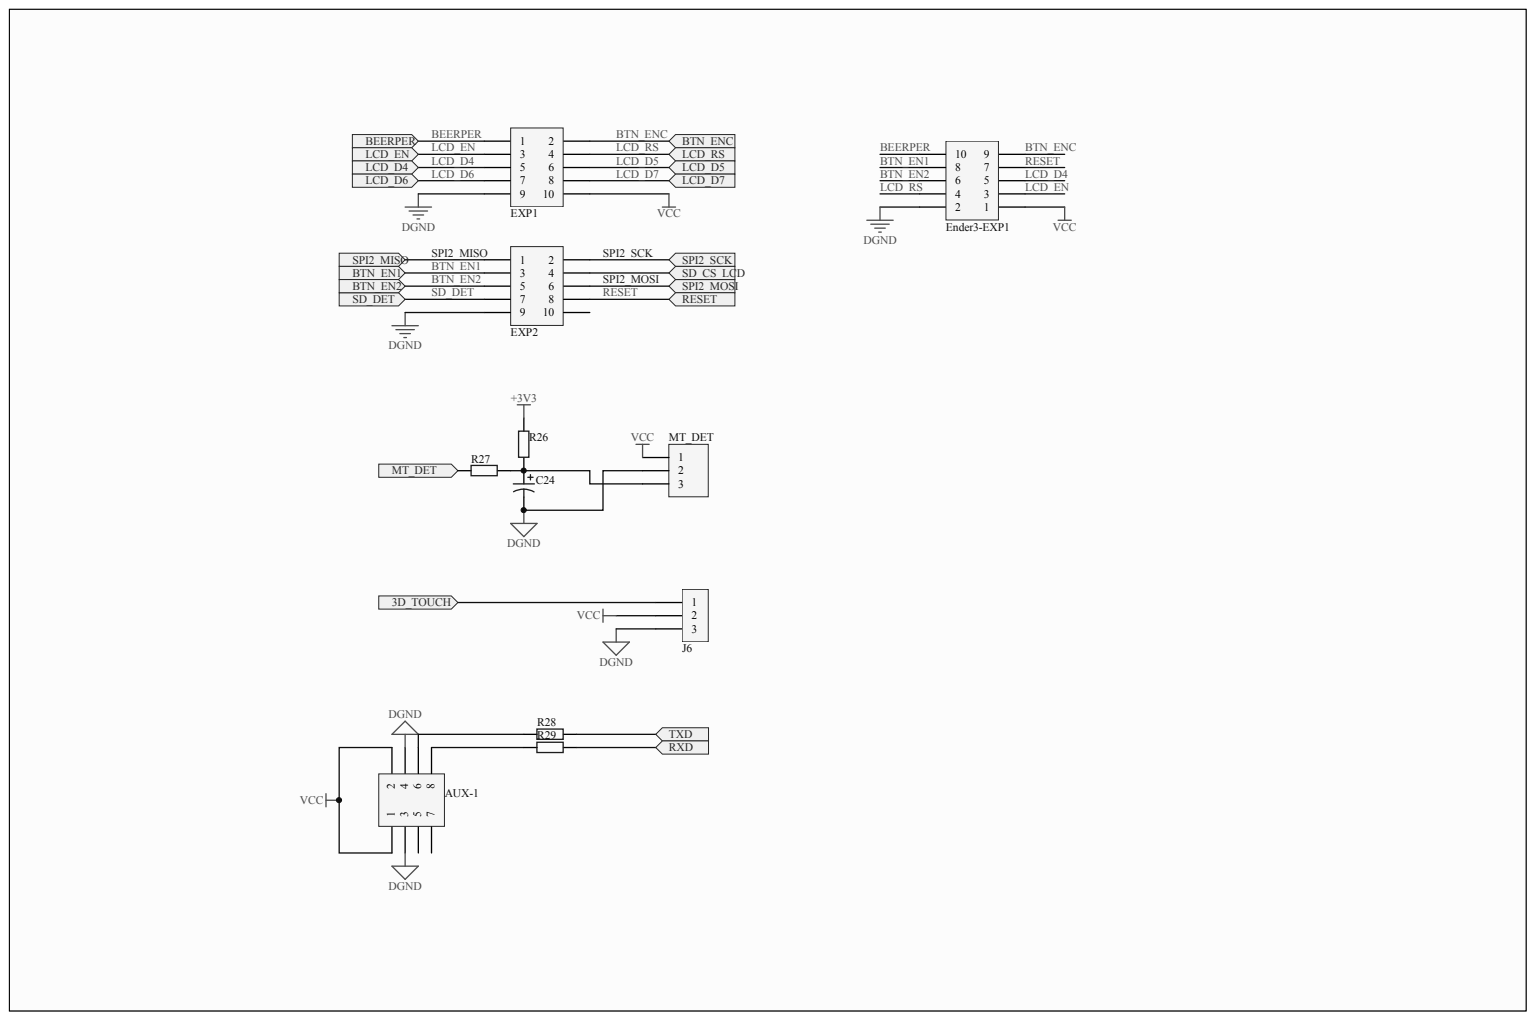
[picture p54: page 4]

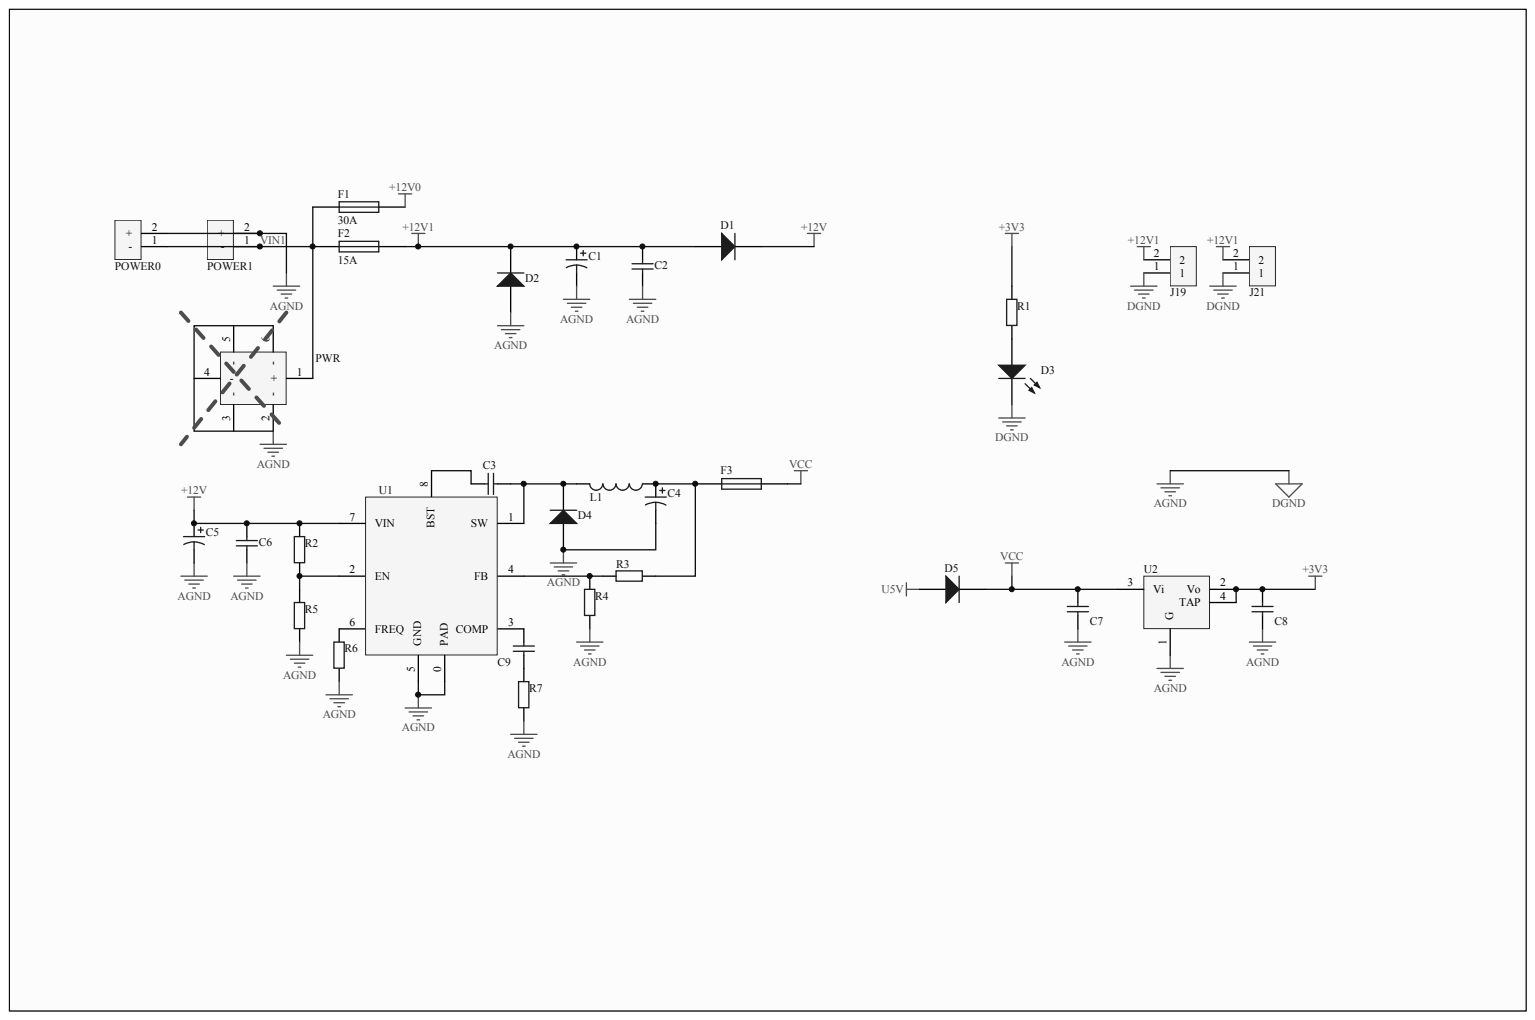
[picture p55: page 5]

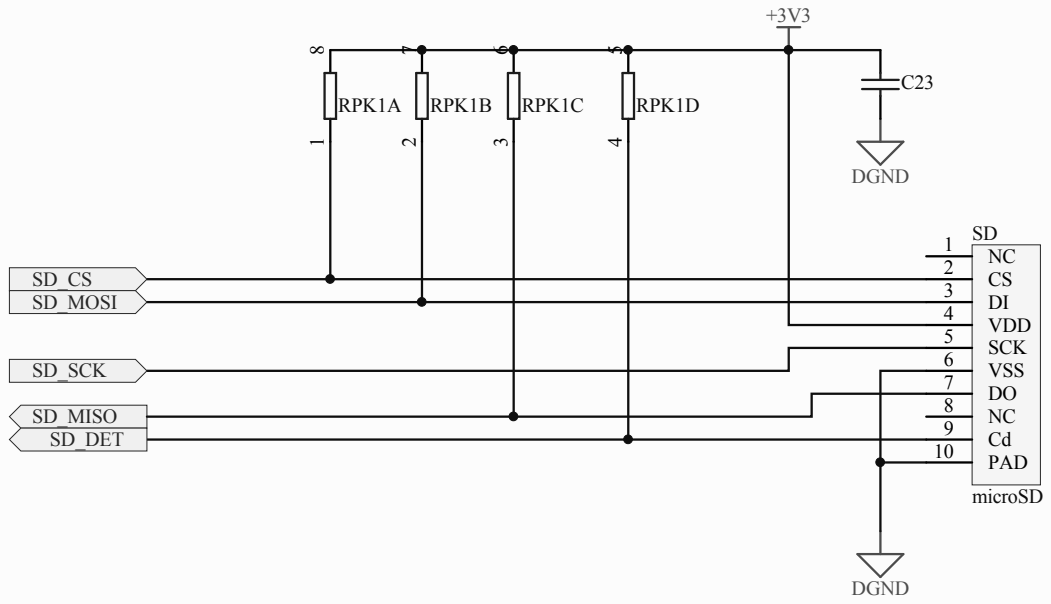
[picture p56: page 6]

DGND

DI 3
VDD 4

VSS 6
DO 7
NC 8
Cd 9
PAD 10

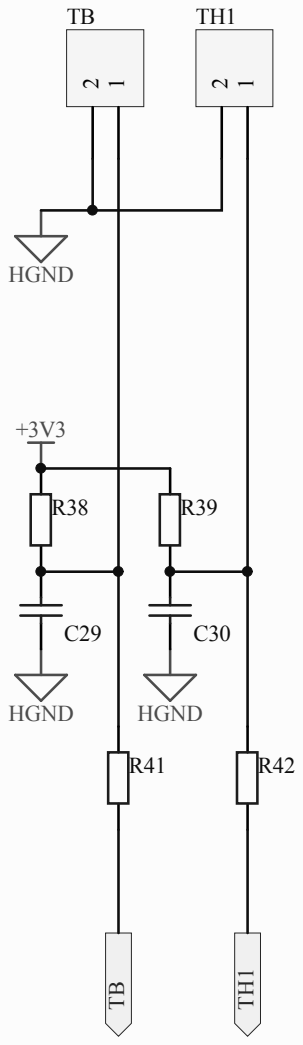
[picture p57: page 7]

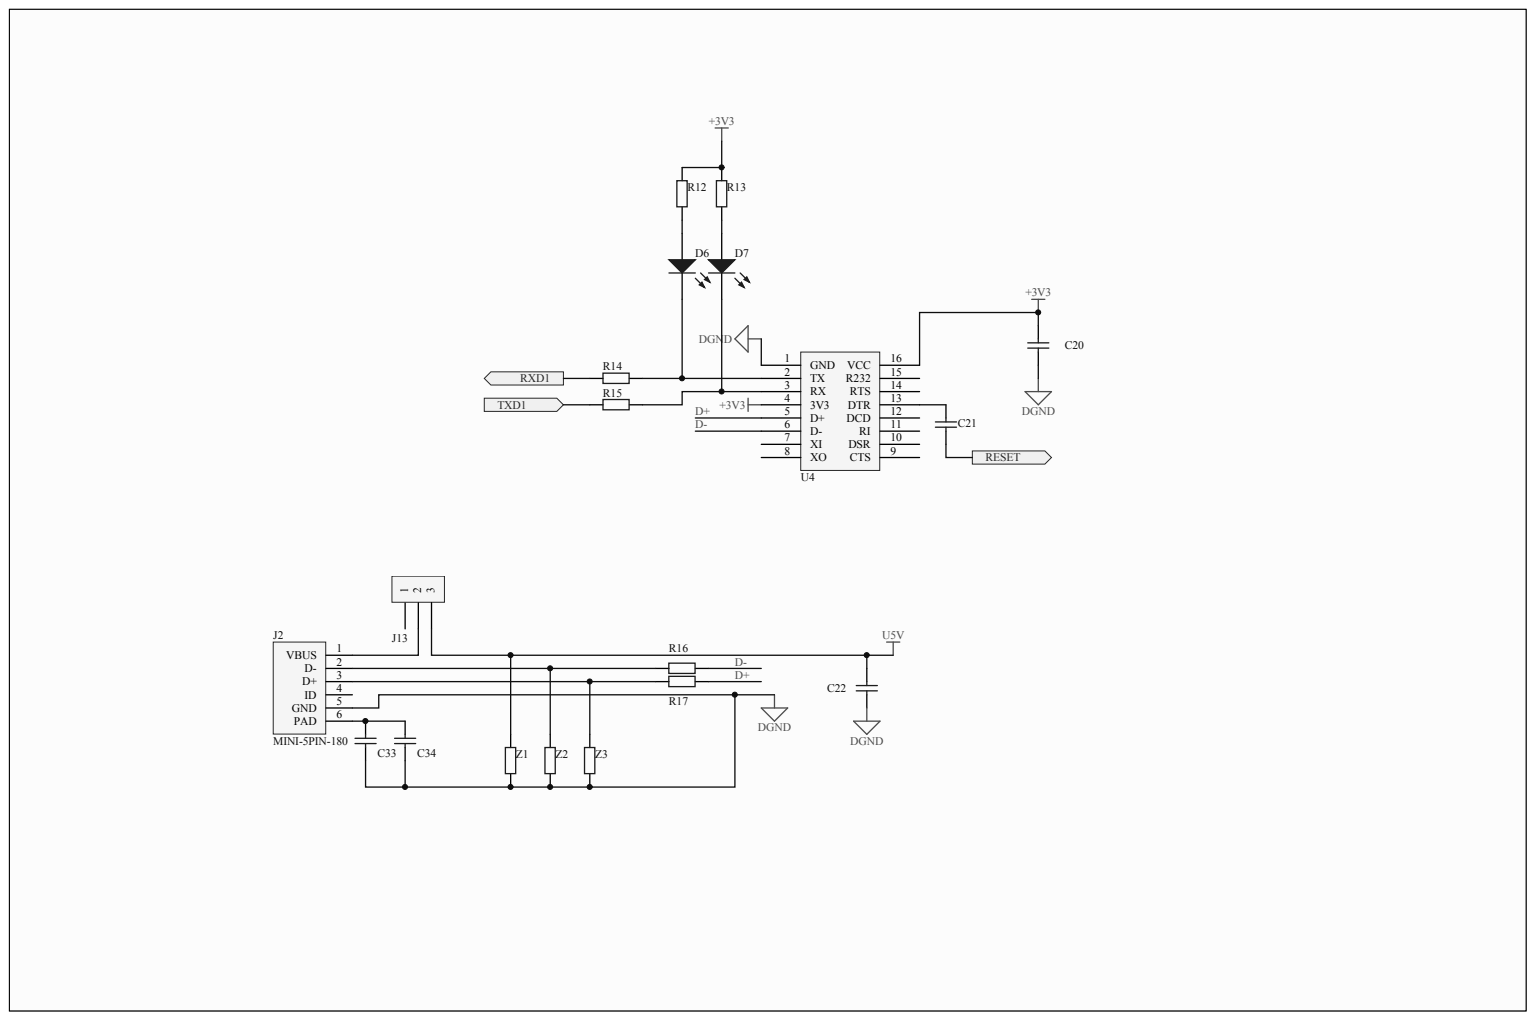
[picture p58: page 8]

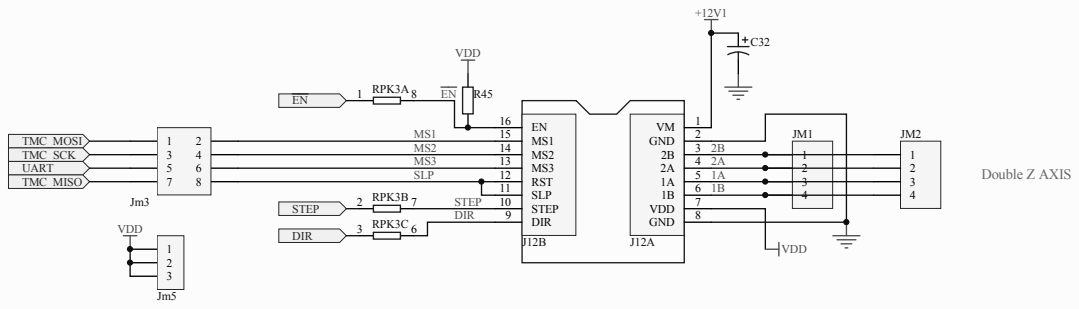
[picture p59: page 9]
