makerbase-mks/MKS-Robin-E3-E3D/hardware/MKS Robin E3D V1.0_003/MKS Robin E3D V1.0_003 SIZE.pdf

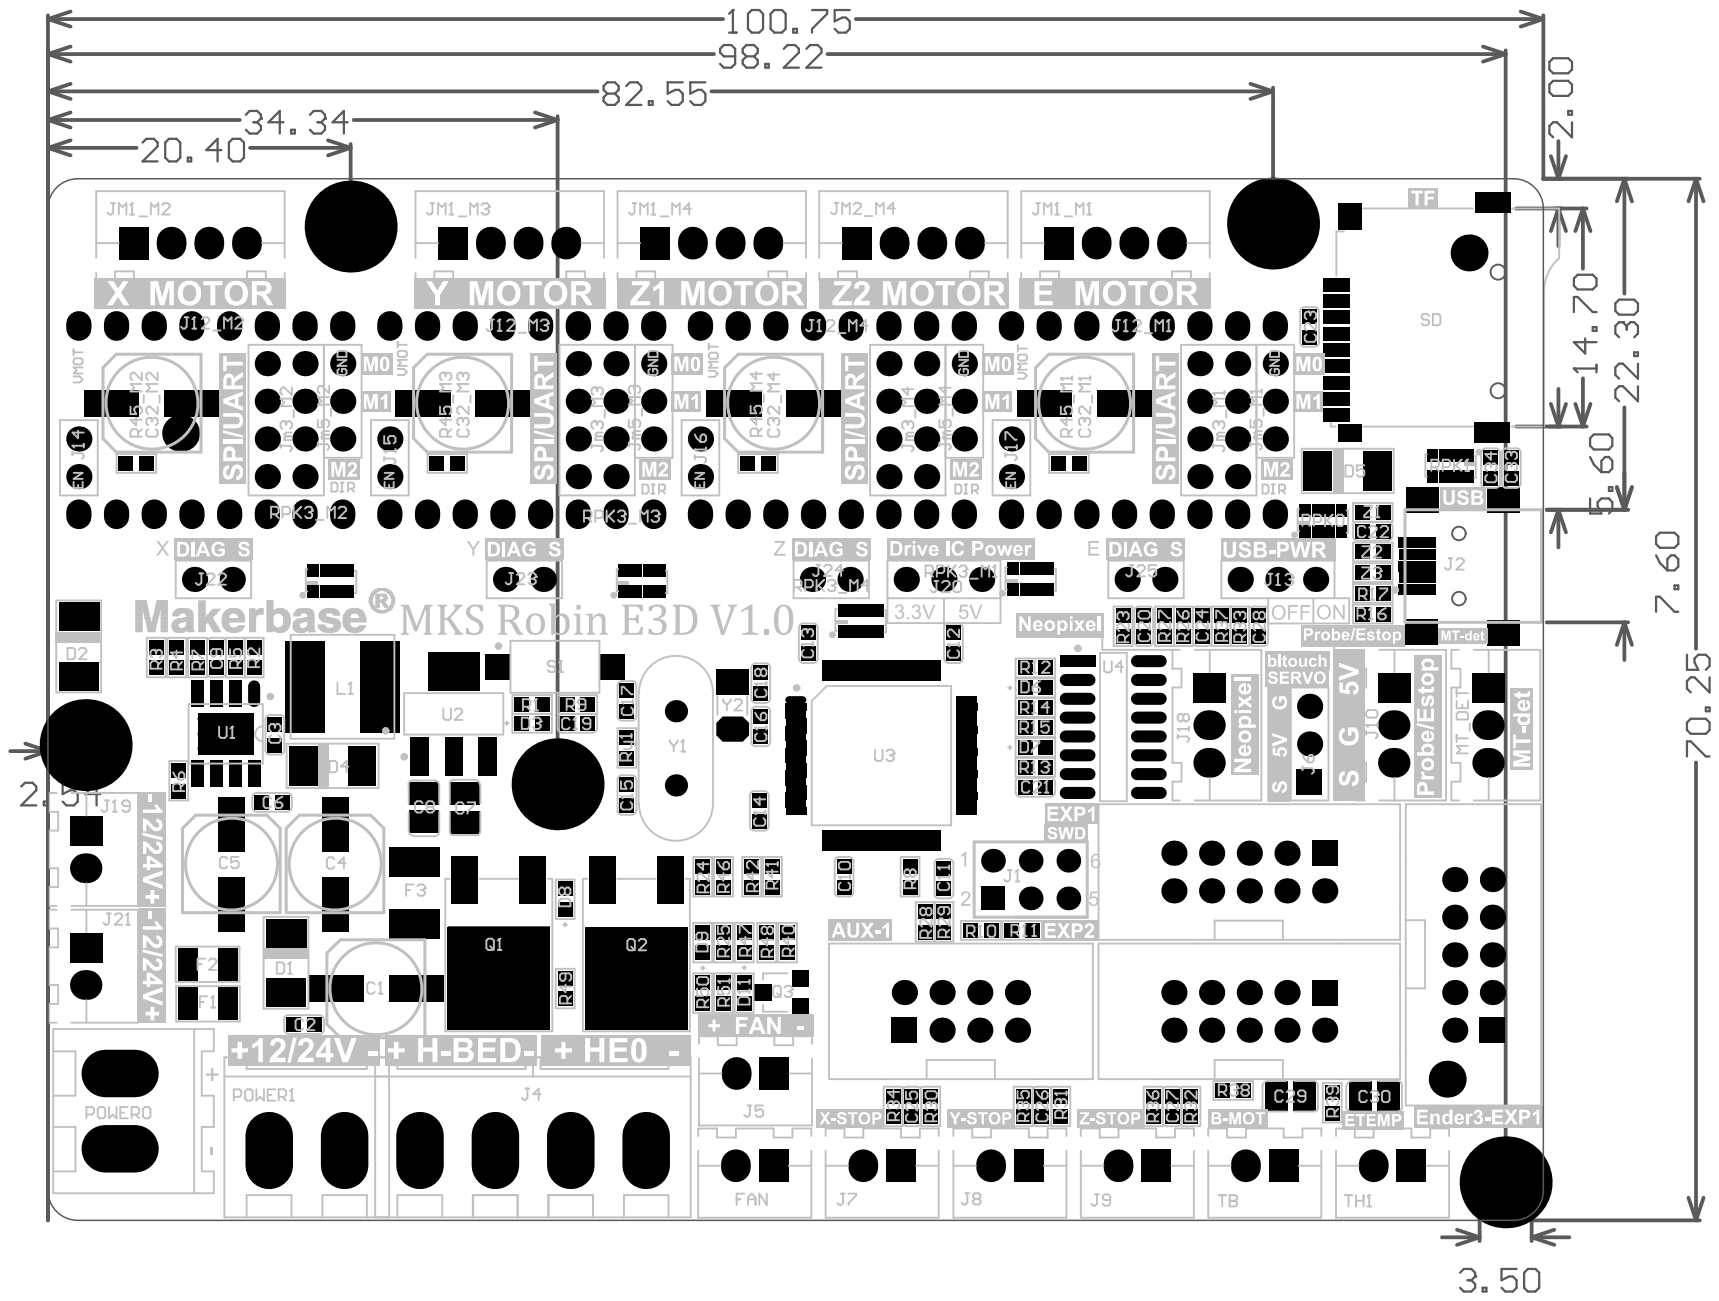
[picture p60: page 1]
