makerbase-mks/MKS-Robin-E3-E3D/hardware/MKS Robin E3D V1.0_002/MKS Robin E3D V1.0_002 SCH.pdf

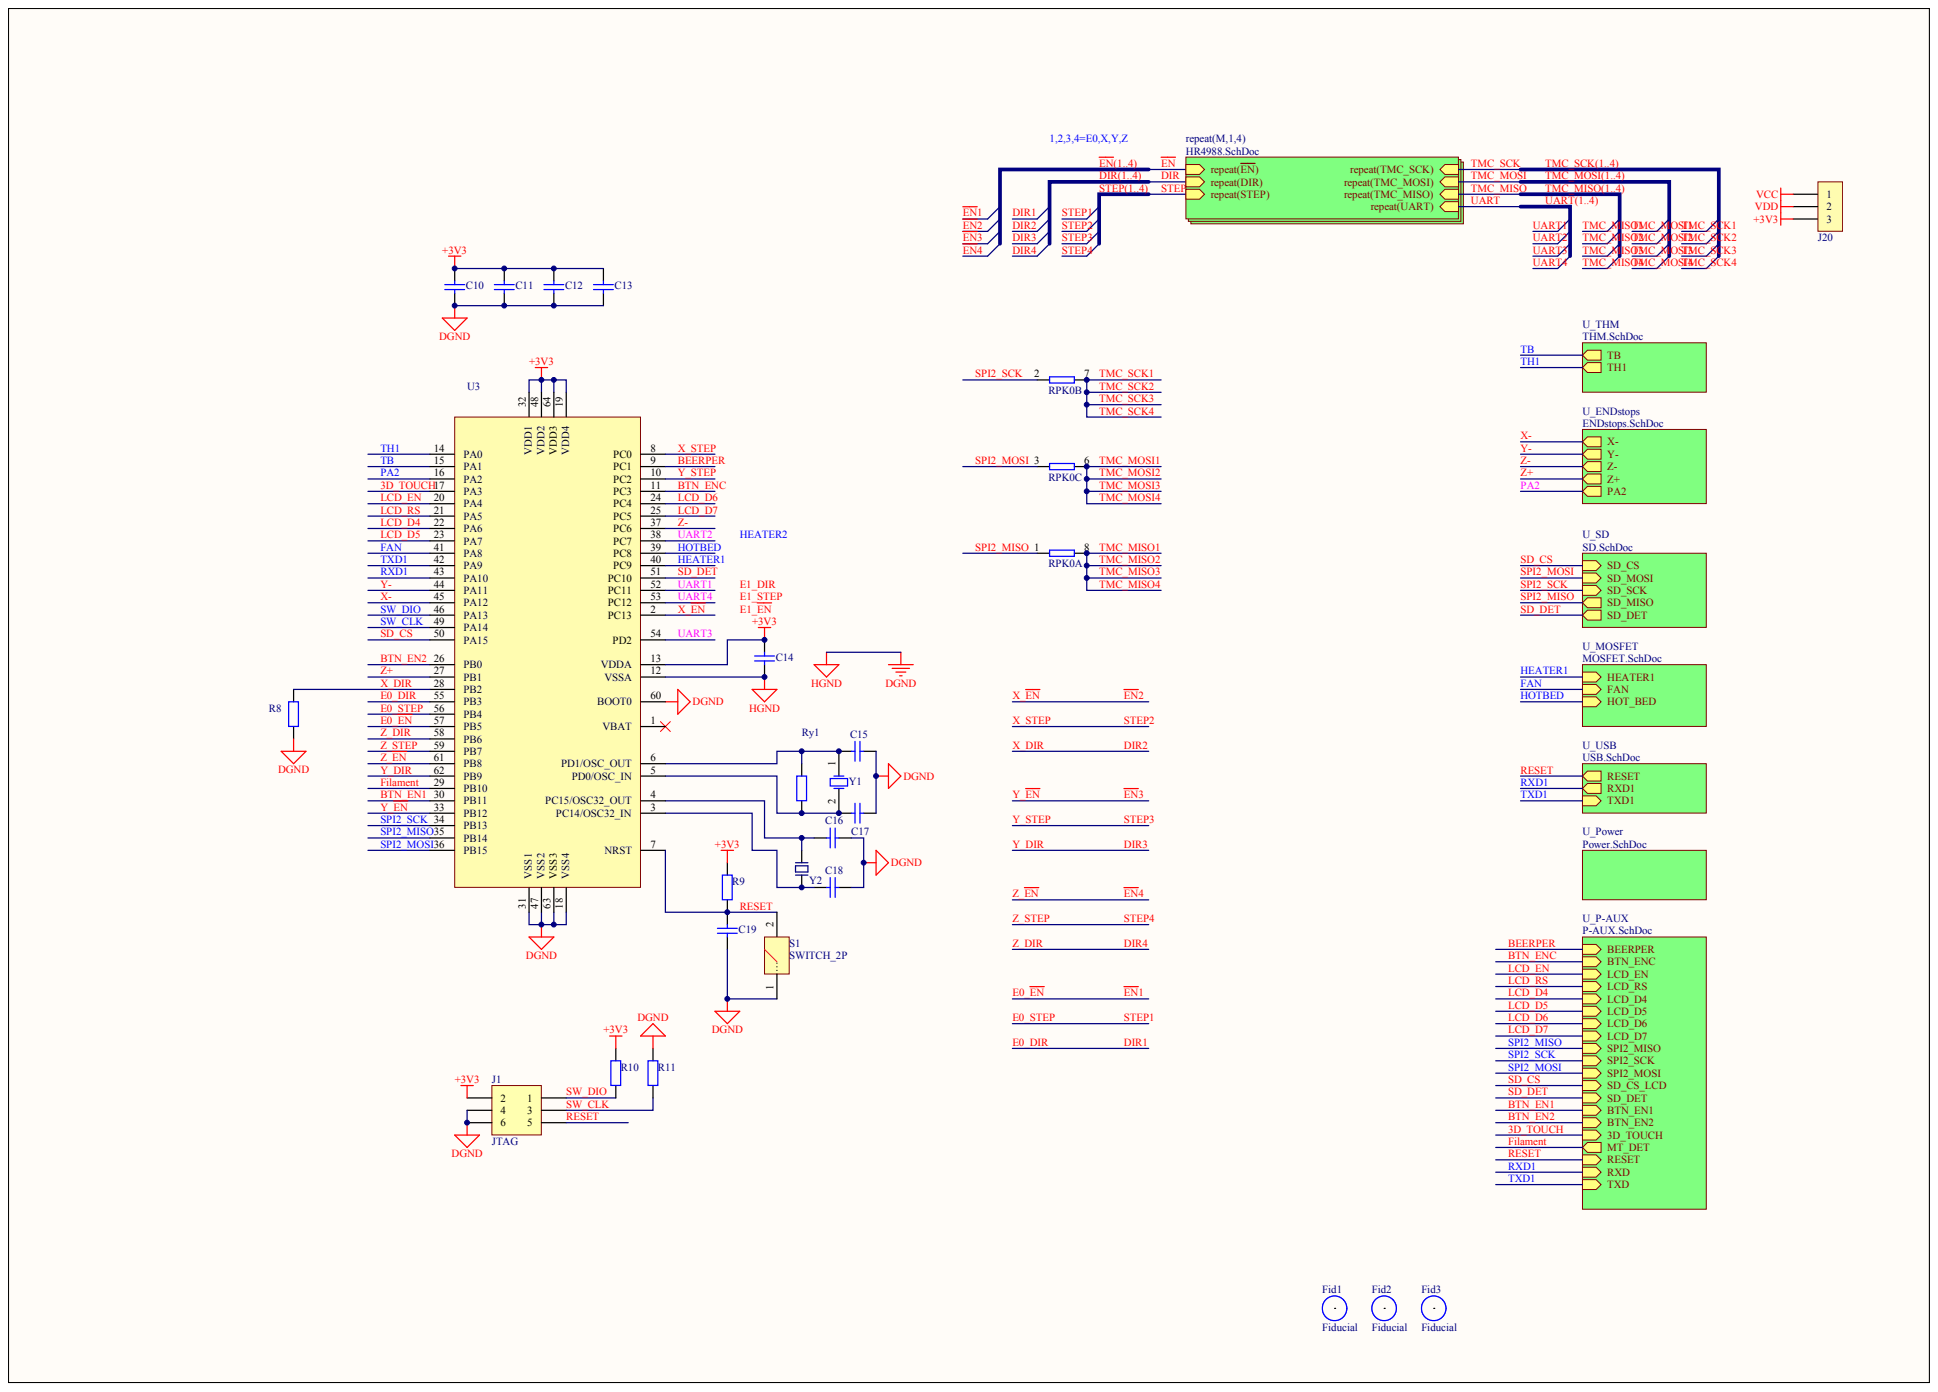
[picture p62: page 1]

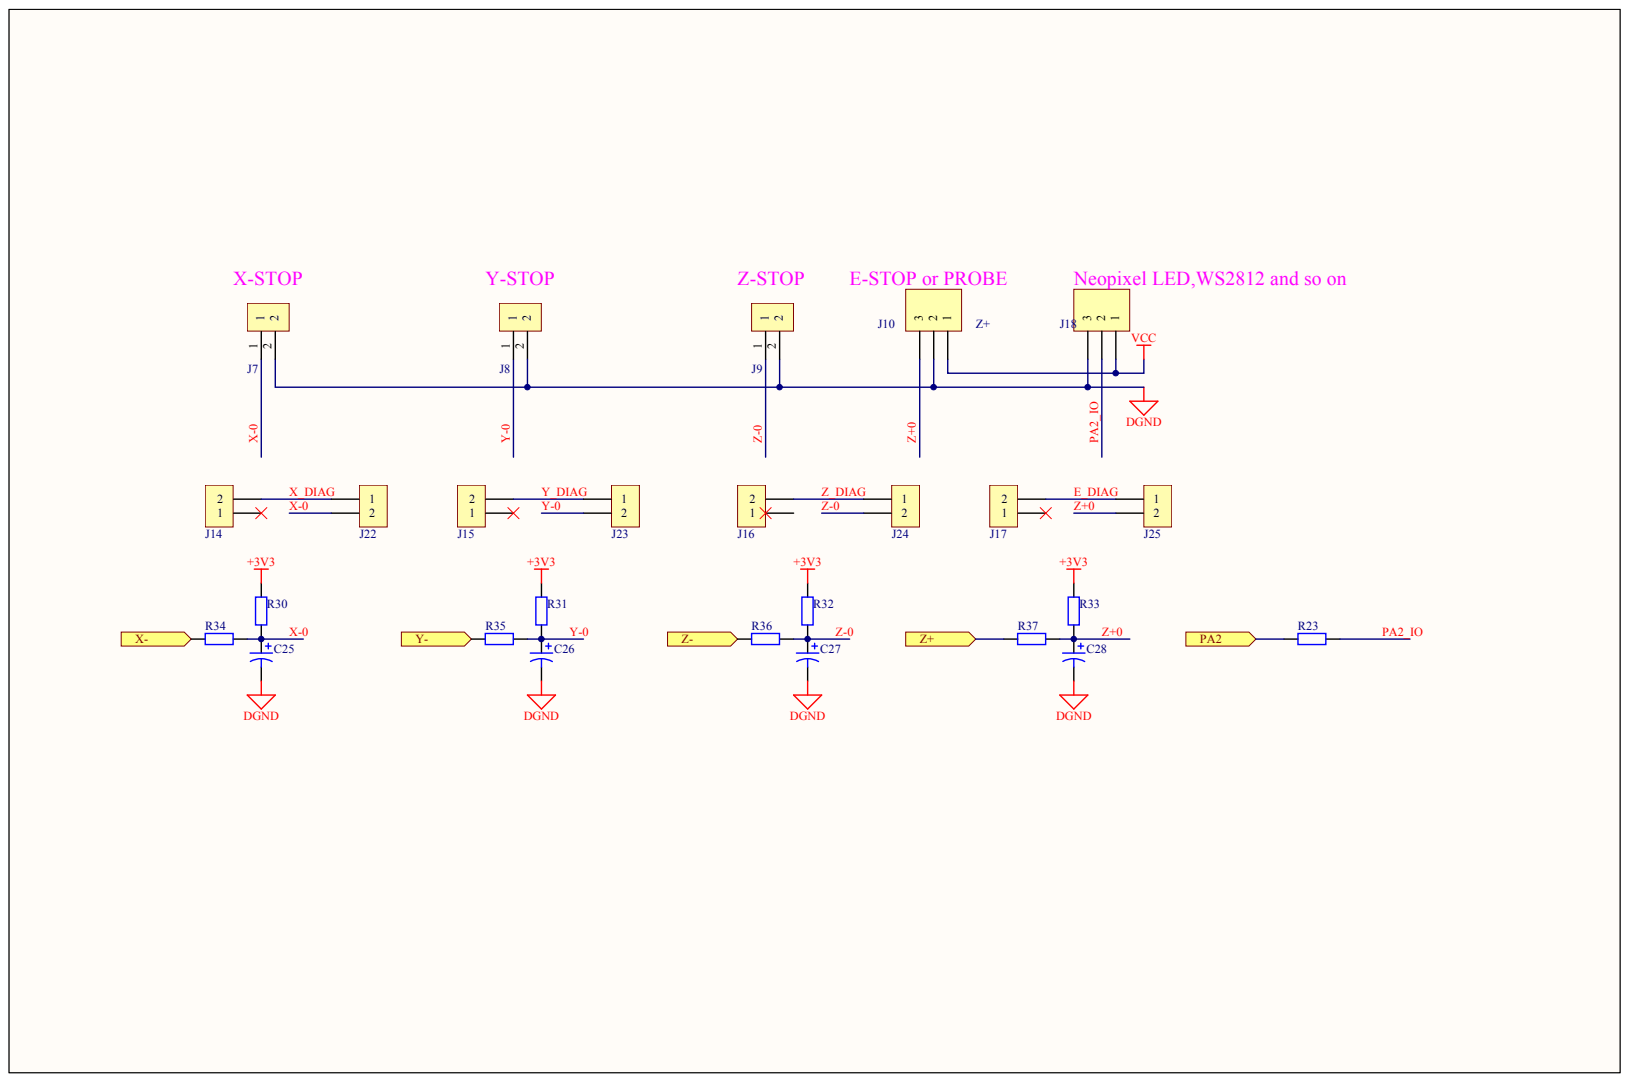
[picture p63: page 2]

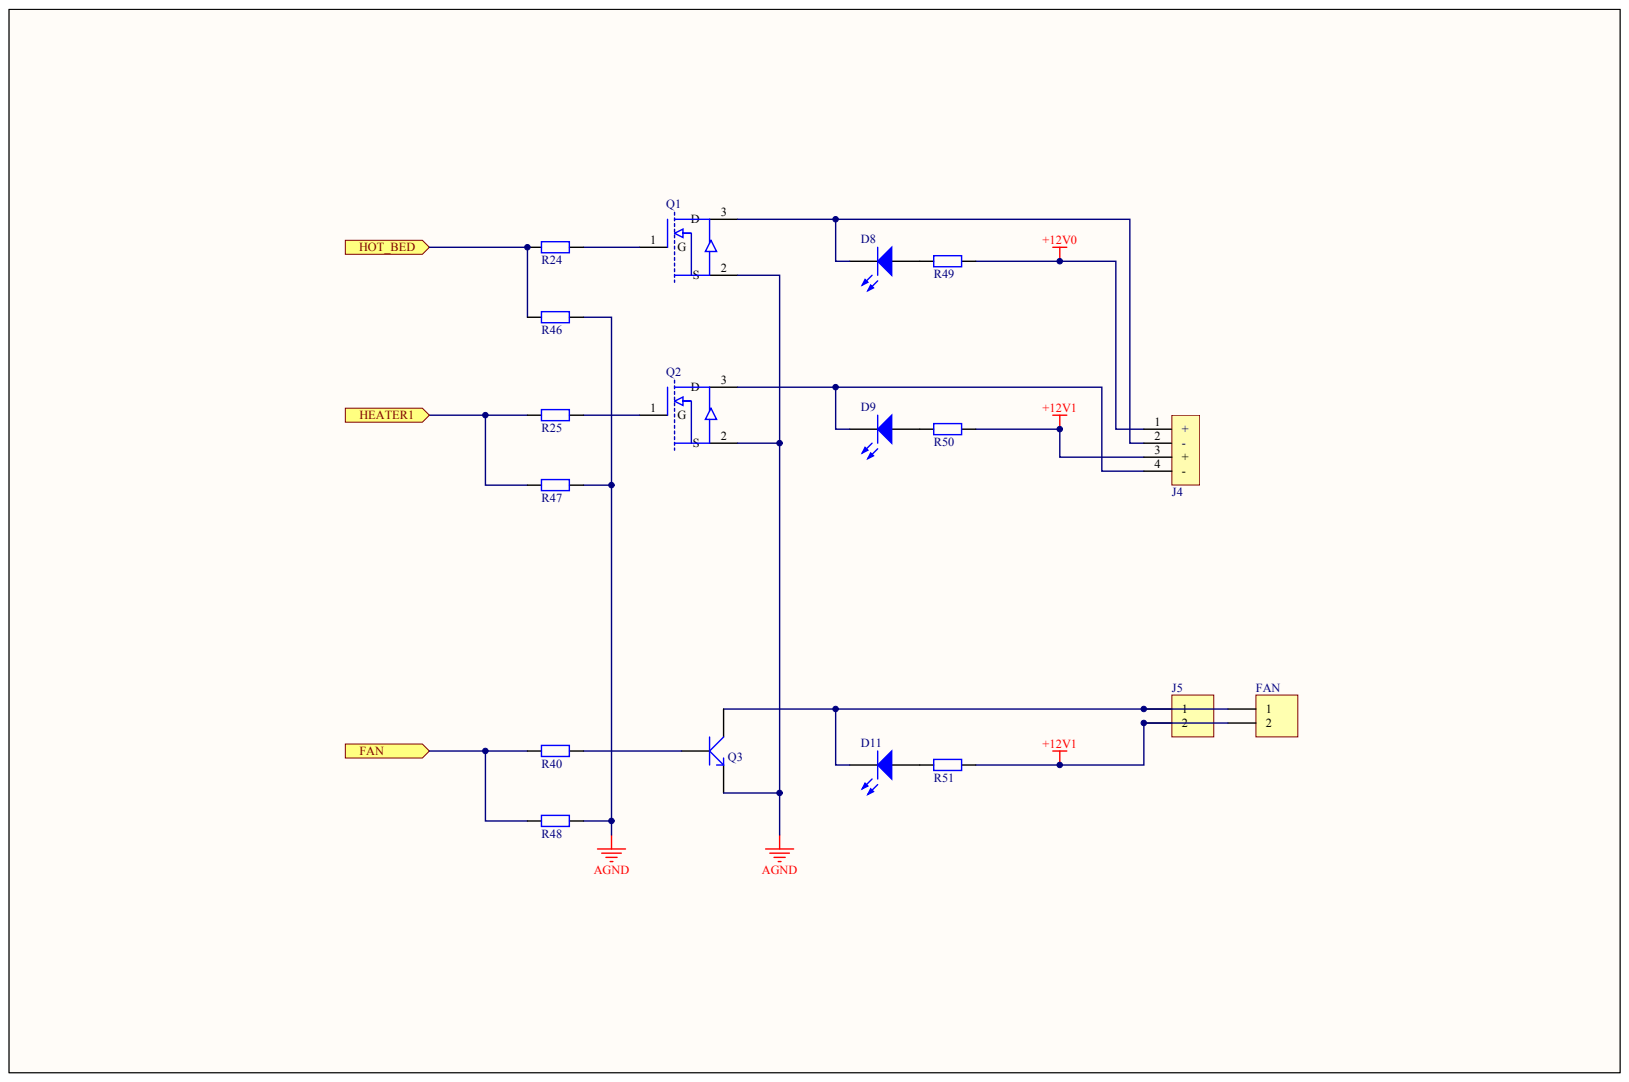
[picture p64: page 3]

- 2
+ 3

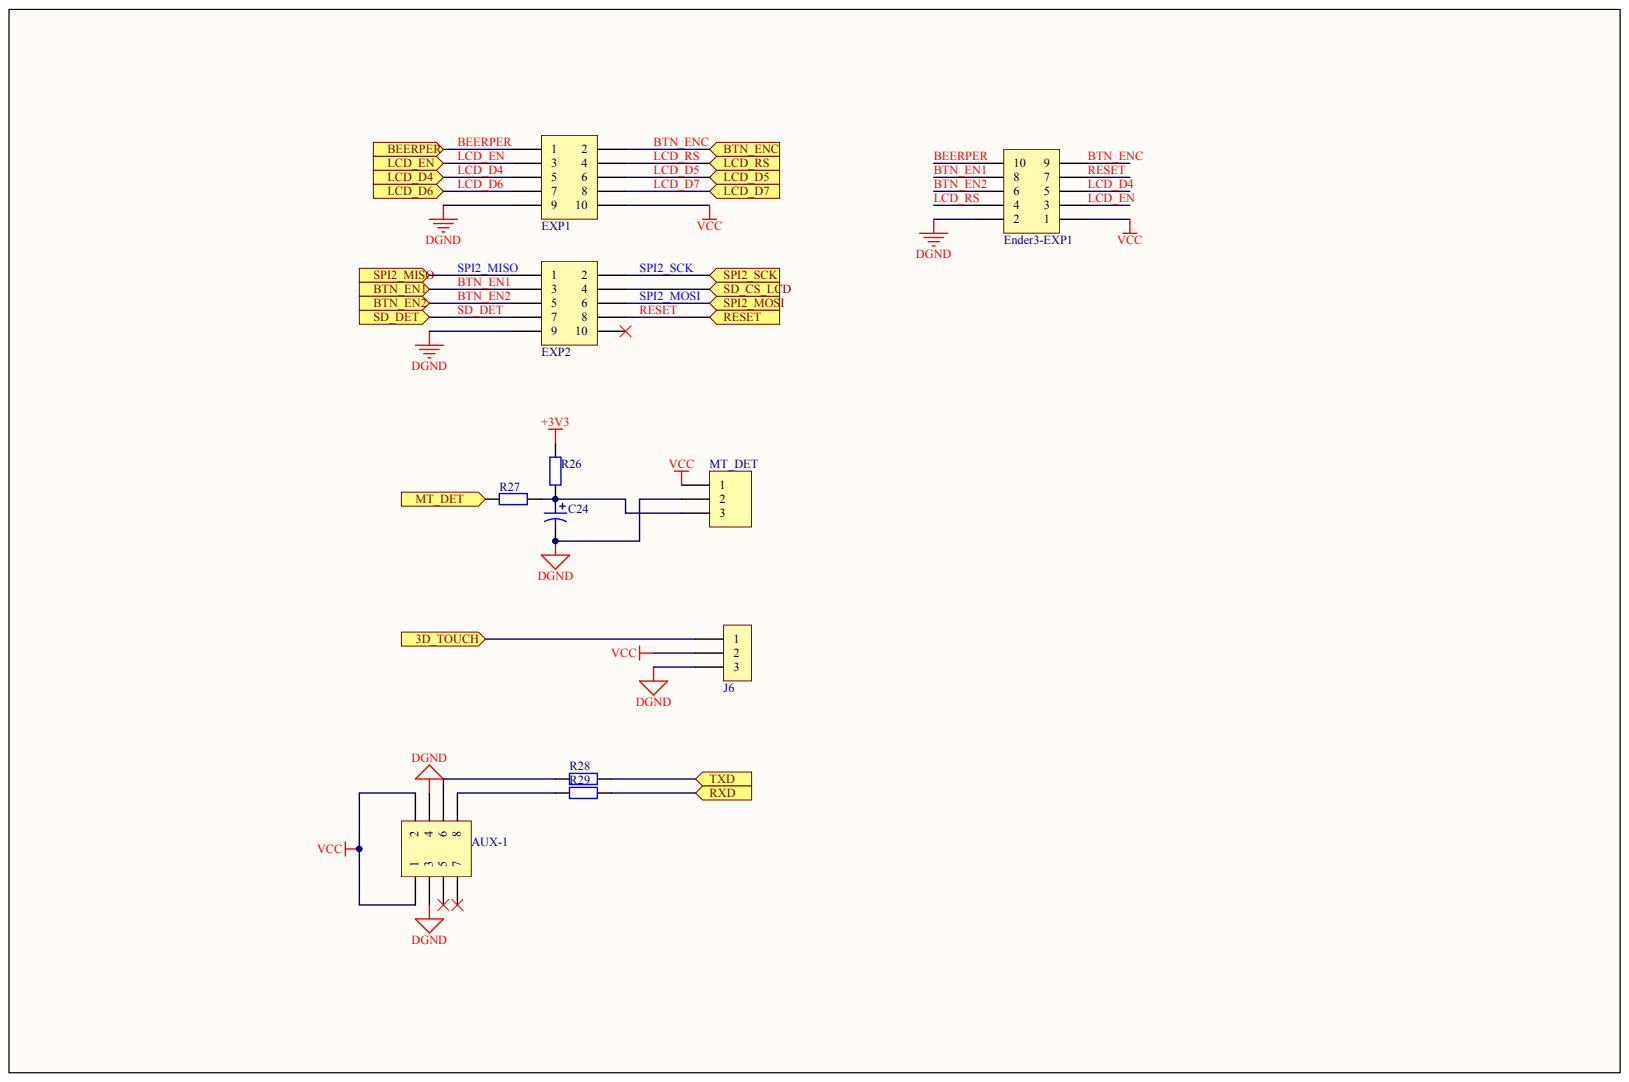
[picture p65: page 4]

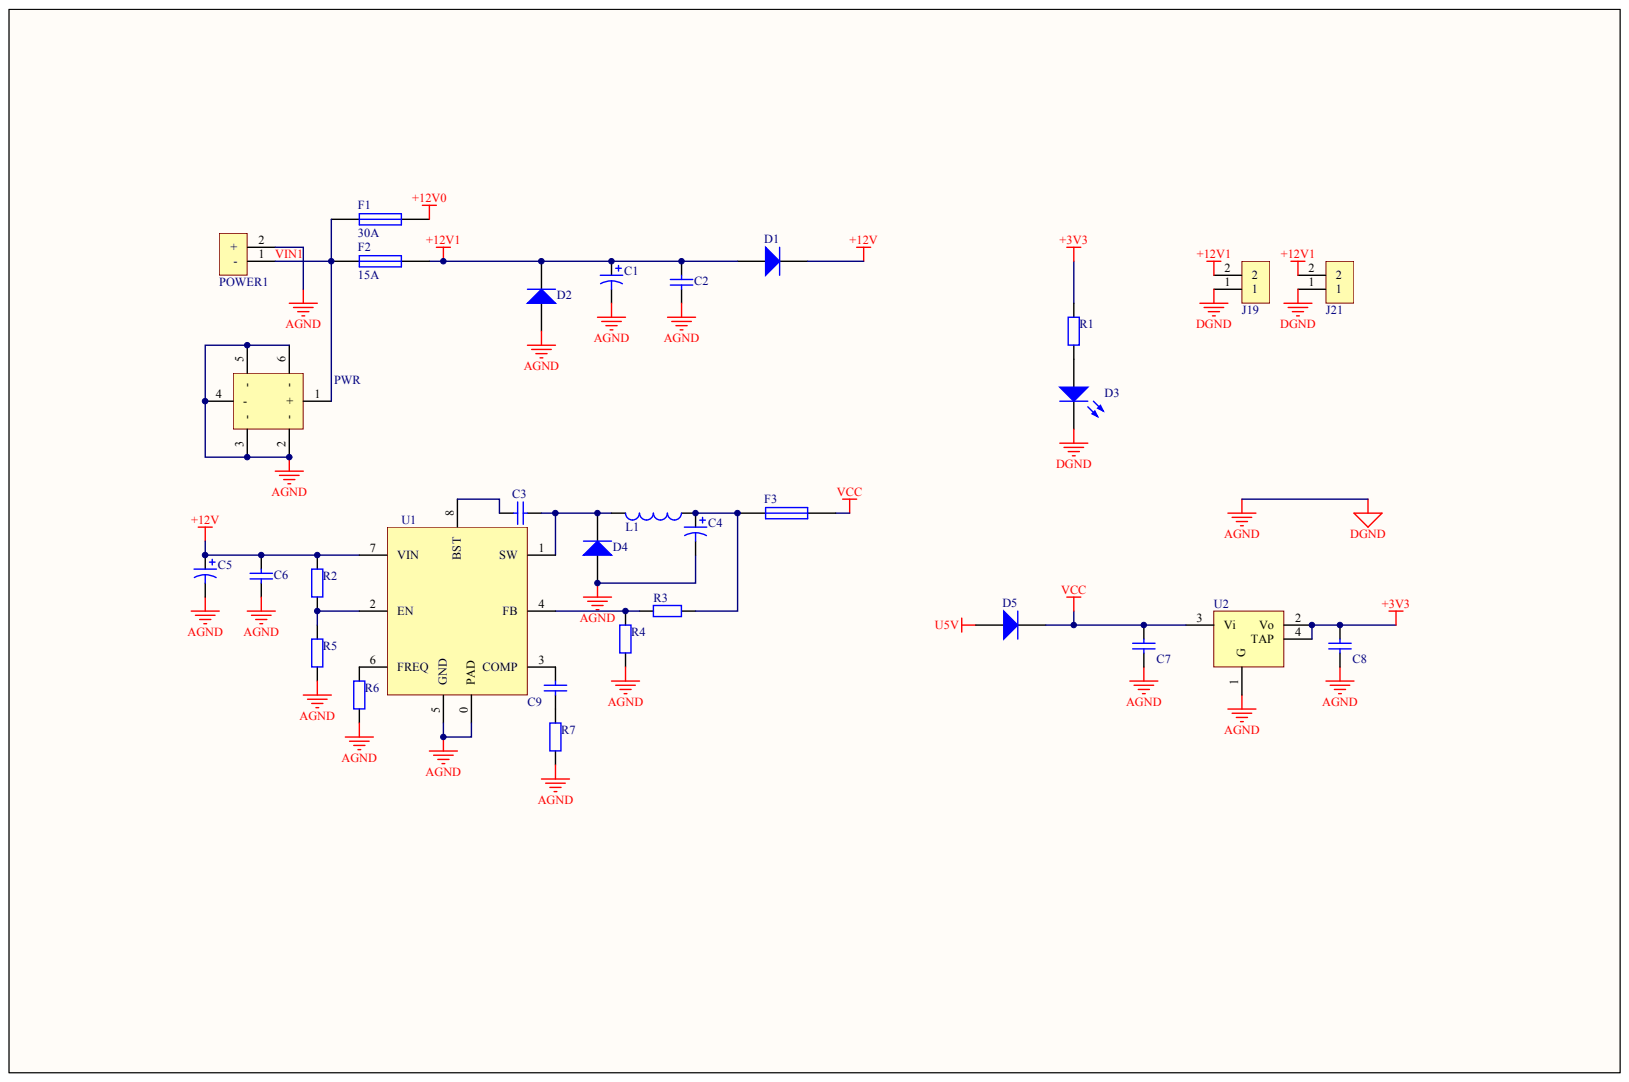
[picture p66: page 5]

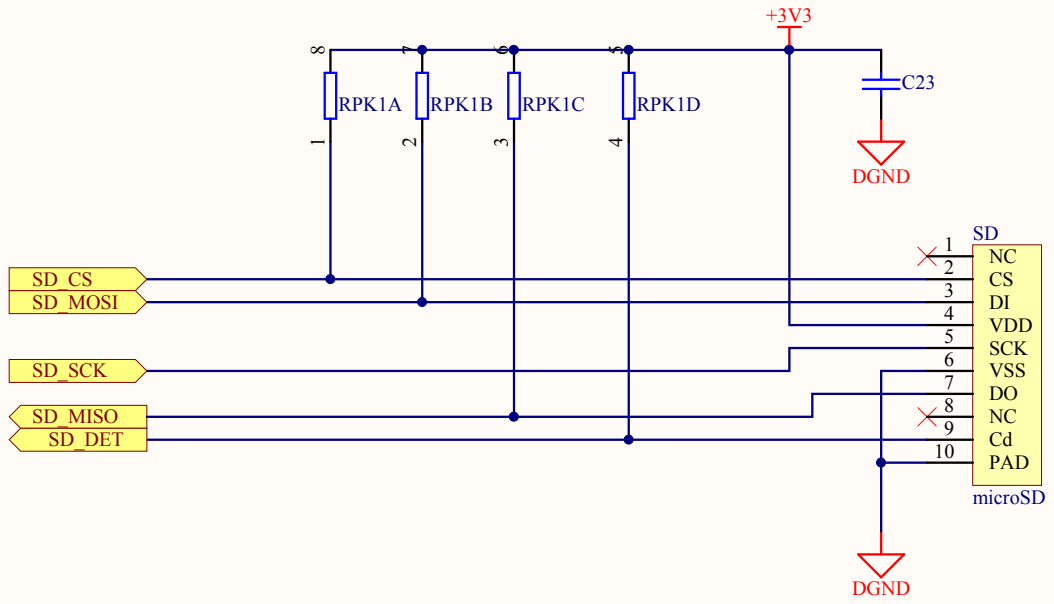
[picture p67: page 6]

DGND

DI 3
VDD 4

VSS 6
DO 7
NC 8
Cd 9
PAD 10

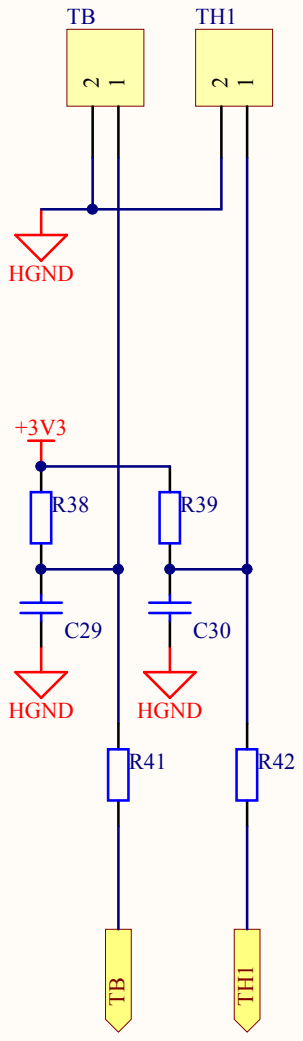
[picture p68: page 7]

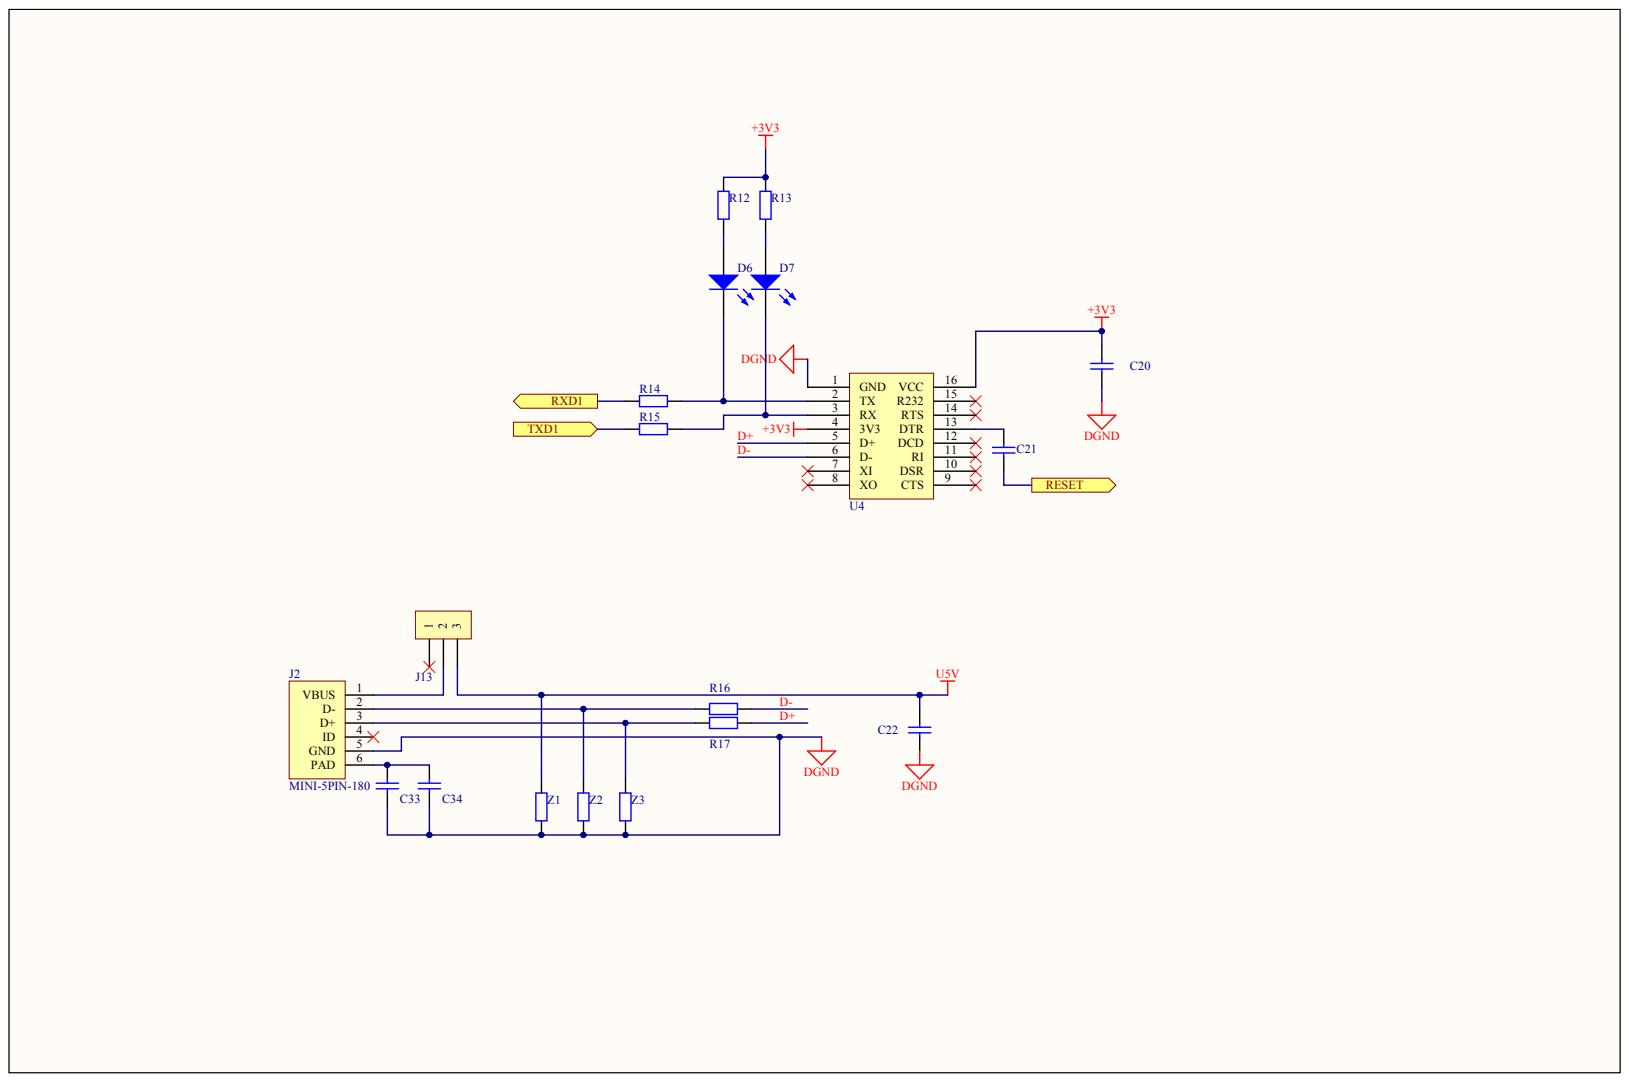
[picture p69: page 8]

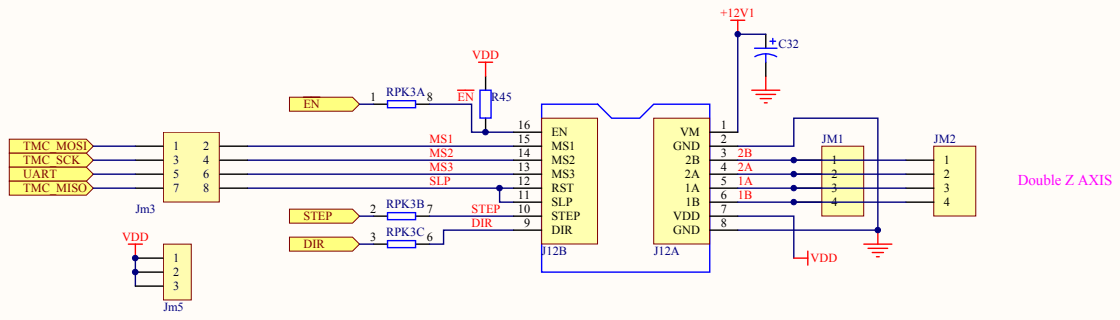
[picture p70: page 9]
