makerbase-mks/MKS-Robin-E3-E3D/hardware/MKS Robin E3D V1.0_002/MKS Robin E3D V1.0_002 BOTTOM.pdf

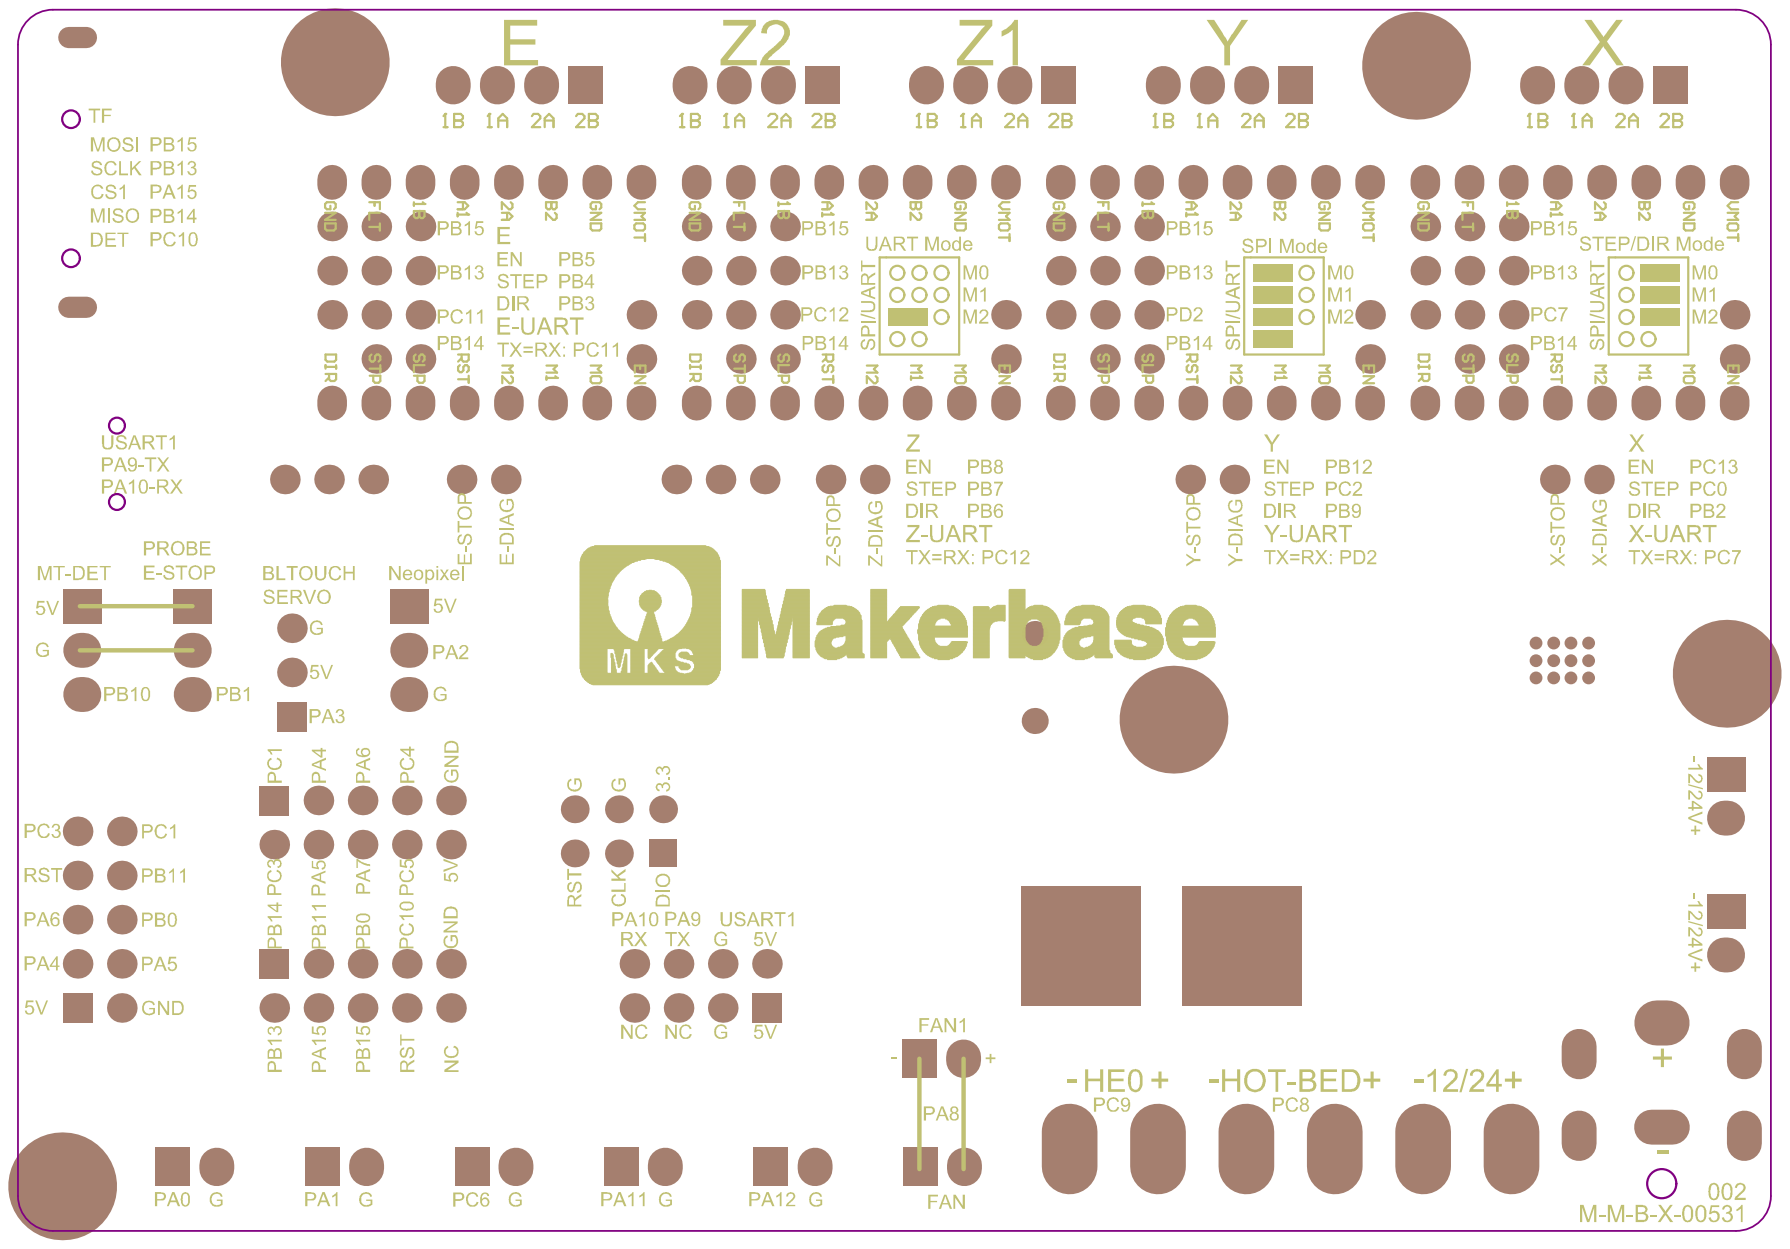
[picture p71: page 1]
