makerbase-mks/MKS-Robin-E3-E3D/hardware/MKS Robin E3D V1.0_002/MKS Robin E3D V1.0_002 SIZE.pdf

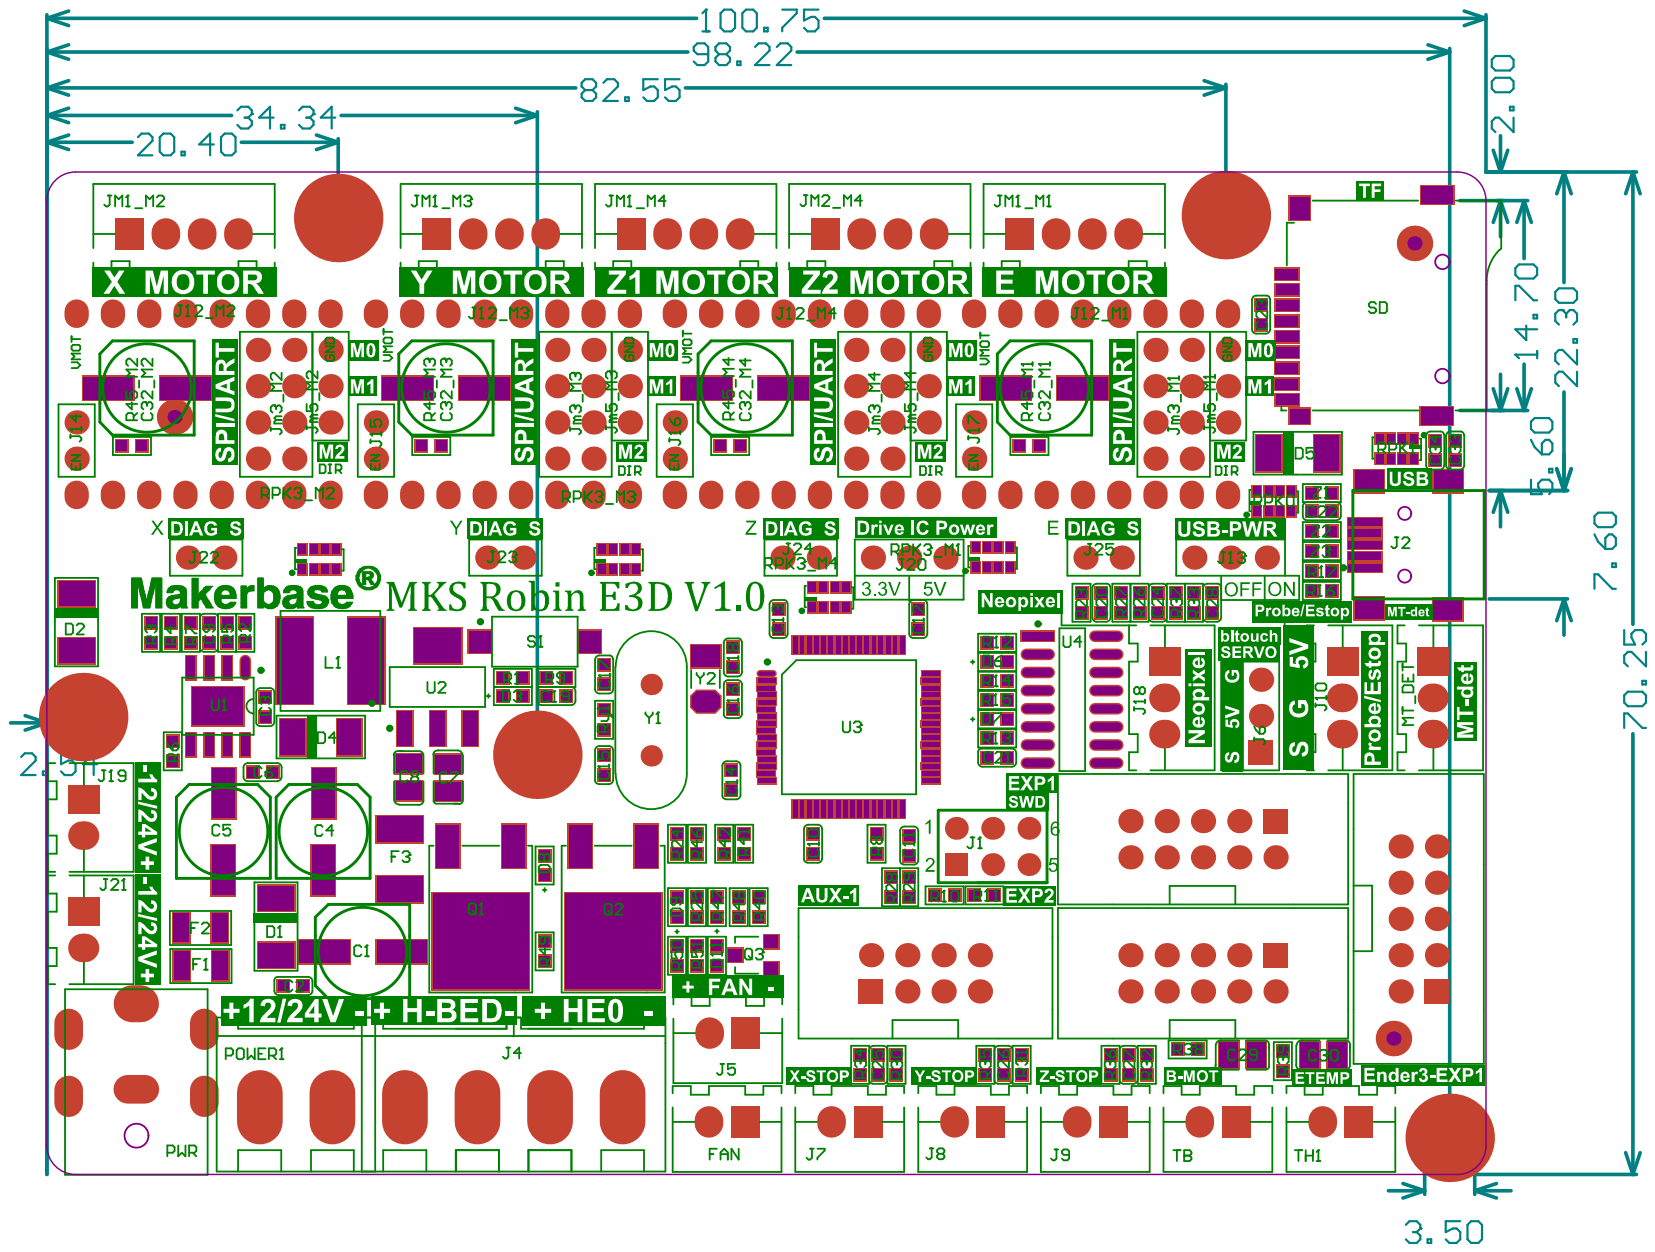
[picture p73: page 1]
