makerbase-mks/MKS-Robin-E3-E3D/hardware/MKS Robin E3 V1.0_003/MKS Robin E3 V1.0_003 SCH.pdf

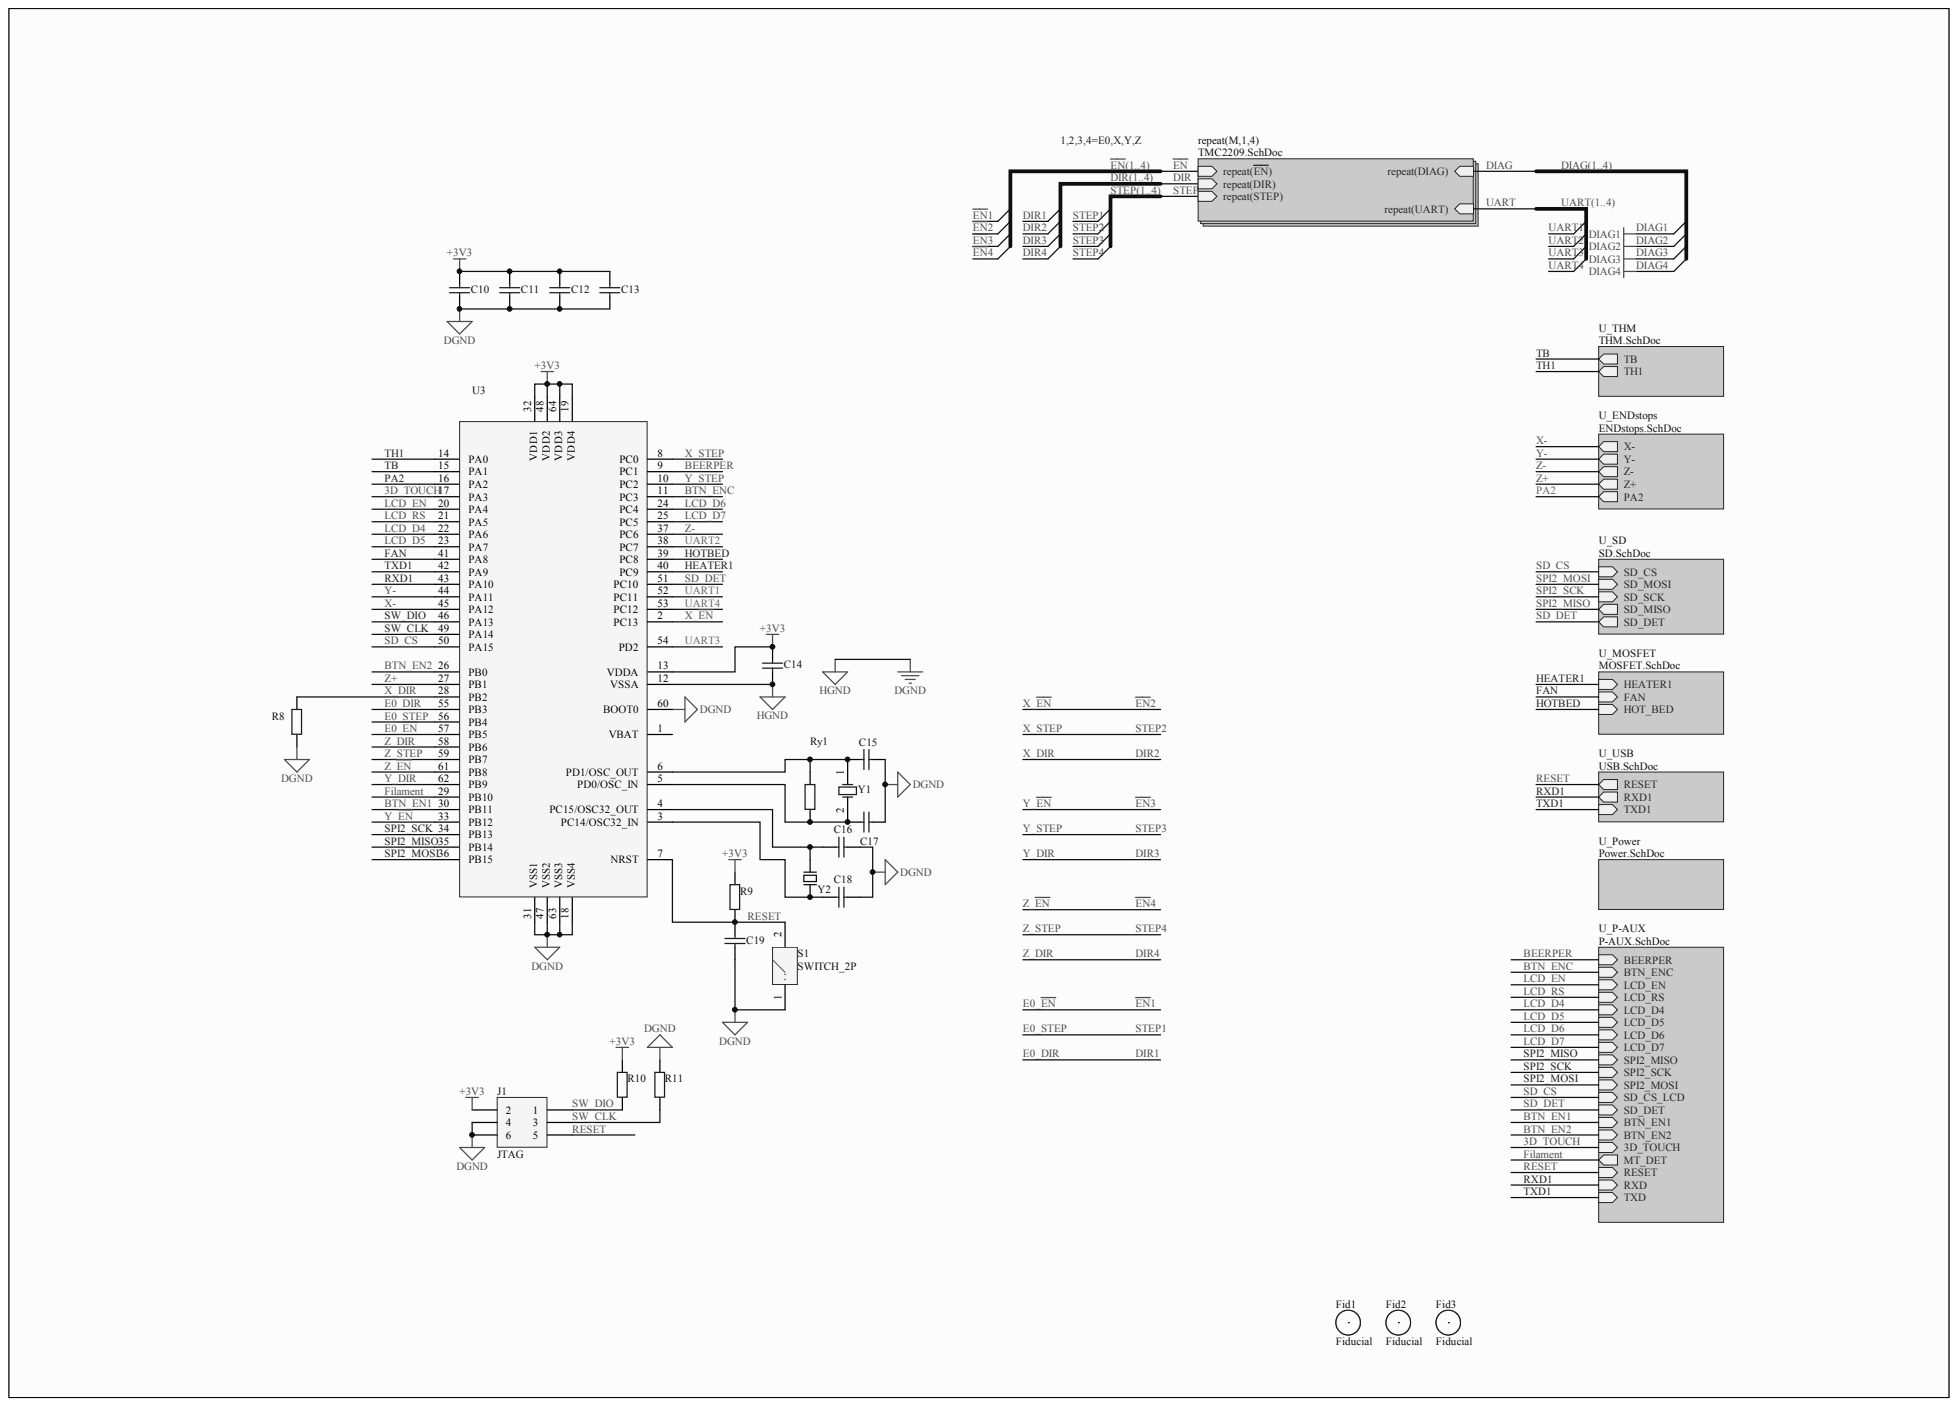
[picture p75: page 1]

DIR(1.. 4 ) | DI R | UART | UART(1 . . 4 )
S T E P(1.. 4 | ) S T E P

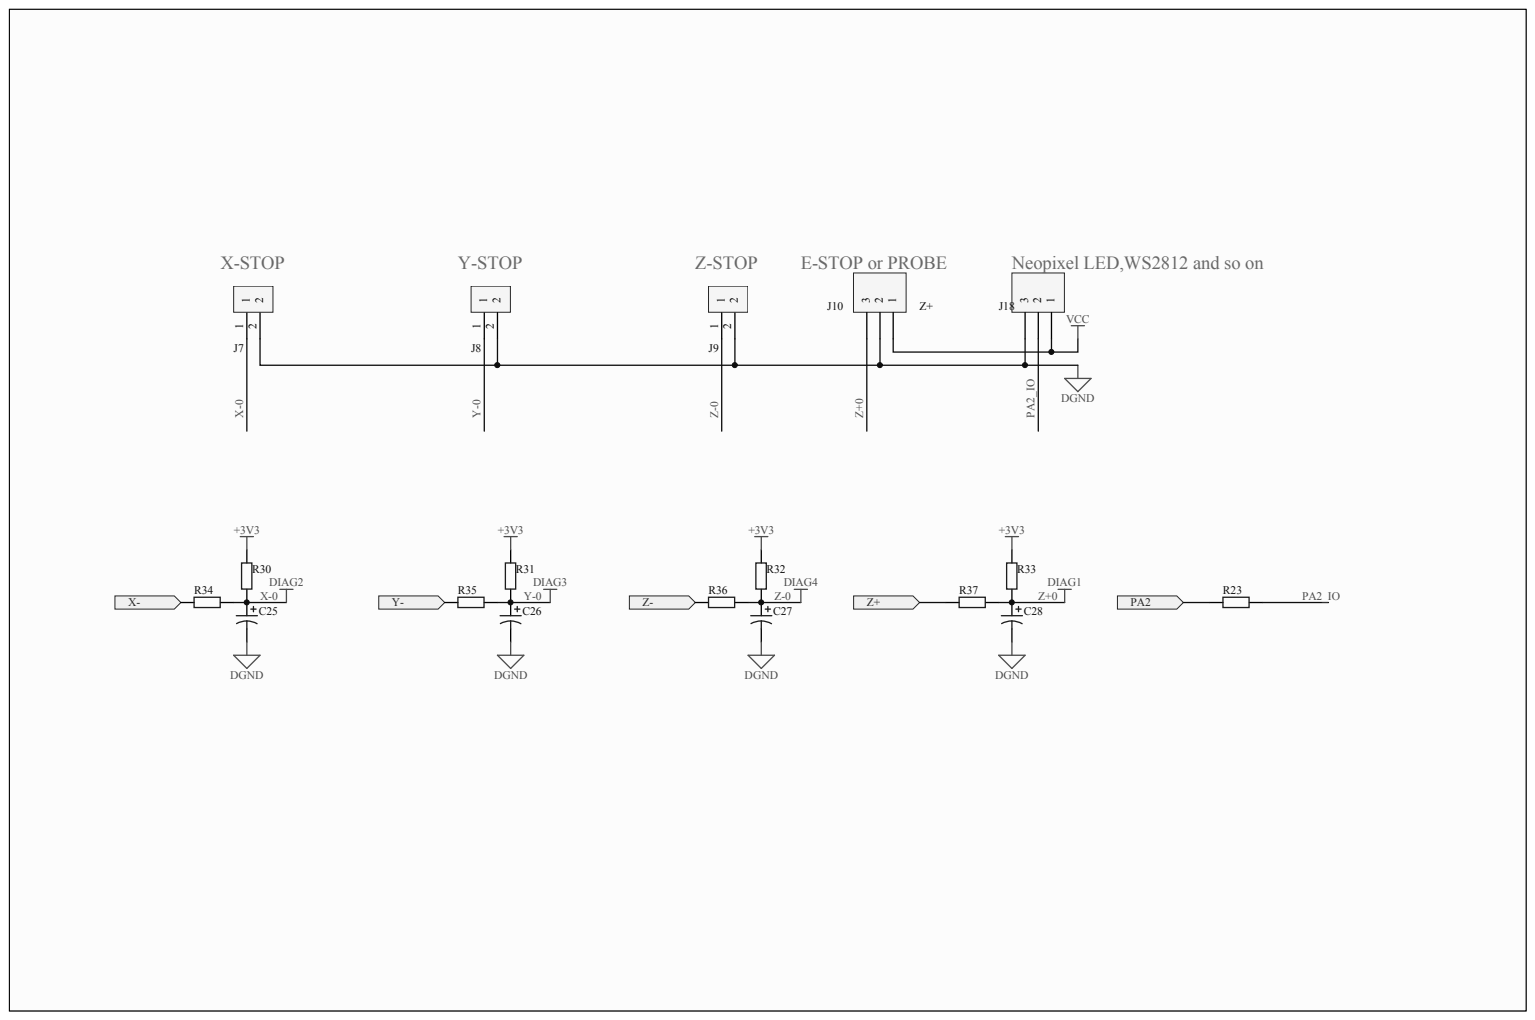
[picture p76: page 2]


- 2
+ 3


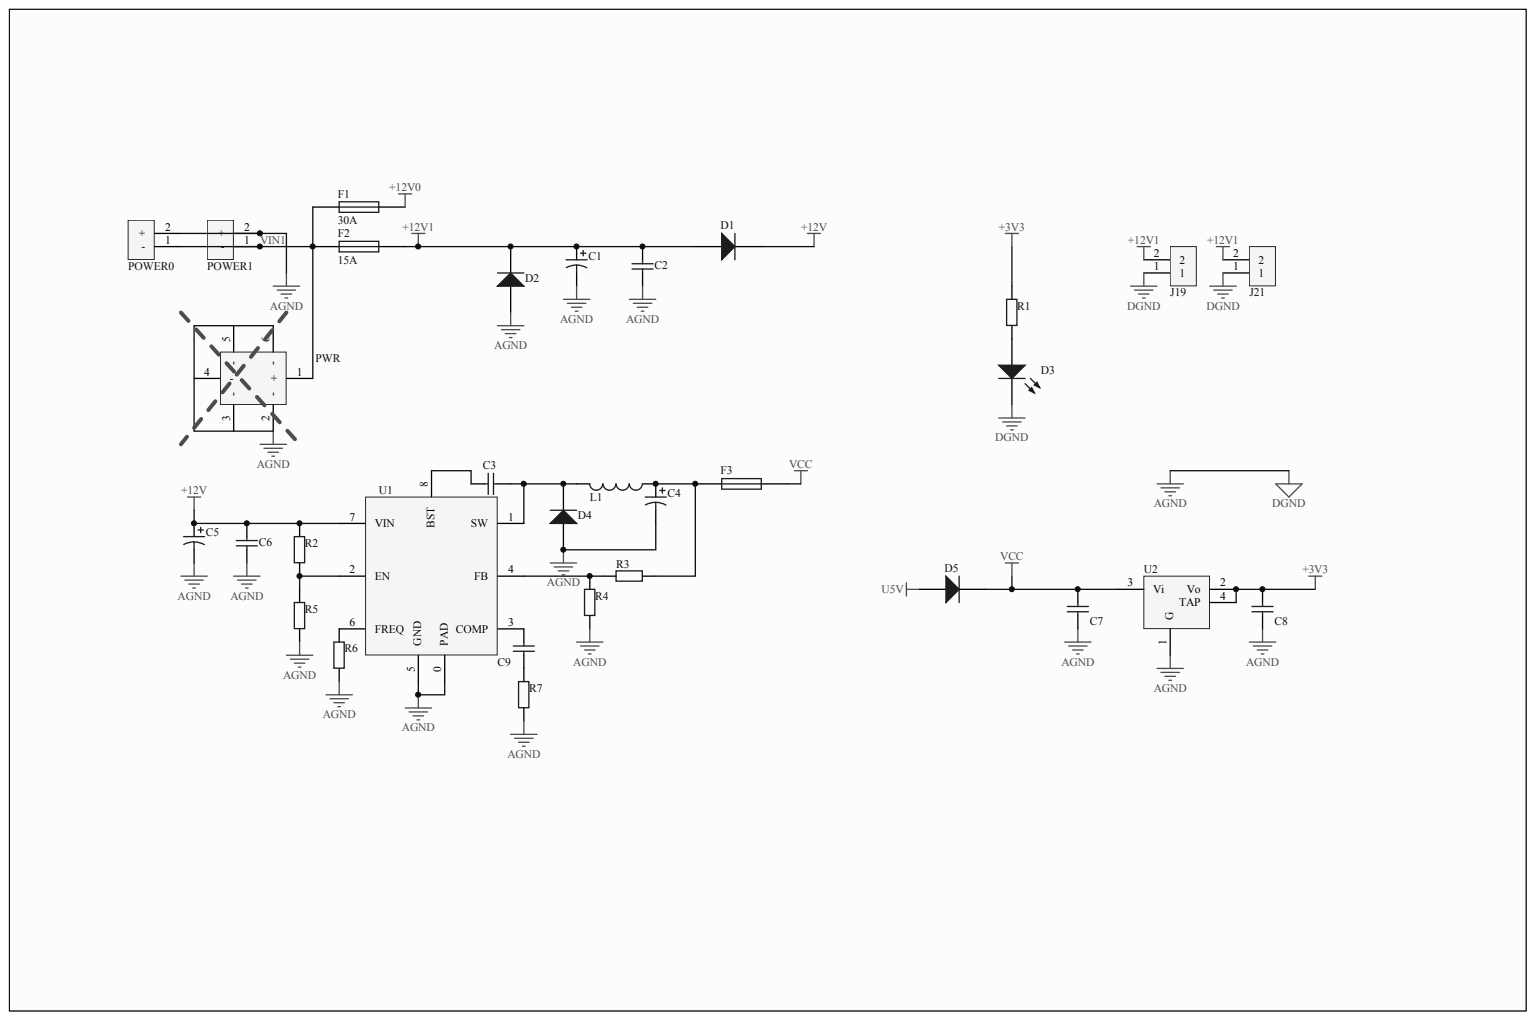
[picture p77: page 5]


DGND

DI 3
VDD 4

VSS 6
DO 7
NC 8
Cd 9
PAD 10


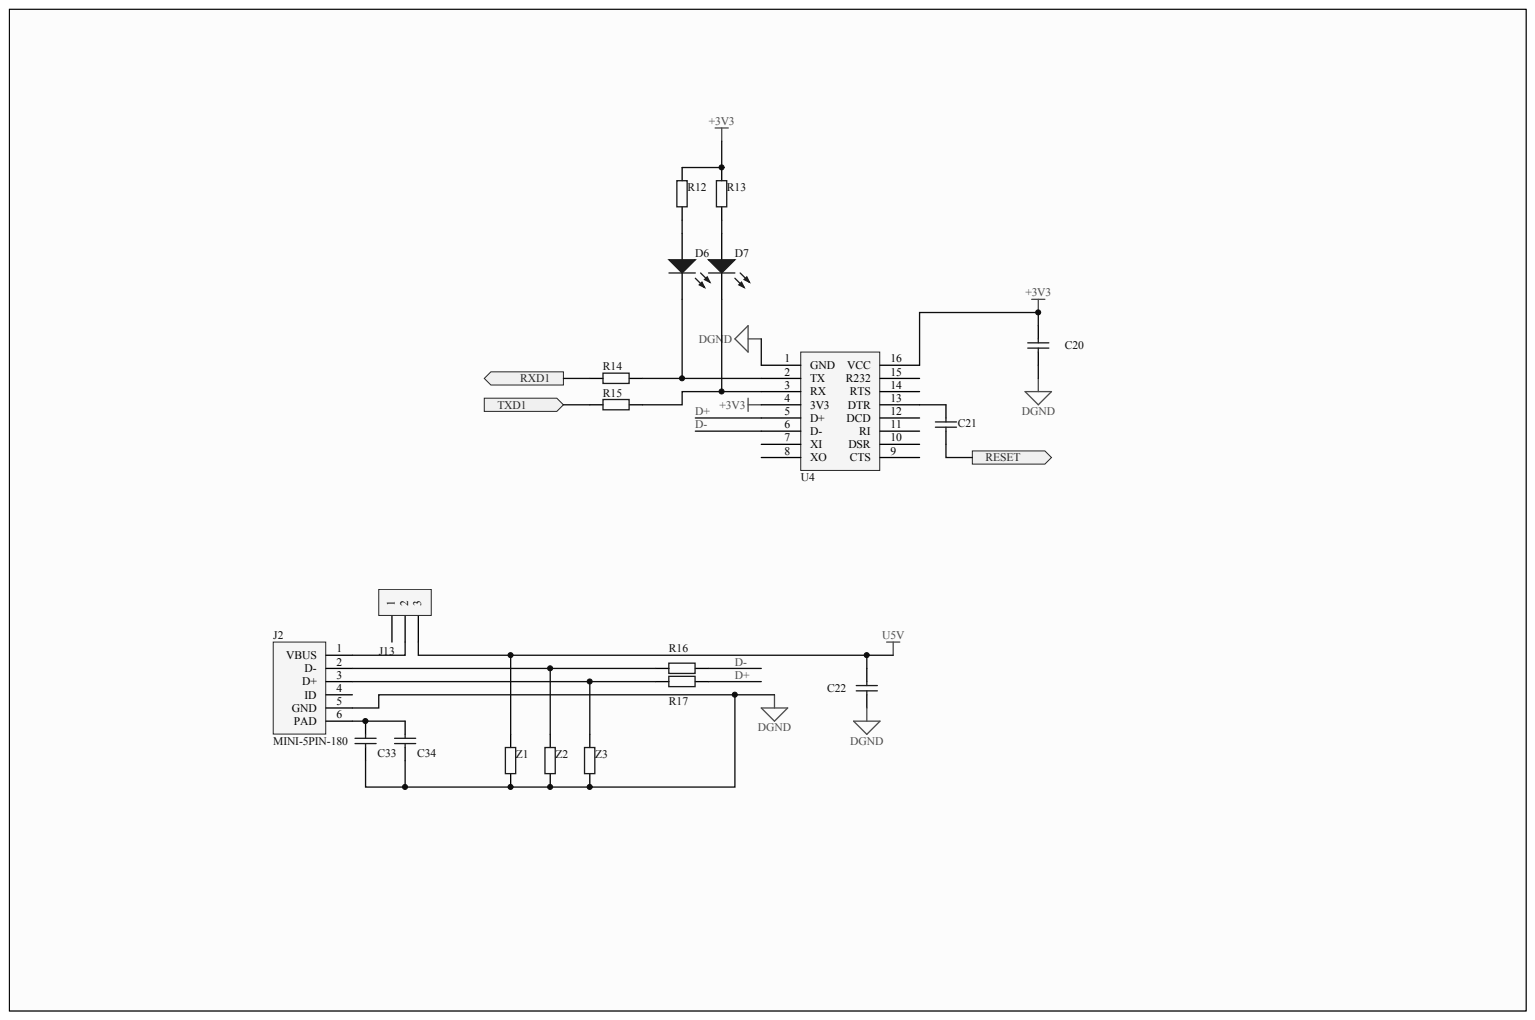
[picture p78: page 8]

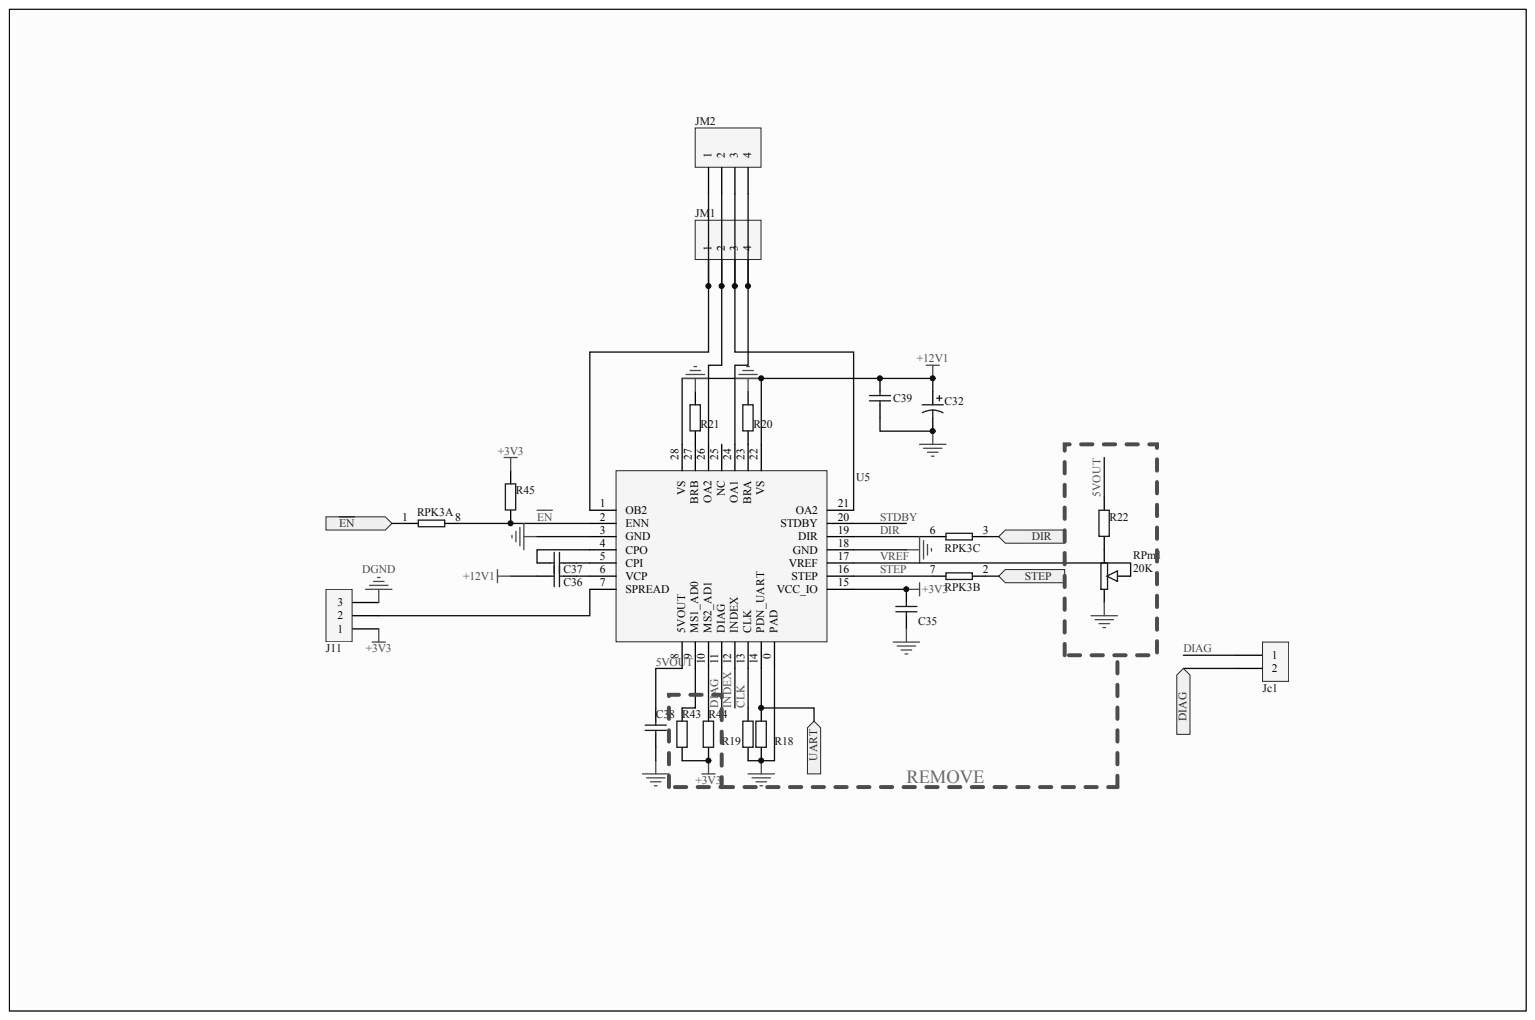
[picture p79: page 9]

VS 22 BRA 23 OA1 24 NC 25 OA2 26 BRB 27 VS 28

CPO 4
CPI 5 | VREF
VCP 6 | STEP
