makerbase-mks/MKS-Robin-E3-E3D/hardware/MKS Robin E3 V1.0_002/MKS Robin E3 V1.0_002 SCH.pdf

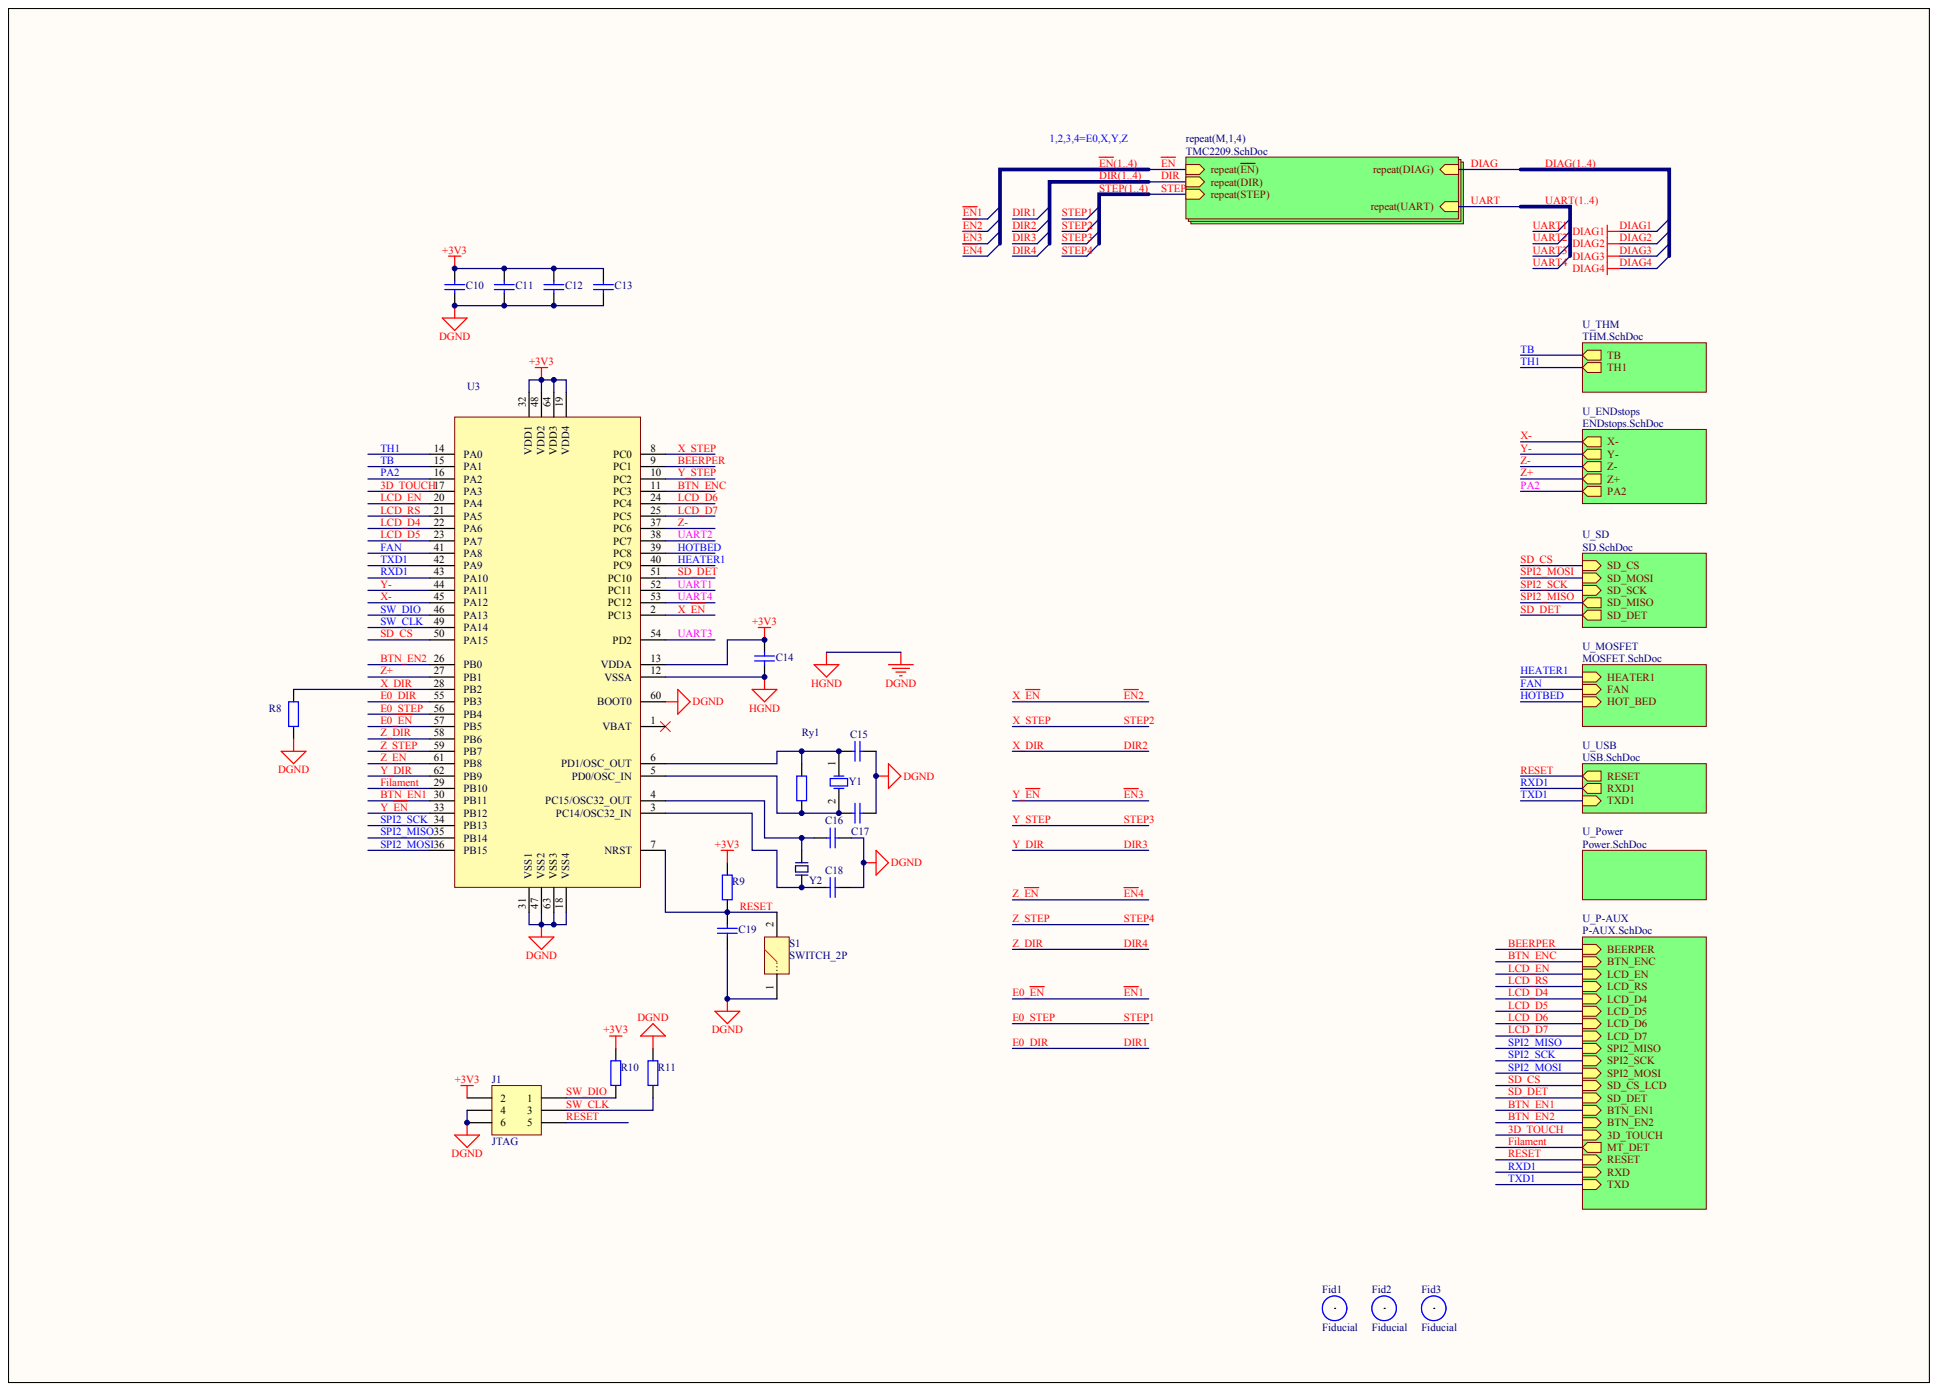
[picture p80: page 1]

DIR(1.. 4 ) | DIR STEP | UART | UART(1..4)
STEP(1..4)

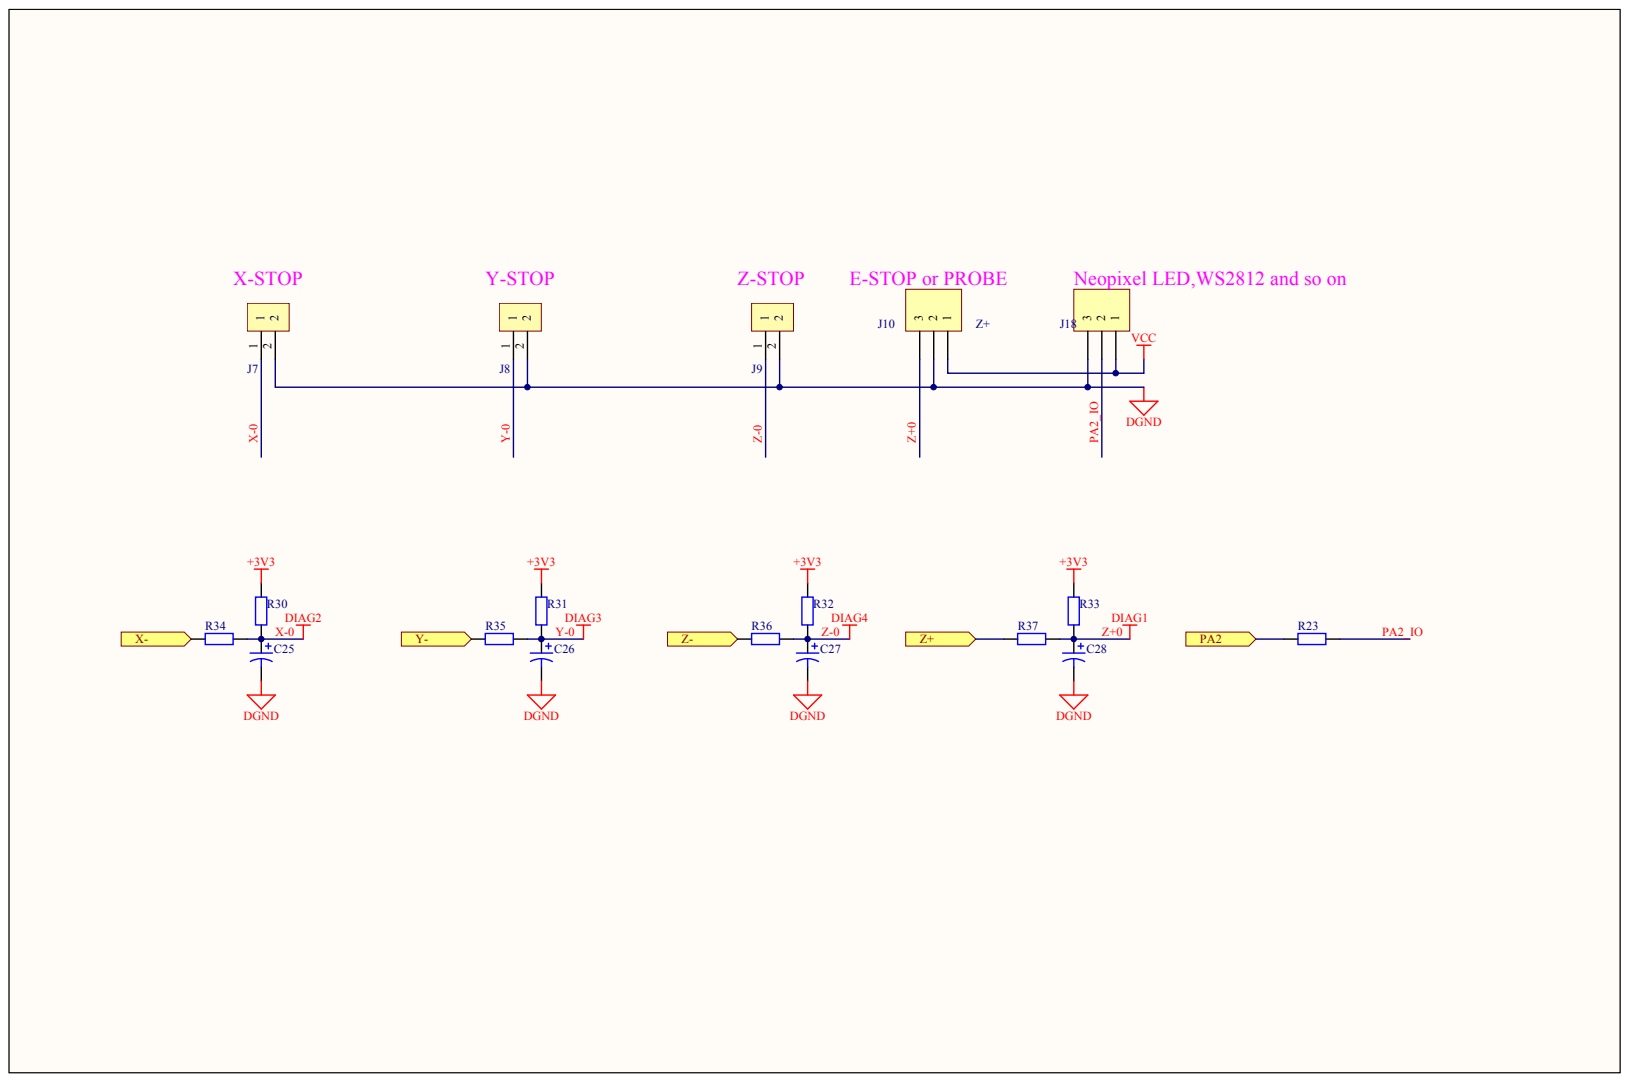
[picture p81: page 2]


- 2
+ 3


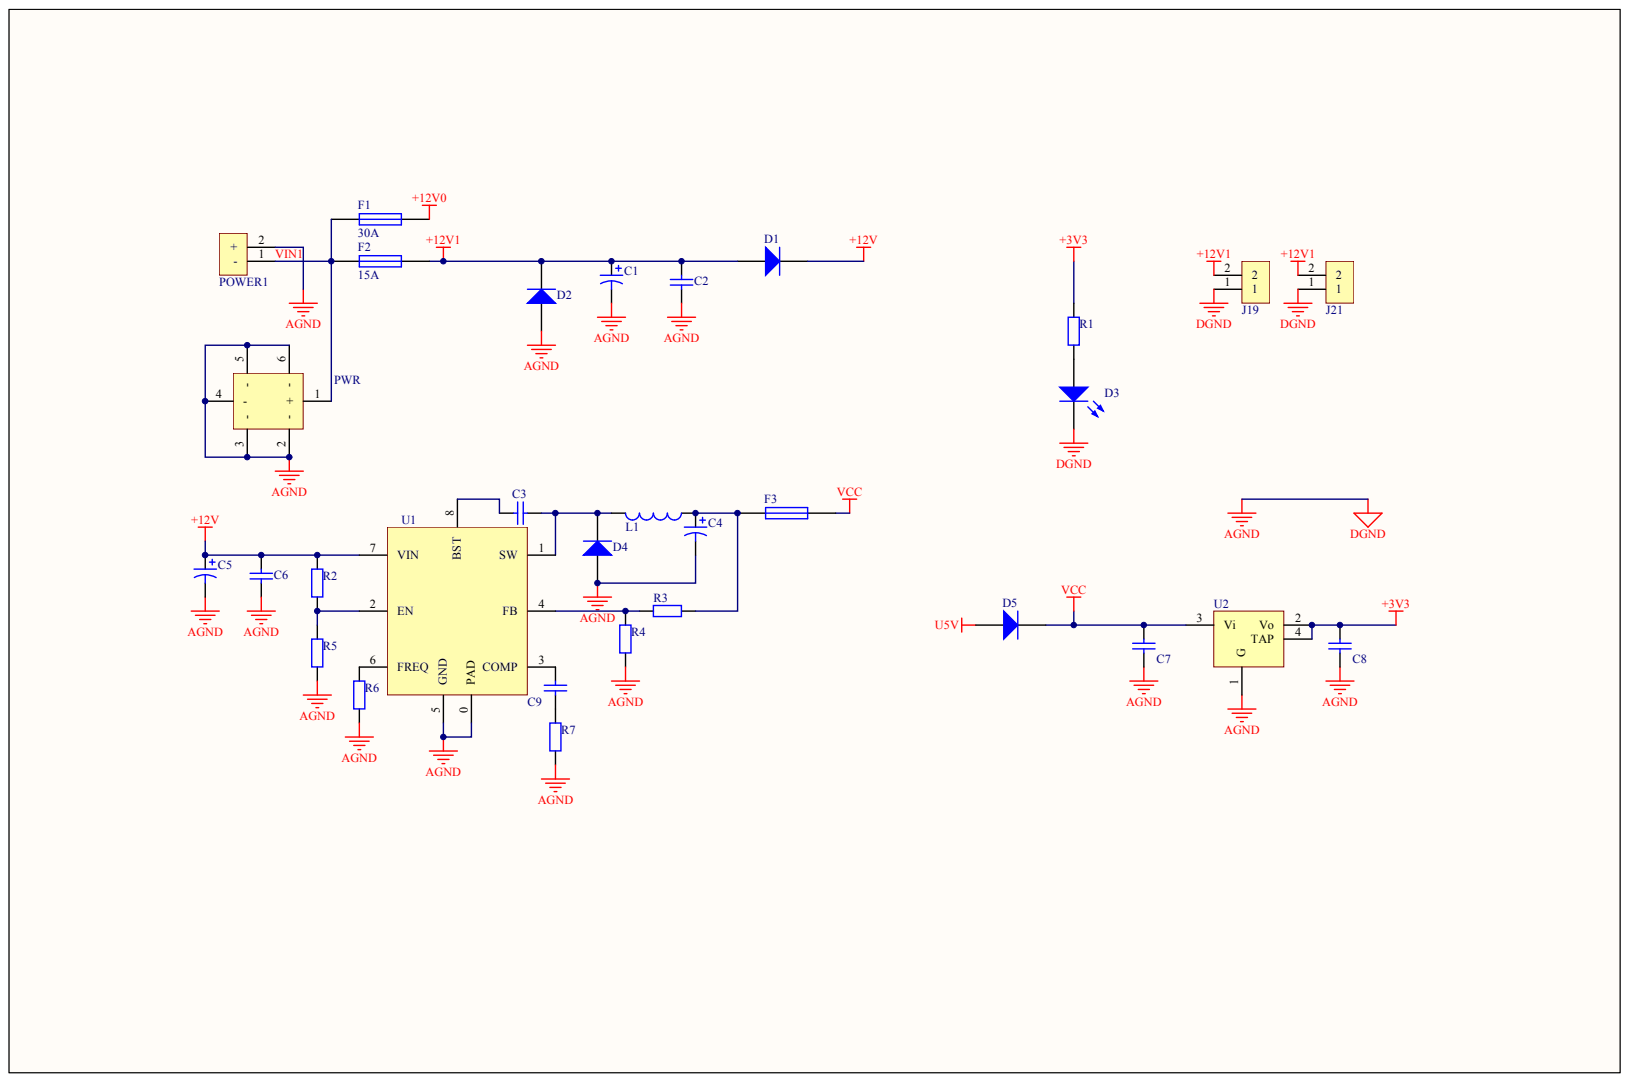
[picture p82: page 5]


DGND

DI 3
VDD 4

VSS 6
DO 7
NC 8
Cd 9
PAD 10


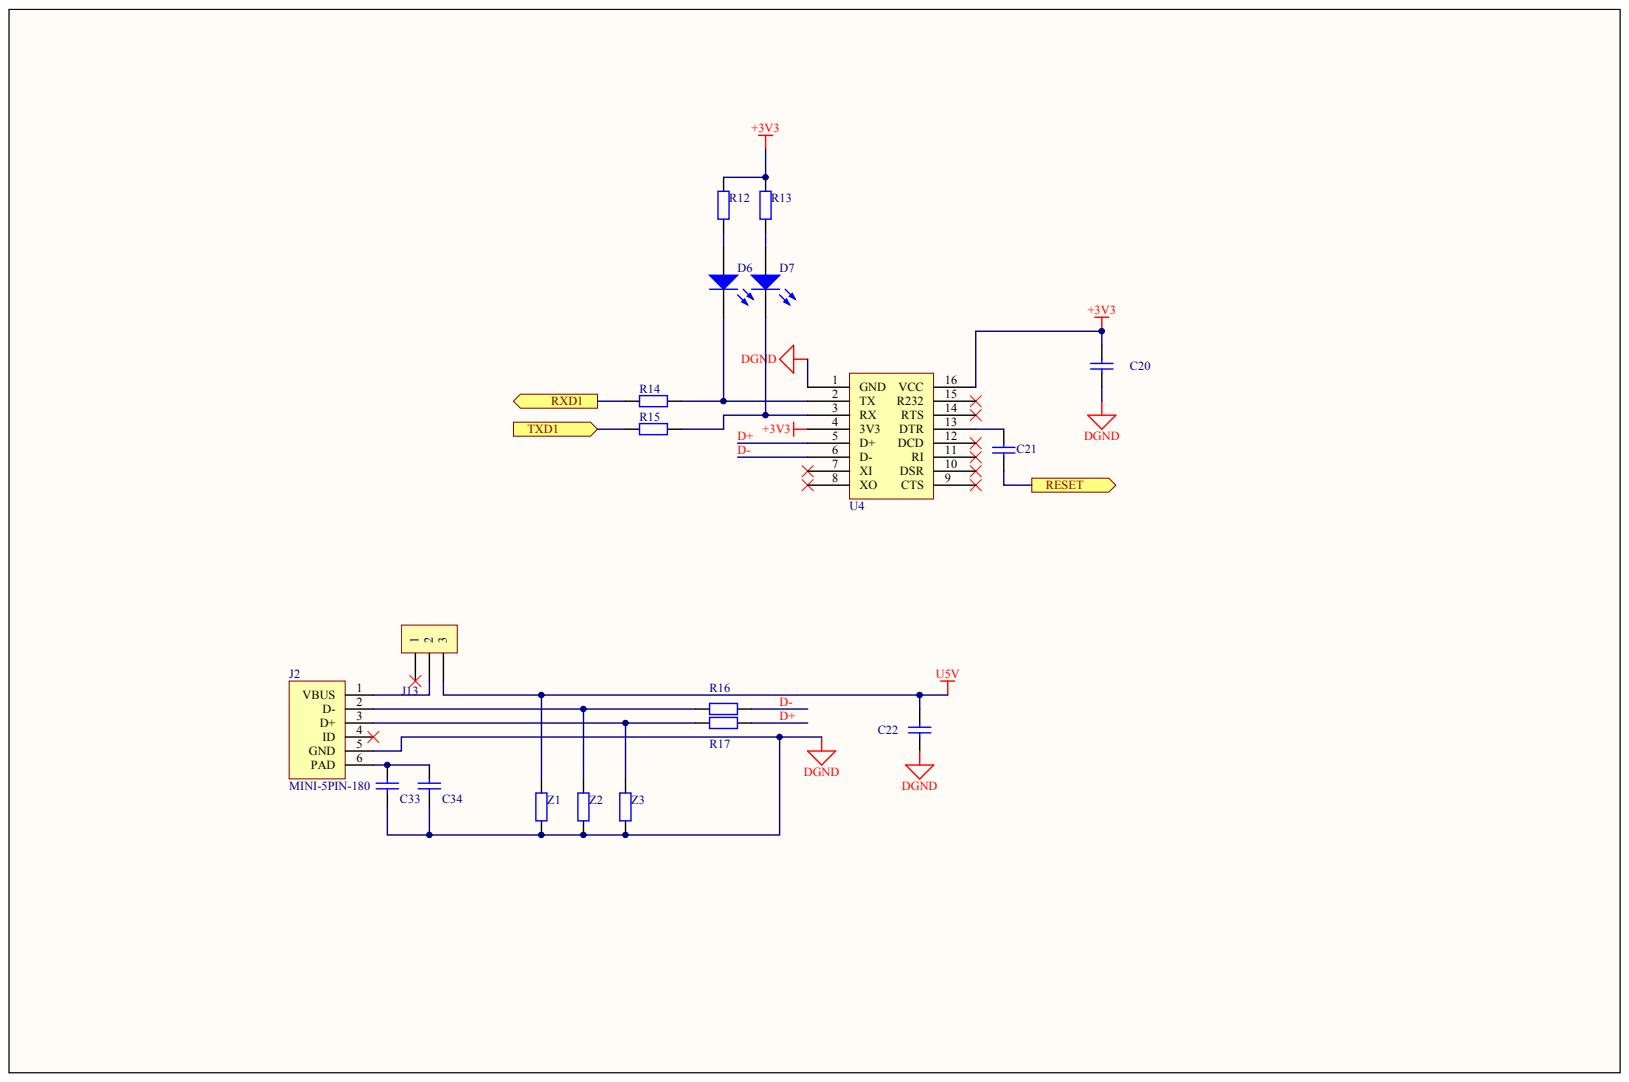
[picture p83: page 8]

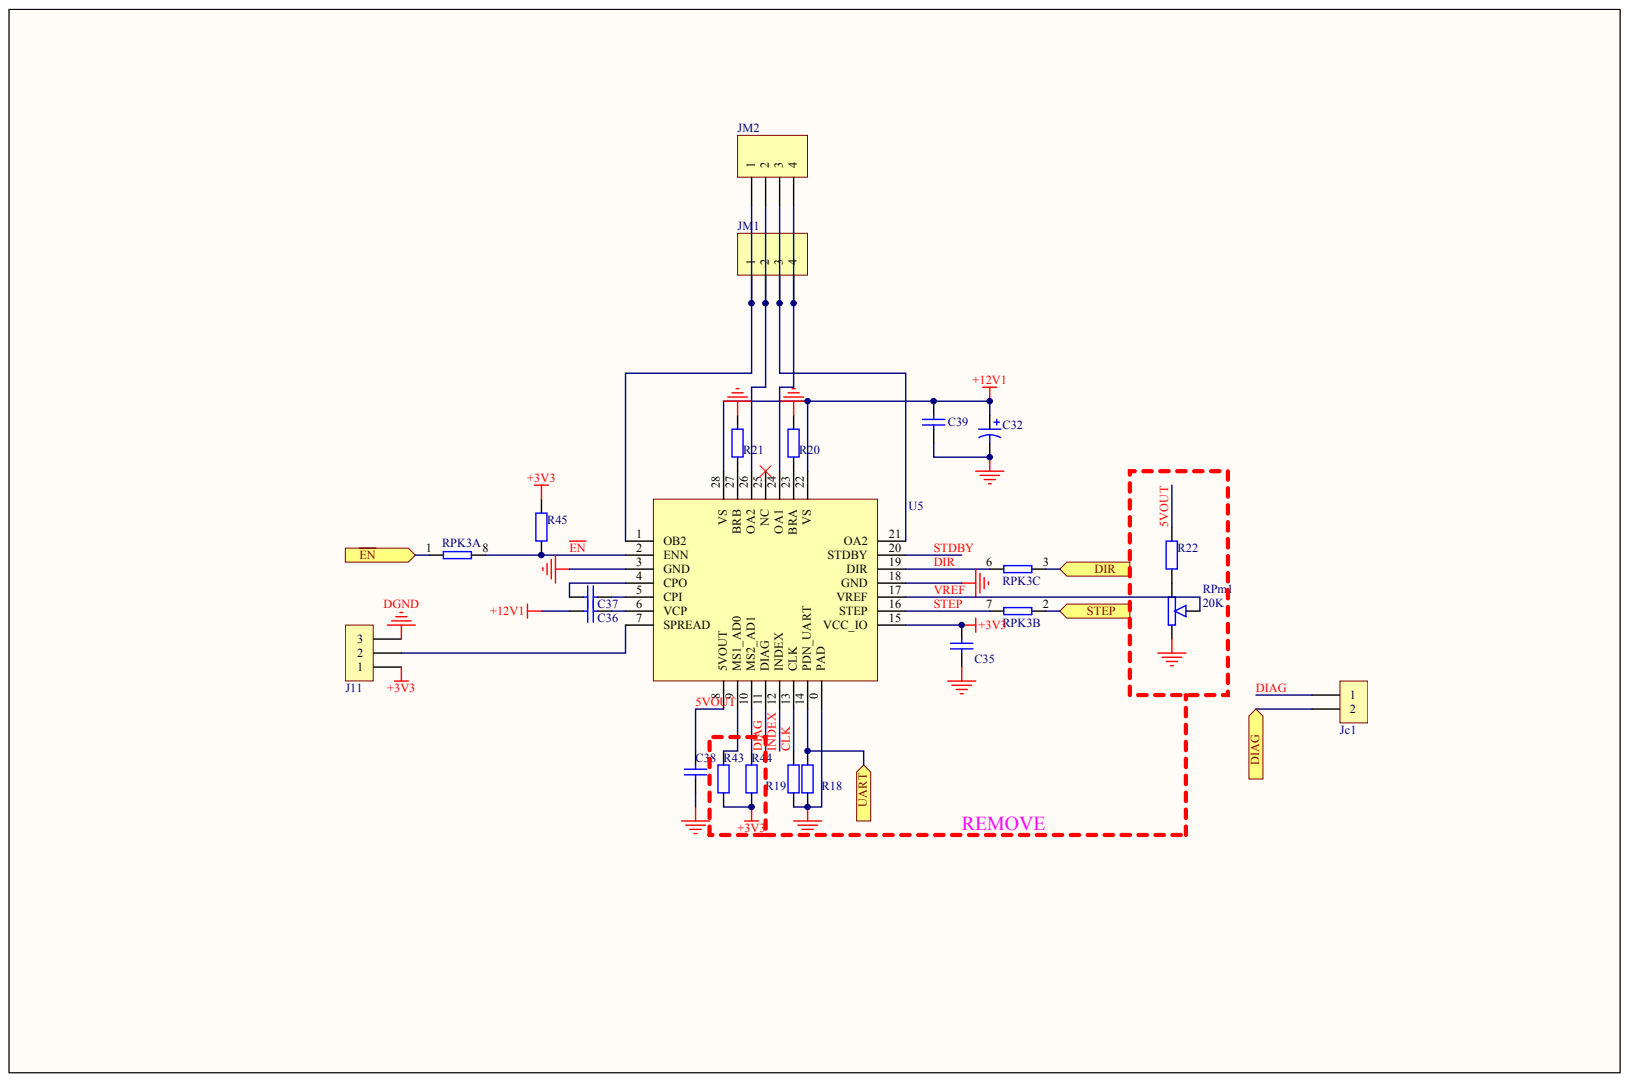
[picture p84: page 9]

VS 22 BRA 23 OA1 24 NC 25 OA2 26 BRB 27 VS 28

CPI 5 | VREF
VCP 6 | STEP STEP 7 2
