makerbase-mks/MKS-Robin-E3-E3D/hardware/MKS Robin E3 V1.1_003/MKS Robin E3 V1.1_003 SIZE.pdf

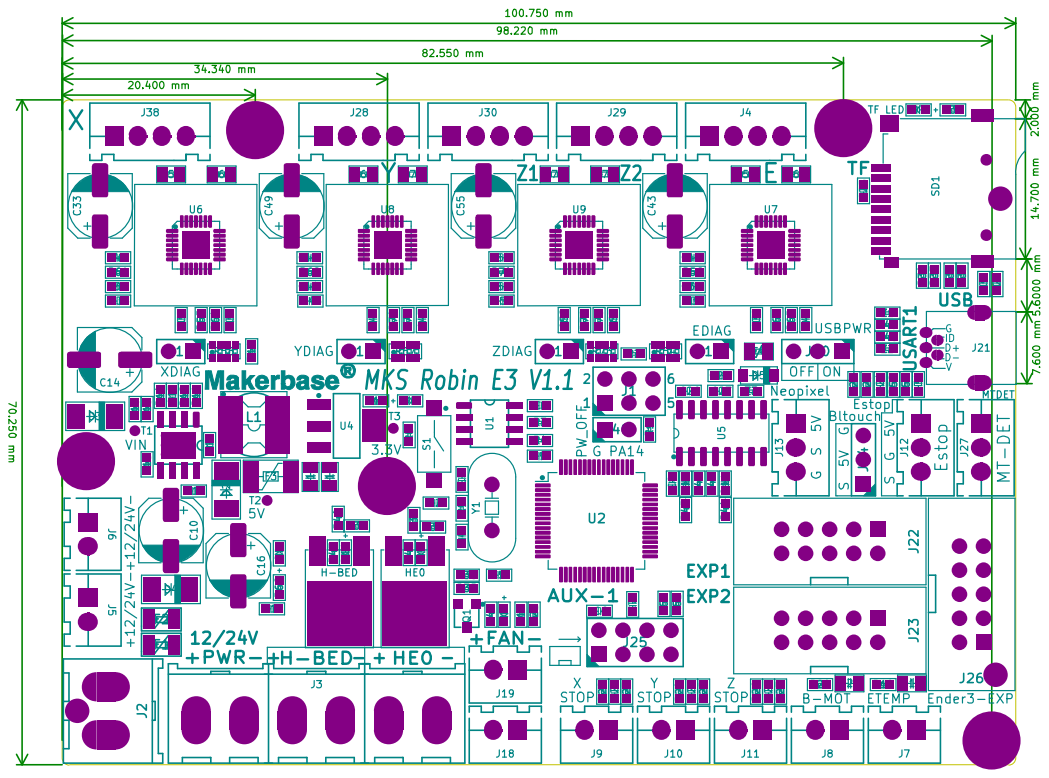
[picture p87: page 1]
