makerbase-mks/MKS-Robin-E3-E3D/hardware/MKS Robin E3 V1.1_003/MKS Robin E3 V1.1_003 TOP.pdf

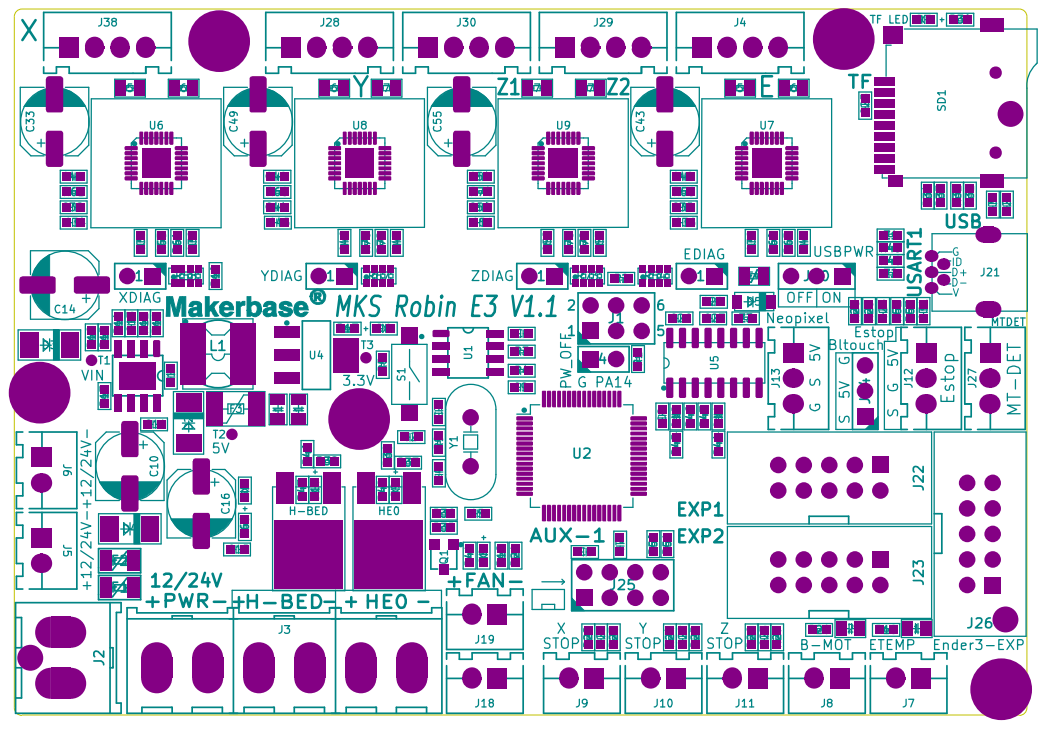
[picture p88: page 1]
