makerbase-mks/MKS-Robin-E3-E3D/hardware/MKS Robin E3 V1.1_003/MKS Robin E3 V1.1_003 SCH.pdf

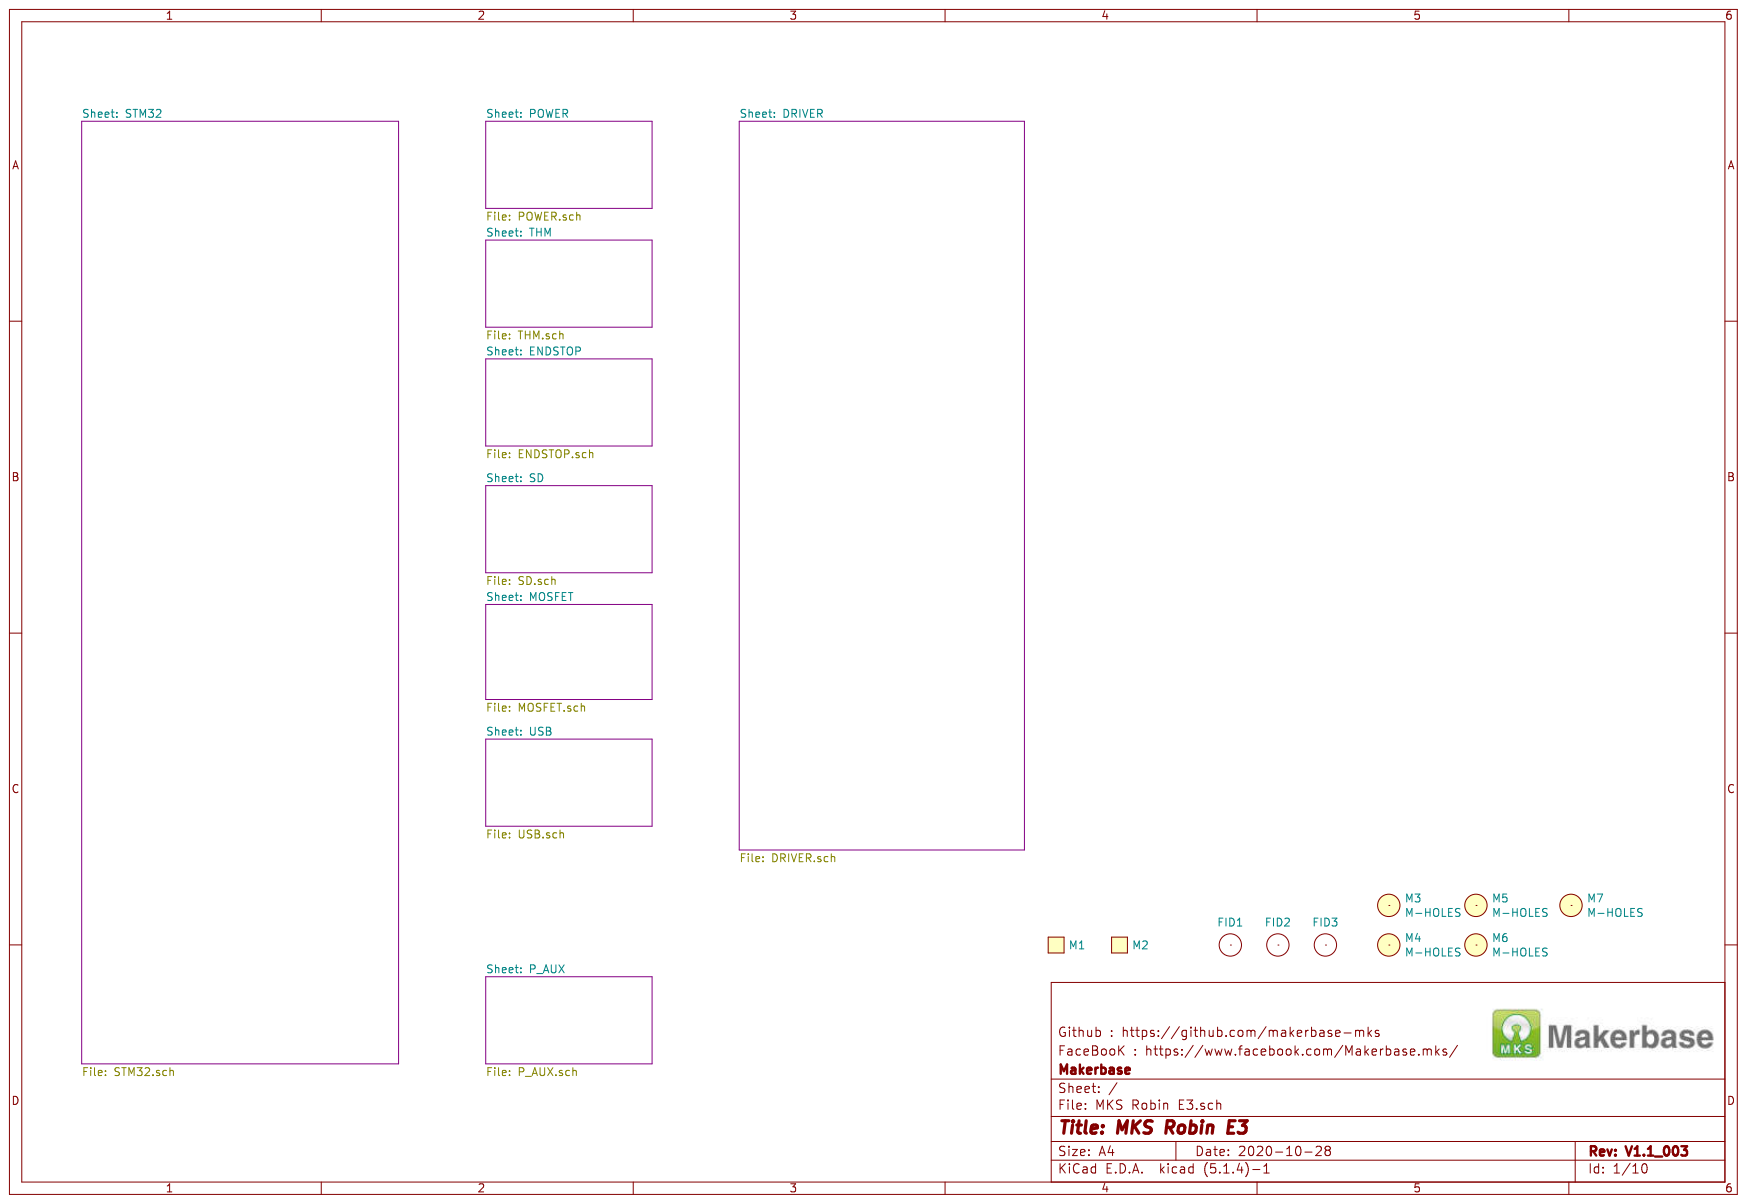
[picture p89: page 1]

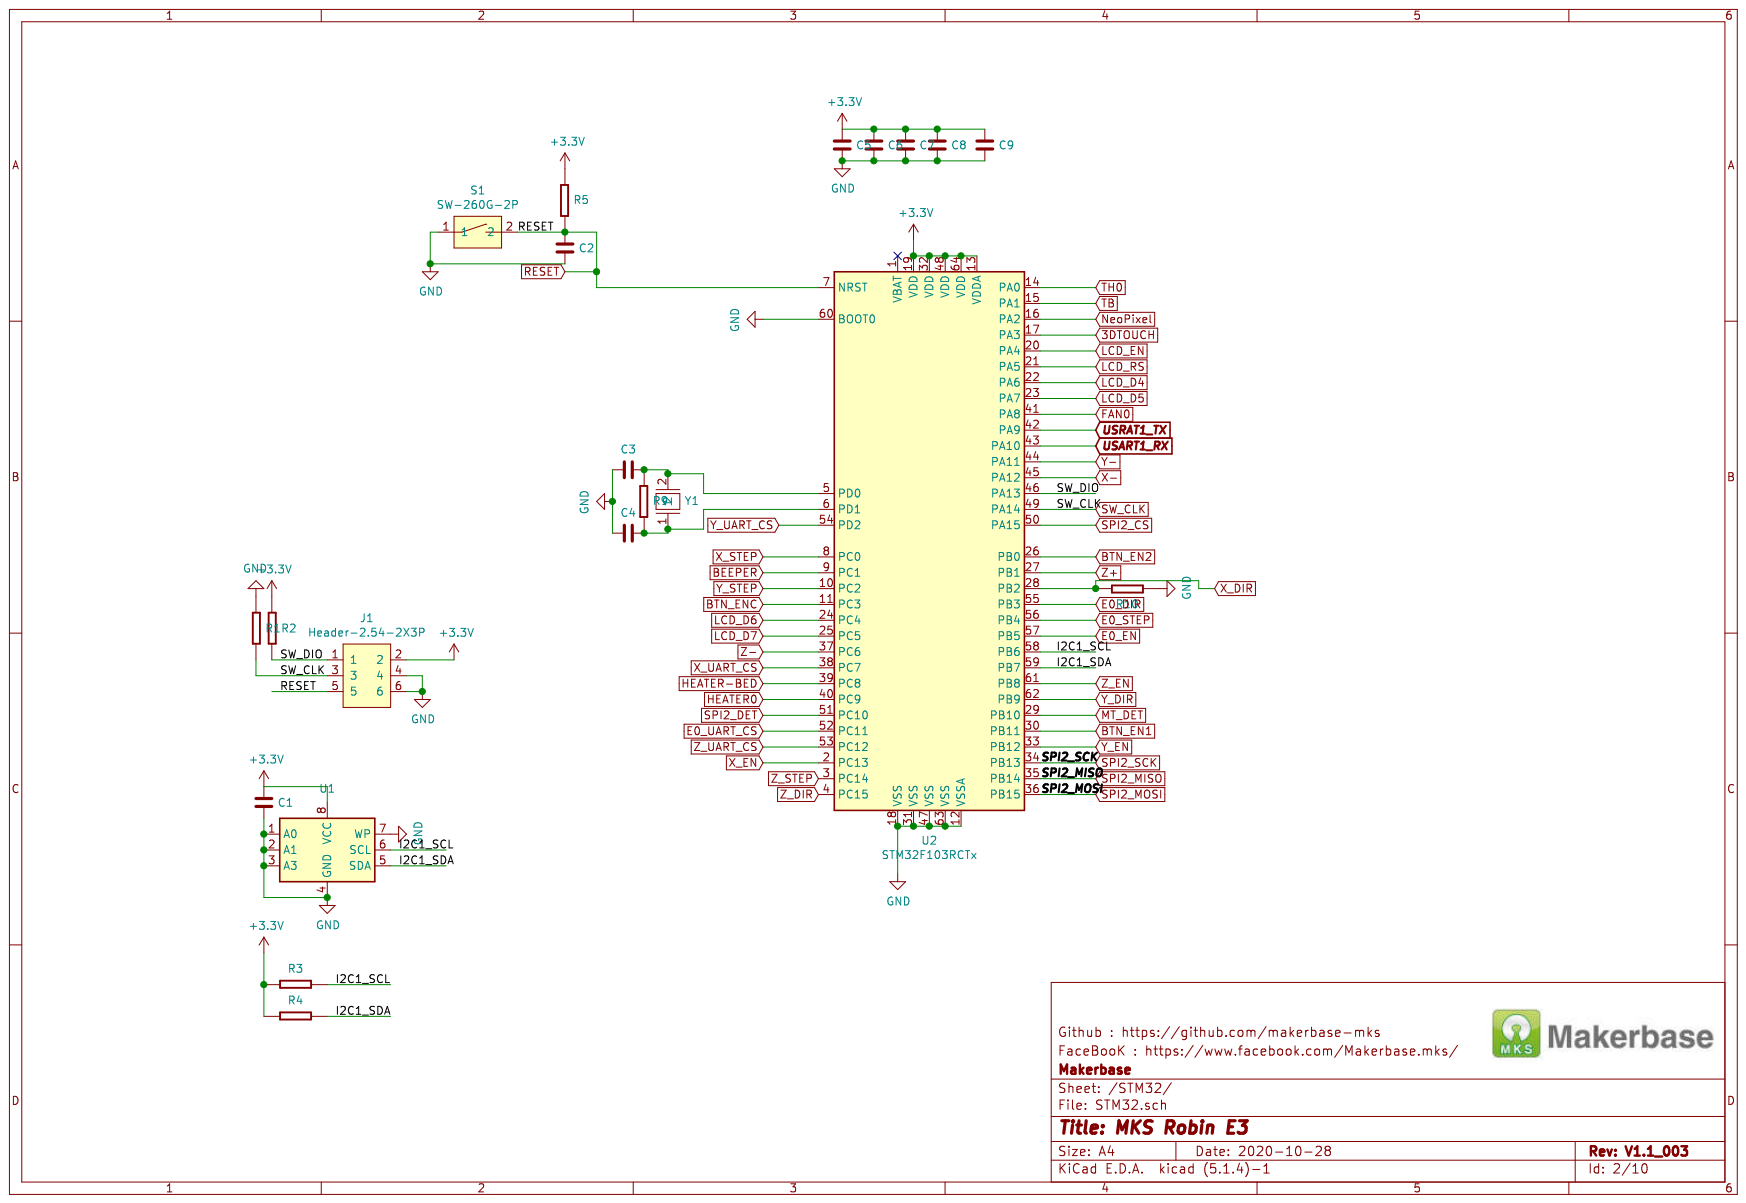
[picture p90: page 2]

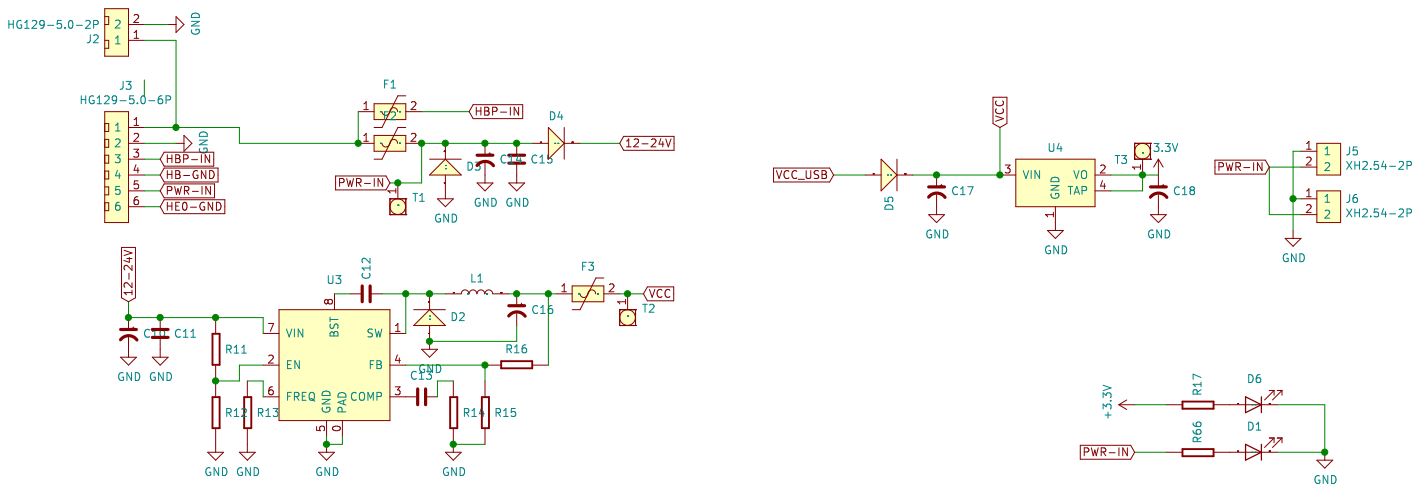
[picture p91: page 3]







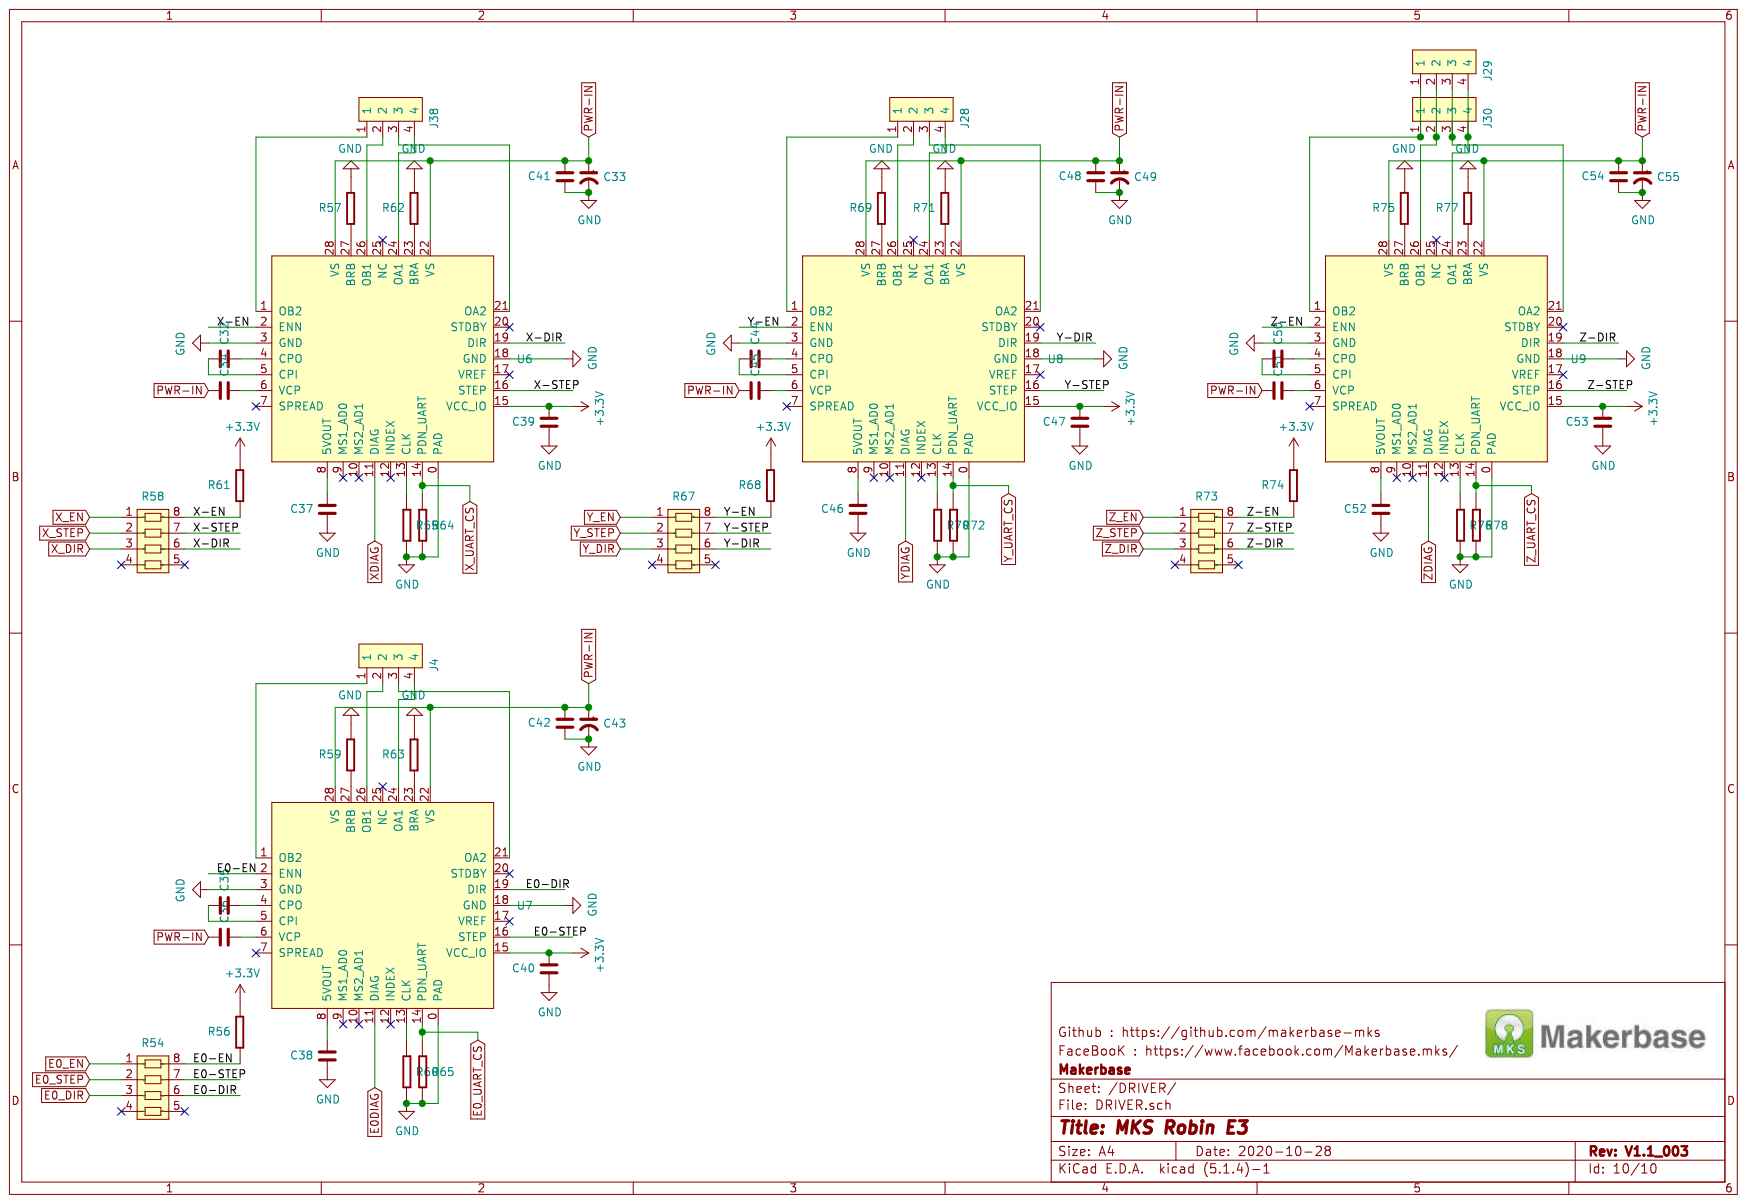
[picture p92: page 10]
