makerbase-mks/MKS-Robin-E3-E3D/hardware/MKS Robin E3 V1.0_003/MKS Robin E3 V1.0_003 BOTTOM.pdf

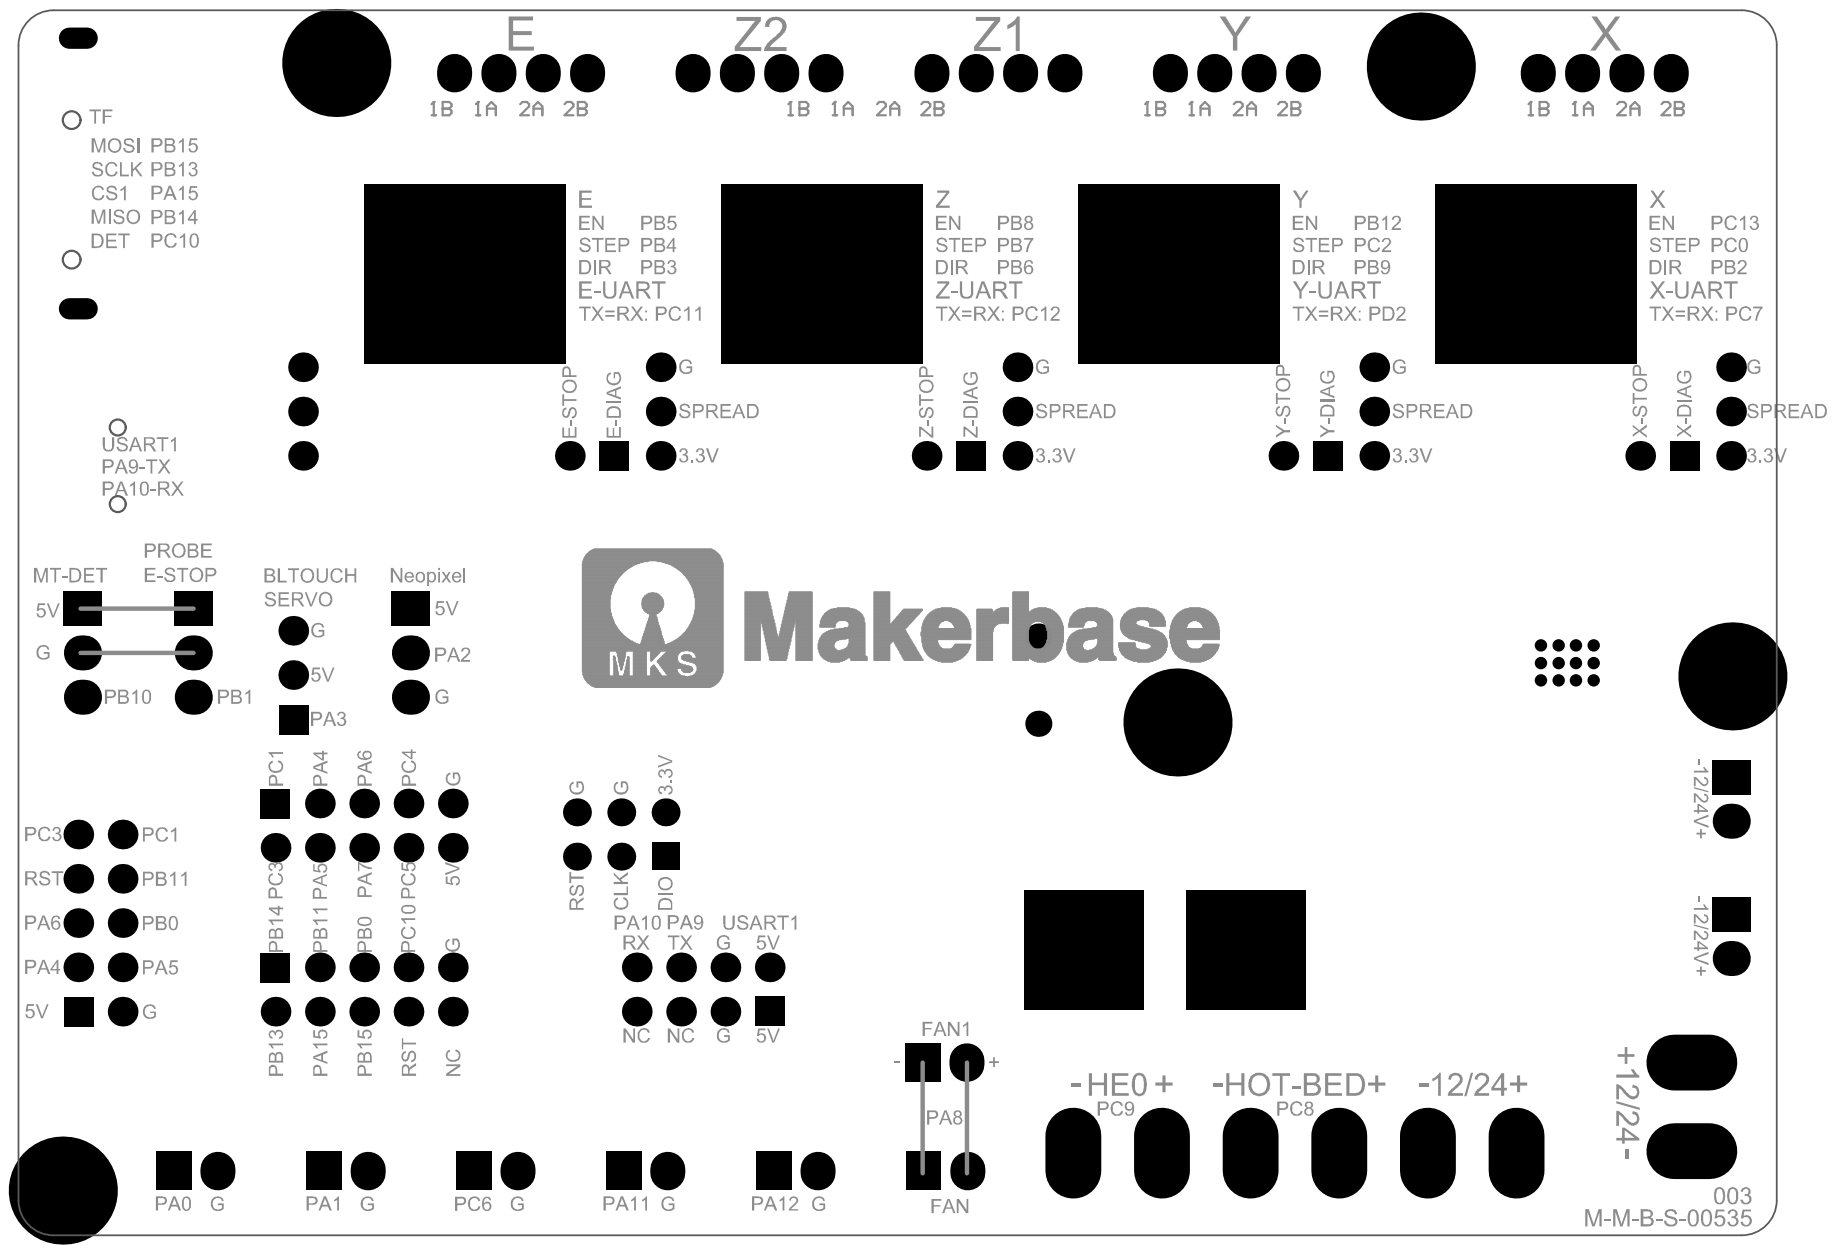
[picture p93: page 1]
