makerbase-mks/MKS-Robin-E3-E3D/hardware/MKS Robin E3 V1.0_003/MKS Robin E3 V1.0_003 TOP.pdf

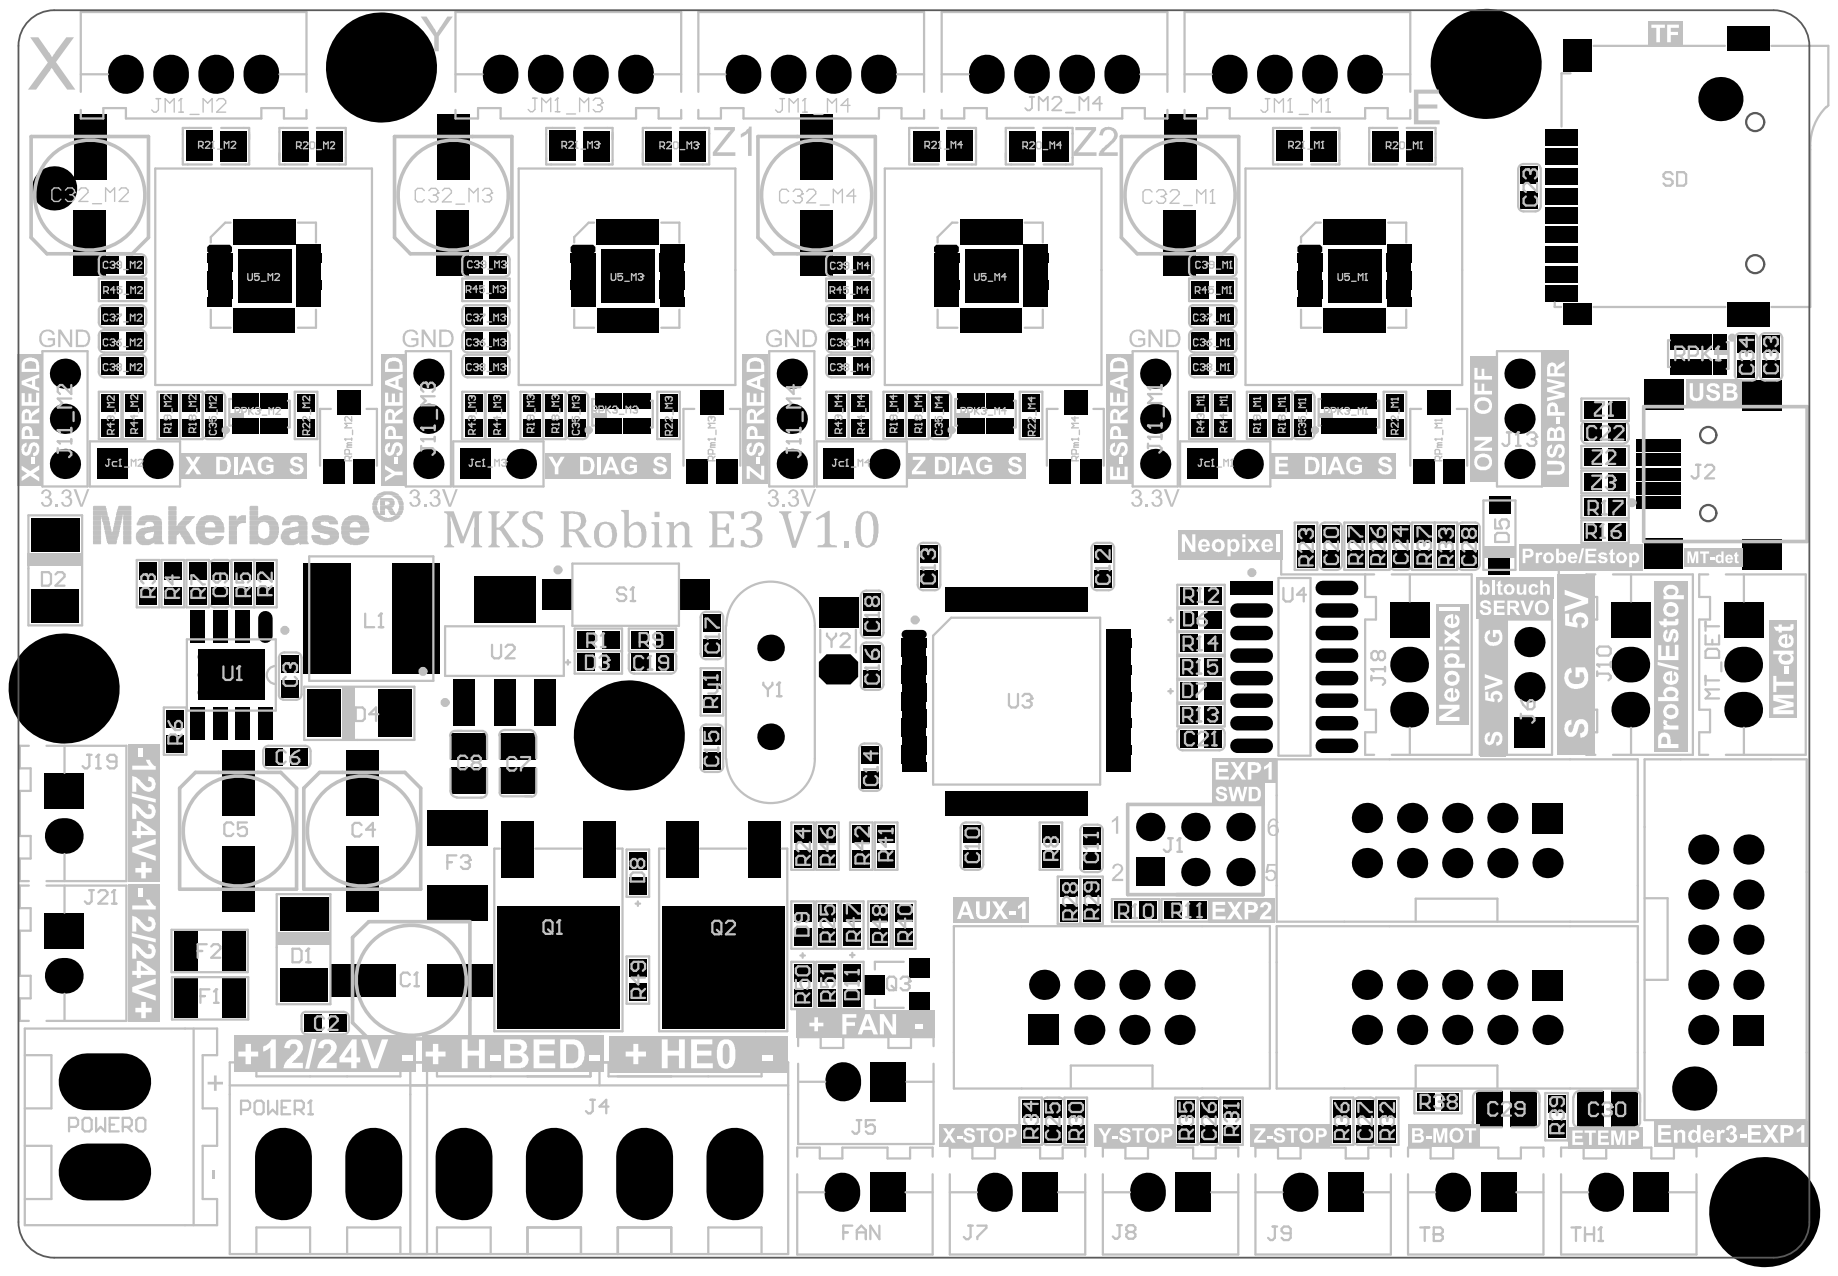
[picture p96: page 1]
