makerbase-mks/MKS-Robin-E3-E3D/hardware/MKS Robin E3 V1.0_002/MKS Robin E3 V1.0_002 TOP.pdf

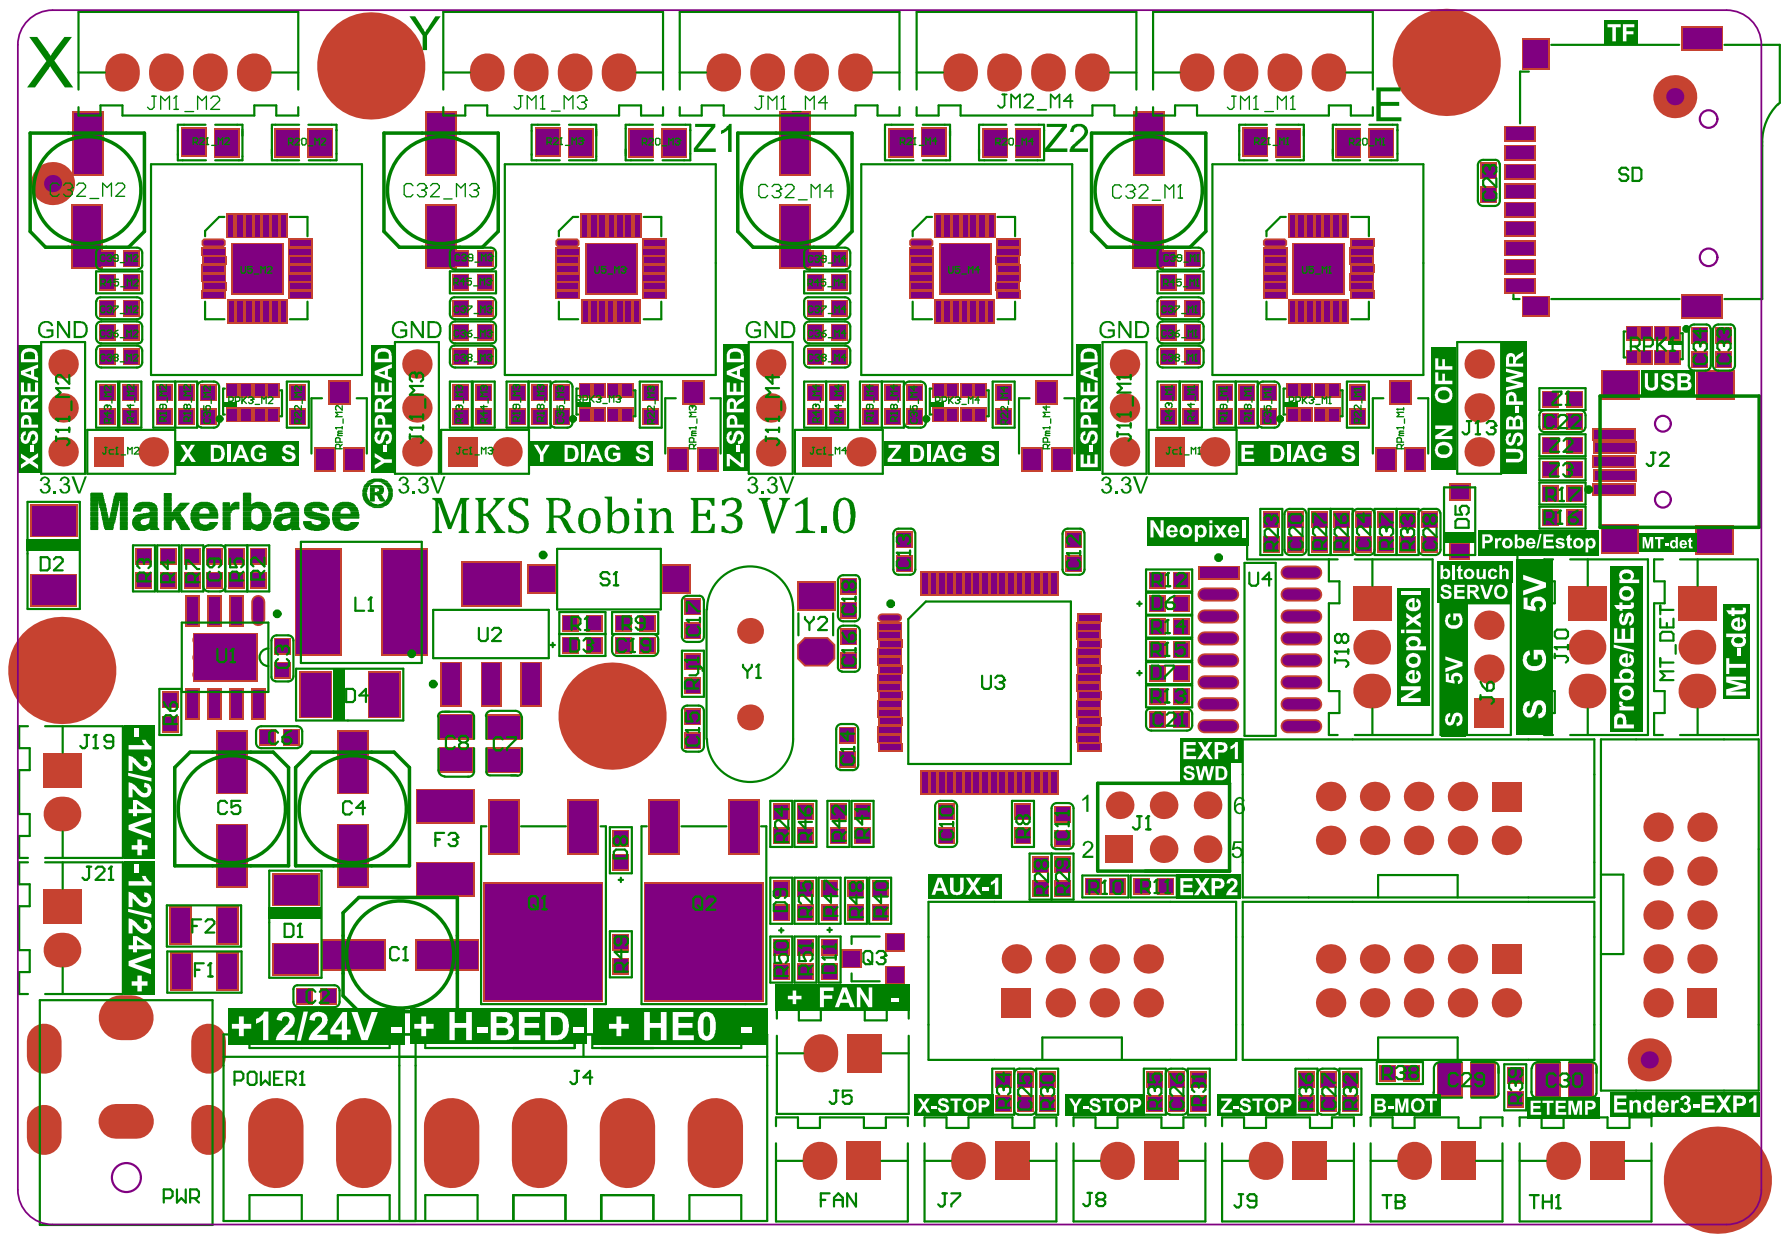
[picture p100: page 1]
