makerbase-mks/MKS-Robin-E3-E3D/(commit log)

2020-03-11 upload marlin 2.0, robin e3 and e3d can directly use
    [Configuration.h, Configuration_adv.h]
2020-04-29 fix Neopixel lights
    [Configuration.h]
2020-05-15 add support MKS PWC V2.0 and V3.0
    [Configuration.h]
2020-06-02 Prevent upgrading MAX31865 library to 1.2
    Backport https://github.com/MarlinFirmware/Marlin/pull/18089/ to MKS base firmware
2020-06-12 Default disabled MKS PWC function
    [Configuration.h]
2020-07-23 Fix flash eeprom
    [Configuration.h]
2020-08-05 fix platform = ststm32@<6.2.0
    [Configuration.h]
2020-08-06 Robin e3/e3d firmware update to marlin2.0.6 version
    [Configuration.h, Configuration_adv.h]
2020-08-14 Add Robin_e3.bin with tmc2208 for E3D board
2020-11-24 Upload E3/E3D V1.1 firmware
    [Configuration.h, Configuration_adv.h]
2021-03-06 Add firmware for ender5
    [Configuration.h, Configuration_adv.h]
2021-03-26 Update E3 V1.1 SCH and add pin map
2021-03-29 Add STM32F103RCT6.jflash file
2021-08-11 Add pwc connect to board pictures
