makerbase-mks/MKS-Robin-E3-E3D/(notices)

Notices in the files:
firmware/V1.1/Marlin-2.0.6.1_for_ender5_TMC2209/Marlin/Configuration_adv.h:
Copyright (c) 2020 MarlinFirmware [https://github.com/MarlinFirmware/Marlin]
Copyright (c) 2011 Camiel Gubbels / Erik van der Zalm
This program is free software: you can redistribute it and/or modify
it under the terms of the GNU General Public License as published by
the Free Software Foundation, either version 3 of the License, or
(at your option) any later version.
define TOUCH_UI_UTF8_COPYRIGHT // © ®
